TheRageKage12/drunk-lantern-power-battery/docs/review/transcript.md

# Design conversation transcript

The text of the design sessions for this project (2026-10-11 to 2026-10-15; Duncan's sessions of 2026-10-14, PRs #13 and #14, are not in it, only their commits and the CONTEXT.md entries): Kevin's messages and Claude's replies, in order. Tool calls, tool output, screenshots and system messages are left out. Sections headed "Context summary" were written when the conversation was compacted. **Later messages override earlier ones**: the design changed many times (base 180 -> 190 mm, power bank -> 12 V battery pack, DRV5032 -> A3144, 90 -> 135 degree nozzle). For the current decisions read [CONTEXT.md](CONTEXT.md) first and use this file to check why something was decided.

97 messages from Kevin, 325 reply blocks from Claude.

---

### Kevin

I have been working with ChatGPT to design a Green Lanter power battery that can secretly pour a shot. You can review the conversation at this link: https://chatgpt.com/share/6acc0005-f06c-83e8-a1af-509642569773

I want you to read/understand what it has recommended, the plan, the materials, etc. There are CAD files attached that are a basic 3D printable power battery. I'd like you to attempt to update those CAD files to fit/manage the full build with all the hardware included inside.

Output a guide on how to build this. Include materials with links on where to purchase them (or stores local to the Seattle area), step-by-step instructions, diagrams, and any other supplemental material that might help me.

I'm going to send you all my ChatGPT conversation history when it is available. The chat's title is “Design Alcohol Dispensing Prop”.

Does that all make sense?

### Claude

I'll start by looking at what's in the repo and trying to read the shared ChatGPT conversation.

### Claude

The checkout is empty with no remote branches yet. Let me check the remote repo on GitHub, look for any uploaded attachments, and try the ChatGPT share link in parallel.

### Claude

The share page came back nearly empty through the fetcher, since ChatGPT renders it with JavaScript. Let me try pulling the raw HTML, which often embeds the conversation data.

### Claude

The raw page is 2 MB and contains the conversation. Let me extract the message text from the embedded data.

### Claude

The conversation is encoded in React Router's "turbo-stream" format, a flat array of indexed values. I'll write a small decoder to rebuild the message tree.

### Claude

Got the CAD zip, thanks. I'll unpack it alongside finishing the conversation extraction.

### Claude

The full transcript extracted (158 messages). Now I'll read it, read the model's PDF, and install mesh tooling to measure the STLs.

### Claude

Good progress: the model is Hedo3D's "Green Lantern luminous" from Cults3D, and it already has a reed-switch reflector. Let me keep reading the transcript and measure every STL at the same time.

### Claude

Amazon returned pages without titles, which usually means a bot-check page. Let me inspect those, and build a contact sheet of the renders so I can view all parts at once.

### Claude

Noted, you swapped the pump and tubing. Let me identify those two new items plus the remaining specs.

---

### Kevin

ok, now continue in ULTRACODE

### Claude

Understood, switching to ultracode orchestration. First I'll set up the repo skeleton and a project brief for the agents, then run a research-and-critique workflow before the build workflow.

### Claude

arduino-cli installed. Now installing the RP2040 core and the NeoPixel library in the background.

### Claude

Firmware compiles cleanly for the XIAO RP2040. Let me check how far the research workflow has gotten.

### Claude

Status while the background work runs:

- **Research workflow** (7 topics, each fact-checked by a second agent): pump/tubing fit, 12 V power design, bright LED options, sensor wiring, springs and hardware, Seattle-area stores, and an adversarial critique of the whole plan.
- **CAD workflow**: five part modules (base, dishes, sphere, socket, handle) being modeled in parallel against the shared contract, each reviewed, then integrated with fit checks and renders.
- **Diagram agent**: wiring, fluid path, state machine, interaction timeline, socket mechanism.
- **Firmware agent**: host-side simulation of the interlocks plus an adversarial review. The sketch already compiles for the XIAO RP2040.

I'll pick up each result as it lands, reconcile the design parameters, and then write the build guide and push.

### Claude

Checkpoint pushed to `claude/green-lantern-battery-prop-7bn4rp`. The research, CAD, diagram, and firmware-test agents are still running in the background; I'll commit and push again as each one lands.

---

### Kevin

Correction: I have not bought anything for this yet. I just looked it up

### Claude

Good to know, that changes the framing: the parts list is open, so the guide will recommend the best part for each slot and treat your shortlist as candidates, flagging where a different part is clearly better. Let me update the brief the agents are working from and nudge the two running agents.

### Claude

Everything I need next is already in flight: the research workflow, the CAD build workflow, the diagram agent, and the firmware simulation agent. Nothing else can start until those land, so I'll wait for their completion notices and then run the final guide-writing pass with a link-checker and completeness critic.

---

### Kevin

Awesome. Also, when suggesting where to buy things, prefer Amazon links. For small things where there are huge multipacks (e.g. screws), its especially helpful if you can find local stores where I don't need to buy hundreds of them.

### Claude

Got it: Amazon links first for everything, and for bulk-only items like screws, inserts, springs, and resistors, name a local Seattle-area store where you can buy a handful. I'll record that as a rule for the guide writer.

### Claude

Recorded in the brief and pushed. The guide's bill of materials will have two columns for small parts: the Amazon listing and a verified Seattle-area store. I'm now waiting on the four background jobs (research, CAD, diagrams, firmware tests) before the guide can be written.

### Claude

The firmware agent found four real interlock bugs (dead calibration command, cap resettable by a second start, stuck-switch pour, stale Hall read at pump start) and fixed them with a 15-scenario simulation. Let me verify the compile and tests myself, then commit.

### Claude

Firmware verified and pushed (compiles for the XIAO RP2040, 15 of 15 simulated interlock scenarios pass). Let me check how the research and CAD workflows are progressing.

### Claude

While the workflows run, I'll write the top-level README so the repo is navigable regardless of when the rest lands.

### Claude

README pushed. Everything else now depends on results still in flight: the research workflow (4 of 7 topics written, fact-checks pending), the CAD workflow (dishes done, base and sphere modeling, socket and handle queued), and the diagram agent. I'll resume when those complete and then run the guide-writing workflow.

### Claude

Checkpoint pushed. The CAD base module and the other background jobs are still running; I'll commit again as each lands.

### Claude

The five diagrams are in. The wiring one still shows the PD-trigger 12 V option that the power research later rejected in favor of a 5 V to 12 V step-up cable, so it will need one revision pass once the electrical design is final. Let me look at two of them and keep the generator scripts in the repo so they can be regenerated.

### Claude

Diagrams are pushed. The only remaining inputs are the two background workflows (research fact-checks and the CAD build with its reviews, integration, and audits). Once they finish, I'll run the final workflow: build guide written against the verified research and the real CAD, a link checker that fetches every purchase link, a completeness critic against your original questions, and a diagram reconciliation pass.

### Claude

The research workflow finished: all seven topics written and independently fact-checked. Let me read the decision sections of the four I haven't seen, especially the design critique, and commit the files.

### Claude

The timing is decent: the socket modeler is just starting and the sphere modeler is mid-way, so I'll point both at revision 3 directly.

### Claude

Revision 3 is pushed and both running CAD modelers have been told to re-read it. Status:

- **Research**: done and fact-checked (seven notes under `docs/research/`). Key findings that changed the design: the Kamoer KPHM200 is 116 x 64 mm and 300 g; the 133 mm Boston round could never leave the base, so the reservoir is now a squat 8 oz wide-mouth jar refilled in place through the door; the hatch grows to 110 x 105 mm with a bottom-hinged door and a slide-out glass tray; the socket housing shrinks to 76 mm so it passes the dish hole; power is one USB-C PD port at 12 V (INIU B61) with a buck converter for the 5 V side, with the Adafruit 5 V pump as the simpler alternative.
- **In flight**: CAD modeling (base and dishes done, sphere and socket building, handle queued, then reviews, integration, audits), firmware revision 3 (prime button, faster abort, pour-time brightness cap), and the wiring diagram redraw.

One question that affects how parts get split, no rush: which 3D printer do you have access to, or what is its bed size? Everything is designed for a 220 x 220 x 220 mm bed. A Bambu A1 mini (180 mm) would need the big parts split or the whole lantern scaled to 1.6x, and the research found a free KCLS Bellevue Library makerspace with Prusa printers as a fallback.

### Claude

Firmware revision 3 verified (compiles, 16 of 16 simulated scenarios pass including the new prime button) and pushed. Still waiting on the CAD workflow and the wiring diagram redraw before the guide can be written.

### Claude

Diagrams are pushed. The remaining dependency chain is: CAD workflow finishes, then a revision 3 compliance pass over the model, then the guide workflow (writer, link checker, completeness critic). Nothing can start until the CAD workflow reports, so I'm waiting on that notification.

---

### Kevin

do you think $40 are enough credits to finish this?

### Claude

Honest answer: I can't see your billing or how credits map to tokens, so I can't promise a dollar figure. What I can tell you is the usage pattern.

**Spent so far** (subagent tokens, roughly): research 2.4M, firmware 0.4M, diagrams 0.6M, plus the CAD workflow, which is still running and is the biggest consumer. Ultracode mode is deliberately expensive: every piece of work gets an independent reviewer or fact-checker, which roughly doubles the agent count.

**Remaining as planned**: finish the CAD workflow (8 more agent runs: reviews, integration, two audits), a revision 3 compliance pass over the model, then the guide workflow (writer, link checker that fetches every purchase link, completeness critic, fixer). My estimate is 4 to 6M more tokens on the full plan. If $40 is tight, that may not fit.

**Leaner path, which I recommend**: let the CAD workflow finish since the model is the core deliverable and stopping it mid-flight wastes the work already done. Then I write the build guide myself from the fact-checked research and the CAD output, with one single agent pass to verify purchase links and store details, instead of a four-agent workflow. That cuts the remaining spend by well over half and the guide quality stays high because the research underneath it was already verified.

If you want the leanest option, I can also stop the CAD workflow now and finish the model's integration and renders myself, with no further reviewer agents.

Tell me which you prefer. Until you answer I'll keep the CAD workflow running and won't launch anything new.

### Claude

Checkpoint pushed; the CAD workflow has now produced the handle pieces and a first assembly. I'm holding further agent launches until you pick the full or lean path for the remaining work.

---

### Kevin

We need to trim the CAD workflow

### Claude

Agreed. Let me see exactly where the CAD workflow is, then stop it and finish the integration myself without the reviewer and audit agents.

### Claude

Renderer works; the cutaway camera was on the wrong side (looking at the uncut dome instead of the cut face), so I'm flipping it. Still waiting on the sphere and socket modelers.

### Claude

The build guide draft is written and pushed. The only thing still outstanding before I can finish is the sphere and socket modules from the two remaining CAD agents; my watcher will wake me when both have reported, and then I'll stop the workflow, integrate and check the full model, render it, fill in the print table, and reconcile the socket section of the guide with the real part names.

### Claude

The socket modeler died mid-write (it hit the output token ceiling). Let me see what it left on disk and where the sphere modeler stands before deciding whether to finish those two parts myself.

### Claude

Patching the remaining label text (the file uses escaped characters), then re-rendering and checking the diagram.

### Claude

Everything is pushed to `claude/green-lantern-battery-prop-7bn4rp` on TheRageKage12/temprepo. Here is where it landed.

**What you have now**

- `docs/BUILD_GUIDE.md`: the build guide. Shopping list with Amazon links plus a "local" column (Vetco Electronics in Bellevue for electronics singles, Tacoma Screw Ballard for M3 hardware, McLendon and Ace for springs and adhesives, Micro Homebrew Kenmore for tubing, Bargreen Ellingson for shot glasses), print table for all 24 parts, bench electronics, firmware upload, socket assembly and tuning, fluid path, sphere, final assembly, calibration math, test checklist, performance notes, cleaning, troubleshooting, and the answers to the questions you asked ChatGPT (LED brightness and power, power bank requirements, spring size, Seattle stores).
- `cad/output/`: ready-to-slice STLs (and STEP) for every part, all sized for your 230 x 230 x 240 Ender 3. The model is fully parametric (`cad/params.py`), with fit checks that pass at zero problems and a rotor sweep test for the socket mechanism.
- `firmware/green_lantern/`: XIAO RP2040 sketch that compiles, with a host-side simulation of 16 interlock scenarios (all pass). It found and fixed four real bugs in the ChatGPT-era logic.
- `docs/images/`: wiring, fluid path, state machine, interaction timeline and socket mechanism diagrams, plus CAD renders (iso, rear, cutaway, exploded, parts sheet).
- `docs/research/`: seven fact-checked notes behind every number.

**Design changes versus the ChatGPT plan, all driven by verified facts**

- The Kamoer KPHM200 is 116 x 64 mm and 300 g, so the base grew to 115 mm and got a two-level deck.
- A 133 mm bottle can never leave the base, so the reservoir is a squat 8 oz jar refilled in place through the door.
- The hatch is 110 x 96 mm with a hinged door and a slide-out glass tray, instead of reaching into the sphere.
- Power is one USB-C PD port at 12 V (INIU B61) with a buck converter for the 5 V side. The Adafruit 5 V pump is the simpler alternative.
- The socket return spring is a radial plunger on a rotor ramp, because a tangential spring long enough for 45 degrees does not fit in a 76 mm housing.
- Hall sensor: Adafruit DRV5032 primary (3.3 V, no divider), A3144 module as the alternative.

**Honest caveats**

- Nothing has been printed or built. The first things to measure on real parts are the pump outline and mounting, the jar cap diameter, the spring feel, and the Hall sensor response. Each maps to a parameter in `cad/params.py`.
- The sphere halves need interior tree supports around the window and hatch.
- The budget is about $350 to $445 buying everything new; the ChatGPT "$100" only covered the core electronics and pump.
- The CAD workflow's reviewer and audit agents were cut to save credits; I checked the sphere and socket myself, including a mechanism sweep, but a second pair of eyes on those two modules was skipped.

---

### Kevin

how the fuck did you get it to $350??

### Claude

I didn't cut anything to get $350. It's the same parts list as the $445 figure, assuming you buy the bulk-pack items as singles at Vetco and Tacoma Screw. That swap replaces about $120 of kits (connectors, wire, screws, springs, diodes, capacitors, fuses, headers, CA glue) with roughly $25 to $30 of loose parts. It was a rough estimate, not an itemized list, and I should have said so in the guide.

The bigger issue is why the full list is so far above your $100 target. Much of the cost is kits and consumables you'd keep, not parts that end up inside the lantern:

| Biggest line items | Cost |
|---|---|
| PETG, two green spools plus white | $56–65 |
| JST connector kits | $25 |
| CA glue plus activator | $25 |
| Kamoer pump | $28 |
| Power bank, 12 V capable | $21 |
| Pololu 12 V to 5 V converter | $19 |
| M3 screw kit | $18 |
| Adafruit 24-LED ring | $17 |
| Wire kit | $15 |

A cheaper build that keeps the same CAD and firmware comes to about **$155**, assuming you already own PETG and a USB power bank. Add about $40 if you need filament.

- **Use the 5 V Adafruit pump instead of the Kamoer.** That removes the 12 V cable and the converter, and any power bank with a 2.4 A port works. The trade-off is a slower pour: about 18 seconds for 1 oz instead of 9.
- **Buy small parts locally.** That covers resistors, capacitors, a fuse and holder, headers, wire, the level shifter, the spring and a dozen M3 screws. Expect about $20 at Vetco and Tacoma Screw.
- **Skip the extras.** Solder wires directly instead of buying connector kits, use a $5 tube of super glue, and drop the stainless nozzle tip and the pinch clamps.
- **Keep the essentials.** That means the XIAO, the Hall sensor, the microswitch, the MOSFET module, the LED strip and ring, the food-grade tubing, the jar, magnets and heat-set inserts.

The guide still only lists the full version. I can add this cheaper build to the guide as its own parts list if you want it.

---

### Kevin

no like, the old build was like $100. why the fuck is this so much more expensive

### Claude

Mostly because the $100 never covered the whole build. ChatGPT's own breakdown said $75 to $90 assuming you already owned a power bank and workshop supplies, and $95 to $115 buying everything. It left out filament, glue, the glass, and most of the wiring and hardware. Its unit prices were also single-item prices, while Amazon mostly sells these parts in multipacks.

Here's how the gap between the two plans splits up:

| Where the extra money comes from | ChatGPT plan | My list | Difference |
|---|---|---|---|
| Same core parts: pump, XIAO, Hall sensor, switch, MOSFET, LED ring, level shifter, magnets, power bank, tubing, jar | ~$98 | ~$136 | +$38 |
| 12 V support for the stronger pump you picked (PD cable plus converter) | none | $29 | +$29 |
| LED strip for the "obnoxiously bright" sphere | none | $9 | +$9 |
| PETG for a lantern this size | not counted | ~$60 | +$60 |
| Wire, connectors, fuses, diodes, capacitors, switches, perfboard | ~$10–18 | ~$85 | +$70 |
| Screws, heat-set inserts, springs | ~$5–8 | ~$40 | +$33 |
| Glue and epoxy | not counted | ~$34 | +$34 |
| Shot glass, pinch clamp, nozzle tip, funnel | not counted | ~$30 | +$30 |

The core parts cost more mainly because of pack sizes and a bigger ring. The microswitch comes as a 4-pack, the MOSFET module as a 6-pack and the level shifter as a 10-pack, and I picked the 24-LED ring over the 12-LED one.

Some of my list is padding, and that's a fair criticism. I priced the small parts as full kits and added nice-to-haves: connector kits instead of soldering direct, a $25 glue set, the stainless nozzle tip, the PRIME button, and fuses. Those make the build easier but aren't required.

The fair comparison to ChatGPT's $100 is the cheaper build from my last message. It costs about $155 if you already have filament and a power bank, and buys the small parts singly at Vetco. Switching back to the 5 V pump, which drops the PD cable and the converter, brings it close to $130. Most of what's left above $100 is items ChatGPT never priced.

---

### Kevin

what if we just had 2 of the cheaper weaker pumps instead of a big one?

### Claude

Yes, that works, and it's a good trade. Two Adafruit 3910 pumps on 5 V match the Kamoer's speed and remove all the 12 V parts.

| | One Kamoer, 12 V | Two Adafruit 3910, 5 V |
|---|---|---|
| Flow | 200 mL/min rated | 2 × 100 = 200 mL/min rated |
| 1 oz pour | about 9 s | about 9 s |
| Pumps | $28 | $50 |
| 12 V cable and 5 V converter | $29 | none |
| Power bank | must offer 12 V (INIU B61) | any bank with a 2.4 A or 3 A USB port, including one you own |
| Tubing | AUBER 1/8" × 1/4", $14 | JoyTube 1/8" × 3/16", ~$7 |
| Total for this part of the build | ~$92 | ~$57 plus Adafruit shipping |

That saves about $35, and the wiring gets simpler. One USB port feeds everything, so the PD cable, the converter, and one of the two fuses all go away.

How it fits together:

- **Driver and firmware.** Both pumps wire in parallel to the same MOSFET output, so the firmware doesn't change. The two pumps draw about 1 A together, the LEDs are capped near 0.85 A while pouring, and the total stays under 2 A on a 5 V port. The soft start already in the firmware handles the two motors starting at once.
- **Tubing.** The JoyTube tube you originally found is wrong for the Kamoer but close to right for the Adafruit pump. The pump uses 3.5 mm ID × 5 mm OD tube; JoyTube is 3.2 × 4.8 mm and is food grade. Test that it seals in the pump head before trusting it, since that fit is my inference and not confirmed.
- **Plumbing.** Run two separate tubes, each from the jar lid through its own pump to the nozzle. Mount both tube ends side by side in the nozzle clip, both aimed into the glass. That avoids a Y-joint, which is one more place to leak. The jar lid gets two tube holes plus the vent.
- **CAD.** Each pump is 28 mm wide and 67 mm long, much smaller than the Kamoer's 116 × 64 mm. Both fit easily where the Kamoer was. The pump saddles on the base deck need redrawing for two pumps on 50 mm hole spacing. The nozzle clip needs a second tube channel.

Two catches:

- "Up to 100 mL/min" is a best case. With 20 cm of lift up to the nozzle, expect a bit less, so plan on 10 to 12 seconds for 1 oz. That still fits the light show.
- Two pumps means two tubes to load, clean, and dry after each use.

With this swap, the lean build from my earlier message drops to roughly $130, assuming you already have filament and a power bank.

---

### Kevin

what else can we cut/remove to reduce cost?

### Claude

First, a correction: my last message got the math wrong. The ~$155 lean build already used one 5 V Adafruit pump, so adding a second pump raises it to about **$173**, not $130. That figure still assumes you already own filament and a power bank.

Here's what else can go, biggest savings first:

| Cut | Saves | Trade-off |
|---|---|---|
| Use one 5 V pump instead of two | ~$25 | A 1 oz pour takes ~18–20 s instead of ~10 |
| Screw M3s straight into printed holes instead of using heat-set inserts | ~$10 | Holes wear out after many reassemblies. It's a one-line change in `params.py` (pilot hole 4.0 → 2.6 mm) |
| Single logic-level MOSFET from Vetco instead of the 6-pack module | ~$8 | You solder a MOSFET, a resistor and a diode yourself |
| Cheap clone 24-LED ring from Amazon instead of Adafruit's | ~$8 | Clone quality varies, and I haven't checked a specific listing |
| Skip the master switch and the fuse | ~$6 | Unplug the USB cable to turn it off. The power bank's built-in overcurrent protection covers a 5 V system |
| Skip the PRIME button | ~$2 | Prime by doing a couple of pours into a cup. The firmware works unchanged with nothing on that pin |
| Skip the perfboard and headers | ~$5 | Solder wires directly to the XIAO pins. Messier, but it works |
| Reuse a jar you already have | ~$8 | It must be food-safe and fit within 76 mm wide by 76 mm tall |

Things not worth cutting:

- **Level shifter ($3 at Vetco).** LED strips often work on 3.3 V data without it, but that's out of spec and can flicker. It isn't worth gambling on for $3.
- **DRV5032 Hall sensor ($5).** A reed switch costs about $1, but it probably won't trigger reliably through 8 mm of plastic.
- **Food-grade tubing and magnets.** Both are already cheap, and the tubing matters for safety.
- **XIAO.** A cheaper board would mean porting the firmware to save about $4.

Bottom line, assuming you own filament, a power bank and basic glue:

| Version | Approx. cost |
|---|---|
| Two pumps, all cuts above | ~$130 |
| One pump, all cuts above | ~$105 |

The one-pump version is basically the ChatGPT $100 build, just priced honestly. It also has the same slow pour that plan had.

The most extreme option is ChatGPT's no-microcontroller idea: a timer relay module driving the pump, with plain green LEDs. It drops another $20 or so, but you lose the light show and the one-pour-per-insertion lock. I wouldn't do it.

---

### Kevin

i want the pour to be roughly a full shot in about 10-15 seconds

### Claude

A full shot is 44 mL, so 10 to 15 seconds needs about 180 to 260 mL/min. The single Kamoer pump hits that target more reliably than two Adafruit pumps, for about the same money.

Both options are rated around 200 mL/min, which works out to about 13 seconds for a full shot. The difference is how each maker states the rating:

- **Kamoer KPHM200.** Kamoer lists it as "at least 200 mL/min" with a 200 to 300 range. Expect roughly 10 to 13 seconds for a shot.
- **Two Adafruit 3910 pumps.** Adafruit lists "up to 100 mL/min" each. With 20 cm of lift to the nozzle, expect roughly 14 to 18 seconds, which often misses your target.

The Kamoer was only expensive because of how I powered it, and that part can be done cheaper:

| Pump option | Parts | Approx. cost | Full shot |
|---|---|---|---|
| Kamoer, cheaper 12 V setup | pump $28, PD 12 V cable $10, LM2596 buck module ~$8, AUBER tubing $14 | ~$60 | ~10–13 s |
| Two Adafruit pumps | 2 × $25, JoyTube tubing $7 | ~$57 | ~14–18 s |
| Three Adafruit pumps | 3 × $25, tubing $7 | ~$82 | ~9–12 s |

The cheaper Kamoer setup swaps the $19 Pololu converter for a generic LM2596 buck module. Set it to 5.0 V with a multimeter before connecting anything. The LM2596 price is an estimate; I didn't check a specific listing.

Total with all the earlier cuts comes to about **$133** with the Kamoer, if you already own filament and a suitable power bank.

**Check your power bank first.** The 12 V cable only works if the bank offers a 12 V USB-C PD profile. Many 20 W banks do; the Anker 313 does not. Look on the bank or its listing for "12V⎓1.5A" on the USB-C output. If yours doesn't have it, the INIU B61 (~$21) does, which puts the total around $155.

**The glass.** A 1.5 oz shot glass filled with a full 44 mL shot is brim-full and will slosh when you pull it out. A 2 oz glass fixes that, but those are around 75 mm tall versus the 62 mm the glass bay was designed around. It probably fits, because the nozzle comes in from the side, but I'd re-check the CAD after changing the glass height parameter.

**Firmware.** No changes needed. Calibrate the pour time for 44 mL, and the 20-second safety cap covers it.

---

### Kevin

as far as "light show", all i want is it to gradually increase in iintensity

### Claude

That simplifies the lighting a lot. A single brightness ramp doesn't need individually addressable LEDs, so you can swap them for a plain green LED strip dimmed through a MOSFET.

**What changes**

- **LEDs.** Replace the NeoPixel ring and the WS2812B strip with a plain 12 V green LED strip: single colour, not RGB, cuttable every 3 LEDs. A 5 m reel is usually around $10–15 on Amazon, though I haven't checked a specific listing. It runs from the same 12 V supply as the pump, through a second MOSFET, with the XIAO setting brightness by PWM.
- **Parts that drop out:** the 24-LED ring, the addressable strip, both 330 ohm data resistors and the 1000 µF capacitor.
- **Parts that stay:** the level shifter chip, now used as the 5 V gate driver for the two MOSFETs.
- **Converter.** The 12 V to 5 V converter now only powers the XIAO, so any small buck module works.
- **Power.** One metre of green strip draws roughly 0.4–0.6 A at 12 V. Add the pump's 0.7 A and the total is about 1.1–1.3 A, inside a 12 V / 1.5 A USB-C profile.
- **Cost.** Saves about $8 net, bringing the cheap Kamoer build to roughly **$125** if you already own filament and a power bank with a 12 V output.

**The one catch: the socket glow.** Plain strip can't be bent flat into the small ring recess around the socket. Either skip light at the socket and let the sphere carry the whole effect, or wrap a 15 cm piece around the outside of the socket housing under the halo. The wrap needs a small CAD change to the housing.

**How the firmware would behave**

| Moment | Light |
|---|---|
| Idle | Faint steady glow, about 5%, so the power bank doesn't switch itself off |
| Ring inserted | Ramps smoothly from about 5% to about 70% over the oath. It's tuned so the brightening looks steady to the eye, and the ramp time is one setting |
| Twist | Jumps to 100% and holds through the pour |
| Pour done | Holds a moment, then fades over a few seconds |
| Ring removed | Back to the faint idle glow |

The one setting worth getting right is the ramp length, so it peaks as you finish the oath. Tell me roughly how long your recitation takes, or I'll default to about 15 seconds.

None of this is in the repo yet. The guide, the CAD, the wiring diagram and the firmware still describe the addressable-LED build with the 12 V PD cable and Pololu converter. I'm holding off on rewriting them until you've finished making changes, so they only get updated once. Just say when.

---

### Kevin

the shot can be a little less than a full shot

### Claude

That opens up the cheaper option. Two Adafruit 5 V pumps now hit your time window, which means the whole build can stay on 5 V.

Pour times at a smaller shot:

| Pump option | 1 oz (30 mL) | 1.25 oz (37 mL) |
|---|---|---|
| One Kamoer, 12 V (200–260 mL/min) | ~7–9 s | ~9–11 s |
| Two Adafruit, 5 V (realistically ~150–200 mL/min) | ~9–12 s | ~11–15 s |
| One Adafruit, 5 V (~75–100 mL/min) | ~18–24 s | too slow |

A 1 to 1.25 oz pour also fixes the glass problem. A standard 1.5 oz shot glass has room left at the top, so the glass bay stays as designed.

Which pump to pick comes down to your power bank:

- **If your bank has a 12 V USB-C output** (look for "12V⎓1.5A" on the bank or its listing): **use the Kamoer.** One tube to load and clean, and more speed than you need. If it finishes too fast for the light show, the firmware can run it at about 70% speed to stretch the pour to ~12 seconds. About **$125**.
- **If it doesn't: use two Adafruit pumps on 5 V.** That means no 12 V cable, no 12 V-to-5 V converter, and no new power bank, just a 3 A USB port on the bank you have. The LEDs become a 5 V plain green strip instead of 12 V. About **$122**, versus roughly $146 for the Kamoer route plus a new $21 bank.

Two things to know about the two-pump route:

- **Tubing.** It needs two tubes, each running from the jar to its own pump and on to the nozzle clip. I haven't confirmed that the JoyTube 1/8" × 3/16" tubing seals in the Adafruit pump head; test it first.
- **Power.** On a single 5 V port, two pumps (~1 A) plus the LED strip (~1 A at full) plus the XIAO comes to about 2.1 A. That's fine on a 3 A port, but tight on a 2.4 A one. If yours is 2.4 A, the firmware can hold the LEDs a bit lower during the pour.

Both totals assume you already own filament and a power bank.

---

### Kevin

i guess the kamoer is still the way to go here? what does that do to the cost

### Claude

Yes, the Kamoer is the right call. It's faster than you need with only one tube to deal with, and the cheaper 12 V setup brings it to about the same price as two small pumps.

Here's the full list with every decision so far: the Kamoer, the plain green LED strip, and all the earlier cuts.

| Item | Where | Cost |
|---|---|---|
| Kamoer KPHM200 12 V pump | [Amazon B09HGVLHFV](https://www.amazon.com/dp/B09HGVLHFV) | $28 |
| Food-grade tubing, 1/8" × 1/4" platinum silicone | [Amazon B0DKB1NKB4](https://www.amazon.com/dp/B0DKB1NKB4) | $14 |
| Plain 12 V green LED strip | Amazon | ~$12 |
| LM2596 buck module, 12 V to 5 V for the XIAO | Amazon multipack | ~$8 |
| 6 × 2 mm magnets | [Amazon B0CBRVF4PN](https://www.amazon.com/dp/B0CBRVF4PN) | $7 |
| XIAO RP2040 | [Amazon B0DRNTQ338](https://www.amazon.com/dp/B0DRNTQ338) | $10 |
| DRV5032 Hall sensor | [Adafruit 6051](https://www.adafruit.com/product/6051) | $5 |
| USB-C PD 12 V cable | [Adafruit 5450](https://www.adafruit.com/product/5450) | $8 |
| Adafruit shipping | | ~$8 |
| Lever microswitch, level shifter chip, 2 MOSFETs | Vetco, Bellevue | ~$9 |
| Resistors, diodes, capacitor, wire, heat-shrink | Vetco | ~$8 |
| M3 screws (a dozen) and one spring | Tacoma Screw / Vetco | ~$6 |
| Super glue | anywhere | ~$5 |
| **Total** | | **~$128** |

The 12 V cable moved from Amazon to Adafruit's version because you're already ordering the Hall sensor there. That shares one shipping charge and saves a couple of dollars.

That $128 assumes you already have these. Add them if you don't:

- **A power bank with a 12 V USB-C output.** Look for "12V⎓1.5A" on the bank or its listing. If yours doesn't have it, the [INIU B61](https://www.amazon.com/dp/B09176JCKZ) does, for about $21.
- **PETG filament.** The lantern takes about 0.9 kg, so two spools, around $40.
- **A food-safe jar about 76 mm across or smaller** (~$8), and a **shot glass** (~$10).

Prices marked "~" are estimates. Amazon hid some prices from my lookups, and I didn't check specific listings for the LED strip, the buck module, or the Vetco parts. Adafruit shipping is a guess too.

The repo still describes the original ~$445 design: the guide's parts list, the wiring diagram, the firmware's LED code, and the CAD's insert holes and LED parts. Say the word and I'll update all of it to this version in one pass.

---

### Kevin

does adafruit ship quickly?

### Claude

Reasonably fast, but it ships from Brooklyn, so expect about a week to Seattle on the cheap option.

| Step | Time |
|---|---|
| Processing | Usually ships in 1–2 business days. Orders placed before 11am Eastern on weekdays with a UPS express option ship the same day |
| USPS Ground Advantage, under $200 | 2–5 business days in transit, not guaranteed |
| UPS 2nd Day or Next Day Air | Guaranteed, but costs more |

Ordering today on the cheap option, it should arrive by around October 16 to 21. That leaves a week or more before Halloween, but not much slack if a part turns out wrong. Their shipping page doesn't list prices, so the ~$8 in my total is still a guess.

You can skip Adafruit entirely and get everything from Amazon and Vetco:

- **12 V cable.** Use the [wininks USB-C PD 12 V cable (B0FD9P7PV4)](https://www.amazon.com/dp/B0FD9P7PV4) from Amazon instead, about $10.
- **Hall sensor.** Use an A3144 from Vetco, $1.99, available the same day. It needs 5 V and a diode on its output, its sensor leads bent up through the window in the socket's base plate, and two magnets stacked in the ring key instead of one, because it's less sensitive than the DRV5032.

That route comes to about **$121** and arrives at Amazon speed. The trade-off is the A3144, which is fiddlier to get reliable through the plastic than the DRV5032. If you want the easier sensor, order from Adafruit today and build everything else while it ships.

---

### Kevin

can you update everything so that it is the ~$135 version? that should be an acceptable price

### Claude

I'll update the whole repo to the ~$135 build: firmware, CAD, diagrams, and the guide. Starting with the firmware and its test harness.

### Claude

Now rewriting the firmware's lighting for a single dimmable green strip, plus a pump-speed setting.

### Claude

Firmware rewrite compiles for the board; fixing a small issue in the test mock now.

### Claude

All 17 scenarios pass, including the new light-ramp and pump-speed checks. Committing the firmware, then moving to the CAD.

### Claude

Firmware and CAD are done and pushed. Now redrawing the wiring diagram for the simpler circuit.

### Claude

Wiring diagram is clean now. Updating the other four diagrams' LED and pour references next.

### Claude

Removing the LED ring from the socket diagram, then on to the guide rewrite.

### Claude

Diagrams are pushed. Now rewriting the build guide around the ~$135 parts list.

### Claude

The Hall sensor pocket was sized for the old A3144 module and is too narrow for the DRV5032 board. Fixing that and rebuilding.

### Claude

The repo is updated to the budget build and pushed. Itemized, it comes to about **$140**, not $135: I'd underestimated the screws. The lantern needs about 37 M3 screws, not a dozen. That total assumes you already own filament, a jar, a shot glass, and a power bank with a 12 V USB-C output.

**What changed**

- **Firmware.** The addressable-LED code is gone. One green strip now brightens steadily for 15 seconds after the ring goes in, holds, jumps to full on the twist, then fades after the pour. Two new serial settings: `speed` slows the pump to stretch a pour, and `idle` sets the faint glow when idle. It compiles for the XIAO and passes all 17 simulated safety scenarios, including new ones for the light ramp and pump speed.
- **CAD.**
  - Screws now thread straight into printed holes, so no heat-set inserts.
  - The socket has no LED ring, and the base door has no switch hole.
  - The Hall sensor pocket was too narrow for the DRV5032 board; I widened it. Fit checks still pass with zero problems, and the socket sweep test still passes.
- **Wiring diagram.** Redrawn for the new circuit: the 12 V cable feeds the pump and LED strip through two MOSFETs, and a small converter supplies 5 V to the XIAO. The other four diagrams are updated to match.
- **Build guide** (`docs/BUILD_GUIDE.md`), rewritten:
  - The shopping list split into online and pick-up-locally, with exact screw counts.
  - Bench wiring steps, socket assembly, calibration aimed at 1 to 1.25 oz, and a test checklist.
  - A final section on adding back anything that was cut. Each item is either a one-line CAD setting or a cheap part.

**Before you build**

- **Order from Adafruit today.** The Hall sensor and the 12 V cable take about a week to reach Seattle. The guide lists an all-Amazon and Vetco alternative that skips the wait, but its Hall sensor is fussier to set up.
- **Check your power bank** for a "12V⎓1.5A" USB-C output. If it doesn't have one, add about $21 for an INIU B61.
- **Measure the Kamoer pump and your jar** before printing the base, since the pump's exact outline isn't published.
- **Set the light's ramp length.** It defaults to 15 seconds; if your oath runs longer, change `RAMP_MS` in the sketch to match.

---

### Kevin

It looks like the workflow is somewhat incorrect. We want the pour and the lights increasing in intensity to be happening during the oath. That is what distracts people while it pours:

1. Insert ring. Light up to opacity of 10-20%
2. Turn 45 degrees and hold - Hall sensor + turn starts lights increasing in opacity. Pour starts.
3. Pour and light intensifying continues for ~10-12 seconds. Lights end at ~90% opacity
4. Turn ring back to starting position. Lights increase to full intensity and then go off
5. I pull out my hand with the full shot glass

If I unturn my hand before the pour finishes, it stops where it is. The lights would then increase in opacity by like 10% and then go back off

### Claude

That's a real change to how the prop behaves: the pour becomes hold-to-pour, and the light builds during the pour instead of before it. I'll rework the firmware and its tests, then update the diagrams and guide. First, let me read the rest of the test harness.

### Claude

Now rewriting the firmware state machine for hold-to-pour.

### Claude

Firmware compiles. Now updating the simulation scenarios for hold-to-pour, which changes most of them.

### Claude

Before rewriting the tests, I'll raise the PWM resolution to 10-bit so the slow climb from 15% is smooth instead of visibly stepping at the dim end.

### Claude

All 17 hold-to-pour scenarios pass. Committing, then updating the state-machine and timeline diagrams.

### Claude

Firmware and state diagram are done; checking the new timeline render now, then the guide.

### Claude

The firmware now follows your sequence, and the change is pushed. The firmware compiles for the XIAO and passes all 17 simulated scenarios, rewritten for hold-to-pour.

How it behaves now:

1. **Insert the ring.** The light fades up to about 15%.
2. **Twist 45° and hold.** The pump starts and the light begins to climb.
3. **Keep holding.** The pump runs about 11 seconds while the light climbs steadily to 90%. If you're still holding when the pour finishes, the pump stops and the light stays at 90%, so a longer oath is fine.
4. **Let the ring turn back.** The light swells to 100% in under half a second, then fades to dark over about a second.
5. **Let go early instead.** The pump stops within about 40 ms. The light swells about 10% above where it was, then goes dark.

Two things I decided that you may want to change:

- **No resume after letting go early.** The prop locks until the ring is removed. A fresh insertion pours the full amount again, which could overflow a glass that's already partly full.
- **Pour volume is set by pump speed.** Since the pour time is now the length of the show, the volume comes from the speed setting (default 70%). The calibration section explains how to tune it.

The pump only runs while the ring is in and the twist is held, and only once per insertion. Pulling the ring out still stops it within 60 ms. I also switched the light to finer brightness steps (10-bit PWM) so the slow climb from 15% looks smooth instead of stepped.

The state-machine diagram, the timeline, the guide's performance and calibration sections, and the README all reflect the new flow.

**One mismatch with your step 5.** "Pull out my hand with the full shot glass" assumes your ring hand is next to the glass. In the current CAD, the socket is in the top dish and the glass sits behind the rear hatch in the sphere. So step 5 is really two moves: lift your hand out of the top dish, then open the hatch and slide out the tray. If you want the ring hand to come out holding the glass, the socket would need to move inside the sphere, next to the glass, reached through the hatch. That's a significant CAD change, so I haven't made it. Tell me if you want it.

The repo also has a `main` branch that GitHub reports as renamed. All of this work is on `claude/green-lantern-battery-prop-7bn4rp`, and `main` is at an older commit.

### Claude

Noted. Everything so far is on that branch, so [TheRageKage12/temprepo#1](https://github.com/TheRageKage12/temprepo/pull/1) already has the full build: the hold-to-pour firmware and its 17 simulated tests, the CAD, the diagrams and the guide. Any further changes I make will be pushed to the same branch and show up in the PR.

The question from my last message is still open. Should the socket move inside the sphere, next to the glass, so your ring hand comes out holding it? Right now the socket is in the top dish and the glass sits behind the rear hatch.

I can also watch the PR and respond to review comments or failing checks as they come in. Tell me if you want that.

---

### Kevin

My hand should be going in the lantern horizontally, like a punch. That means that the glass should probably be positioned somewhere below or near where my fingers would open so I can grab it

### Claude

Got it: the hand goes in horizontally through the rear opening like a punch, and the glass waits just under where the fingers open. That means a real layout change. The socket moves from the top dish into the sphere, facing your fist, and the glass drops into a well below it. I'll make that change in the CAD now. First I'll check the current sphere and socket placement code.

### Claude

Now the socket module: smaller faceplate, mounting ears and standoffs, and the in-sphere placement.

---

## [Context summary written at a compaction]

This session is being continued from a previous conversation that ran out of context. The summary below covers the earlier portion of the conversation.

Summary:
1. Primary Request and Intent:
   - Original request:
     - Read and understand the user's ChatGPT conversation ("Design Alcohol Dispensing Prop", https://chatgpt.com/share/6acc0005-f06c-83e8-a1af-509642569773) about a Green Lantern power battery prop that secretly pours a shot.
     - Update the uploaded CAD files (Hedo3D "Green Lantern luminous" STLs, CC BY-NC 4.0) to fit all the hardware.
     - Output a build guide with materials, purchase links (Amazon preferred; Seattle-area stores), step-by-step instructions, diagrams and supplemental material.
   - Purchasing preferences:
     - Prefer Amazon links.
     - For small items sold only in huge multipacks (screws etc.), find local Seattle stores that sell small quantities.
   - Nothing has been bought yet. The user's Amazon list is only a shortlist.
   - Printer: heavily modified Ender 3, ~230x230x240 mm.
   - Budget: the user accepted the "~$135 version", which itemized at ~$140. Pump is the Kamoer KPHM200 12 V. Pour is 1-1.25 oz in ~10-12 s.
   - Lighting: just a gradual increase in intensity.
   - Interaction (user's own specification, hold-to-pour):
     1. Insert ring; lights at 10-20%.
     2. Turn 45° and hold; the Hall sensor plus the turn starts the lights increasing and the pour starts.
     3. The pour and the light build continue ~10-12 s; lights end at ~90%.
     4. Turn the ring back; lights go to full, then off.
     5. Pull the hand out with the full shot glass.
     - Un-turning early stops the pour where it is; the lights go up ~10%, then off.
   - Latest request: the hand goes into the lantern horizontally like a punch, so the glass should sit below or near where the fingers open so it can be grabbed.
   - A PR exists: https://github.com/TheRageKage12/temprepo/pull/1. Push to branch `claude/green-lantern-battery-prop-7bn4rp` to update it. Do not create a new PR.

2. Key Technical Concepts:
   - CadQuery 2.8 parametric CAD:
     - params.py holds all dimensions; parts/*.py each expose build() and placements().
     - Placements are (axis, angle, translate) or a list of such steps, applied as rotate-about-origin then translate.
     - checks.py tests envelope clearance and part overlap (>1 cm³ fails; envelope >0.2 cm³ fails).
   - trimesh, manifold3d, shapely, cairosvg; software renderers render_stl.py and render_views.py.
   - Seeed XIAO RP2040 on the earlephilhower Arduino core: arduino-cli FQBN rp2040:rp2040:seeed_xiao_rp2040. The core provides analogWriteRange; the firmware uses 10-bit PWM (PWM_RANGE 1023) and EEPROM emulation.
   - Host-side C++ simulation harness with mocks (Arduino.h, EEPROM.h), run with `make test` in firmware/test.
   - Electronics:
     - USB-C PD 12 V trigger cable (Adafruit 5450) from a 12V-PDO bank (INIU B61).
     - LM2596 buck to 5 V, feeding the XIAO through a 1N5819.
     - 74AHCT125 as gate driver for 2 IRLZ44N low-side MOSFETs (pump on D3, plain 12 V green LED strip on D4), with 10k pulldowns.
     - DRV5032 Hall sensor on D1; D2F-L microswitch on D2; optional PRIME button on D6; 1N5819 flyback across the pump.
   - Hold-to-pour state machine: IDLE, ARMED, POURING, HOLDING, FINALE, LOCKED. Gamma-corrected perceived brightness.
   - Socket mechanism:
     - Flat 36 mm rotor with a stop lug channel (0/45° stops), a cam lifting the D2F-L lever 3 mm, and a ramp plus radial spring plunger (0.5x5x10 spring) for return.
     - Key cap with a 6x2 magnet on the axis.
   - Punch-in layout (rev 6, latest):
     - Socket inside the sphere facing +Y, mounted on the LED carrier's back via ears and standoffs.
     - Glass in a well hanging into the lower dish neck.
     - Nozzle guide with a quarter-bend bore.
     - Open rear hand port; top_cap closes the top dish.

3. Files and Code Sections:
   - /home/user/temprepo/cad/params.py
     - Rev 6 block appended:
       ```
       SOCKET_IN_SPHERE = True
       SOCKET_Z_LOCAL = 11.0        # ring centre height, sphere frame
       SOCKET_STANDOFF = 8.0
       SOCKET_EAR_R = 53.0
       GLASS_TOP_Z_LOCAL = -38.0    # glass rim height
       WELL_ID, WELL_WALL = 54.0, 2.0
       NOZZLE_RISE = 5.5
       NOZZLE_BEND_R = 22.0
       FIST_R, FIST_LEN, FOREARM_R = 32.0, 85.0, 30.0
       ```
     - Earlier settings still in place:
       - M3_INSERT_HOLE = 2.7 (tapped holes).
       - HALL_PCB_W = 17.8.
       - BASE_H 115; HATCH_W/H 110 x 96 (now the hand port); WINDOW 90 x 87.
       - HANDLE_INNER_GAP 6; ROTOR_OD 36; SOCKET_HOUSING_OD 76; CAM_LIFT 3.
       - Spring/plunger parameters; BOTTLE 76 x 76 jar; POWERBANK 150 x 72 x 25.
   - /home/user/temprepo/cad/assembly.py
     - place() now accepts a list of steps:
       ```python
       steps = placement if isinstance(placement, list) else [placement]
       for axis, angle, (dx, dy, dz) in steps: rotate then translate
       ```
   - /home/user/temprepo/cad/render_views.py
     - load_placed() handles step lists.
     - The cutaway colours fist/forearm envelopes tan (230,190,160) and the others orange, and skips switch_envelope.
     - New cutaway title.
     - Outputs docs/images/cad-assembly-iso/front/rear/top, cad-cutaway, cad-exploded and cad-parts-sheet PNGs.
   - /home/user/temprepo/cad/checks.py
     - Envelopes are every name ending in `_envelope` except switch_envelope.
     - fist and forearm envelopes skip parts whose names start with "switch".
     - Envelope tolerance is 200 mm³; overlap tolerance is 1000 mm³.
   - /home/user/temprepo/cad/parts/socket.py
     - `PLATE_D = P.SOCKET_HOUSING_OD if P.SOCKET_IN_SPHERE else P.SOCKET_PLATE_D`; no faceplate bolt holes when in the sphere.
     - LED_RING = False.
     - New constants: EAR_W 10, EAR_ANGLES (0, 180), STANDOFF_OD 7, CARRIER_BACK_Y -35.
     - At the end of the file: `FACE_Y = CARRIER_BACK_Y + P.SOCKET_STANDOFF + MODULE_DEPTH` (= -13.8).
     - base_solid() adds two ears at r = SOCKET_EAR_R with M3 clearance holes.
     - New `_flip_to_bed()`, which records the z-shift in `_SHIFT`.
     - build() returns: socket_housing, rotor, socket_base, switch_envelope, switch_bracket, plunger, key_cap, socket_standoff (print 2), and halo only if LED_RING.
     - `mount_step()` returns `((1,0,0), -90, (0, FACE_Y, P.Z_SPHERE_CENTER + P.SOCKET_Z_LOCAL))`.
     - placements() returns [socket-frame step, mount step] for each part, e.g. `[(X,180,(0,0,_SHIFT[n])), m]`.
     - This fixed the old rotor print-translation bug.
     - tests/test_socket.py still reports "SOCKET MECHANISM OK".
   - /home/user/temprepo/cad/parts/sphere.py
     - Rear half: the hatch door, hinge holes, magnet pockets and nozzle boss were removed. The port is now an open hand port. build_halves returns (front, rear, None, None).
     - New constants:
       - WELL_OD 58.
       - GLASS_BASE_Z = GLASS_TOP_Z_LOCAL - GLASS_H (-100).
       - WELL_FLANGE_OD 68, WELL_FLANGE_T 2.
       - TUBE_R_POS 34.5; GROMMET_XY (-34.5, -4); WIRE_SLOT_XY (34.5, -4); WIRE_HOLE_D 7.
     - bay_floor(): well hole, carrier slots, tube hole, 7 mm cable hole, nozzle-guide screw pilot. Platform, rails and tray were removed.
     - glass_well(): flange cup, depth = (BAY_FLOOR_Z + FLOOR + WELL_FLANGE_T) - GLASS_BASE_Z, with a glass centring ring.
     - nozzle_guide(): rect profile swept along `cq.Workplane('XZ').moveTo(0,0).lineTo(0,h).radiusArc((r,h+r), r)`, minus a bore of TUBE_OD + 0.6, on a foot with an M3 hole.
     - led_carrier(): two M3 holes at (±53, z = SOCKET_Z_LOCAL - (BAY_FLOOR_Z + FLOOR)).
     - build() returns: sphere_front, sphere_rear, diffuser, bay_floor, glass_well, led_carrier, nozzle_guide, glass_envelope, fist_envelope, forearm_envelope.
       - The fist envelope is `cq.Workplane('XZ').circle(P.FIST_R).extrude(-P.FIST_LEN)`.
     - placements():
       - glass_well: `((1,0,0),180,(0,0,Z+BAY_FLOOR_Z+FLOOR+WELL_FLANGE_T))`.
       - nozzle_guide at the grommet exit.
       - fist at (0, face_y = CARRIER_Y + STANDOFF + 13.2, Z + SOCKET_Z_LOCAL + 6).
       - forearm at face_y + FIST_LEN - 10.
     - Removed parts: glass_tray, sphere_hatch, nozzle_clip; their output files were deleted.
   - /home/user/temprepo/cad/parts/dishes.py
     - Added build_top_cap(): a disc of (SOCKET_COUNTERBORE_D - 2*FIT) x 3 with 4 countersunk M3 holes on SOCKET_BOLT_ANGLES.
     - Placed at Z_SOCKET_PLATE_SEAT; included when SOCKET_IN_SPHERE.
   - Latest build: all parts fit the bed; checks report 0 problems. Clearances:
     - Fist z -15..49, y -13.8..71.2.
     - Nozzle guide x -42..-12.5, z -50.5..-17.5.
     - Glass z -100..-38.
     - Glass well z -102..-48.5.
   - /home/user/temprepo/firmware/green_lantern/green_lantern.ino (committed)
     - States: `enum class State : uint8_t { IDLE, ARMED, POURING, HOLDING, FINALE, LOCKED };` declared before the first function, because of the Arduino prototype generator.
     - Light constants: ARMED_LEVEL 0.15, ARMED_FADE_IN_MS 600, POUR_PEAK 0.90, EARLY_BUMP 0.10, FINALE_UP_MS 400, FINALE_HOLD_MS 300, FINALE_FADE_MS 1200, FADE_MS 1000, GAMMA 2.2, PWM_RANGE 1023.
     - Other defaults: DEFAULT_POUR_MS 11000, DEFAULT_PUMP_SPEED 70, DEFAULT_IDLE_DUTY 0, MAX_PUMP_MS 20000, POUR_ABORT_MS 60.
     - Settings struct: magic "GL02", pourMs, maxBright, idleDuty, pumpSpeed; created by defaultSettings().
     - Serial commands: status, cal, pour, speed, leds, idle, save, stop.
     - POURING:
       - Ring loss → pumpStop and LOCKED.
       - !swStable → pumpStop and startFinale(ledShown + EARLY_BUMP).
       - Pour done → HOLDING.
     - HOLDING: release → startFinale(1.0).
     - FINALE: ends in LOCKED.
   - /home/user/temprepo/firmware/test/
     - Arduino.h mock: `sim::pwmRange` plus analogWriteRange/analogWriteFreq; includes math.h.
     - test_green_lantern.cpp: scenarios a-q rewritten for hold-to-pour; 17/17 pass.
     - Adafruit_NeoPixel.h mock removed.
   - Diagrams in docs/images/src/ (gen_*.py + svgkit.py):
     - wiring.svg: rewritten for the budget circuit. Its socket group is still labelled "top dish".
     - state-machine.svg: 6 states.
     - interaction.svg: hold-to-pour timeline.
     - fluid-path.svg: labels updated earlier, but the geometry is the old layout.
     - socket-mechanism.svg: LED ring removed, but it still shows the top-dish mounting.
   - docs/BUILD_GUIDE.md
     - Budget build ~$140 with the full BOM (Amazon, Adafruit, Vetco, Tacoma Screw), Seattle stores table, print table, electronics steps, firmware, socket, fluid, sphere, assembly, calibration by speed, tests, performing (hold-to-pour), cleaning, troubleshooting, and upgrades.
     - Still describes the top-dish socket, tray, hatch door and nozzle_clip.
   - Other files: README.md, cad/README.md, cad/DESIGN_CONTRACT.md (revisions 2-5), docs/research/*.md (seven fact-checked notes plus BRIEF.md).

4. Errors and fixes:
   - The ChatGPT share page was JS-rendered. I decoded the turbo-stream with a custom decoder, fixing recursion and circular-reference problems along the way.
   - arduino-cli install script failed; downloading from downloads.arduino.cc worked.
   - The CAD workflow's sphere and socket agents hit the 64k output-token limit. The user asked to trim the workflow, so I stopped it and wrote sphere.py and socket.py myself.
   - The hold-pour rewrite first anchored on the wrong `switch (state)` (the one in lightTarget). I restored with git checkout and used the anchor `'  switch (state) {\n    case State::IDLE:\n'`.
   - The mock analogWrite clamped values to 255. I added a sim::pwmRange model.
   - The Hall pocket was too narrow for the DRV5032; HALL_PCB_W became 17.8.
   - The nozzle guide intersected the glass. I lowered GLASS_TOP_Z_LOCAL to -38 and added NOZZLE_RISE 5.5 with a 22 mm bend.
   - The glass well depth was off by the flange thickness; fixed.
   - User feedback on cost:
     - "how the fuck did you get it to $350??" and "why ... so much more expensive" than $100. I explained the gap honestly and corrected my own math mistakes ($130 → $173; screw count raised the $135 estimate to ~$140).
     - The user had earlier been angry at ChatGPT for removing Amazon links and writing essays, so keep Amazon links and stay concise.

5. Problem Solving:
   - Solved:
     - Layout for the 12 V pump, jar, power bank and electronics.
     - Socket mechanism verified by the sweep test.
     - Budget redesign.
     - Hold-to-pour firmware, verified by simulation.
     - Punch-in geometry: the socket fits below the upper-dish plug (socket top z = 49 < 49.5); the fist clears the guide by 2.5 mm; the tube tip is horizontal at z ≈ -23, aimed inside a glass rim 15 mm below.
   - Open:
     - The socket twist direction suits a right hand (clockwise as seen from the hand = right-hand supination). The user hasn't said which hand wears the ring.
     - Fist dimensions are estimates; a mock-up print is advised.

6. All user messages:
   - "I have been working with ChatGPT to design a Green Lanter power battery that can secretly pour a shot. You can review the conversation at this link: https://chatgpt.com/share/6acc0005-f06c-83e8-a1af-509642569773 I want you to read/understand what it has recommended, the plan, the materials, etc. There are CAD files attached that are a basic 3D printable power battery. I'd like you to attempt to update those CAD files to fit/manage the full build with all the hardware included inside. Output a guide on how to build this. Include materials with links on where to purchase them (or stores local to the Seattle area), step-by-step instructions, diagrams, and any other supplemental material that might help me. I'm going to send you all my ChatGPT conversation history when it is available. The chat's title is "Design Alcohol Dispensing Prop". Does that all make sense?"
   - "@.../1ce7a4af-green-lantern-luminous-model_files.zip Here are the CAD files as well"
   - "I think I changed the tubing and pump to these so that it has more power: https://www.amazon.com/gp/product/B08RYFGNMK/... https://www.amazon.com/gp/product/B09HGVLHFV/..."
   - "ok, now continue in ULTRACODE"
   - "Correction: I have not bought anything for this yet. I just looked it up"
   - "Awesome. Also, when suggesting where to buy things, prefer Amazon links. For small things where there are huge multipacks (e.g. screws), its especially helpful if you can find local stores where I don't need to buy hundreds of them."
   - "regarding the printer: I have a heavily modified ender 3 that can do 230x230x240ish"
   - "do you think $40 are enough credits to finish this?"
   - "We need to trim the CAD workflow"
   - "how the fuck did you get it to $350??"
   - "no like, the old build was like $100. why the fuck is this so much more expensive"
   - "what if we just had 2 of the cheaper weaker pumps instead of a big one?"
   - "what else can we cut/remove to reduce cost?"
   - "i want the pour to be roughly a full shot in about 10-15 seconds"
   - "as far as "light show", all i want is it to gradually increase in iintensity"
   - "the shot can be a little less than a full shot"
   - "i guess the kamoer is still the way to go here? what does that do to the cost"
   - "does adafruit ship quickly?"
   - "can you update everything so that it is the ~$135 version? that should be an acceptable price"
   - "It looks like the workflow is somewhat incorrect. We want the pour and the lights increasing in intensity to be happening during the oath. That is what distracts people while it pours: 1. Insert ring. Light up to opacity of 10-20% 2. Turn 45 degrees and hold - Hall sensor + turn starts lights increasing in opacity. Pour starts. 3. Pour and light intensifying continues for ~10-12 seconds. Lights end at ~90% opacity 4. Turn ring back to starting position. Lights increase to full intensity and then go off 5. I pull out my hand with the full shot glass. If I unturn my hand before the pour finishes, it stops where it is. The lights would then increase in opacity by like 10% and then go back off"
   - (System/UI) "A pull request was just created for this branch from the Claude Code UI: https://github.com/TheRageKage12/temprepo/pull/1 You don't need to create one. Reference this PR going forward — pushing more commits to this branch will update it."
   - "My hand should be going in the lantern horizontally, like a punch. That means that the glass should probably be positioned somewhere below or near where my fingers would open so I can grab it"
   - Constraints:
     - Do not create PRs unless asked.
     - Commit attribution: "Co-Authored-By: Claude Opus 5.5 <noreply@anthropic.com>" and "Claude-Session: https://claude.ai/code/session_01RA7Cpt4fWuKXDa6DwBe3et".
     - No model identifiers in repo artifacts.

7. Pending Tasks (punch-in layout follow-through):
   - Commit and push the in-progress CAD changes to `claude/green-lantern-battery-prop-7bn4rp` (updates PR #1).
   - Review the cutaway render (scratchpad cut3.png) for the punch-in layout.
   - Regenerate the guide print table: remove glass_tray, sphere_hatch and nozzle_clip; add glass_well, nozzle_guide, socket_standoff (x2) and top_cap.
   - Update BUILD_GUIDE.md:
     - Section 1 "How it works" table: socket inside the sphere, hand port, glass well.
     - Section 6 socket mounting: ears and standoffs onto the carrier back with 2 x M3x20 plus nuts on the LED side outside the channels; no faceplate screws.
     - Sections 7 and 8: fluid path and nozzle guide (tube through the bay floor at r 34.5, quarter bend, tip ~5 mm beyond the guide; glass well; no tray or hatch door).
     - Section 9 assembly (top_cap with 4 screws).
     - Section 12 performing (punch in, open the fingers onto the glass, pull out).
     - The cut-hatch-door note, magnet count (no hatch magnets) and screw counts.
   - Update diagrams:
     - fluid-path.svg: new geometry.
     - socket-mechanism.svg: vertical in-sphere mounting.
     - wiring.svg: socket group label "(inside the sphere)".
   - Update cad/README.md, DESIGN_CONTRACT revision 6 and the README part list.
   - In the reply to the user:
     - Ask which hand wears the ring (the twist direction is designed for right-hand supination; a left hand would need the socket mirrored).
     - Note the fist dimensions are estimates; suggest printing the socket and well first as a mock-up.

8. Current Work:
   Implementing the user's punch-in request: "My hand should be going in the lantern horizontally, like a punch. That means that the glass should probably be positioned somewhere below or near where my fingers would open so I can grab it".
   - CAD changes made (uncommitted): params rev 6 block; socket.py in-sphere mounting; sphere.py with the open hand port, glass_well, nozzle_guide, carrier holes and fist/forearm envelopes; dishes.py top_cap; assembly, checks and render_views updated for step-list placements and generic envelopes.
   - The full `python3 build.py` reports "--- checks done: 0 problem(s) ---".
   - tests/test_socket.py reports "SOCKET MECHANISM OK".
   - The last command updated the render_views.py cutaway colouring (hand in tan) and re-rendered all views ("rendered 24 parts"). It saved a 700 px cutaway preview to /tmp/claude-0/-home-user-temprepo/45c7fed5-b38c-5bcd-8935-8412da500de5/scratchpad/cut3.png, which still needs reviewing.

9. Optional Next Step:
   - Look at the cut3.png cutaway to confirm the punch-in layout reads correctly.
   - Commit and push the CAD changes with the required attribution.
   - Update the build guide sections, print table, fluid-path, socket-mechanism and wiring diagram labels, READMEs and the contract for the punch-in layout, then push to update PR #1.
   - Report to the user, asking which hand wears the ring (twist direction) and noting the estimated fist dimensions.

If you need specific details from before compaction (like exact code snippets, error messages, or content you generated), read the full transcript at: /root/.claude/projects/-home-user-temprepo/45c7fed5-b38c-5bcd-8935-8412da500de5.jsonl
Continue the conversation from where it left off without asking the user any further questions. Resume directly — do not acknowledge the summary, do not recap what was happening, do not preface with "I'll continue" or similar. Pick up the last task as if the break never happened.

### Claude

Next, the guide. I'll find every section that still describes the old layout.

### Claude

The guide also needs new part sizes. I'll pull them from the STLs, and check how the earlier gram estimates were made.

### Claude

The ratio is a steady ~0.76 g/cm³, so I'll use it for the new parts. The total:

### Claude

A fist offset 15 mm sideways (the ring finger isn't centred on the fist) grazes the port edge by 0.3 cm³. I'll widen the hand port from 110 to 120 mm and rebuild.

### Claude

Every fist case clears now. I'll make the realistic 100 x 58 mm elliptical fist the official envelope, so every future build checks it.

### Claude

Checks pass with the bigger fist. Re-rendering the views:

### Claude

The rear view shows the socket face through the open port, as intended. Its caption still says "door + hatch", so I'll fix that and check the other captions.

### Claude

Now the CAD README and the design contract (revision 6):

### Claude

The key-tab orientation and twist direction matter for the guide, so I'll check them against the socket's frame conventions.

### Claude

The lower dish's 80 mm floor hole is the limit, and the cone below it is wider. I'll read the lower dish's floor geometry to see how far the hole can grow.

### Claude

Writing the slide-well change: params first, then `sphere.py` and the lower dish hole.

### Claude

Checks pass. Next I'll confirm the new glass-path check would have caught the original bug: with the slide set to 0 (the old straight-up removal), it should fail.

### Claude

A slot of zero length is degenerate in CadQuery, so I'll use 0.5 mm, which is effectively the old straight lift.

### Claude

Without the slide, the lift path would cut through the nozzle guide and 8.7 cm³ of the socket housing. The new envelope catches that, and the real layout passes. Re-rendering:

### Claude

I'll leave the path envelope out of the cutaway, since it's a check volume, not hardware:

### Claude

The cutaway reads right: the glass is at the front of the slot under the knuckles, and the empty rear of the slot is the pull-back room. I'll run the socket test and commit.

### Claude

I'll push now so the PR has the CAD while I update the guide.

### Claude

Pushed. Now the docs: contract revision 7, then the build guide. First, fresh sizes for the parts that changed:

### Claude

Contract revision 7 is written. I'll edit the build guide section by section, starting with the intro, "How it works" and the shopping list:

### Claude

Now section 3 (print list):

### Claude

The nozzle guide's bend would overhang printed foot-down. On its side the bend lies flat and needs no support, so I'll say that:

### Claude

Checks pass. Now sections 7-9, with hole positions described from where the builder stands (behind the lantern, at the port):

### Claude

The guide text is done. Now the diagrams. The timeline callouts still mention the tray and hatch, so I'll fix those and find the stale labels in the other generators:

### Claude

`gen_fluid.py` needs new geometry, and `gen_socket.py` needs new mounting labels. Reading both:

### Claude

Dumping assembly-frame bounds of the key items, so the labels land on the right things:

### Claude

The sphere front half is back to 117 mm tall. The audit found five more small overlaps the 1 cm³ check hid. Locating each one:

### Claude

Only `sphere.py` has the untracked shift. Base and handle record theirs. Fixing all three issues:

### Claude

Empty hits mean the ray passed cleanly through the hole. To be sure the hole isn't just missing material, I'll compare against a ray offset 3 mm sideways, which should hit solid plate:

### Claude

I'll record these fixes in the contract, re-render, run the tests and commit before the diagrams:

### Claude

The audit is clean, so I'll lower the build check's overlap tolerance from 1 cm³ to 0.1 cm³, which would have caught every bug above. One run tells me whether mating faces stay under it:

### Claude

Updating the README's check description, then writing the CAD-driven fluid-path generator:

### Claude

Most of the diagram reads well, but the sphere shell is missing. Its cut at x = 0 probably doesn't close into polygons, because each half's section ends on the split plane. Checking:

---

### Kevin

I think I want it to look something like this. The shot glass can be inserted toward the bottom of the opening and slid back behind some walling that hides the nozzle and possibly other electronics. LEDs would line the top and both sides around the openings. The liquid would be at the bottom/base, and all the electronics and such can either be tucked between the walls hiding the nozzle or just above the liquid

### Claude

Before switching to your sketch, I'll commit the fixes I'd already finished. Those bugs exist whatever layout we choose.

---

### Kevin

My left hand will have the ring, but the rotation should still operate like a normal key, so I don't think that's a huge issue.

Also, my fist is less than 4" in width and 3 inches in height, so we just need some clearance for that plus the glass for the window.

We probably don't really need to worry too much about how offset my fist is in it, unless you're very worried about it.

### Claude

Rewriting the rev 6/7 parameter blocks as one rev 8 block:

### Claude

Now `socket.py`: face position from params, diagonal ears, and standoffs only when the gap is non-zero.

### Claude

Now the big one: `sphere.py` gets the lock wall in place of the LED carrier. Reading its current constants and the functions I'm changing:

### Claude

All checks pass with the new parts. Next I'll confirm the lock's two ear screws line up with the wall's holes. I'll also run the socket mechanism test, since its ears moved.

### Claude

Status: the rev 8 CAD (lock wall, curtain clamp, frosted top) is built, passes its checks, and is committed. I'm now updating the diagrams, then the build guide.

### Claude

Two fixes for legibility: the curtain is hidden under the hand, so I'll draw it last, and the LED strips need to be drawn thicker to show at this scale.

### Claude

The diagram now shows the lock wall, LED strips, curtain and nozzle correctly. Next the socket-mechanism diagram: it still shows the old square faceplate with dish-floor screws and an M3 stop pin.

### Claude

The face views now show the two ears screwed to the wall. The section still draws the old wide faceplate flanges at the top, so I'll remove them:

### Claude

Diagrams are done. For the curtain in the shopping list I need a buy link, so I'll search for frosted, flexible plastic sheet on Amazon and locally:

### Claude

Gathering sizes and weights for the new and changed parts for the print table:

### Claude

I've redesigned the lantern around your sketch, and the pull request is updated: https://github.com/TheRageKage12/temprepo/pull/1. The model passes all its fit checks and the lock mechanism test, and the build guide and diagrams are updated. Nothing is printed yet; the glass grip and the curtain especially need trying on real parts.

**The new layout:**
- **Lock wall:** a printed plate just inside your opening with the lock screwed to its face. You punch in through the curtain, ring face first.
- **Glass:** you push it in under the lock until it clicks over a small ridge at the stop. The wall then crosses its back third.
- **Nozzle:** sits behind the wall, out of sight, and pours into that back third, about 1.5 cm above the rim.
- **Getting the glass out:** grip the front of it, slide it about 3 cm toward you, lift it about 5 cm and bring it out. Keeping the sphere means the glass sits about 5 cm down in its slot, as in your sketch.
- **Lights:**
  - The back window glows from 4 rows of LED strip on the back of the wall.
  - Your opening glows from a strip either side of the lock, shining through the curtain.
  - The top glows from a ring of strip inside the top dish's hole, under a new frosted disc.
  - That's 75 cm of 8 mm strip in total.
- **Curtain:** frosted polypropylene strips, 13 of them, each 12 x 97 mm and overlapping a little. A curved printed clamp holds them under the top dish, and they hang just inside your opening. One sheet of the [COYOUCO 0.5 mm frosted pack](https://www.amazon.com/dp/B0FM3YRGG4) (~$10) is enough. A frosted plastic report cover or binder divider from an office store works too.
- **Your fist and left hand:** the opening is 120 x 96 mm and clears a 106 x 76 mm fist, so you have room around yours. The twist is still clockwise like a key. The guide says to glue the key cap with your left fist thumb-up, so the twist rolls your thumb toward palm-down.

The parts estimate rises to about $150 because of the curtain sheet.

**Bugs I fixed along the way:**
- In the model, the LED panel was sitting against the front window instead of in its slots, and its spacer posts pointed backwards.
- The rear sphere half was placed 3 mm too far back in the model, so the renders and checks were off by 3 mm.
- Two screw posts on the sphere floated above its top edge, where they would have blocked the top dish.
- The fit check was too lenient to catch any of this. It's tighter now and also checks the glass's route out of the slot.

**Worth knowing:**
- **Hidden nozzle:** I lit the openings from LEDs on the wall rather than strips run around each opening's edge. It's simpler to wire and still lights all three. The nozzle may show faintly as a shadow through the back window.
- **The glass grip:** only about 1.3 cm of glass stands above the slot, so a shot glass with a heavy base helps.
- **The lock face:** it's visible through the curtain. You said that's fine; a frosted cover over it could come later.

Sources:
- [COYOUCO 10 Pack 0.5mm Frosted PP Plastic Sheets](https://www.amazon.com/COYOUCO-0-5mm-Frosted-Plastic-Sheets/dp/B0FM3YRGG4)
- [TAP Plastics Seattle (listing may be out of date)](https://maps.roadtrippers.com/us/seattle-wa/shopping/tap-plastics-seattle)

---

### Kevin

* Your fist and left hand: the opening is 120 x 96 mm and clears a 106 x 76 mm fist, so you have room around yours. The twist is still clockwise like a key. The guide says to glue the key cap with your left fist thumb-up, so the twist rolls your thumb toward palm-down.

Wait, I think I mixed this up. I would want it to twist counterclockwise so that my hand is in a better position to grab the glass

### Claude

You want the lock to turn counterclockwise, as seen from your side. That's a mirror image of the current mechanism: stop channel, cam, spring ramp and switch position all flip side. Rather than redraw each feature, I'll mirror the whole lock left-to-right and keep the tested geometry. The two mounting ears are a mirror pair, so they stay below the lock and the wall's screw holes don't change. Checking how the lock parts and their placements are built:

### Claude

I'll mirror the two face views with an SVG transform and draw their text outside it, so the text doesn't come out backwards. Label leaders get mirrored about each panel's centre.

### Claude

The face views are mirrored: the switch is on the left now and the twist arrow runs counterclockwise. Now the guide text:

### Claude

The lock now twists counterclockwise as you see it, and it's pushed to the pull request (https://github.com/TheRageKage12/temprepo/pull/1).

- **How:** I mirrored the whole lock left to right, so every part flips: the stop channel, cam, spring ramp, switch and bracket. The mechanism itself is unchanged, and the fit checks and the lock's twist test still pass. I also confirmed that every mirrored part landed together in the right place.
- **Nothing else changes:** the two mounting ears are a mirror pair, so the lock wall, its screw holes and the rest of the lantern stay the same. The microswitch just goes in turned over on its bracket.
- **Key cap:** the guide now says to glue it with its tab pointing to your right, with your left fist held the way you start the twist (for example palm down). From palm down, a counterclockwise twist rolls your thumb up.
- **Docs:** the build guide, the lock diagram and the design notes all say counterclockwise now.
- **Switching back:** if you want clockwise again later, set `LOCK_TWIST = 'cw'` in `cad/params.py` and rebuild.

When the rotor test parts are printed, twist the lock by hand and check the direction feels right before you print the big pieces.

---

### Kevin

I want to go through the design step by step so that I fully understand how everything is put together and works. Do you know of any skills that would help drive that conversation? I

### Claude

No skill you already have is built for a guided walkthrough. Your plugin directory has three that fit (on the card above). They're community or partner plugins, not Anthropic's.

- **walkthrough** turns a folder (for example `docs/` or `cad/`) into an interactive HTML page you can click through.
- **scrimba-explain** builds a narrated slideshow with diagrams, which suits how the parts fit together. It publishes to a scrimba.com link, so your design goes to their service.
- **Tutor** teaches one short lesson at a time with check-questions, so you can confirm you've got each piece before moving on.

You don't need any of them, though. I can drive it here in chat, one subsystem per step, showing the matching render or diagram each time. You can ask questions or change things as we go. Bottom to top, roughly the build order:

1. **The show:** what happens from glass in to glass out, and what the firmware does at each moment.
2. **Base:** the jar, the pump, the power bank and why it sits flat, and the service door.
3. **Fluid path:** jar → pump → tube → nozzle, and why no printed part touches the drink.
4. **Electronics:** power from the bank (12 V and 5 V), the two switches for the pump and the lights, and the sensors.
5. **The lock:** how the twist, the hard stops, the spring return, the switch click and the ring sensing work.
6. **The lock wall and the glass:** the slot, the click-in stop, the hidden nozzle, and the slide-and-lift to get the glass out.
7. **Light:** the LED layout, the diffusers, the curtain, and the brightness ramp.
8. **The shell:** dishes, sphere halves, handle, and how it all screws together.
9. **Calibration, testing and cleaning.**

Want to start with step 1, or jump to whichever part you're least sure about?

---

### Kevin

yes, start with step 1, and explain in detail

### Claude

I'll check the firmware so the details below are exact, not from memory:

### Claude

# Step 1: The show, from glass in to glass out

I've sent you two diagrams to look at alongside this: the timeline of one pour, and the firmware's six states.

## The core idea: 2 inputs, 2 outputs

All the "magic" comes down to the controller watching two sensors and driving two outputs.

| | What it is | What it tells the controller |
|---|---|---|
| **Input 1: the ring sensor** | A small magnet glued into a printed cap on your ring, and a magnet sensor (a Hall sensor) behind the lock | "A ring is seated in the lock" |
| **Input 2: the twist switch** | A small lever switch inside the lock, pressed by a bump on the rotor | "The ring is twisted and being held" |
| **Output 1: the pump** | 12 V peristaltic pump | Pours the drink |
| **Output 2: the light** | 12 V green LED strip, dimmed by the controller | The show |

The magnet sits dead centre on the ring's axis. When you twist, it spins in place but stays put, so the ring sensor reads "present" through the whole twist. Only the switch notices the twist. That split is deliberate: the controller can always tell "ring in, not twisted" apart from "ring in and twisted".

## The timeline, moment by moment

### 0. Setup (before anyone's watching)
You reach through the strip curtain and lower the empty glass into the near end of its slot. Then you push it back until it clicks over a 1.5 mm ridge. That click means the glass is at the stop, with its back third behind the lock wall, directly under the hidden nozzle.

The firmware is in **IDLE** and the lantern is dark. At power-up it does three things:
- It turns the pump off before anything else.
- It blinks the lights once so you know it's alive.
- It checks whether the switch is already pressed. A switch that's pressed before any twist means something is stuck, so the controller ignores it until it's been released.

### 1. Punch in → ARMED (faint glow)
Your fist goes through the curtain and the ring seats in the lock's keyed pocket. The key cap's tab fits one way only, so the magnet always lands on the sensor.

- The ring must be seen for **100 ms** before the controller believes it, so a brief brush past the sensor does nothing.
- It moves to **ARMED**, and the light fades from dark to **15 %** over **0.6 s**. That's the "the lantern recognises the ring" moment.
- The pump is still off. A ring alone never pours.

### 2. Twist 45° counterclockwise and hold → POURING
At about 33° of twist, a bump on the rotor's edge starts pushing the switch lever. It clicks at about 40°, a few degrees before the hard stop at 45°. So the switch always clicks before you hit the stop, and the stop takes your force, not the switch.

Before starting the pump, the controller checks three things:
- the switch has been pressed steadily for 40 ms,
- the ring is still present,
- this ring hasn't already poured since it went in.

Then:
- **Pump:** it soft-starts from ~16 % to its set speed (default 70 %) over 0.3 s. The soft start stops the motor's start-up surge from dragging the 12 V supply down and resetting the controller.
- **Light:** it climbs from 15 % to 90 % in a straight line over the pour time (default **11 s**). The pour and the light build finish at the same moment.

A spring is trying to turn the rotor back the whole time, so you have to keep holding the twist. That's the "hold it through the oath" feel.

### 3. The pour completes → HOLDING
After 11 s the pump stops on its own, having delivered about 30-37 mL (1 to 1.25 oz). The light sits at **90 %** for as long as you keep holding. A long oath is fine: nothing happens until you let go.

### 4. Turn back → FINALE → dark
When you let the ring turn back, the switch opens and the finale plays:
1. The light swells to **100 %** over 0.4 s.
2. It holds there for 0.3 s.
3. It fades to dark over 1.2 s.

Then the controller enters **LOCKED**: dark, and it will not pour again, even if you twist again.

### 5. Take the glass
You draw your fist back slightly and open your hand. The front two-thirds of the glass sits just under the lock, with about 1.3 cm of it above the slot to grip. You slide it about 3 cm toward you, lift it about 5 cm out of the slot, and bring it out through the curtain.

The slide comes before the lift for a reason. At the pour position, the lock's lower edge and the nozzle are directly above the glass. After the 3 cm slide, nothing is above it. Step 6 covers this in detail.

### 6. Re-arming
The controller only resets when the ring has been gone for **200 ms**. LOCKED → IDLE happens when your hand comes out, so the next person can do the whole show again.

## What happens when things go "wrong"

| Situation | What happens | Why |
|---|---|---|
| You let go before the 11 s pour is done | Pump stops instantly, the light swells ~10 % above where it was, then fades out | Your request: an early un-twist ends the pour where it is |
| Ring pulled out mid-pour | Pump stops within ~60 ms → LOCKED | Never pour without a ring present |
| Twist again after the show | Nothing | One pour per insertion; only removing the ring re-arms it |
| Switch stuck pressed (jammed cam) | Ignored until released | A stuck switch must not fire a pour |
| Anything keeps the pump running | Hard stop at **20 s**, whatever else happens | A last safety net that ignores everything else in the code |

## Two design decisions worth understanding

**Pour time and pump speed are separate settings.** Pour time is the length of the show (11 s); pump speed sets how much liquid fits into that time. You calibrate by keeping the time you like and adjusting the speed until the glass gets 30-37 mL (section 10 of the guide). If both were tied to volume, a thicker liqueur would change the show's timing.

**"Perceived" brightness.** Your eye doesn't see brightness linearly. Doubling the power to an LED doesn't look twice as bright, and the low end looks much more dramatic than the top. If the controller raised the power in a straight line, the light would seem to jump at the start and then barely change. So it plans the ramp in *perceived* brightness and converts it to power with a curve (power = level^2.2). It also uses 1024 dimming steps instead of the usual 256, so the very dim start doesn't look steppy. The result is a climb that looks even to the eye.

`★ Insight ─────────────────────────────────────`
- **Separate sensors make it safe.** The magnet never moves during a twist and the switch never decides on its own, so neither sensor can trigger a pour alone.
- **"One pour per insertion" is a single flag.** It's set when the pump starts and cleared only when a ring is newly detected. Re-twisting after the show is therefore impossible by design, not by timing luck.
- **Hard limits sit apart from the normal logic.** The 20 s pump cap is checked every cycle in the pump code itself, so a bug in the show logic can't bypass it.

`─────────────────────────────────────────────────`

**Check your understanding:** what does the lantern do if you twist, hold for 5 seconds, let go, then twist again? (Answer: the pump stops at 5 s with about half a pour, the light swells a little and fades, and the second twist does nothing until you pull your hand out and put the ring back in.)

Any questions on this part, or ready for **step 2: the base** (jar, pump, power bank and service door)?

---

### Kevin

ready for step 2

### Claude

I'll read the base code and its notes so the details are exact:

### Claude

That notes file is from an older revision (different bottle, power bank and modules). I'll read the live values from the code instead:

### Claude

# Step 2: The base

I've sent two renders: the base cut open from the door side, and the base from above with the door nearest you. "Left" and "right" below are as you see them standing at the hand opening, which is also the base's door side.

## The shell
The base is a printed drum, 180 mm across and 115 mm tall. It prints floor-down with an open top. The walls are 2.4 mm and the floor 2 mm. Raised bands at the top and bottom copy the original Hedo3D model's look.

Inside, it's built in **three layers**, because of one awkward fact about the power bank.

## Layer 1: the floor, with the power bank
The power bank is 150 x 72 x 25 mm and lies **flat in the middle of the floor**, its ports facing the door.

**Why flat and centred:** the drum's inner radius is 84.6 mm and the bank's corners reach about 83 mm from its centre. So the bank only fits dead centre. On edge, or anywhere off-centre, it hits the wall. It takes up the whole middle of the floor, which is why everything else sits on a second floor above it.

How it's held:
- **Sideways:** by the inner faces of the deck pillars.
- **Lengthwise:** by two small end stops at the door end, with a gap between them for the USB plug.
- **Down:** by a 20 mm hook-and-loop strap through two floor slots.

Notches in the door sill and the door let a charging cable reach the bank with the door shut.

**The crescents beside the bank** are the curved gaps left between the bank's long sides and the round wall:
- **Right crescent:** the LM2596 buck converter, which turns 12 V into 5 V for the controller. You set it once and never touch it again, so it's fine buried under the deck.
- **Left crescent:** a spare pocket left over from an earlier revision.

**Two 8 mm drain holes** in the floor on the display side mean a spill runs out of the lantern instead of pooling around the power bank.

## Layer 2: the deck
The deck is a 168.6 mm printed disc, 3 mm thick, sitting 4 mm above the bank (room for the strap). It stands on six 9 x 9 mm pillars printed into the base floor. Three M3x8 screws go into three of the pillars. The screws form an uneven pattern, so the deck only fits one way round, and the parts on it always line up with the door. Slots in the deck let cables pass down to the bank and the buck converter.

## Layer 3: on the deck
| Item | Where | How it's held |
|---|---|---|
| **Jar** (76 x 76 mm, 8 oz) | Your right, slightly toward the display side | A 10 mm ring plus three 28 mm tall fingers |
| **Kamoer pump** | Your left, lying on its side, motor pointing away from you, **pump head facing the door** | Two U-shaped saddles with strap slots (strap or zip tie) |
| **Electronics board** | A vertical panel near the door, a little right of centre | 4 x M3x6 on a 40 x 30 mm pattern, with the board facing the door so you can reach it |

Zip-tie slots around the inside of the wall keep the cables tidy.

**Why the pump head faces the door:** the pump head clamps the tube under its rollers. You'll open that cap to load the tube, to release it for storage (step 9), and to replace a worn tube. With the head facing the door you can do all of that without taking anything apart.

**Height budget:** above 107 mm, the lower dish's joint ring fills the edge of the base. Inside the ring, the pump top (97 mm) is clear. The jar top (110 mm) pokes up into the hollow of the lower dish, which is fine because the ring's inner edge clears it by about 3 mm.

## The service door
The opening is 110 mm wide and 90 mm tall, on your side. There's no hinge: the door has an outer curved plate that overlaps the wall, and a plug that fills the hole. It's held by **4 magnet pairs**: 4 magnets in the door, 4 in small tabs inside the opening's corners. You pull it off, and it snaps back on.

## How the base joins the rest
The lower dish has a ring (a "spigot") that slides into the top of the base, and 3 radial M3x12 screws go through the top band into it.

## ⚠️ A real problem I found while preparing this
**The jar can't come out through the door, and it's hard to refill in place.**
- The jar stands on the deck at 34 mm and is 76 mm tall, so its top is at 110 mm.
- The door opening only reaches 102 mm, which leaves a 68 mm tall window above the deck. A 76 mm jar can't pass through a 68 mm gap at any angle.
- The lid is 0-8 mm above the door's top edge, about 5 cm in from the door. Refilling in place means reaching up to unscrew it, then pouring in with a bent funnel spout, right next to the electronics.

The guide currently says "refill through the service door", which is wrong as designed. The fixes:

| Option | What changes | Trade-off |
|---|---|---|
| **A. Shorter jar** (my recommendation) | A jar no taller than ~60 mm; the 28 mm fingers become a ~5 mm lip so it slides out | Holds roughly 4-6 oz instead of 8, about 4 shots per fill |
| **B. Keep the 8 oz jar, refill in place** | Nothing in the CAD; refill with a squeeze bottle or a bent-spout funnel | Fiddly, and drips near the electronics board |
| **C. A fill port** | A short fill tube from the jar lid to a capped spout in the door | More parts, another thing to clean |

Making the door taller doesn't work: the top band starts at 103 mm, and the deck can't go lower because the power bank is under it.

`★ Insight ─────────────────────────────────────`
- **One big part decides the layout.** The power bank fits only one way, so it sets the floor plan, and everything else is designed around it. When packing a tight enclosure, place the least flexible part first.
- **An uneven screw pattern prevents mistakes.** Three screws in an uneven pattern make it impossible to put the deck in rotated. That matters because the pump and jar positions must line up with the door.
- **Fit checks aren't access checks.** The automated checks prove nothing overlaps once assembled, but not that a part can be taken *out*. The glass had the same blind spot until I added a glass-removal check. The jar now needs the same check.

`─────────────────────────────────────────────────`

**Two things for you:**
1. For the jar, **A, B or C**? If A, I'll lower the fingers, and add a check that the jar can slide out through the door.
2. I'll also fix the "left/right" wording for the buck converter in the guide.

Any other questions on the base? After that it's **step 3, the fluid path**.

---

### Kevin

If I find a smaller power bank, how would that impact our design?

Is there a cheaper/simpler options than using magnets for the door? What if the base unscrewed or something?

### Claude

Both questions connect to the jar problem from step 2, so I'll answer them together.

## 1. A smaller power bank

**What the bank must do:**
- **Supply 12 V:** the 12 V cable asks the bank for 12 V over USB-C, so the bank has to list a 12 V output, e.g. "12V⎓1.5A". Many small banks only offer 5 V and 9 V, so check this first.
- **Supply ~15 W:** the pump (~0.7 A), the LEDs (~0.35 A) and the electronics add up to about 1.2 A at 12 V.
- **Capacity barely matters:** a pour uses about 15 W for ~13 s, so even a small 5,000 mAh bank covers hundreds of pours. What you do need is a bank that doesn't switch itself off when the lantern sits idle (the `idle` setting helps).

**What it changes in the design depends on its shape:**

| Smaller bank that is... | Effect |
|---|---|
| **Thinner** (e.g. 18 mm instead of 25) | The deck drops by the difference, and so do the jar and pump. On its own that doesn't fix the jar: an 8 oz jar would only slide out through the door if the bank were about 12 mm thick or less. |
| **Shorter and narrower** (small enough to stand on its edge beside the jar or pump) | The big win. The bank leaves the middle of the floor, so **the deck goes away**: jar, pump and bank all sit on the floor. The jar top drops from 110 mm to about 78 mm, well under the door's 102 mm top, so even the 8 oz jar slides out. The pump sits lower too. |

Send me the bank's length x width x thickness and I'll check in the CAD whether the deck can go. I won't guess at sizes.

## 2. Cheaper or simpler than magnets

The magnets don't actually add cost: you need the magnet pack for the ring key anyway, and the door uses 8 from the same pack. The real annoyance is gluing 8 magnets with the right polarity. Simpler options exist, and your "base unscrews" idea is the best one.

| Option | How it works | Pros | Cons |
|---|---|---|---|
| **Hook + one screw** | A lip at the bottom of the door hooks under the sill, and one thumbscrew holds the top | No magnets, very secure | A screw to undo for each refill |
| **Printed snap or turn-button** | A flexible printed tab, or a small printed latch that pivots on a screw | Free, no glue | Snaps can wear or break in PETG |
| **⭐ No door: the base twists off** | The lower dish locks into the base with a **quarter-turn bayonet** (like a camera lens or a blender jar) instead of 3 screws. Hold the handle, turn about 30°, lift the whole upper lantern off and set it beside the base. | Fixes the jar problem (it lifts straight out the top, so the 8 oz jar stays). Opens up everything: pump head, electronics, bank. No door to print, no magnets, cleaner look from your side. | The tube and cables need ~25 cm of slack to lift the top off and set it beside the base. You lift ~0.6 kg of lantern for each refill. |

**Why a bayonet and not a screw thread?** The tube and cables run from the base up into the sphere. A thread needs one or more full turns, which would wind them up. A bayonet needs only about 30°, which the slack easily absorbs. The joint is also easy to print:
- **On the lower dish's ring:** three small lugs.
- **In the top band of the base, which is 5.4 mm thick there:** three L-shaped slots, each with a small bump that clicks the lantern locked.

**One practical detail:** to charge the bank without lifting the top off, keep a small notch at the bottom of the base wall for the charging cable, like the one in the door now.

`★ Insight ─────────────────────────────────────`
- **Removing a part can solve several problems at once.** The jar problem came from the door's height limit. Swapping the door for a twist-off joint changes the access direction from the side to the top, and the limit disappears entirely.
- **Rotating joints need tethers to rotate less than one turn.** Anything tethered across a joint (tube, wires) sets the maximum rotation, which is why lens mounts and blender jars use bayonets rather than threads.

`─────────────────────────────────────────────────`

**What I'd suggest:** the twist-off base, which also settles the jar question (keep the 8 oz jar, no option A/B/C needed). Separately, if you find a smaller bank with 12 V output, send its size and I'll see whether the deck can go too.

Want me to make the twist-off change now, or carry on with **step 3 (the fluid path)** and batch the changes at the end?

---

### Kevin

I don't really mind having to undo a few thumbscrews to open it. That would solve the twist off problem with tubes and wires. We'd want to hide the thumbscrews inside of it though so the exterior looks good

Ideally, the only real in the field refill/installation we'd need to do is:

1. Undo thumbscrews
2. Pop base out, which includes pump, battery, and jar currently.
3. Disconnect power cable and tubing that goes to jar.
4. Fill jar
5. Reconnect power cable and tubing
6. Remount and redo thumbscrewd

Either that, or maybe most of the exterior is just kind of a shell around the unit. In this case, all the electronics and tubing would stay with the base/interior when it gets opened up

### Claude

Both ideas work, and you can combine them in a way that keeps all your steps and gets rid of the door entirely.

## Recommended: a removable base cartridge

Split the base into two pieces:
- **The drum (outer shell):** stays attached to the lantern above it. No door, no holes, just a clean ring all the way round.
- **The cartridge:** a new floor plate carrying the deck, power bank, buck converter, electronics board, jar and pump. It slides up into the drum from below.

**Three thumbscrews in the underside** hold them together, so they're hidden while the lantern stands on the table. The screw heads sit in recesses so it still stands flat.

To open it, undo the screws and lift the lantern by its handle. The cartridge stays on the table with everything exposed from above and all sides.

**Your refill routine with this design:**
1. Tip the lantern slightly and undo the 3 thumbscrews underneath.
2. Lift the lantern off by the handle. The cartridge (pump, battery, jar, electronics) stays on the table.
3. Unplug the power bank, and unscrew the jar lid. The pickup tube goes through the lid, so "disconnecting the tube from the jar" is just opening the lid.
4. Fill the jar.
5. Lid back on, plug the bank back in (or charge it now).
6. Lower the lantern back over the cartridge and do the thumbscrews up.

This also solves the jar problem from step 2, since the jar is reached from above. You can keep the 8 oz jar.

## The one thing that crosses the split

Two things run between the cartridge and the rest of the lantern:
- the **tube** from the pump up to the nozzle,
- one **cable** to the lock and the LEDs (6 wires).

That gives you two ways to handle the lift-off:

| | How | Pros | Cons |
|---|---|---|---|
| **Slack** | ~30 cm of extra tube and cable coiled in the cartridge; you set the lantern down beside it | No extra parts, no new joint in the drink path | The lantern stays tethered to the cartridge |
| **Full separation** | A 6-pin plug on the cable, plus a food-safe quick-disconnect coupling on the tube | The lantern comes completely free | A joint in the drink line that can leak or drip, about $10-15 for the coupling, and one more thing to clean |

I'd use **slack for the tube and a plug on the cable**: the cable plug is cheap and harmless, and the tube stays one continuous piece from jar to nozzle.

## Why not a full outer shell around an inner unit?

It's a nice idea, but it doesn't suit this layout. Everything in the sphere is tied to the shell:
- The lock wall, the glass slot and the bay floor are 120-131 mm wide, but the lower dish's neck is only 104 mm. A one-piece shell couldn't be lifted over them.
- The hand opening, the curtain, the display window and the LEDs all have to line up with openings in the shell.

So the "shell around a unit" idea works well for the base, which is exactly what the cartridge is, but not for the sphere.

**Two details to know:**
- **Thumbscrews:** I'd print knurled knobs that grip an M3 screw head (free), going into nuts trapped in the drum rather than threads cut into plastic. Printed threads wear out when opened often.
- **What changes in the parts:** the door and its 8 magnets go away. The drum gains an inner ledge with 3 trapped nuts. The base floor becomes a separate cartridge plate carrying everything that's on the floor now.

`★ Insight ─────────────────────────────────────`
- **"Service from below, display from above"** is a common trick in speakers and lamps. Hidden screws on the underside keep every visible surface clean, and gravity holds the joint together.
- **Every connection that crosses a split joint is a decision:** slack, connector, or a joint in the line. A joint in the fluid path is the costliest kind, because it's where leaks and cleaning trouble start.

`─────────────────────────────────────────────────`

### Claude

My text cut picked up an earlier occurrence of its end marker and duplicated a large chunk of `base.py`. I'll restore the file from git and redo the edit with exact anchors:

### Claude

The `base.py` edit went through; only the params line didn't match. Checking its exact text:

### Claude

The negative test works: at 180° the sweep hits the jar (1.6 cm³) and the deck's jar ring, both of which fail the check. Fixing my ray-test script, which choked on a miss:

### Claude

No door references remain in the guide. I'll fix the gram total, add access to the cleaning section, then update the diagram labels, the READMEs and the contract:

### Claude

I'll render the cartridge and the lifted-off lantern together, so you can see the split:

### Claude

The base is now a removable cartridge, and it's pushed to the pull request (https://github.com/TheRageKage12/temprepo/pull/1). The fit checks pass, including a new one that proves the lantern can be lowered over the cartridge without hitting anything, and the lock test still passes. I've sent a render of the lantern lifted off the cartridge.

## How it works now
- **Drum:** stays with the lantern, still joined to the lower dish by its 3 screws. It's a plain ring with no door, no visible screws and no magnets, and it's open at the bottom.
- **Cartridge:** a tray carrying the power bank, the buck converter and the deck, with the jar, the pump and the electronics board on the deck. It slides up into the drum from below.
- **Hidden thumbscrews:** three printed 10 mm knobs, each with an M3x12 screw glued in. They sit in finger-sized recesses in the cartridge's underside and screw up into nuts in three blocks inside the bottom of the drum. Standing on the table, you can't see them.
- **Your refill routine:** tip the lantern, undo 3 knobs, lift it off by the handle and set it beside the cartridge. Then unplug the bank, unscrew the jar lid (the tube comes out with it), fill, close, plug back in, and lower the lantern back on.
- **Crossing the split:** the tube gets ~30 cm of slack coiled above the jar, so there's no joint in the drink line. The lock cable and the LED leads get a 4-pin and a 2-pin plug, so you can separate the lantern completely if you want.
- **Jar problem solved:** the jar is reached from above now, so the 8 oz jar stays.

## Two design details worth understanding
- **Why the screws are at 0°, 140° and 225° rather than evenly spaced:** when you lower the lantern on, the three nut blocks slide down past everything on the cartridge. At most angles they'd hit something: the power bank's corners, the deck pillars, the buck converter, or the jar's retaining fingers. These three angles are clear. The new check confirms it, and it fails if I try 180°, where the jar sits.
- **The drum now prints upside down (top band on the bed):** the nut blocks have a 45° sloped top, so printed this way they need no supports.

**What changed in the parts list:**
- **Removed:** the door and its 8 magnets. You still need the magnet pack for the ring key.
- **Added:** the tray, 3 knobs, 3 screws and 3 nuts, and a small set of JST plugs (~$7).
- **Total:** cost is about the same, and the print is ~20 g lighter.

I also fixed the guide wording that put the buck converter on the wrong side; it's on your right.

**Back to the walkthrough:** step 3 is the **fluid path**: jar → pump → tube → nozzle, how a peristaltic pump works, and why nothing printed touches the drink. Ready?

---

### Kevin

This battery looks smaller at 3.62"L x 1.1"W x 2.7"Th ?
https://www.amazon.com/FrostVoyage-Battery-10000mAh-Blanket-Portable/dp/B0FM84S98W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

### Claude

That listing is a heated-blanket battery. Those often have a 12 V barrel-jack output rather than USB-C PD, which would change the wiring, so I'll check its outputs before working out the fit:

### Claude

The title says "7.4V/5V", which would rule it out. I'll read further down the page to confirm the actual outputs:

### Claude

The page is over a million characters of script, so I'll fetch it directly and pull out just the product bullets:

### Claude

Amazon blocked the direct fetch (a 3 KB bot page), so I'll search for the product's published specs instead:

### Claude

That one won't work for this build, and the reason is voltage, not size.

**The problem: it has no 12 V output.** The listing title is "7.4V/5V Battery Pack for Heated Vest". Heated-clothing batteries supply 5 V over USB and 7.4 V on a barrel jack. Our design needs 12 V:
- **The LED strip wouldn't light at all.** A 12 V strip runs 3 green LEDs in series per 5 cm piece, and they need about 9 V before they glow. At 7.4 V they stay dark.
- **The pump would be weak.** The Kamoer is a 12 V pump. At 7.4 V it runs at roughly 60 % of its normal speed at best, which makes the 1 oz in ~11 s pour marginal.
- **The 12 V cable wouldn't work.** It asks the bank for 12 V over USB-C, and this bank doesn't offer it.

Bridging that would need an extra 7.4 → 12 V converter plus a barrel-jack cable: more parts and more heat, to save space we no longer need.

I couldn't open the full listing to check every port: Amazon blocked the fetch and the search didn't find a spec sheet. But the title alone rules it out.

**Its size is a good one** (92 x 69 x 28 mm), but since the cartridge change it matters much less:
- **Refill access** was the reason to want a smaller bank, and the cartridge already solves that.
- **Removing the deck still wouldn't happen with this size.** The jar (83 mm with its ring) and the pump (64 x 118 mm) already fill most of the cartridge floor. There's no 28 mm wide strip along the wall where a 92 mm bank could stand on edge.
- **Lying flat**, it would still go under the deck. It's 3 mm thicker than the current pocket, so the deck would move up 3 mm, which is a one-number change.

**What to look for instead:**
1. **Must have:** a USB-C output that lists **12V**, e.g. "12V⎓1.5A" or "12V/1.67A". Banks advertised as "20W PD" often include it, but check the output line, not just the wattage.
2. **Drops in with no changes:** anything up to 150 x 72 x 25 mm. A smaller one just needs a foam spacer or the strap pulled tighter.
3. **Thicker than 25 mm:** send me the size and I'll raise the deck.
4. **Capacity barely matters:** 5,000 mAh covers hundreds of pours.

The [INIU B61](https://www.amazon.com/dp/B09176JCKZ) from the shopping list has the 12 V output. Measure it, or any bank you're considering, against the 150 x 72 x 25 mm pocket.

Sources:
- [FrostVoyage 10000mAh 7.4V/5V heated vest battery (Amazon listing title)](https://www.amazon.com/dp/B0FM84S98W)
- [Dr. Prepare 10000mAh heated vest charger (Renogy), a typical 5V heated-clothing pack](https://www.renogy.com/products/dr-prepare-portable-charger-10000mah-for-heated-vest-jacket)
- [PYYAN 10000mAh heated clothing power bank (Walmart)](https://www.walmart.com/ip/19611162663)
- [Rrtizan 10000mAh power bank for heated clothing (U-Buy)](https://www.u-buy.co.uk/product/I64MVFP68-rrtizan-10000mah-power-bank-for-heated-gilet-vest-and-jacket-small-compact-usb-c-portable-charger-battery-pack-compatible-w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)

Ready for **step 3, the fluid path**, whenever you are.

---

### Kevin

Can you search Amazon for power banks that fit our criteria and might be smaller than what we have now?

### Claude

I'll search for compact banks that list a 12 V USB-C output:

### Claude

Good news first: **the bank already in the shopping list is smaller than the one the CAD models.** The model's 150 x 72 x 25 mm pocket comes from an earlier revision. The INIU B61 we recommend is only **107 x 66 x 23 mm**, and its USB-C port does 12 V, which the manufacturer's page confirms.

**Banks that meet the requirements** (12 V on USB-C, about 1.5 A or more):

| Bank | Size (mm) | 12 V on USB-C? | Notes |
|---|---|---|---|
| **[INIU B61](https://www.amazon.com/dp/B09176JCKZ)** (already in the shopping list) | 107 x 66 x 23 | ✅ 12V⎓1.5A (20 W max), per [INIU's spec page](https://iniushop.com/es/products/iniu-flash-pd-22-5w-10000mah-portable-charger) | 10,000 mAh. My pick: confirmed 12 V, and it fits the current pocket with room to spare. |
| **[Charmast mini 10000](https://www.amazon.com/Charmast-Smallest-Portable-10400mah-Compatible/dp/B07L931FCY)** | 90.5 x 62 x 22 | ⚠️ Listing shows a 9-12V/1.5A profile with an 18 W USB-C port | Smallest 10,000 mAh option. Before buying, check that the 12 V is on the **USB-C** port, not just the USB-A. |
| **[VEGER 5000mAh 20W](https://www.amazon.com/Portable-Charger-VEGER-5000mAh-Charging/dp/B09NXCLXVD)** | 77 x 35 x 25 | ⚠️ A listing in the results quotes "up to 12V-1.6A", but the search didn't confirm it was this one | Tiny, and 5,000 mAh is still hundreds of pours. Unverified, so check the output line on the listing. |
| **[Sharge Pouch Mini](https://sharge.com/products/pouch-mini-power-bank)** | 96 x 61 x 32 | ✅ 12V 2.5A | Has 12 V, but it's thicker than the pocket, so the deck would rise 7 mm (one number in the CAD). |

**Ruled out:** the Anker Nano 5000 (22.5 W). Its USB-C port only does 5, 9 and 10 V, with [no 12 V](https://anker.com/usb-c-charging-specs).

**One thing to watch with very small banks:** many switch themselves off when the power draw is low, and between shows the lantern draws very little. If yours does that, the `idle` setting keeps the LEDs at a faint glow so the bank stays awake (guide section 5). It's worth testing on the bench before the party.

**What a smaller bank changes in the design:** with the cartridge, the outside of the lantern doesn't change at all. A smaller bank only means more spare room on the cartridge floor for the buck converter and cable slack. It doesn't let the deck go away: the jar and pump still need the deck's full floor area.

**Next step:** once you've picked one, tell me which, or send its measured size. I'll set the pocket to it so it's held snugly instead of sliding around in an oversized one. If you have no preference, I'll set it to the INIU B61 now.

Sources:
- [INIU B61 specifications (INIU store)](https://iniushop.com/es/products/iniu-flash-pd-22-5w-10000mah-portable-charger)
- [Charmast mini 10000mAh (Amazon)](https://www.amazon.com/Charmast-Smallest-Portable-10400mah-Compatible/dp/B07L931FCY)
- [VEGER 5000mAh 20W (Amazon)](https://www.amazon.com/Portable-Charger-VEGER-5000mAh-Charging/dp/B09NXCLXVD)
- [Sharge Pouch Mini](https://sharge.com/products/pouch-mini-power-bank)
- [Anker USB-C charging specs](https://anker.com/usb-c-charging-specs)
- [PiShop.us 10000 mAh USB-C bank](https://www.pishop.us/product/power-bank-10000-mah-usb-c-fast-charge/)
- [SBS 10,000 mAh PD power bank](https://www.sbsmobile.com/en/products/power-bank-10000-mah-high-density-with-pd-usb-c-and-usb-a)

---

### Kevin

The VEGER does `USB C Plug Output ( PD + QC + FCP + PE1.1/2.0 + Samsung AFC + BC 1.2 etc): 5V-3A, 9V-2.2A, 12V-1.6A`

### Claude

Its 12 V output is confirmed: 12 V at 1.6 A is about 19 W, enough for our ~1.2 A peak.

There's one catch in that spec line: "USB C **Plug** Output". The VEGER has a built-in USB-C *plug* that goes straight into a phone, rather than a USB-C *socket*. Our 12 V cable also ends in a plug, and two plugs can't connect. It would need a small adapter board with a USB-C socket that asks for 12 V. I'll check one exists before suggesting it:

### Claude

**Yes, the VEGER works, with one swap.** The spec you found confirms 12 V (12V-1.6A, about 19 W), comfortably above our ~1.2 A peak. The catch is in the wording: "USB C **Plug** Output". The VEGER has a built-in USB-C *plug* (it's designed to plug straight into a phone), and our 12 V cable also ends in a plug. So the cable gets replaced by a small board with a USB-C *socket*:

| | Current plan (INIU B61) | VEGER 5000 |
|---|---|---|
| Bank size | 107 x 66 x 23 mm | **77 x 35 x 25 mm** |
| 12 V part | Adafruit 12 V cable #5450 ($7.95), plugs into the bank's socket | **[Adafruit #5991 USB-C PD board](https://www.adafruit.com/product/5991)** ($9.95): the bank plugs into its socket, and you flip the DIP switch labelled 12V, no soldering |
| Capacity | 10,000 mAh | 5,000 mAh, still hundreds of pours |
| Cost change | baseline | about +$2, and you can drop the bank from the list if you buy the VEGER instead of the INIU |

Two notes on the board:
- **Stock:** #5991 showed as out of stock on one snapshot of its page. The solder-jumper version, [#5807](https://www.adafruit.com/product/5807), works too; you bridge its 12V pad instead of flipping a switch.
- **Fixed 12 V boards** without any switch exist too (for example this [12 V decoy module](https://www.sigmanortec.ro/en/decoy-fixed-trigger-module-pd-qc4-12vdc-usb-type-c)). The Adafruit one is the easiest to buy from the US.

**One real risk with small phone banks: they turn themselves off when the power draw is low.**
- Between shows the lantern draws only ~10-15 mA at 12 V, and many small banks shut off below roughly 50-100 mA.
- If that happens, the lantern goes dead and won't wake when you punch in.
- The fix is the firmware's `idle` glow, which keeps a little current flowing. Bench test before the party: power it up, leave it alone 5 minutes, then punch in. If it went dead, raise `idle` (try 30, then 60) and `save`.

This applies to any bank, but the smallest ones are the most likely to do it.

**Effect on the CAD:**
- **Smaller pocket:** the bank pocket shrinks to about 77 x 35 mm, plus room on its end for the plug and the 25 x 20 mm board. That frees a lot of cartridge floor for the buck converter and the tube slack.
- **No outside change:** the lantern looks the same, and the deck stays: the jar and pump still need its full area.

Which do you want: **VEGER + #5991 board**, or keep the **INIU B61**? I'll update the pocket, the shopping list and the wiring section to match, then we can carry on with step 3.

Sources:
- [Adafruit USB Type C Power Delivery Dummy, switchable (#5991)](https://www.adafruit.com/product/5991)
- [Adafruit USB Type C Power Delivery Dummy Breakout, I2C or fixed (#5807)](https://www.adafruit.com/product/5807)
- [Adafruit learn guide: switchable PD breakout](https://learn.adafruit.com/adafruit-usb-type-c-power-delivery-switchable-breakout)
- [Fixed 12 V PD/QC4 decoy trigger module](https://www.sigmanortec.ro/en/decoy-fixed-trigger-module-pd-qc4-12vdc-usb-type-c)
- [Vetco: USB-C female PD/QC decoy trigger board](https://vetco.net/products/usb-c-female-pd-qc-3-0-decoy-trigger-board-usb-a-female-output-voltage-selector)
- [Zbotic: running 12 V from a USB-C PD charger](https://zbotic.in/usb-power-delivery-trigger-run-12v-from-usb-c-pd-charger/)
- [VEGER 5000mAh (Amazon)](https://www.amazon.com/Portable-Charger-VEGER-5000mAh-Charging/dp/B09NXCLXVD)

---

### Kevin

which is better/easier: the board or a usbc extension cable?

### Claude

**The board is better.** An extension cable on its own doesn't solve it, which is easy to trip over:

- **A USB-C extension cable has a socket on one end and a plug on the other.** The VEGER's plug goes into its socket, but the far end is a plug again, and so is our 12 V cable. Still plug against plug.
- **To keep our 12 V cable, you'd need a socket-to-socket adapter (a "coupler")** between the VEGER's plug and the cable's plug.

Comparing the two ways that actually work:

| | **#5991 PD board** | **Socket-to-socket coupler + existing 12 V cable** |
|---|---|---|
| Parts | 1 (it replaces the cable) | 2 (coupler + cable) |
| Will it get 12 V? | Yes, it's made for exactly this | **Not guaranteed.** The 12 V request travels over one specific wire in the connector (the "CC" line), and cheap couplers don't always pass it through. Some work, some quietly stay at 5 V. |
| Size | Small board on the end of the bank | Longer chain: bank + coupler + plug + cable |
| Connections that can work loose | 1 | 2 |
| Effort | Flip one switch, solder 2 wires (+12 V and ground) to its output pads | No soldering beyond cutting the barrel plug off, as now |
| Cost | $9.95 | ~$5-8 for a coupler, plus the $7.95 cable |

Use the **#5991 board**. If it's out of stock, the coupler is a reasonable plan B: pick one advertised for "PD" or "100W", since those pass the 12 V request through. Either way, check with the meter that you get about 12 V before connecting anything (guide section 4, step 2).

Shall I switch the design to the **VEGER + #5991**? That means a smaller bank pocket, an updated shopping list, and a new wiring step. Then we carry on with step 3.

---

### Kevin

search amazon for a compatible pd board

### Claude

Vetco in Bellevue came up earlier with a USB-C trigger board, so I'll check what they stock:

### Claude

These boards are common on Amazon, and Vetco in Bellevue stocks one.

**Amazon (my pick: a fixed 12 V board, nothing to set):**

| Board | Type | Notes |
|---|---|---|
| **[JacobsParts USB-C PD 12V trigger, 2-pack (B08NFKV2LD)](https://amazon.com/JacobsParts-Voltage-Trigger-Module-Type-C/dp/B08NFKV2LD)** | Fixed 12 V, USB-C socket, 5 A | Smallest pack, so you get one spare. Solder two wires to its output pads. |
| [MELIFE 12V trigger, 6-pack (B0953G14Q2)](https://www.amazon.com/MELIFE-Type-C-Voltage-Trigger-Module/dp/B0953G14Q2) | Fixed 12 V, USB-C socket, 5 A | Same kind of board, bigger pack. |
| [AITRIP PDC004, 5-pack (B09GVQ3FGW)](https://www.amazon.com/AITRIP-PDC004-PD-Voltage-Trigger-Notebook/dp/B09GVQ3FGW) | Fixed 12 V | Its listing is inconsistent (title says 12V, description says 9V). I'd skip it. |
| [Adjustable PD trigger, DIP switch (B0H1BYPQ1T)](https://www.amazon.com/Trigger-Type-C-Module-Adjustable-Voltage/dp/B0H1BYPQ1T) | 5-28 V, set to 12 V with switches | Single unit. Fine if you'd rather set it yourself. |
| [Adjustable with screw terminals, 3-pack (B0GS9BF77Z)](https://www.amazon.com/Adjustable-Voltage-Trigger-Terminal-Projects/dp/B0GS9BF77Z) | 5-20 V via switch, screw terminal output | No soldering on the output: wires clamp in. |

I'd avoid the popular **ZY12PDN** boards. They pick the voltage with a touch button and cycle through modes, which is easy to knock off 12 V.

**Local: [Vetco, Bellevue](https://vetco.net/products/usb-c-female-pd-qc-3-0-decoy-trigger-board-usb-a-female-output-voltage-selector)**
- **VUPN2121** ($12.95): USB-C *socket* in, so the VEGER plugs straight in, and 12 V with switch 2 on.
- **The catch:** its output is a USB-A socket, so you'd need a USB-A plug-to-bare-wires cable, or to solder to the socket's pins.
- **Stock:** the stock line was unclear, so call (425) 641-7275 before driving.
- **Wrong version:** the other model, VUPN2956, has a USB-C *plug* input, so it can't take the VEGER.

**Whichever you buy:**
- **Check the output first.** Measure about 12 V on the output with the meter before connecting anything. Vetco's page warns about this too: these boards bypass USB-C's built-in safety checks.
- **If the bank lacks 12 V,** fixed boards fall back to a lower voltage without warning. The VEGER does offer 12 V, so that won't happen with it, but the meter check catches it if it ever does.

**Shall I switch the design** to the VEGER + fixed 12 V board (JacobsParts) now? That means a smaller bank pocket with room for the board, an updated shopping list (the board instead of the Adafruit cable, the VEGER instead of the INIU), and an updated wiring step. Then we carry on with step 3, the fluid path.

Sources:
- [JacobsParts 12V PD trigger 2-pack (Amazon)](https://amazon.com/JacobsParts-Voltage-Trigger-Module-Type-C/dp/B08NFKV2LD)
- [MELIFE 12V PD trigger 6-pack (Amazon)](https://www.amazon.com/MELIFE-Type-C-Voltage-Trigger-Module/dp/B0953G14Q2)
- [AITRIP PDC004 PD decoy 5-pack (Amazon)](https://www.amazon.com/AITRIP-PDC004-PD-Voltage-Trigger-Notebook/dp/B09GVQ3FGW)
- [Adjustable PD trigger board, DIP switch (Amazon)](https://www.amazon.com/Trigger-Type-C-Module-Adjustable-Voltage/dp/B0H1BYPQ1T)
- [Adjustable PD trigger with wiring terminal, 3-pack (Amazon)](https://www.amazon.com/Adjustable-Voltage-Trigger-Terminal-Projects/dp/B0GS9BF77Z)
- [Type-C PD decoy 10-pack (Amazon)](https://www.amazon.com/Type-C-Module-Voltage-Trigger-Female/dp/B09M3SQSXL)
- [ZY12PDN trigger board (Amazon)](https://www.amazon.com/AITRIP-Charging-Trigger-Detector-Terminal/dp/B098WPSMV9)
- [Vetco VUPN2121 USB-C female PD/QC decoy board](https://vetco.net/products/usb-c-female-pd-qc-3-0-decoy-trigger-board-usb-a-female-output-voltage-selector)
- [Vetco VUPN2956 USB-C male PD/QC decoy board](https://vetco.net/products/vupn2121_usb_type-c_pd_qc_3-0_decoy_trigger_board_-_usb-c_output_voltage_selector)

---

### Kevin

you selected the 9V variation. This one is 28V but has prime delivery, would that work?

https://www.amazon.com/JacobsParts-Voltage-Trigger-Module-Type-C/dp/B0FQQ5C6M2?th=1

### Claude

Before answering I'll check what voltage options that listing offers:

### Claude

**No, don't use the 28 V version.** Sorry my link opened the 9 V option: that listing groups several voltages under one link, and it opened on a different one.

A fixed 28 V board asks the bank for 28 V. What it does when the bank can't supply that depends on the chip on the board:

- **Some boards fall back to the bank's highest lower voltage**, which for the VEGER is 12 V. That would happen to work.
- **Others fall back to 5 V.** Then the pump barely turns and the LEDs stay dark.
- **The real danger comes later:** if you ever swap in a bank that offers 15 V or 20 V, a 28 V board grabs the highest it can get and sends it into a 12 V pump and LED strip. That would likely burn them out.

A fixed 12 V board can never send more than 12 V, which is why it's the safe choice.

**What to get instead:**
1. **On that same listing, pick the 12V option** in the voltage selector. The title should then read "...USB Type C PD **12V** DC Fixed Voltage...". If it shows Prime, that's the one.
2. **If the 12V option has no Prime:** the [MELIFE 12V 6-pack](https://www.amazon.com/MELIFE-Type-C-Voltage-Trigger-Module/dp/B0953G14Q2) is the same kind of board.
3. **Or an adjustable board** with switches or screw terminals, set to 12V ([this one with screw terminals](https://www.amazon.com/Adjustable-Voltage-Trigger-Terminal-Projects/dp/B0GS9BF77Z)). The risk with this kind is a switch getting bumped, so tape over it once set.

Whichever you get, check about 12 V on the meter before connecting anything.

Shall I go ahead and switch the design to the VEGER + 12 V board, then continue with step 3?

---

### Kevin

search vetco's website for a 1 pack

### Claude

Vetco has only one suitable single board, with a USB-A output. Vetco also lists a USB-A-to-screw-terminal adapter, which would solve that. I'll check its price and rating:

### Claude

Vetco has **one** single board that fits: **VUPN2121** ($12.95). It's the "4 Switch, Female to Female" version on [this page](https://vetco.net/products/vupn2121_usb_type-c_pd_qc_3-0_decoy_trigger_board_-_usb-c_output_voltage_selector):

| | VUPN2121 |
|---|---|
| Input | USB-C **socket**, so the VEGER plugs straight in ✅ |
| 12 V setting | DIP switch 2 ON, all others OFF |
| Current | 5 A max, plenty for our ~1.2 A |
| Output | a USB-A socket (that's the catch, see below) |

**When you call** (425) 641-7275, ask for **VUPN2121, the female-to-female, 4-switch version**. Their page mixes it up with **VUPN2956**, the 3-switch version with a USB-C *plug* input, which won't take the VEGER. The page also didn't say whether it's in stock.

**Getting the 12 V out of its USB-A socket:**
- **Best:** solder two wires straight to the socket's outer pins on the underside of the board. Pin 1 is **+12 V**, pin 4 is **ground**. Check which is which with the meter.
- **Also works:** plug in an old USB-A cable with the far end cut off and use its red (+) and black (−) wires. Some cheap cables have very thin power wires, so keep it short.
- **Don't use** Vetco's [USB-A screw-terminal adapter (CV051)](https://vetco.net/products/cv051_usb_a_male_to_screw_terminal_breakout). It looks ideal, but it's only rated for 5 V and 0.5 A.

**After setting switch 2, put a piece of tape over the switches** so they can't get bumped to 20 V. Then check the output on the meter before connecting anything.

**Compared with the Amazon fixed 12 V board:** the fixed one has no switches to bump and gives you a spare. Vetco's gets you one today. Both work; it's your call.

Shall I update the design for the VEGER + 12 V board now (smaller bank pocket with room for the board, shopping list, wiring step), then continue with step 3?

---

### Kevin

seems like the amazon 5 pack is cheaper anyway, so i guess we can go with https://www.amazon.com/AITRIP-PDC004-PD-Voltage-Trigger-Notebook/dp/B09GVQ3FGW?th=1

It supports 12v at up to 5a

### Claude

Good choice. Earlier I flagged that this listing's description also mentions 9 V. The `th=1` in your link means a specific option is selected, so double-check it reads **12V** before ordering. As always, check the output with the meter first.

Now I'll switch the design to the **VEGER + AITRIP 12 V board**. First, where the old bank and cable appear:

### Claude

The guide and wiring diagram are updated. Now the CAD README and the contract, then re-render, commit and push:

### Claude

The design now uses the VEGER bank with the AITRIP 12 V board, and it's pushed to the pull request (https://github.com/TheRageKage12/temprepo/pull/1). The fit checks and the lock test pass.

**What changed:**
- **Bank pocket:** resized to the VEGER (77 x 35 x 25 mm). The bank is now much narrower than the deck pillars, so two low side rails keep it from sliding, and one strap goes across the middle.
- **Room for the plug and board:** the trigger board sits on the bank's plug end, in the gap between the two end stops. A new check makes sure nothing on the cartridge crowds it.
- **Deck:** 0.3 mm lower, since the bank is slightly thinner.
- **Shopping list:** the Adafruit 12 V cable is gone. The VEGER and the AITRIP 5-pack are added (pick the **12V** version). The Adafruit order is now only the Hall sensor, and the guide notes you can skip Adafruit entirely with the A3144 sensor from Vetco.
- **Wiring step:** solder a red and a black wire to the board's output pads, plug the bank in, and check the meter shows about **12 V** before connecting anything. If it shows 5 or 9 V, stop: wrong board version.
- **Refill routine:** unplug the bank from the trigger board to turn the lantern off or to charge it.

**One thing to test on the bench:** small phone banks like the VEGER may switch off when the lantern is idle. Power it up and leave it 5 minutes. If it's gone dead, raise `idle` to 30, then `save`. It's on the "test before the party" checklist.

I couldn't confirm prices for the bank or the boards, so the shopping list says "check listing" for both. The total reads "about $150 plus those two".

Ready for **step 3, the fluid path**?

---

### Kevin

My friend suggested this, so lets consider it: `That seems like a bunch of extra work. Couldn't you just get a battery pack with exposed leads and solder them onto a USB-C connector?`

### Claude

Your friend has a good point, with one correction. I'll check what 12 V packs are available so I can compare concretely:

### Claude

Your friend is half right. The idea underneath is good; the "USB-C connector" part isn't.

**The part that doesn't apply:** our circuit has no USB in it at all. It only needs **12 V on two wires**. The trigger board's only job is to talk a USB power bank into giving 12 V. With a battery pack that already outputs 12 V, there's nothing to solder onto a USB-C connector: its two leads, or its barrel plug with the plug cut off, go straight onto the 12 V rail.

**Don't solder a USB-C port onto a battery to charge it.** Lithium cells need a proper charger with protection circuitry. The packs below come with their own 12.6 V wall charger for that reason.

**So the real choice is a USB power bank + trigger board vs. a plain 12 V lithium pack:**

| | VEGER + 12 V trigger board (current design) | 12 V lithium pack (e.g. 3S 18650 with built-in protection) |
|---|---|---|
| Wiring | Plug the bank into the board, solder 2 wires | Solder 2 wires (or cut off the barrel plug). Slightly simpler. |
| **Switching itself off when idle** | ⚠️ Possible: phone banks often turn off at low current | ✅ Never: a plain pack has no "smart" shutoff |
| **Voltage** | ✅ Steady 12 V until empty | ⚠️ Drifts from **12.6 V full to ~9 V empty**. The pump slows (smaller pours) and the LEDs dim a lot near empty, because the green LEDs need ~9 V to light at all. |
| Charging | Any USB-C charger | The pack's own barrel-jack charger. None I found charge over USB-C. |
| Size | 77 x 35 x 25 mm | 3-cell packs are about 65 x 55 x 20 mm; 6-cell packs about 70 x 55 x 38 mm, which would raise the deck ~13 mm |
| Local option | – | Vetco stocks a 12,000 mAh pack with a 12 V output ([VUPN1334](https://vetco.net/products/vupn1334_usb_portable_charger_12000mah__12v_output)) |

**The voltage drift is fixable in firmware, and it's a small change:**
- Two resistors let the controller read the battery voltage on its spare pin (D0).
- It then turns the pump up as the battery drains, so every pour stays the same size. That works down to about 9.5 V, because the pump normally runs at 70 % and has headroom.
- It could also flash a "low battery" warning when you punch in, so you recharge before the lights get dim.

**My take:** the 12 V pack is **slightly more robust**. It removes the trigger board and the idle-shutoff risk, which is the most likely way the lantern goes dead at a party. The cost is a separate charger plus the firmware change. The VEGER route is already built and fine, as long as it passes the 5-minute idle test.

Examples, if you go that way (sellers' dimensions, unverified, so measure before I size the pocket):
- [TalentCell 12V 3000mAh](https://www.amazon.com/TalentCell-Rechargeable-Amplifier-Multi-led-Indicator/dp/B00MHNQIR2): sold for LED strips; its listing says the output runs from 12.6 V down to 9 V.
- [SSCYHT 3S2P 12V 5000mAh](https://www.amazon.com/SSCYHT-Protection-Replacement-Rechargeable-Batteries/dp/B0CK7VB23Y): 68 x 55 x 38 mm, built-in protection, charger included.

**Which way do you want?**
1. **Keep the VEGER + trigger board** (already done), and rely on the idle test.
2. **Switch to a 12 V pack:** I'd add the battery-voltage reading, pump compensation and low-battery warning to the firmware and its simulated tests, and resize the pocket once you've picked a pack.

Sources:
- [TalentCell 12V 3000mAh (Amazon)](https://www.amazon.com/TalentCell-Rechargeable-Amplifier-Multi-led-Indicator/dp/B00MHNQIR2)
- [SSCYHT 3S2P 12V 5000mAh (Amazon)](https://www.amazon.com/SSCYHT-Protection-Replacement-Rechargeable-Batteries/dp/B0CK7VB23Y)
- [SDHJ 12V 6000mAh 6-cell pack (Amazon)](https://www.amazon.com/Lithium-Battery-Rechargeable-18650-6000Mah/dp/B08ZSV43KG)
- [ABENIC 12V 4000mAh (Amazon)](https://www.amazon.com/clp/B08MQGYKPN)
- [Vetco VUPN1334 12000mAh with 12V output](https://vetco.net/products/vupn1334_usb_portable_charger_12000mah__12v_output)
- [Walmart 12V 2800mAh pack](https://www.walmart.com/ip/16994965800)
- [VXB 12V 5200mAh pack](https://vxb.com/products/go-to-12v-5200mah-rechargeable-lithium-battery-pac)

---

### Kevin

Are there options that help us reduce the battery pack size as well as simplify our design? also, is this cheaper or more expensive than battery pack

### Claude

I'll check current prices before comparing:

### Claude

**Short answer: what we have now, the VEGER + 12 V board, is already about the smallest and cheapest practical option.** Going smaller saves little, and the obvious ways to simplify further hit real limits.

**How much battery the lantern actually needs:** about **2-3 Wh for a whole party**. A pour uses ~15 W for ~13 s, which is tiny, and the electronics idling for 4 hours use ~1-2 Wh. Every option below is several times bigger than needed, so what limits the size is which products are safe and available, not capacity. And since the cartridge change, the battery isn't what sets the lantern's size anyway: the jar, pump and deck do.

| Option | Size | Simpler? | Approx. cost | Verdict |
|---|---|---|---|---|
| **VEGER + 12 V trigger board** (current) | 77 x 35 x 25 mm | Plug in, 2 solder joints | VEGER: I found no current US price; European deals ran about $11-19 (£11.89 to €16.99). Board: one of a 5-pack (price on the listing). Likely **~$20-25 total**. | ✅ Smallest and cheapest. One risk: it may switch off when idle. |
| **12 V lithium pack** (your friend's idea) | Similar or bigger (6-cell packs are 70 x 55 x 38 mm) | No trigger board, but needs its own charger and a firmware change for the voltage drift | ~$30-35 (TalentCell 3000 mAh, about $30 on eBay) | More robust (never switches itself off), but **costs more and isn't smaller** |
| **Run everything at 5 V** (any USB bank, no trigger board, no buck converter) | Any small bank | Much simpler electronics | Cheaper | ❌ **Blocked by the pump.** I found no food-safe 5 V peristaltic pump fast enough. The 5 V ones manage ~45 mL/min, and we need ~180 mL/min to pour 1 oz in 11 s. |
| **Tiny RC-style LiPo** (11.1 V, ~55 x 30 x 20 mm) | Smallest | No | ~$15 + a special charger | ❌ No built-in protection and a fire risk. Not for a drink prop at a party. |

**My recommendation:** stay with the VEGER + board. It's the cheapest and smallest, and it's already in the design. Its one weak spot, switching off when idle, has a firmware fix (the `idle` glow) and a 5-minute bench test.

If the VEGER fails that test even with `idle` raised, your friend's 12 V pack is the fallback. I'd then add the battery-voltage reading to the firmware so pours stay the same size as it drains.

Sources:
- [TalentCell YB1203000 12V 3Ah, eBay ($30.69)](https://www.ebay.com/p/2103873578)
- [Dexter Industries 12V 3000mAh pack ($34.99)](https://www.dexterindustries.com/?p=152846)
- [VEGER 5000mAh 20W deal, UK (£11.89)](https://latestdeals.co.uk/deals/5000mah-20w-fast-charging-portable-usb-c-power-bank-black--amazon)
- [VEGER 5000mAh deal, Italy (€9.99-16.99)](https://www.tuttotech.net/news/2025/06/18/veger-power-bank-5000mah-offerta-amazon.html/amp)
- [VEGER PlugON-C 5000mAh, MediaMarkt NL (€31.90)](https://www.mediamarkt.nl/en/product/_veger-plugon-c-power-bank-black-5000-mah-105305392.html)
- [DFRobot Gravity peristaltic pump, 5-6 V, ≥45 mL/min](https://core-electronics.com.au/gravity-digital-peristaltic-pump.html.md)
- [Atlas Scientific EZO-PMP, up to 105 mL/min](https://www.robotshop.com/products/atlas-scientific-ezo-pmp-basic-kit-white)
- [Little Bird 5-6 V peristaltic pump (tubing not food-safe)](https://littlebirdelectronics.com.au/products/peristaltic-liquid-pump-with-silicone-tubing-5v-to-6v-dc-power)

Shall we carry on with **step 3, the fluid path**?

---

### Kevin

What about this:  https://www.amazon.com/KBT-1200mAh-Rechargeable-Replacement-Compatible/dp/B0C241NS29?th=1

Its dimensions are 70 x 55 x 20 mm (Length × Width × Height)

### Claude

I'll look up what that pack is before judging it:

### Claude

That's a good fit. Here's what I could confirm, and what's left to check on the listing.

**What it is:** a KBT **12 V lithium-ion pack with bare wire leads**, sold with a charger. The page title I could read shows a **2400 mAh** variant, and KBT also lists a 1200 mAh one (model KBT12-12A-01, with charger and connector cable). At **70 x 55 x 20 mm**, that's almost certainly three 18650 cells side by side.

**How it compares with the current VEGER + board:**

| | VEGER + 12 V board | **KBT 12 V pack** |
|---|---|---|
| Size | 77 x 35 x 25 mm, plus the board on its end | 70 x 55 x 20 mm, nothing extra. About the same volume, and **5 mm thinner**, so the deck drops 5 mm. |
| Wiring | Plug into the board, 2 solder joints | **2 bare leads straight to the 12 V rail.** No USB at all. |
| Switches off when idle | ⚠️ Possible | ✅ Never |
| Voltage | Steady 12 V | Drifts 12.6 → ~9.5 V as it drains, so it needs the firmware compensation |
| Charging | Any USB-C charger | Its own included charger |
| Capacity | 18.5 Wh | 1200 mAh ≈ 13 Wh (2400 mAh ≈ 27 Wh). **Both are 4-9x what a party needs.** |

**Before ordering, check on the listing:**
1. **"Protection board" or "BMS".** This is the circuit that cuts the pack off if it's over-charged, over-drained or shorted. Don't buy a bare-lead lithium pack without it. I couldn't see that part of the page.
2. **How the charger connects.** It probably comes with a barrel-plug cable that joins the bare leads. Either way, I'd put a small 2-pin plug between the pack and the lantern: unplug from the lantern, plug into the charger.
3. **The price,** which I couldn't see either.

1200 mAh is plenty. 2400 mAh gives more margin, and since the voltage then drops more slowly, the lights stay bright longer.

**If you choose it, I'll update:**
- **Bank pocket:** sized to 70 x 55 x 20 mm. The trigger board comes out.
- **Firmware:**
  - Read the battery voltage through two resistors on the spare pin D0.
  - Turn the pump up as the voltage drops, so pours stay the same size.
  - Show a **low-battery warning** when you punch in below ~10.5 V: a double blink before the glow.
  - Add simulated tests for all of this.
- **Shopping list and wiring:**
  - Replace the VEGER and the trigger boards with the KBT pack, a 2-pin plug, and two resistors (cents, from Vetco).
  - Add the wiring and charging steps to the guide.

This makes the lantern simpler and removes the idle-shutoff risk, so I'd recommend it if the listing confirms the protection board. Want me to make the switch?

Sources:
- [KBT 12V Li-ion pack (Amazon, B0C241NS29)](https://www.amazon.com/KBT-1200mAh-Rechargeable-Replacement-Compatible/dp/B0C241NS29)
- [KBT 12V 1.2Ah pack, model KBT12-12A-01 (desertcart listing)](https://www.desertcart.co.za/products/537481198-12v-1-2ah-dc5521-connector)
- [KBT 12V 5.2Ah pack, model KBT12-52A-02 (desertcart listing)](https://www.desertcart.sg/products/538356120-12v-5-2ah-dc5521-connector)

---

### Kevin

It has overcharge protection.
It has the barrel-plug DC5521 9V female connector built into it. We could potentially have it more secured in the lantern and have that plug exposed somewhere to charge directly without needing to remove it
Price is $22

### Claude

That works well: overcharge protection, a $22 price, and a built-in DC5521 socket, which means **it can charge without opening the lantern**.

One addition first. With the pack wired straight in, there's no longer a "plug" to pull, so the lantern would slowly drain the battery while stored, at ~15 mA, about 3 days for 1200 mAh. So I'll add a small **power switch** next to the charge socket. Here's the plan:

**CAD:**
- **Pocket:** sized to 70 x 55 x 20 mm. The deck drops ~5 mm.
- **Port panel:** a small panel on the tray, on your side at the bottom, holding the charge socket and a mini toggle switch.
- **Drum:** a matching notch, open at the bottom edge, so the drum still lifts off over the panel.

**Firmware:**
- Battery-voltage reading on the spare pin.
- Pump (and LED) compensation as the voltage drops.
- A low-battery double-blink when you punch in.
- A command to calibrate the reading against your meter.
- Simulated tests for all of it.

**Docs:** shopping list, wiring and charging steps.

Starting with the firmware. I'll read the parts I'm extending:

### Claude

Now the tests: reset the battery state on simulated reboot, then add three scenarios. They cover compensation at several voltages, the low-battery blink, and `vcal` calibration with persistence.

### Claude

The Serial mock lacks Arduino's `print(float, digits)` form, so I'll add it, then the reboot reset and the three scenarios:

### Claude

All 20 scenarios pass, the original 17 plus the 3 new ones. Next, compiling for the real board to make sure the RP2040 core accepts it:

### Claude

The checks pass: the panel sits in the notch without touching the drum. I'll render the base from your side to see how the port panel looks:

### Claude

I'll read the rest of the wiring generator before placing the new battery-sense parts, so they don't overlap anything:

---

## [Context summary written at a compaction]

This session is being continued from a previous conversation that ran out of context. The summary below covers the earlier portion of the conversation.

Summary:
1. Primary Request and Intent:

   **Overall project**
   - A Green Lantern power battery prop that secretly pours a shot.
   - Repo: TheRageKage12/temprepo, branch `claude/green-lantern-battery-prop-7bn4rp`, PR https://github.com/TheRageKage12/temprepo/pull/1.
   - Push commits to update the PR; do not create a new PR.
   - Contents: parametric CadQuery CAD, XIAO RP2040 firmware, build guide with Amazon-preferred links and Seattle stores, diagrams.

   **User preferences and constraints**
   - Concise answers; Amazon links preferred.
   - Local stores (Vetco, Tacoma Screw) for small quantities.
   - Ender 3 printer, 230x230x240 mm.
   - Budget build.
   - Hold-to-pour interaction.
   - Commit attribution lines:
     - "Co-Authored-By: Claude Opus 5.5 <noreply@anthropic.com>"
     - "Claude-Session: https://claude.ai/code/session_01RA7Cpt4fWuKXDa6DwBe3et"
   - No model IDs in repo artifacts.
   - Explanatory output style: include `★ Insight` blocks.

   **Design decisions made this session**
   - Rev 8, lock wall layout:
     - Two sphere openings: the hand opening on the user's side (+Y) and the display window (-Y).
     - The lock sits on a wall just inside the hand opening; you punch in.
     - The glass is pushed in under the lock to a stop, with the wall crossing its back third.
     - The nozzle is hidden behind the wall.
     - LEDs light the hand opening, the display window and the top.
     - A frosted polypropylene strip curtain covers the hand opening.
     - Keep the sphere.
     - Fist is under 4"x3"; offset is not a worry.
   - The ring is on the **left hand**; the twist is **counterclockwise** (user: "better position to grab the glass").
   - The user wants to understand the design step by step. The walkthrough is in progress:
     - Steps 1 (show) and 2 (base) are done.
     - Step 3 (fluid path) is next, after the current change.
   - Rev 9, base cartridge:
     - Hidden thumbscrews underneath; lift the lantern off the cartridge.
     - Slack tube plus cable plugs.
     - User chose "Change it now".
   - Power:
     - The VEGER + AITRIP 12 V trigger board was implemented and pushed.
     - The user then chose the **KBT 12 V Li-ion pack**:
       - https://www.amazon.com/KBT-1200mAh-Rechargeable-Replacement-Compatible/dp/B0C241NS29
       - 70x55x20 mm, overcharge protection, DC5521 female connector built in, $22.
       - Secured in the lantern, with the charge plug exposed to charge without removing it.

2. Key Technical Concepts:

   **CAD framework**
   - CadQuery CAD: params.py; parts/*.py, each with build()/placements().
   - Placements are lists of (axis, angle, translate) steps.
   - checks.py:
     - Envelope tolerance 200 mm³.
     - Part-overlap tolerance 100 mm³ (tightened from 1000).
     - `*_sweep_envelope` is checked against the hardware envelopes; shell parts are excluded.
   - Print-bed shift undone in placements via `_SHIFT` (`unflat()` in sphere.py).

   **Mechanisms and checks**
   - Mirror conjugation for the CCW lock: step (a, θ, t) → (Ma, -θ, Mt) with M = x → -x.
   - Glass path envelope: slide toward the user, then lift.
   - Drum boss sweep envelope.

   **Firmware**
   - Hold-to-pour state machine: IDLE, ARMED, POURING, HOLDING, FINALE, LOCKED.
   - 10-bit PWM, gamma 2.2.
   - Battery sense on A0/D0 through a 100k/22k divider.
   - Compensation k = 12/Vbat, clamped 0.8..1.4.
   - Low-battery double-blink below 10.5 V.
   - `vcal` calibration.
   - Settings magic GL03.
   - Host-side simulation harness (mocks); arduino-cli fqbn rp2040:rp2040:seeed_xiao_rp2040.

   **Power options compared**
   - USB-C PD trigger boards (fixed 12 V vs adjustable; fallback behaviour).
   - 3S lithium packs: 12.6 V full to ~9 V empty.

3. Files and Code Sections:

   - **cad/params.py**
     - Rev 8 block with these values:

       | Parameter | Value |
       |---|---|
       | SOCKET_IN_SPHERE | True |
       | LOCK_TWIST | 'ccw' |
       | SOCKET_Z_LOCAL | 4.0 |
       | SOCKET_MODULE_DEPTH | 13.2 |
       | LOCK_FACE_Y | -12.0 |
       | LOCK_WALL_T | 2.4 |
       | SOCKET_STANDOFF | 0 |
       | SOCKET_EAR_R | 53 |
       | SOCKET_EAR_ANGLES | (40.0, 140.0) |
       | GLASS_TOP_Z_LOCAL | -37 |
       | WELL_ID, WELL_WALL | 54, 2 |
       | GLASS_POUR_Y | -12 |
       | GLASS_SLIDE | 29 |
       | WELL_RIDGE_H | 1.5 |
       | NOZZLE_TIP_XY | (-6, -31.1) |
       | NOZZLE_TIP_OUT | 5 |
       | NOZZLE_RISE | 3 |
       | NOZZLE_BEND_R | 26 |
       | DISH_LOWER_HOLE_D | 104 |
       | FIST_W, FIST_H, FIST_LEN, FOREARM_R | 106, 76, 85, 30 |
       | FIST_Z_OFFSET | 3 |
       | CURTAIN_R | 62 |
       | CURTAIN_HALF_ANGLE | 62 |
       | CURTAIN_SCREW_ANGLES | (40, 70, 110, 140) |
       | HATCH_W, HATCH_H | 120, 96 (hand port) |
       | SERVICE_SCREW_ANGLES | (0.0, 140.0, 225.0) (replaced BASE_DOOR_W/H) |

     - Latest (uncommitted):
       ```
       POWERBANK_L, POWERBANK_W, POWERBANK_T = 70.0, 55.0, 20.0   # KBT 12 V Li-ion pack ...
       PORT_ANGLE = 90.0
       PORT_W, PORT_H = 42.0, 12.0
       PORT_JACK_D, PORT_SWITCH_D = 8.0, 6.2
       ```
     - TRIGGER_ALLOW_L removed.

   - **cad/parts/sphere.py**
     - Rev 8:
       - `lock_wall()` replaces led_carrier:
         - 120x99 plate; front face y = -25.2, back face -27.6, wall-local z0 = -50.5.
         - Notch over the glass: NOTCH_HW 33, NOTCH_TOP 16.5.
         - Tabs at x 42..50; corner notches.
         - BACK_ROWS (35, 65.5, 76.5, 87.5), 100 long.
         - Front columns at x ±54, z 29.5..79.5, with wire holes.
         - Ear holes; Hall window 34x18.
         - WALL_POSTS ((-40,55),(40,55),(-47,25),(47,25)) to the diffuser.
       - `curtain_clamp()`: arc r 58..65, 3 mm, screws at P.CURTAIN_SCREW_ANGLES; UPPER_PLUG_H.
       - `nozzle_guide`: C-channel open toward the wall; GROMMET_XY = (-37, -31.1); GUIDE_SCREW; WIRE_SLOT_XY (35, -32).
       - `glass_well`: slot with WELL_SKIRT and a ridge; bay_floor slot with chamfer.
       - `glass_path()` envelope.
       - FLANGE_SCREW_ANGLES (30, 150, 210, 330).
       - Diffuser and ledge clipped to |z| < 49.
       - `_SHIFT` / `unflat()` placements.

   - **cad/parts/socket.py**
     - FACE_Y = P.LOCK_FACE_Y; EAR_ANGLES from params; standoffs only if > 0.
     - MIRROR = P.LOCK_TWIST == 'ccw': build() mirrors all outputs with `.mirror('YZ')`; placements conjugate the steps via `_mirror_step`, leaving the mount step unchanged.
     - Assert MODULE_DEPTH == P.SOCKET_MODULE_DEPTH.

   - **cad/parts/dishes.py**
     - `build_top_diffuser()` replaces top_cap: 3 mm disc, thin centre 1.2 mm, countersinks on the bed face; placement flipped 180° about X.
     - Curtain clamp pilots in the plug underside.
     - Lower hole uses P.DISH_LOWER_HOLE_D.

   - **cad/parts/base.py** (rev 9 cartridge; KBT changes uncommitted)
     - Door code removed.
     - New constants:
       ```
       SERVICE_ANGLES = P.SERVICE_SCREW_ANGLES; SERVICE_R = 79.0; BOSS_R0 = 75.5
       BOSS_Z0, BOSS_Z1 = 8.0, 18.0; BOSS_W = 10.0; NUT_Z0, NUT_T, NUT_AF = 11.0, 2.8, 5.8
       PAD_R0 = 70.0; PAD_W = 22.0; WELL_D, WELL_DEPTH = 20.0, 6.0; KNOB_D, KNOB_H = 10.0, 5.5
       TRAY_R = R_IN - P.FIT; SERVICE_SWEEP_Z1 = SPIGOT_ZONE_Z0 - 1.0
       ```
     - Functions:
       - `_sector_box`, `_service_xy`.
       - `_drum_bosses` (45° roof; drum printed top band down: build rotates 180 about X; placement `((1,0,0),180,(0,0,P.BASE_H))`).
       - `build_base` cuts `_drum_port_notch()`.
       - `_tray_pads`.
       - `build_tray` with `_bank_pocket`, `_pillars`, `_floor_electronics`, `_tray_pads`, `_port_panel()`.
       - `build_knob`; `_service_sweep`.
       - Deck notches at the service angles.
     - `_bank_pocket`: end stops (BANK_END_STOP_X = (7.0, P.POWERBANK_W/2)), side rails, one central strap slot pair.
     - `_port_panel()`:
       - Curved 3 mm skin at r R_MAX-FIT, height PORT_H-FIT, plus floor tab and ribs.
       - Jack hole at x = -half/2 and switch hole at +half/2, z ≈ 6.85, rotated to PORT_ANGLE.
     - `_drum_port_notch()`: box PORT_W x 30 x (PORT_H+1) at R_MAX-6, z from -1.
     - Envelopes: bottle, pump, powerbank; trigger_envelope removed.
     - Parts: base, base_tray, base_deck, thumb_knob, service_sweep_envelope plus envelopes.

   - **cad/checks.py**
     - Overlap tolerance `v > 100.0`.
     - The sweep envelope is checked vs ('bottle_envelope', 'pump_envelope', 'powerbank_envelope').
     - SHELL = ('base', 'dish_lower') excluded from the sweep check.

   - **cad/render_views.py**
     - COLORS includes top_diffuser WHITE, base_tray DARK.
     - Rear title "assembly, your side: hand opening with the lock inside (strip curtain not shown)".
     - Cutaway excludes switch and glass_path envelopes.

   - **firmware/green_lantern/green_lantern.ino** (uncommitted)
     - Added:
       ```
       constexpr uint8_t BATT_PIN = A0;  // = D0
       constexpr float BATT_DIVIDER=(100+22)/22, ADC_VREF=3.3, ADC_MAX=4095, BATT_NOMINAL_V=12, BATT_PRESENT_V=6,
         BATT_LOW_V=10.5, BATT_K_MIN=0.8, BATT_K_MAX=1.4, BATT_EMA=0.05; LOWBATT_BLINK_MS=150; LOWBATT_LEVEL=0.6
       struct Settings {...; float battScale;}; SETTINGS_MAGIC 0x474C3033 "GL03"
       float battV; bool lowBattWarn;
       battRead(), battService() (EMA; <6 V -> 0), battSensed(), battK()
       ```
     - pumpService: `full = PWM*speed/100*battK()` (exact when k == 1), capped.
     - ARMED light: two 150 ms blinks at 0.6 if lowBattWarn, then the normal fade.
     - lightService skips the fade limiter while blinking.
     - LED duty multiplied by battK().
     - loadSettings validates battScale 0.5..2.
     - Status prints "battery=X.XXV" / "LOW - recharge" / "not sensed".
     - `vcal <volts>` command.
     - `analogReadResolution(12)` in setup; `battService()` in loop.
     - IDLE→ARMED sets `lowBattWarn = battSensed() && battV < BATT_LOW_V`.
     - Header documents D0 wiring and the vcal command.
     - **Compiles: 63136 bytes.**

   - **firmware/test/Arduino.h**
     - Added A0..A3.
     - `sim::analogIn[]`, `analogRead`, `analogReadResolution`.
     - `SerialStub::print(double v, int digits)`.

   - **firmware/test/test_green_lantern.cpp**
     - reboot resets battV, lowBattWarn and analogIn.
     - `setBattery(volts)` helper.
     - New scenarios: r (compensation), s (low-battery blink), t (vcal persistence).
     - **20/20 PASS.**

   - **docs/images/src/gen_fluid.py**
     - True CAD section at x = 0 with LEDs, curtain, tube, cable and labels.
     - Labels: "base cartridge: 3 thumbscrews…", "Kamoer KPHM200 pump (behind the section), head toward your side".

   - **docs/images/src/gen_socket.py**
     - MIRROR = True; face views mirrored with an SVG transform.
     - Labels: counterclockwise, ears onto the lock wall, the lock wall in the section.

   - **docs/images/src/gen_interaction.py**
     - Callouts: pushed back under the lock; grip, slide toward you, lift; through the curtain.

   - **docs/images/src/gen_wiring.py**
     - Currently shows the VEGER and the AITRIP trigger board. **Needs updating to KBT + switch + charge jack + divider.**
     - Layout notes:
       - Battery box `box(24, 84, 170, 90, ...)`.
       - Trigger box at (220, 96, 150, 60).
       - + wire `(370,112)->(400,112)->(400,RAIL12)`.
       - − wire to gnd at (386,176).
       - C2 at cx = 450, label at (cx+16, 156).
       - Buck IN+ wire at y 196 from x 80 to 415.
       - +5 V branch at y 210 from x 310 to 700.
       - XIAO box at (330, 230, 170, 270).
       - Stage boxes at y 250, x 830-1140.
       - Notes line: "No master switch or fuse in this build: unplug the bank from the trigger board…".

   - **docs/BUILD_GUIDE.md** (last committed state: VEGER + AITRIP)
     - Contains items 8 (VEGER) and 8a (AITRIP), with "Skip the Adafruit order" (A3144).
     - Total line: "about $150 plus the power bank and the trigger boards".
     - Wiring step 2 is about the trigger board.
     - Cartridge assembly steps and refill routine ("Unplug the power bank from the trigger board").
     - Troubleshooting row "Check the trigger board gives 12 V".
     - Test "power bank stays on after 20 minutes idle".
     - Upgrade row "Master power switch and fuses… inline rocker".
     - Part list includes base (top band down, 146 g), base_tray, base_deck, thumb_knob ×3, lock_wall, curtain_clamp, top_diffuser; total ~815 g.

   - **cad/README.md, cad/DESIGN_CONTRACT.md**
     - Revisions 6, 7, 8 and 9 recorded, plus the power note (VEGER, rev 9a).
     - cad/README.md power bank line mentions the VEGER.
     - NOTES-base.md is marked superseded.

4. Errors and fixes:
   - **Glass-removal flaw** (round well; lift blocked by the nozzle and socket):
     - Fixed with the slot plus slide.
     - The slope idea was wrong (needs ~15-20°), so it became a 1.5 mm ridge.
   - **Pre-existing bugs found by a 0.05 cm³ audit**:
     - LED carrier posts reversed plus the print-bed shift.
     - sphere_rear shifted 3 mm.
     - Flange bosses at 60/120° floating.
     - Diffuser/ledge into the dish plugs.
     - Well skirt in the bay floor.
     - Fix for all of these: `_SHIFT` unflat, angle changes, clips, and a chamfer.
   - **base.py text-cut duplication**: an end marker matched an earlier occurrence; fixed by `git checkout` and redoing with exact anchors.
   - **Knob overlapping the drum band**: SERVICE_R 81.8 → 79, BOSS_R0 → 75.5, knob 10 mm.
   - **Third screw angle** 220° → 225° to clear the jar finger.
   - **Sweep envelope flagged its own drum bosses**: excluded the SHELL parts.
   - **Socket ear at 225° hit a back LED row**: ears moved to (40, 140) and front columns to x 54.
   - **Ray-test script IndexError on empty hits**: handled.
   - **User correction on the JacobsParts link**: my link opened the 9 V variant. The user then proposed the 28 V variant; I said no (unsafe) and to pick 12 V. The user chose the AITRIP 12 V 5-pack.
   - **"Palm turns toward the glass" wording** was unsupported; replaced with neutral text.
   - **Amazon direct fetch blocked by captcha**: used WebSearch/WebFetch instead.

5. Problem Solving:
   - **Solved**:
     - Punch-in/lock-wall geometry with checks.
     - CCW mirrored lock.
     - Base cartridge with verified sweep (negative test at 180° fails as expected).
     - Bank-size research.
     - KBT firmware compensation (tests pass, compiles).
     - KBT CAD pocket and port panel (checks 0 problems; render shows a small panel with jack and switch holes in the bottom band on the user's side).
   - **Open notes**:
     - The VEGER/AITRIP choice has been superseded by the KBT.
     - The guide's idle-shutoff test is no longer relevant.

6. All user messages:
   - (Sketch image) "I think I want it to look something like this. The shot glass can be inserted toward the bottom of the opening and slid back behind some walling that hides the nozzle and possibly other electronics. LEDs would line the top and both sides around the openings. The liquid would be at the bottom/base, and all the electronics and such can either be tucked between the walls hiding the nozzle or just above the liquid"
   - AskUserQuestion answers:
     - "There are only 2 openings on the sides of the lantern. The back portion (as I have it now) doesn't have any utilitarian purpose. It is mostly there for display and piping out LED light. I face the front opening and push my fist in, like a punch. The lock is directly inside there. The glass should be able to be inserted from the same direction, and be relatively simple to push all the way back to the correct position. The glass would be bisected by the wall with the lock on it so that the nozzle can pour liquid and i can get a grip and take it out. LEDs would line the front, back, and top openings. We might need something to kind of "block" vision into the interior of the lantern. For the most part this design has all the electronics and such hidden; the only real challenge would be obscuring the key hole if we really want to do that. I don't think its a huge deal though."
     - Keep the sphere.
     - "Light should come out the top and 2 openings. It doesn't seem like it would be much more complex to have the strips on the 2 sides, or to use some sort of translucent material that lets the light through but kind of obscures what is inside. Then my hand just needs to be able to cleanly move in and out with the glass."
     - Right hand.
   - "My left hand will have the ring, but the rotation should still operate like a normal key, so I don't think that's a huge issue. Also, my fist is less than 4" in width and 3 inches in height, so we just need some clearance for that plus the glass for the window. We probably don't really need to worry too much about how offset my fist is in it, unless you're very worried about it."
   - "For the strips maybe we can find a material that has a little stretch/give such that i can just move my hand between the strips"
   - "Wait, I think I mixed this up. I would want it to twist counterclockwise so that my hand is in a better position to grab the glass"
   - "I want to go through the design step by step so that I fully understand how everything is put together and works. Do you know of any skills that would help drive that conversation? I"
   - "yes, start with step 1, and explain in detail"
   - "ready for step 2"
   - "If I find a smaller power bank, how would that impact our design? Is there a cheaper/simpler options than using magnets for the door? What if the base unscrewed or something?"
   - "I don't really mind having to undo a few thumbscrews to open it. That would solve the twist off problem with tubes and wires. We'd want to hide the thumbscrews inside of it though so the exterior looks good. Ideally, the only real in the field refill/installation we'd need to do is: 1. Undo thumbscrews 2. Pop base out, which includes pump, battery, and jar currently. 3. Disconnect power cable and tubing that goes to jar. 4. Fill jar 5. Reconnect power cable and tubing 6. Remount and redo thumbscrewd. Either that, or maybe most of the exterior is just kind of a shell around the unit. In this case, all the electronics and tubing would stay with the base/interior when it gets opened up"
   - AskUserQuestion answers: "Slack tube + cable plug (Recommended)"; "Change it now".
   - "This battery looks smaller at 3.62"L x 1.1"W x 2.7"Th ? https://www.amazon.com/FrostVoyage-Battery-10000mAh-Blanket-Portable/dp/B0FM84S98W/..."
   - "Can you search Amazon for power banks that fit our criteria and might be smaller than what we have now?"
   - "The VEGER does `USB C Plug Output ( PD + QC + FCP + PE1.1/2.0 + Samsung AFC + BC 1.2 etc): 5V-3A, 9V-2.2A, 12V-1.6A`"
   - "which is better/easier: the board or a usbc extension cable?"
   - "search amazon for a compatible pd board" / "or local retailers"
   - "you selected the 9V variation. This one is 28V but has prime delivery, would that work? https://www.amazon.com/JacobsParts-Voltage-Trigger-Module-Type-C/dp/B0FQQ5C6M2?th=1"
   - "search vetco's website for a 1 pack"
   - "seems like the amazon 5 pack is cheaper anyway, so i guess we can go with https://www.amazon.com/AITRIP-PDC004-PD-Voltage-Trigger-Notebook/dp/B09GVQ3FGW?th=1 It supports 12v at up to 5a"
   - "My friend suggested this, so lets consider it: `That seems like a bunch of extra work. Couldn't you just get a battery pack with exposed leads and solder them onto a USB-C connector?`"
   - "Are there options that help us reduce the battery pack size as well as simplify our design? also, is this cheaper or more expensive than battery pack"
   - "What about this: https://www.amazon.com/KBT-1200mAh-Rechargeable-Replacement-Compatible/dp/B0C241NS29?th=1 Its dimensions are 70 x 55 x 20 mm (Length × Width × Height)"
   - "It has overcharge protection. It has the barrel-plug DC5521 9V female connector built into it. We could potentially have it more secured in the lantern and have that plug exposed somewhere to charge directly without needing to remove it. Price is $22"

7. Pending Tasks:
   - Finish the KBT switch:
     - Update gen_wiring.py: battery box (KBT 12 V Li-ion, 3 cells, overcharge protected), power switch symbol, charge jack note, battery-sense divider box to D0, notes line about the master switch.
     - Update BUILD_GUIDE.md:
       - BOM: replace VEGER/AITRIP with the KBT ($22); mini toggle switch (1/4" / 6.2 mm, ≥3 A, Vetco); panel-mount DC5521 jack (8 mm/M8) plus a short DC5521 male lead to the pack's socket; 100k, 22k, 0.1 µF.
       - Total about $170-175 including the battery.
       - Wiring step 2: pack + → switch → rail, − → GND, charge jack → pack socket bypassing the switch, divider on D0.
       - Pin table: D0.
       - Serial table: vcal, battery status.
       - Calibration: vcal step.
       - Tests: replace the bank idle test with a battery reading test and low-battery blink.
       - Refill/charging: plug the charger into the jack on your side, power switch.
       - Troubleshooting: double blink means low battery; remove the trigger rows.
       - Upgrades: remove the master-switch row.
       - Print table: base_tray green, 169 x 174 x 26.
     - Update cad/README.md (power bank line) and DESIGN_CONTRACT (rev 9b note).
     - Re-render, regenerate the diagrams, run tests, commit and push.
   - Then continue the walkthrough with **step 3: the fluid path**.

8. Current Work:
   - Implementing the KBT 12 V pack change:
     - **Firmware:** done and tested (20/20 PASS, compiles).
     - **CAD:** done (KBT pocket, `_port_panel()` on the tray, `_drum_port_notch()` in the drum; build checks 0 problems; port render looks right).
   - Immediately before the summary, I had read docs/images/src/gen_wiring.py in full to edit its power section.
   - Plan for gen_wiring.py:
     - Replace the "Power bank"/"12 V trigger board" boxes with a battery box plus a toggle switch symbol between the pack's + lead and the +12 V rail (switch around x 260-300, y 112).
     - Move the − lead's ground to x 210.
     - Move the C2 label to the left of C2.
     - Add a "battery sense" divider box (about (560,136,160,52)) tapped from the rail, with a wire to a D0 pin on the XIAO top edge (about x 480).
     - Update the notes line.
   - None of the KBT changes are committed yet. Last pushed commit: 26b3096 (VEGER + AITRIP).

9. Optional Next Step:
   - Update gen_wiring.py, BUILD_GUIDE.md, cad/README.md and DESIGN_CONTRACT.md for the KBT pack, power switch, charge jack and battery sense.
   - Regenerate the diagrams and renders, run `make test` and `build.py`, then commit and push.
   - Then report to the user and offer step 3 (fluid path).
   - This follows my stated plan to the user's message "It has overcharge protection. It has the barrel-plug DC5521 9V female connector built into it. We could potentially have it more secured in the lantern and have that plug exposed somewhere to charge directly without needing to remove it. Price is $22". My plan was: "Pocket sized to 70 x 55 x 20 mm … a small port panel … holding the charge socket and a mini toggle switch … Firmware: battery-voltage reading … Docs: shopping list, wiring and charging steps."

If you need specific details from before compaction (like exact code snippets, error messages, or content you generated), read the full transcript at: /root/.claude/projects/-home-user-temprepo/45c7fed5-b38c-5bcd-8935-8412da500de5.jsonl
Continue the conversation from where it left off without asking the user any further questions. Resume directly — do not acknowledge the summary, do not recap what was happening, do not preface with "I'll continue" or similar. Pick up the last task as if the break never happened.

### Claude

Updating the wiring diagram for the KBT pack, power switch and battery sense; rendering it to check the layout.

### Claude

Diagram reads cleanly. Now the build guide.

### Claude

Editing the build guide now (shopping list, wiring, charging, tests), then the CAD notes.

### Claude

Small comment fixes in base.py and the render title, then rebuild and test.

### Claude

Everything builds (0 check problems, 20/20 firmware tests). Quick visual check of the renders before committing.

### Claude

The port panel sits flush in the bottom band on your side. Committing and pushing.

### Claude

The KBT pack change is finished and pushed to [PR #1](https://github.com/TheRageKage12/temprepo/pull/1). The CAD checks show 0 problems, the lock-mechanism test passes, the 20 simulated firmware tests pass, and the firmware compiled before I made a final comment-only edit to it.

**What changed**
- **Base:** the pack lies flat in a 70 x 55 x 20 mm pocket on the cartridge floor, and the deck above it sits 4.7 mm lower than before. The trigger board is gone.
- **Charging and on/off:** a small panel at the bottom edge of the base, on your side, holds the charge jack and a mini on/off switch (S1). The drum has a matching notch, open at the bottom, so it still lifts off over the panel. To charge, switch off and plug the KBT charger into the jack; you don't need to open anything.
- **Firmware:**
  - It reads the battery voltage on pin D0 through two resistors.
  - It turns the pump and the LEDs up as the pack drains, so pours stay the same size.
  - When you punch in with the battery below 10.5 V, the light double-blinks before the glow.
  - `vcal 12.31` calibrates the reading against your meter.
- **Wiring diagram and build guide:** updated for the new parts, wiring, charging steps, tests and troubleshooting. The total is now about **$175 including the battery**.

**New parts to buy:**
- The KBT pack ($22, Amazon).
- From Vetco:
  - A mini toggle switch: 1/4" hole, on-off, rated 3 A or more.
  - A panel-mount DC5521 jack with an M8 nut.
  - A 100k and a 22k resistor and one more 0.1 µF capacitor.
- Only if the pack didn't come with one: a DC5521 male plug with bare leads.

`★ Insight ─────────────────────────────────────`
- **The charge jack is wired before the switch.** The charger feeds the pack directly. With S1 off, nothing else draws current, so the charger reads the pack's state correctly and switches off when it's full.
- **The voltage reading is taken after the switch.** With S1 off, the two resistors draw nothing, so they can't slowly drain the pack in storage. The firmware treats a reading under 6 V as "nothing connected" and turns compensation off, so the board also runs without those resistors fitted.
`─────────────────────────────────────────────────`

**One thing to check before printing:** measure your jack and switch. The panel holes are 8 mm and 6.2 mm (`PORT_JACK_D` and `PORT_SWITCH_D` in `cad/params.py`).

Ready for **step 3 of the walkthrough: the fluid path**, from the jar through the pump and tube up to the nozzle over the glass?

---

### Kevin

Sure, let's continue the walkthrough

### Claude

Pulling up the fluid-path diagram to walk through it.

### Claude

## Switch on with the charger connected

Nothing gets damaged, and the lantern works normally while it charges. The charge jack is wired straight across the pack, so the charger, the pack and (with S1 on) the lantern are all on the same two wires:

- **Voltage:** a Li-ion charger for a 3-cell pack holds about 12.6 V. That's the same as a full pack, so every 12 V part is fine. The firmware reads 12.6 V and slows the pump about 5 %, so pours stay the same size. You won't get a low-battery blink.
- **Current:** the charger supplies the lantern first, and the rest charges the pack:
  - Idle, the lantern takes about 15 mA, so charging is barely slower.
  - During a pour it takes about 1.2 A, likely more than a small charger gives. The charger then runs at its limit and the pack makes up the rest for those 11 s.
- **Knowing it's full:** a charger decides the pack is full when its current drops very low, typically around a tenth of its rating. 15 mA idle is far below that, so the charger's light should still turn green. A charger that's very strict about its cut-off might take longer.
- **The one real downside:** don't leave it switched on and plugged in for days as a permanent power supply. A Li-ion pack held at full charge wears out faster. It isn't a safety problem, because the protection board still blocks overcharging. Running it plugged in for an evening is fine.

So my advice to charge with the switch off is a best practice, not a rule. It charges a little faster that way and the charger's "full" light is reliable.

---

# Step 3: The fluid path

I've sent the section diagram: a true slice through the CAD, seen from the side. The display window is on the left, your side is on the right, and the blue line is the drink.

## The route, in 5 parts

**1. The jar** (in the base, on the deck)
- 8 oz, with two holes drilled in the lid:
  - **6 mm for the tube.** Silicone tube is 6.4 mm, so it seals itself in the hole and nothing else is needed. The tube reaches to **5 mm above the bottom**, so the last of the drink still gets picked up.
  - **2.5 mm vent.** Without it, every millilitre pumped out leaves a slight vacuum in the jar. After a few pours the vacuum fights the pump and the pours shrink.

**2. The pump** (Kamoer KPHM200, beside the jar, head toward your side)
- It's a **peristaltic** pump. The tube is laid in a curved track, and rollers on a rotating arm squeeze it flat as they go round. Each roller pushes a pocket of liquid ahead of it, like squeezing toothpaste along a tube. Three useful results:
  - **Nothing touches the drink except the tube.** No valves, impeller or seals are wetted, so nothing in the pump needs cleaning except the tube itself.
  - **It's a valve when stopped.** A roller always pinches the tube shut. When the pump stops, the flow stops dead: no siphoning and no slow drip.
  - **It self-primes:** it sucks liquid up from the jar on its own.
- The head faces your side so you can open its cap to load the tube, or release it for storage.

**3. The service loop** (above the jar and pump)
- About **30 cm of spare tube**, loosely coiled in a circle no smaller than 5 cm, or it kinks. This is what lets you lift the lantern off the cartridge for refills without disconnecting anything.
- The tube is **one continuous piece from the jar to the nozzle**. There are no joints, so nothing can leak.

**4. Up through the lantern**
- The tube rises through the hollow neck of the lower dish and comes up through a 7 mm hole in the bay floor. That hole is behind the lock wall, on your right as you look in.
- The cables take a separate 7 mm hole on the left, so the drink line and the wiring never share a hole.

**5. The nozzle** (hidden behind the lock wall)
- The tube runs into `nozzle_guide`, a small printed channel. The channel bends the tube through a smooth 90° curve, from straight up to horizontal, with a 26 mm radius so it can't kink.
- **The channel is open on one side, and the lock wall's back closes it.** That's how the tube sits only 3.5 mm behind the wall, tucked out of sight.
- 5 mm of tube sticks out past the channel, cut square. A square cut breaks the last drop off cleanly; a slanted cut lets it creep back along the tube.
- The tip sits **15 mm above the glass rim, 20 mm from the glass's centre**. That's over the back third of the glass, the part hidden behind the wall.

**After the first prime, the tube stays full** between pours, because the pump's rollers seal the line. So the drink reaches the glass as soon as the pump starts, and the pour time matches the light build-up closely.

**Food safety:** the drink touches only the jar, the platinum-cured silicone tube (food-grade, FDA and NSF rated) and the glass. **No printed part is in the drink path.** PETG layer lines would trap sugar and grow mould.

## ⚠️ A problem I found while checking this step

Walking through the nozzle geometry, I calculated where the stream lands. The tube ends pointing **sideways**, so the drink leaves it moving sideways and travels a little before it falls to the rim:

| Pump speed | Exit speed | Sideways travel before the rim | Lands this far from the glass centre |
|---|---|---|---|
| Soft start (16 %) | 0.08 m/s | 4 mm | 19 mm ✅ |
| **Default 70 %** | 0.34 m/s | 19 mm | **23 mm, right at the rim** ⚠️ |
| 100 % (if you speed it up for liqueur) | 0.48 m/s | 27 mm | 29 mm, **outside the glass** ❌ |

The inside of a Libbey glass's rim is only about 23.5-24.5 mm from its centre. At the default speed the stream's edge already clips the rim, and a peristaltic pump pulses, so the peaks throw further still. The CAD checks can't catch this, because they check parts colliding, not where liquid lands. The water test in the guide would show it, but only after printing.

**The fix:** bend the tube further, about 135° instead of 90°, so the tip points **downward at 45°**. The stream then dives into the glass instead of flying across it:
- About 10 mm of sideways travel at 70 % and about 11 mm at 100 %.
- It lands near the glass centre at any speed you'd use.
- The last drop falls 21 mm from the centre, well inside.
- Only `nozzle_guide` changes; the tube hole stays where it is. The bend is a little tighter (about 15 mm radius, still fine for this tube) and stands about 5 mm taller behind the wall. I'd need to confirm in the CAD that it clears the LED rows on the back of the wall.

Want me to make that change now, before step 4 (the lock)?

I also corrected two stale labels on the diagram (the old power bank) and the out-of-order steps in guide section 7, and pushed those.

---

### Kevin

| 2.5 mm vent. Without it, every millilitre pumped out leaves a slight vacuum in the jar. After a few pours the vacuum fights the pump and the pours shrink.
Isn't this a leakage risk?

Yes, lets make that change for the pour

### Claude

Now the edits: params, the guide geometry, and the fluid diagram's tip position.

### Claude

Guide clears everything: 6.9 mm above the glass, 4.4 mm from the glass's slide-out path, 1.3 mm under the lowest LED row. Updating the docs and diagram.

### Claude

The new nozzle passes every fit check. Now updating the guide: the nozzle text, plus a one-way vent valve for the jar, which answers your leak question.

### Claude

The render shows the hook clearing the wall and the stream dropping into the glass. Re-rendering the repo images and pushing.

### Claude

## The vent: yes, an open hole could leak

You're right. An open hole only leaks when the jar tips: while it stands upright in its ring the hole is above the drink. But tipping is realistic (carrying the lantern at an angle, or knocking it over), and the battery and electronics are right under the jar.

I've replaced the open hole with a **one-way check valve**, the kind used on aquarium air lines, about $6 for 10 on Amazon or at any pet store:
- **Air can get in**, which is all the jar needs as the pump draws the drink out.
- **Nothing can get out**, so a tipped jar stays sealed. The pickup tube can't leak either, because the pump's rollers pinch it shut whenever the pump is stopped.
- **Fitting it:** drill a second 6 mm hole in the lid, push a 2 cm piece of the drink tube through it (it seals itself, like the pickup tube), and push the valve onto the top of that stub. The arrow points **into** the jar.
- **Checking it:** blow through it. Air should go in but not come back out.
- **Room:** there's about 44 mm of space above the lid, under the glass slot, so the valve fits.

The valve takes a tiny suction to open, which the pump overcomes easily, so pours don't change.

`★ Insight ─────────────────────────────────────`
- **The vent's job:** whatever volume of drink leaves the jar, the same volume of air has to come in.
- **Why it matters:** if no air gets in, after a few 30 mL pours the air left in the jar would be at roughly three-quarters of normal pressure. The tube's inside would then be under suction, so the soft silicone would flatten a little under the rollers. Each roller stroke would move less drink, so each pour gets smaller.
- **Why a check valve fixes it:** air only ever needs to flow in, so a one-way valve gives the jar its air while blocking the only direction a leak could take.
`─────────────────────────────────────────────────`

## The pour fix is done

I've sent a render of it. The nozzle guide now bends the tube **135°** instead of 90°: up from the floor, over, and **45° down**.

| | Before (tip level) | Now (tip 45° down) |
|---|---|---|
| Tip height above the rim | 15 mm | 7 mm |
| Where the stream lands at 70 % speed | 23 mm from centre, **on the rim** | 19 mm from centre |
| At 100 % speed, or a pump pulse | **outside the glass** | 19 mm, inside |
| Last drop | 20 mm, inside | 19 mm, inside |

The inside of the rim is about 23.5 mm from the glass's centre, so there's now about 4 mm of margin at any speed. The landing distances are my calculation, so the 20-pour water test in the guide is still the real proof.

**What stays the same:**
- The tube still comes up through the same hole in the bay floor, so nothing else moved.
- The tube end still sits behind the wall, out of sight.
- The fit checks show 0 problems:
  - 1.3 mm of clearance under the lowest LED strip on the back of the wall.
  - 6.9 mm above the glass.
  - 4.4 mm from the glass's slide-out path.

**One trade-off:** the bend is tighter, 18 mm radius instead of 26. That's about 3 times the tube's 6.4 mm width, and the channel supports the tube along the whole curve, so it shouldn't pinch. If the flow ever seems restricted, open up `NOZZLE_BEND_R` in `cad/params.py`.

The guide is updated: shopping list (now about $180), lid and nozzle steps, the part table, and a troubleshooting row for a valve fitted backwards. Everything is pushed to [PR #1](https://github.com/TheRageKage12/temprepo/pull/1).

**Next is step 4: the lock.** It covers how the rotor, stops, cam, spring plunger, switch and Hall sensor fit together and why each one is shaped the way it is. Ready?

Sources:
- [Aquaneat aquarium check valve 10-pack (Walmart listing)](https://www.walmart.com/ip/16600910249)
- [Aquaneat check valve, fits 3/16" airline (U-Buy listing)](https://www.u-buy.co.uk/product/IXTW5I6PU-aquaneat-aquarium-check-valve-one-way-non-return-valve-for-aquarium-air-pump-check-valve-for-316-inch-airline-tubing-fish-t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)
- [Generic aquarium check valve 10-pack, 4 mm ports (ManoMano)](https://www.manomano.co.uk/p/pack-of-10-check-valves-for-aquarium-air-pumps-one-way-check-valve-for-aquarium-air-pumps-accessories-for-19-cm-aircraft-tubing-22137433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)

---

### Kevin

yes

### Claude

# Step 4: The lock

I've sent the lock diagram. The top shows the lock as you see it through the hand opening: at rest on the left, fully twisted to 45° on the right. The bottom is a slice through its middle with the ring seated.

## What it has to do
1. Accept the ring **one way only**, so the magnet always lands in the same place.
2. Let you twist **exactly 45° counterclockwise**, with solid stops at both ends.
3. **Click a switch** near the end of the twist, without the switch ever being what stops your hand.
4. **Spring back** to rest when you let go.
5. Know whether a ring is in, through the whole twist.
6. Fit in a module only **13.2 mm deep**, because your fist is in front of it and the glass is under it.

## The six printed parts

| Part | What it is | Its job |
|---|---|---|
| `socket_housing` | A 76 mm puck, 6.7 mm deep, with every cavity in it | Holds everything. Its front face is flush with the ring pocket. |
| `rotor` | A flat 36 mm disc, 8 mm thick | The part that turns. The keyed pocket is on its face; three features stick out of its edge. |
| `socket_base` | A 3.5 mm plate that closes the housing from behind | Carries the Hall sensor board and the switch bracket. Its two "ears" screw the lock to the wall. |
| `switch_bracket` | A small sliding plate with two pegs | Holds the microswitch. Its slot lets you fine-tune where the switch clicks. |
| `plunger` | A 4.5 mm pin with a rounded nose | Rides on the rotor's edge and pushes the rotor back to rest. |
| `key_cap` | A 24 mm disc with a tab, glued to your ring | Carries the magnet and makes the ring fit one way only. |

## How each job is done

**1. One way in: the keyed pocket**
- The rotor's face has a 24 mm round pocket, 3.5 mm deep, with a notch for the key cap's 6 x 4 mm tab.
- The magnet is glued in the **centre** of the key cap, on the rotation axis. So when you twist, the magnet spins in place but **never moves**. That's why the ring sensor reads "present" through the whole twist.
- Nothing grips the ring. When you pull your fist out, the key cap just lifts out of the pocket. That's deliberate: pulling the ring out mid-pour is a safety stop. The sensor sees the magnet leave and the pump stops within about 60 ms.

**2. The 45° hard stops: the stop lug**
- A 4 mm lug on the rotor's edge sits in a curved channel in the housing. The channel's two end walls *are* the stops, at 0° and 45°.
- The rotor goes in **from behind**, and its edge features sit under a lip on the housing's front. So the rotor can't be pulled out toward you. The lip retains it, and you can't pull the lock apart through the hand opening.
- The CAD test confirms the stops: past 45.8° or before -0.8°, the lug runs into the housing.

**3. The click: cam and microswitch**
- A bump (the "cam") on the rotor's edge reaches the switch's lever at about **30-33°** of twist and presses it 3 mm. The switch **clicks at about 40°**.
- **Why click before the stop:** if the switch clicked exactly at 45°, some twists would hit the stop without clicking, depending on tolerances. Clicking 5° early is reliable.
- **Why the stop takes your force:** the cam's raised part continues past 45°, so at the stop the lever is held down but never crushed. The lug against the channel wall takes your twist, not the switch.
- **Tuning:** the switch's bracket slides ±2 mm in its slot. Slide it toward the rotor and it clicks earlier; away, and it clicks later. Each switch's click point varies a little, so this is set by hand during assembly (guide section 6, step 6).

**4. Spring return: the plunger and ramp**
- A small compression spring (0.5 mm wire, 5 x 10 mm) pushes the plunger against the rotor's edge, in a pocket pointing out from the centre.
- Under the plunger, the rotor's edge has a **ramp** that gets 4 mm higher over the 45° of twist. Twisting pushes the plunger outward and squeezes the spring. Let go and the spring pushes back down the slope, which turns the rotor back to 0°.
- At rest the spring is still squeezed 1.2 mm, so the rotor stays firmly against the 0° stop.
- **Why not a coil spring around the axis?** That's the usual design, but it needs a spring of a specific size wound in a specific direction. A small straight spring from Vetco's spring drawer and a printed ramp do the same job.
- That steady push back is what makes the "hold it through the oath" feel. It's also a **dead-man control**: let go and the pump stops.

**5. Ring detection: the Hall sensor**
- The DRV5032 board sits in a pocket in the base plate, chip facing the rotor, centred under an 8 mm window on the axis. The magnet is about **8 mm** away, through the rotor's floor.
- Either magnet pole works with this sensor, so you can't glue the magnet in upside down.
- Its cable goes through a window in the lock wall and down behind it to the base.

**6. Fitting in 13.2 mm**
- The rotor is a **flat disc**, not a deep cylinder, so the Hall board can sit right behind it. That keeps the magnet close to the sensor and the whole module thin.
- The lock's front face sits 12 mm in front of the sphere's centre. That leaves room for your fist in front and puts the glass rim 3 mm under the lock.

## Counterclockwise from a clockwise design
The lock was designed for a clockwise twist, and you chose counterclockwise.
- Rather than redesign it, the code **mirrors every lock part left-to-right** when it writes the print files.
- The geometry and the mechanism test still work in the original clockwise version, and the mirroring happens only at output. So the test still proves the real parts work.
- The two mounting ears are a mirror pair, so the lock wall didn't need to change.
- `LOCK_TWIST = 'cw'` in `cad/params.py` gives the clockwise version back.

`★ Insight ─────────────────────────────────────`
- **Each job gets its own feature.** The stop takes force, the cam signals, the ramp returns and the sensor detects. Combining two of them would make a weak spot. For example, a switch that doubles as the end stop would wear out quickly and click unreliably.
- **Mirroring the output keeps the test valid.** Rewriting the design for counterclockwise would have meant re-verifying it from scratch. Mirroring only the final parts means the one design and its test cover both directions.
`─────────────────────────────────────────────────`

**Two things only the real parts can confirm:**
- **Spring stiffness.** If the twist is too stiff for a finger, the guide says to swap to a 0.4 mm wire spring.
- **Switch click point.** Different D2F-L clones click at slightly different lever positions, which is what the sliding bracket is for.

That's why the guide says to print the lock first, before any big part.

**Next is step 5: the lock wall, the light and the curtain.** It covers how the wall holds the lock and hides the nozzle, where the LED strips run, and how the curtain hangs. Ready?

---

### Kevin

Is this locking mechanism as simple as it can be, or are there other available parts that might make this easier to build?

### Claude

Short answer: **for what this lock has to do, it's close to as simple as it gets.** I looked at the off-the-shelf parts that could replace it. Each one either doesn't fit the 13 mm of depth the lock has, or swaps simple mechanics for harder electronics.

## What you build today
Six small printed parts and three bought ones: the microswitch, the spring and the Hall sensor board. Together they do four jobs: hard stops, spring return, a twist signal and ring detection. The fiddly steps are:
- dropping the spring and plunger in while you lower the rotor;
- tuning where the switch clicks;
- gluing in four nuts.

## The alternatives I considered

| Option | What it replaces | Why it doesn't win here |
|---|---|---|
| **Spring-return selector switch** (the twist knobs on machine control panels: IDEC, Eaton M22) | Almost all of it: bearing, stops, spring return and the switch contact, in one sealed part | **Too deep:** about 35 mm behind the panel, against our 13.2 mm. It would push through the lock wall into the LED rows and show through the display window. **Wrong angle:** most two-position spring-return models turn 90°; Eaton has a 40° one. **No spot for the Hall sensor:** the switch body sits right where the sensor goes, behind the ring's magnet on the axis, so ring detection would need a new design. |
| **AS5600 magnetic angle sensor** (~$5 board) | The microswitch, the cam, the bracket and the tuning. It reads the exact twist angle *and* whether the magnet is there, so one sensor replaces two. | **The magnet must be within about 0.5-3 mm of the chip;** ours is about 8 mm away. Closing that gap means redesigning the rotor around a fixed post. It also needs a different kind of magnet and a firmware rewrite. |
| **One analog Hall sensor** (e.g. SS49E, ~$1), with the magnet slightly off-centre | The microswitch, the cam and the bracket | **You lose the click you can feel**, which is a nice cue to start the oath. The trigger point would rely on calibrating magnetic field strength, which drifts with the magnet and the gap. A switch either clicks or it doesn't. |
| **Bought spring plunger** (a threaded ball plunger) | The loose spring and the printed plunger, and you could adjust the force by screwing it in or out | **They only travel about 1-1.5 mm;** the ramp needs 4 mm. A shallower ramp would give much less return force. |
| **Printed flexure spring** instead of the steel one | The spring purchase | **PETG slowly sags under a constant load,** so the return would weaken over months. |

`★ Insight ─────────────────────────────────────`
- **Each part pays for itself.** "Simplest" isn't the fewest parts; it's the fewest parts that each do one job reliably. Here every bought part costs a dollar or two, and each printed feature replaces something you'd otherwise have to buy and fit.
- **Depth decided most of this.** The lock has 13.2 mm because your fist goes in front and the glass goes under. Most off-the-shelf rotary parts are designed for a panel with plenty of room behind it, which is why so few of them fit.
- **The switch adds a cue you can feel.** A sensor-only design would be cleaner electrically, but you'd lose the click that tells you mid-performance that the pour has started.
`─────────────────────────────────────────────────`

## What would actually make it easier
The design is fine. The best help is in how you build it, and the guide already does most of this:
- **Print and test the lock first** (guide section 3). Its parts are small and quick, so problems show up before the big prints.
- **The switch bracket slides on purpose:** tuning is two minutes with the lock in your hand.
- **If the spring is too stiff or too soft,** swap it from Vetco's spring drawer; nothing needs reprinting.

If you'd still like to try one of these, the **analog Hall sensor** is the most realistic: same wiring, cheap parts, and a smaller lock. The cost is the click you feel and some calibration. My recommendation is to keep the current design.

Want to go on to **step 5: the lock wall, the light and the curtain**?

Sources:
- [IDEC spring-return selector switch, 2 positions (RS)](https://my.rs-online.com/web/p/selector-switches/1682721)
- [IDEC spring-return selector switch, 3 positions, 45° throw (RS)](https://ph.rs-online.com/web/p/selector-switches/1682725)
- [Eaton M22 2-position selector head (RS)](https://nl.rs-online.com/web/p/selector-switch-heads/0250829)
- [IDEC YW1S-21 momentary selector head (Maplin)](https://pro.maplin.co.uk/products/yw1s-21-22mm-2-position-momentary-selector-switch-head-idec)
- [AS5600 datasheet: 0.5-3 mm typical air gap (alldatasheet mirror)](https://www.alldatasheet.net/html-pdf/1452014/OSRAM/AS5600/6113/34/AS5600.html)
- [SimpleFOC forum on AS5600 magnet distance](https://community.simplefoc.com/t/assalamualaikum-im-using-as5600-magnetic-encoder-sensor-for-one-of-my-project-when-i-setup-magnet-distance-1-mm-in-between-magnet-a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)

---

### Kevin

sure

### Claude

Rendering views of the lock wall and LED layout for step 5.

### Claude

# Step 5: The lock wall, the light and the curtain

I've sent three views (bright green is LED strip):
- the wall from your side;
- the wall from the display side;
- the top dish from below, showing the LED ring.

## The lock wall: one part with three jobs
`lock_wall` is a flat printed plate, **120 x 99 mm and 2.4 mm thick**, standing across the inside of the sphere. Its face toward you is 25 mm past the sphere's centre, on the display-window side. It does three things at once:

**1. It holds the lock.**
- The lock's two ears screw through the wall (2 x M3x10 and nuts), so the lock's face sits 12 mm past the centre. That's where your punch ends.
- Behind the lock, a **34 x 18 mm window** in the wall lets the Hall sensor's cable and the switch wires pass to the hidden side.

**2. It hides the machinery.**
- The nozzle guide stands behind it, and so does the cable run down to the base.
- At the bottom, a **66 mm notch** stops 3 mm above the glass rim. The glass slides under the wall, and the wall crosses its back third, which is exactly where the nozzle pours.

**3. It carries all the wall LEDs:**
- **Your side:** a 5 cm LED column either side of the lock, in shallow channels. Their wires pass through small holes to the back.
- **Display side:** 4 rows, each two 5 cm pieces end to end, facing the display window.

**How it's held:**
- Two tabs at the bottom drop into slots in the bay floor.
- Its top edge stops 1 mm under the upper dish, so once the top is on, the wall can't lift out.
- Four 6 mm posts on its back reach to the display diffuser and keep the wall square, so it can't lean back.

## The light: 15 pieces, 3 zones, 1 switch

| Zone | Pieces | Where | What you see |
|---|---|---|---|
| **Display window** | 8 (4 rows x 2) | Back of the wall | The white window glows evenly |
| **Hand opening** | 2 | Your face of the wall, beside the lock | The curtain glows from behind, and the lock is lit as you punch in |
| **Top** | 5 | Around the inside of the 80 mm hole in the upper dish's floor | The frosted disc on top glows |

- All 15 pieces are **wired in parallel** onto one pair of wires and one MOSFET. So the whole lantern brightens and dims together, which is all the show needs. Together they draw about 0.35 A.
- **Why the top ring fits so neatly:** 5 pieces x 5 cm = 25 cm, the same as the hole's 25.1 cm circumference. The hole wall is 8 mm tall, the same as the strip's width. The leads hang down on the display side of the hole, so they fall behind the lock wall.

**How the diffusers work:**
- **Display window:** a 1 mm white PETG sheet (printed at 100 % infill), about **3 cm in front of the LED rows**. That distance matters. LEDs right behind a diffuser show as a row of bright dots; at 3 cm their light overlaps and the window glows evenly.
- **Top:** a 3 mm white disc, thinned to 1.2 mm over the hole, screwed into the recess where the lock sat in an earlier design. Its countersunk screws sit flush on top.

## The curtain
- **13 strips** of 0.5 mm frosted polypropylene, each 12 mm wide and 97 mm long, overlapping 2 mm. That gives one 132 mm curved curtain.
- A curved printed clamp (`curtain_clamp`) screws them to the underside of the upper dish, about **2.5 cm inside the hand opening**, curving with the sphere.
- Your fist and the glass push the strips aside, and they fall back into place. The light from the two LED columns behind them makes the whole opening glow. That glow also hides the inside: a lit, frosted surface in front of a darker space is hard to see through.

`★ Insight ─────────────────────────────────────`
- **Why polypropylene and not PETG or acrylic:** PP can bend thousands of times without cracking. It's the plastic used for the "living hinges" on flip-top bottle caps. Each strip flexes on every punch, so a stiffer plastic would crack or stay bent.
- **Why put all the LEDs on the wall:** it's one flat part you wire on the bench before it goes in. The alternative was strips glued around the inside of each opening, which would mean wiring inside a closed sphere.
- **Why the curtain hangs inside the opening and not at it:** the opening's rim stays a clean edge, and the strips get room to swing without catching on it.
`─────────────────────────────────────────────────`

**What to check when you build it:**
- **Strip thickness:** strips thicker than 0.5 mm feel stiff to punch through. The troubleshooting table suggests a 0.3 mm report cover.
- **Light balance:** the display window has 8 pieces and your side has 2, so the audience side is the brightest. If you want the hand opening brighter, a 3rd piece fits along the wall's front edge, but that needs a new channel in the CAD.

Next is **step 6: the electronics**: the board, what each part does, why the MOSFETs need the 74AHCT125 between them and the controller, and the battery compensation. Ready?

---

### Kevin

I'd like the lights to be roughly even on both sides

### Claude

Doable. First I'll check how much room the wall face has and how the firmware drives the light.

### Claude

Keeping the lighting as it is; I hadn't changed anything yet.

If the display side looks noticeably brighter once it's built, the separate dimmable channel can still be added later. It only needs one more MOSFET and a firmware setting, so nothing gets reprinted. The extra columns on your side would mean reprinting the lock wall.

Ready for **step 6: the electronics**? It covers the board, what each part does, why the MOSFETs need the 74AHCT125 between them and the controller, and how the battery compensation works.

---

### Kevin

yeah

### Claude

# Step 6: The electronics

I've sent the wiring diagram. Follow it left to right: power comes in at the top left, the controller sits in the middle, and the two loads are on the right.

## The big picture: three voltages
| Voltage | Colour | Comes from | Feeds |
|---|---|---|---|
| **12 V** | orange | The battery, through the power switch | The pump and the LED strip, the power-hungry parts |
| **5 V** | red | A buck converter that steps 12 V down | The controller board and the gate driver chip |
| **3.3 V** | purple | A regulator on the controller board | The controller's own logic and the Hall sensor |

Every part shares one ground, and all the ground symbols are the same wire.

## 1. Power in (top left)
- **Battery pack:** 12.6 V full, about 9.5 V flat. Its protection board cuts it off on a short, an overcharge or a deep discharge.
- **Charge jack:** wired straight across the pack, before the switch, so it charges with the lantern switched off.
- **S1, the power switch:** the only on/off. Off means zero drain in storage.
- **C2, a 2200 µF capacitor across the 12 V line:** a small reservoir. When the pump motor starts it briefly draws a surge, and C2 supplies it so the voltage doesn't dip and reset the controller. The firmware's soft start helps with the same problem.

## 2. Making 5 V: the LM2596 buck converter
- It turns 12 V into 5 V efficiently by switching on and off rapidly, rather than burning the extra voltage off as heat.
- **You set its output once with its little screw, measured with a meter, before anything is connected.** Out of the box it can put out up to the full 12 V, which would destroy the controller.
- **The 1N5819 diode between it and the controller:** current can only flow toward the controller. When you plug the controller into a laptop to program it, the laptop's USB can't feed back into the buck converter and the rest of the lantern.

## 3. The brain: the XIAO RP2040
A thumb-sized controller board. Its pins:

| Pin | Connected to | Direction |
|---|---|---|
| **D0** | Battery sense | Reads the battery voltage |
| **D1** | Hall sensor | "Ring present" |
| **D2** | Microswitch | "Twisted and held" |
| **D3** | Pump, via the gate driver | Output |
| **D4** | LED strip, via the gate driver | Output |
| D6 | Optional prime button | Input |

- **D1 and D2 use the controller's internal pull-up resistors.** Each input rests HIGH (3.3 V), and the sensor or switch pulls it to ground when active. So no extra resistors are needed, and a broken wire reads "inactive", which is the safe direction.

## 4. The muscles: two MOSFETs
The controller's pins can supply only a few milliamps at 3.3 V. The pump needs 0.7 A at 12 V. A **MOSFET** is an electronic switch: a small voltage on its **gate** lets a large current flow from its **drain** to its **source**.

- **Low-side switching:** the pump's and strip's + wires go straight to 12 V, and their − wires go to a MOSFET, which connects them to ground. Switching on the ground side is the simplest arrangement, because the gate only needs a voltage relative to ground.
- **PWM dimming:** the controller switches the MOSFETs on and off about 1,000 times a second. On 30 % of the time gives about 30 % brightness, or 30 % pump speed. The light uses 1,024 levels, so slow fades look smooth.
- **The IRLZ44N** is a "logic-level" MOSFET: it's designed to switch fully on with only 5 V on its gate. Regular MOSFETs need about 10 V.

## 5. Why the 74AHCT125 sits in between
This is the least obvious part. The controller's outputs are **3.3 V**, and even a logic-level MOSFET only partly switches on at 3.3 V. Partly on, it acts like a resistor: it heats up and the pump runs weak.

The **74AHCT125** is a cheap chip with four "buffers". Each one copies its input to its output, but **the output swings to its own 5 V supply**. So 3.3 V in becomes 5 V out, and the MOSFET switches hard on.

`★ Insight ─────────────────────────────────────`
- **The "T" in AHCT is what makes this work.** A 74**HC**125 on 5 V needs at least 3.5 V to see HIGH, which is just out of reach of 3.3 V logic. The 74**AHCT**125 uses older TTL thresholds that count anything above 2.0 V as HIGH. Same pinout, one letter different, and only one of them works here.
- **A buffer also defines what happens at power-up.** While the controller boots, its pins briefly float, so they're neither HIGH nor LOW. The two 10 k resistors pull the buffer inputs LOW, so the pump can't twitch on at power-up, before the firmware has even started.
- **The MOSFET switches the pump's ground, not its 12 V.** Switching the + side would need a gate voltage *above* 12 V, which means extra parts.
`─────────────────────────────────────────────────`

**Wiring details on U1:** the four "enable" pins (1, 4, 10, 13) are tied to ground, which keeps the outputs always on. The two unused inputs are tied to ground too, because floating inputs on this kind of chip can oscillate and waste power. The 0.1 µF capacitor beside it smooths its supply.

## 6. Protection parts
- **Flyback diode across the pump (1N5819):** a motor's coils store energy. When the MOSFET cuts the current off, that energy produces a voltage spike that could destroy the MOSFET. The diode gives it a harmless path back around the motor. The LED strip has no coils, so it doesn't need one.
- **10 k pull-downs:** covered above.

## 7. The sensors (inside the lock)
- **DRV5032 Hall sensor:**
  - Powered from 3.3 V. Its output is "open drain": it can only pull the line to ground, never drive it high.
  - So the controller's pull-up supplies the HIGH, and the sensor pulls LOW when the magnet is near.
  - It works with either magnet pole.
- **D2F-L microswitch:** a plain contact. Pressed, it connects D2 to ground.
- Both share one **4-wire cable** (3.3 V, Hall, switch, ground) running down behind the wall, with a plug so the lantern can separate from the base.

## 8. Battery sense
- Two resistors (100 k and 22 k) form a **voltage divider**. It scales 12.6 V down to 2.27 V, safely under the controller's 3.3 V input limit.
- The 0.1 µF capacitor smooths out noise from the PWM switching, and the firmware averages the readings as well.
- **What the firmware does with the reading:**
  - At lower battery voltage it raises the pump's PWM to compensate. At 10 V that's 1.2x, so pours stay the same size.
  - It scales the LEDs the same way, so the brightness stays steady.
  - Below 10.5 V you get the double blink when you punch in.
- Large resistor values mean the divider itself draws only about 0.1 mA, and only with the switch on.

## Power budget
| | Current at 12 V |
|---|---|
| Idle (controller, buck converter, dark LEDs) | ~15 mA |
| LEDs at full | ~0.35 A |
| Pump | ~0.7 A |
| **Peak, pouring with lights up** | **~1.1-1.2 A** |

That's why a 1200 mAh pack covers 100+ pours. A pour lasts about 13 s, so most of the drain is the idle current, and that only matters while the switch is on.

**Build tip (guide section 4):** assemble everything on the 5 x 7 cm perfboard on the bench. Test it with the serial `status` command and a magnet before anything goes into the lantern. Then the only connections inside the lantern are the two plugs, the pump, and the power leads.

Next is **step 7: the firmware**, the code behind the show, the safety interlocks, and the simulated tests that check them. Ready?

---

### Kevin

convert the wiring diagram to something displayable in the browser. SVG isnt

### Claude

I've sent the wiring diagram as a PNG image (2580 x 1760, so you can zoom in on the pin labels). It's also committed and pushed as `docs/images/wiring.png`.

The fluid path, lock mechanism and state machine diagrams are SVGs too. Do you want those as PNGs as well, or shall we go on to step 7, the firmware?

---

### Kevin

Go ahead and convert them to PNGs as well, but we don't need to look at them right now. If you need the original SVGs make sure to keep those.

If the voltage drops due to low power, what happens to the entire system? Lets say its at 10v instead of the full 12?

### Claude

All five diagrams now have PNG copies in `docs/images/`, pushed to the PR. I kept the SVGs, since the scripts that draw the diagrams write SVG.

## What happens at 10 V instead of 12

At 10 V a 3-cell pack is nearly empty, roughly 10-20 % charge left. The low-battery double blink starts at 10.5 V, so you'd already be seeing it. Part by part:

| Part | At 10 V | Why |
|---|---|---|
| Controller, sensors, lock | ✅ Unaffected | The buck converter still makes a steady 5 V. It needs only ~2 V of headroom, so it keeps going down to about 7 V. |
| Gate driver and MOSFETs | ✅ Unaffected | Their 5 V comes from the buck converter, so they still switch fully on. |
| Battery reading | ✅ Works | 10 V reads as 1.8 V on D0, well within range. |
| **Pump** | ✅ **Compensated, same pour size** | A DC motor's speed follows the average voltage. The firmware raises the PWM from 70 % to 84 %, and 10 V x 84 % = 12 V x 70 %. It can keep doing that down to about 8.5 V. |
| **LED strip** | ⚠️ **Noticeably dimmer** | See below |
| Below ~8 V | ⛔ Everything switches off | The pack's protection board cuts the power. Nothing is harmed, and your settings stay saved. |

## The LED strip problem: a flaw I found answering this

Each 5 cm piece of a 12 V strip is **3 LEDs plus a resistor in series**. The 3 LEDs need a fixed ~9 V before any current flows; only the voltage left over the resistor sets the current:
- **At 12 V:** about 2.7 V is left over → full current.
- **At 10 V:** only about 0.7-1 V is left over → **roughly 25-45 % of the current**.

So at 10 V, three-quarters of the voltage loss lands on the LED current, which is why a modest voltage drop dims them a lot.

The firmware's compensation assumed brightness falls in proportion to the voltage. It raises the LED PWM 1.2x, but that's far too little. And at the 90 % peak of the light build, the PWM hits its 100 % ceiling anyway. **Result: at 10 V the light peaks at roughly a third to half of its normal brightness.** You'd see the lantern visibly dimmer through the second half of the battery.

`★ Insight ─────────────────────────────────────`
- **Why the pump compensates and the LEDs don't:** a motor's speed scales smoothly with average voltage, so a PWM correction works. An LED barely conducts until its threshold voltage is reached, then current rises steeply. A fixed-resistor strip sits just above that threshold, so a small supply drop is a big current drop.
- **The fix is to regulate the LED supply, not to correct it in software.** PWM can only remove light, never add it, so once the duty cycle is at 100 % there's nothing left to give.
`─────────────────────────────────────────────────`

## Options
1. **⭐ A small buck-boost converter for the LED strip only** (~$5-8). It holds a steady 12 V from any battery voltage between 9.5 and 12.6 V. It sits between the 12 V line and the strip's +, and you set it with a meter, like the LM2596.
   - **Brightness:** the light stays the same from full to empty.
   - **Pump:** keeps the firmware compensation, which already works.
   - **Firmware:** I'd remove the LED part of the compensation.
2. **Regulate everything to 12 V, pump included.** That needs a bigger module: ~1.6 A from a nearly flat pack, so more heat and cost. The pump compensation already handles the pump, so this mostly adds cost.
3. **No new hardware: raise the low-battery warning to ~11 V.** You'd see the dimming coming and charge sooner. At 11 V the LEDs run at ~60-70 % of their current, so still noticeable. You'd use only about half the pack between charges, roughly 50+ pours, which is still plenty for a party.

I'd go with **option 1**: one small module and the light stays constant all night. Want me to add it to the parts list, the wiring diagram and the firmware?

---

### Kevin

I think we're ok for now. We shouldn't ever go below 50% battery anyway. We can add those later if needed

### Claude

OK, no change to the design. Charging at 50 % is a good habit for this pack:
- **Voltage at half charge:** about 11.2 V. The pump's compensation covers that range fully.
- **LEDs:** at 11.2 V the strip still gets about 70 % of its full-charge current. Your eye notices that much less than the number suggests, so the drop from a fresh charge should be mild.
- **Pours:** half the 1200 mAh pack still covers more than 50 pours.
- **Battery life:** Li-ion packs last longer when they aren't run down deep.

So you don't lose track of it, I've added a row for the buck-boost converter to the guide's upgrades table (section 15). It says how to add it, and what dimming to expect without it. That's pushed.

Ready for **step 7: the firmware**? It covers the code behind the show, the safety interlocks, and the simulated tests that check them.

---

### Kevin

yes

### Claude

# Step 7: The firmware

Step 1 covered *what* the show does. This step is about *how the code does it*. It's one file, `firmware/green_lantern/green_lantern.ino`, about 500 lines, and needs no extra libraries. (The state diagram from step 1 is `docs/images/state-machine.png`.)

## The shape of the program: one loop, 100 times a second
Everything runs from a single loop that repeats every ~10 ms. Each pass does the same steps in the same order:

```
loop():
  1. readInputs()     read the sensors, debounce them
  2. battService()    read and smooth the battery voltage
  3. serviceSerial()  handle any typed command
  4. pumpService()    soft start, duration timer, hard cap
  5. interlocks       no ring -> pump off (whatever the state)
  6. state machine    decide what happens next
  7. lightService()   draw the light for this moment
```

**Nothing ever waits.** There's no "turn the pump on, wait 11 s, turn it off". Instead every timer is a timestamp plus a check: "has 11 s passed since the pump started?" The loop is never stuck, so the ring sensor is re-checked every 10 ms even mid-pour. That's what makes "pull the ring and the pump stops within ~60 ms" possible.

## 1. Inputs and debouncing
Real switches and sensors flicker for a few milliseconds when they change. Each input stores its **raw** reading and when that last changed. It only counts as changed once the new value has held steady:

| Input | Must be steady for | Why |
|---|---|---|
| Ring arriving | 100 ms | A magnet brushed past the lock doesn't arm it |
| Ring leaving | 200 ms | Before resetting to IDLE |
| Ring leaving **during a pour** | **60 ms** | A faster path that stops the pump. Safety beats debouncing here. |
| Switch | 40 ms | Contact bounce |

## 2. The state machine
The six states (IDLE, ARMED, POURING, HOLDING, FINALE, LOCKED) are a `switch` statement. Each state checks only the few events that matter to it. The design choices that matter:
- **"One pour per insertion" is a single flag:** `pouredThisInsertion`. It's set when the pump starts and cleared only when a ring arrives in IDLE. A second twist with the ring still in finds the flag set and does nothing.
- **LOCKED exits only one way: the ring is removed.** That's how the prop resets between performances.
- **The jammed-switch rule:** if the switch is already pressed when the ring goes in (or at power-up), it's flagged and ignored until it's released. A stuck cam can't start a pour by itself.

## 3. The pump: safety doesn't depend on the state machine
`pumpService()` runs every pass and **enforces limits on its own**, whatever state the program thinks it's in:
- **Requested duration:** stops after the pour time.
- **Hard cap:** 20 s of *continuous* running, ever. Even a bench `cal` run straight after a pour can't add up past it.
- **Soft start:** ramps from ~16 % to full over 0.3 s, so the motor's start-up surge doesn't drag the supply down.
- **Battery compensation:** multiplies the duty by 12 V ÷ battery voltage (covered in step 6).

And step 5 of every loop is a **global interlock:** *ring absent and pump on → pump off*, whatever the state. The only exceptions are the two deliberate ring-free modes: the bench `cal` command and the PRIME button. Each carries a flag saying so.

`★ Insight ─────────────────────────────────────`
- **Defence in depth:** the state machine *should* never run the pump without a ring, but the pump logic doesn't rely on that. The interlock and the hard cap are separate and simpler pieces of code. A bug in the more complex state logic still can't make the pump run on.
- **`since(t) = millis() - t` is wrap-safe.** `millis()` counts milliseconds in a 32-bit number, which rolls over to 0 after 49.7 days. Subtracting timestamps in unsigned 32-bit maths still gives the right elapsed time across the rollover; comparing `millis() > deadline` would not. One of the tests starts the clock just before the rollover to prove it.
- **The pump pin is the very first line of `setup()`.** Before the serial port, the settings or anything else, the pump output is driven LOW. Together with the 10 k pull-downs from step 6, the pump is held off from power-up onward.
`─────────────────────────────────────────────────`

## 4. The light: what you see vs. what's sent to the LEDs
- **Each state describes the light as a function of time**, as *perceived* brightness from 0 to 1. ARMED fades up to 0.15 over 0.6 s. POURING climbs in a straight line to 0.9 over the pour time. FINALE swells, holds, then fades.
- **`lightService()` turns that into PWM** in three steps:
  1. **Gamma 2.2:** raises the brightness to the power 2.2. The eye is far more sensitive at the dim end, so a straight-line PWM ramp would look like it jumps up early, then barely changes. Gamma correction makes the climb *look* steady.
  2. **A fall limiter:** brightness can drop by at most the full range per second. Pulling the ring out mid-show fades out quickly but smoothly rather than snapping off.
  3. **10-bit PWM (1,024 levels),** so the dimmest steps of a fade don't flicker visibly.

## 5. Settings that survive power-off
- Pour time, pump speed, brightness, idle glow and the battery calibration live in a small struct in flash memory. The RP2040 has no real EEPROM, so the core imitates one in a corner of flash.
- At boot the code checks a **magic number ("GL03")** and that every value is in range. If anything's wrong it falls back to the defaults. A corrupted or old-format save can't produce, say, a 0 ms pour or a 500 % pump speed.
- The magic number changes whenever the struct's layout changes. The battery calibration bumped it from GL02 to GL03, so old saves are ignored instead of being read wrongly.

## 6. The serial console
At 115,200 baud: `status`, `cal`, `pour`, `speed`, `leds`, `idle`, `vcal`, `save`, `stop`.
- Each command validates its range before changing anything.
- Changes take effect immediately but are kept only after `save`. You can experiment freely, and a power cycle undoes it.

## 7. The tests: running the firmware without the board
`firmware/test/` runs the **real `.ino` file on your computer**:
- **How it works:**
  - A fake `Arduino.h` replaces the hardware functions.
  - `millis()` reads a simulated clock that the test advances.
  - `digitalRead` returns whatever the test sets for the pins.
  - Every pump and LED write is recorded with a timestamp.
- **What it checks:** 20 scenarios replay events (insert ring, twist, glitch the sensor for 30 ms, pull the ring mid-pour…) and check *exactly* what the pins did. For example, "the pump pin was on for 11,000 ms ±10 ms" or "pump off within one loop of the 60 ms abort".
- **Coverage:** every safety interlock listed at the top of the file has at least one scenario, plus clock rollover, debouncing, settings persistence, the PRIME button and the battery logic.
- **Running it:** `cd firmware/test && make test`. It takes a few seconds; all 20 pass now.

**Why bother:** the dangerous failures here are timing problems: a pump that doesn't stop, or a second pour. They're hard to reproduce by hand with a real magnet, but trivial to replay exactly in simulation. And you can test the firmware before any part is printed.

I also fixed one stale code comment I found while reviewing (it still mentioned the old power bank) and pushed that.

Next is **step 8: printing and assembly order**: which parts to print first, the critical fits to check, and the order things go together so nothing gets trapped. Ready?

---

### Kevin

yup

### Claude

Checking the assembly order for traps, I found two problems in the guide's wording, both fixable without CAD changes. Fixing them now.

### Claude

# Step 8: Printing and assembly order

## Printing

**The basics:**
- **26 printed parts, about 820 g of PETG.** Almost all green, plus two white diffusers (and a white lock wall if you like).
- **Everything fits your Ender 3.** The widest part is the display-side… correction, the *your-side* sphere half at 221 mm (the handle bosses stick out). The tallest is the base drum at 115 mm.
- **Supports only inside the two sphere halves,** around the window and the hand opening, where the dome curves over more than 45°. Use tree supports on the inside only. Every other part was shaped to print without them; for example, the drum prints upside down so its nut blocks have a 45° roof.
- **Screws go straight into the plastic.** Each screw hole is a 2.7 mm pilot, and the M3 screw cuts its own thread the first time. Go slowly and don't over-tighten.
- **Time:** at typical Ender 3 PETG speeds, roughly **70-90 hours** in total. That's my estimate, not a slicer figure. The big parts (drum, two dishes, two sphere halves) take most of it, at roughly 8-15 h each.

**Print in this order, because the small test parts decide whether the big ones are worth printing:**

| Order | Parts | What it proves | If it fails |
|---|---|---|---|
| **1** | The lock: `socket_housing`, `rotor`, `socket_base`, `plunger`, `switch_bracket`, `key_cap` | The rotor turns 45° with light drag and snaps back. The key cap fits one way. | Raise `FIT` in `cad/params.py` by 0.05 and reprint the rotor. This tunes all the clearances for *your* printer. |
| **2** | `glass_well` | **Your actual shot glass** slides the slot, clicks over the ridge, and comes back out | Pick a glass at most 52 mm across the top |
| 3 | Optional: cardboard hand check | Your fist plus the glass pass a 120 x 96 mm hole | No reprint needed: you learn it before printing |
| 4 | `base_tray` | Your charge jack and switch fit their 8 mm and 6.2 mm holes | Adjust `PORT_JACK_D` / `PORT_SWITCH_D` |
| 5 | Everything else, big parts last | | |

I added row 2 to the guide just now. The glass is the one part you buy that the design can't adjust to, so it's worth checking before 80 hours of printing.

`★ Insight ─────────────────────────────────────`
- **`FIT` is a single knob for the whole design.** Every sliding or rotating fit adds it as clearance. Printers vary by ±0.1 mm, so tuning `FIT` on the lock (the tightest fit) fixes the other fits too.
- **Test the cheap, risky parts first.** The lock is 45 g and a few hours; the sphere halves are a day each. A problem found on the lock costs an evening; the same problem found after the sphere costs a weekend.
`─────────────────────────────────────────────────`

## Assembly: sub-assemblies first, then stack bottom to top

Each sub-assembly gets built and tested on the bench, where everything is easy to reach. Then the lantern stacks up in one pass.

**On the bench:**
1. **The lock** (guide section 6): build it, tune the switch bracket, cycle it 50 times.
2. **The electronics board** (section 4): set the buck converter to 5 V *before* connecting anything. Flash the firmware, then test with `status` and a magnet.
3. **The lock wall** (section 8): LED strips into their channels, wired in parallel. Then the lock screwed on.
4. **The top dish** (section 8): LED ring in the hole, top diffuser screwed on, curtain clamped under it.
5. **The cartridge** (section 9, step 1): battery, buck converter, jack and switch in the panel, deck, jar, pump, board.

**Then stack** (section 9): drum + lower dish → bay floor + glass slot + tube → nozzle guide → lock wall → the two sphere halves → top dish → handle → lower it onto the cartridge and do up the thumbscrews.

## The order rules: steps that can't be done later

| Rule | Why |
|---|---|
| **Nozzle guide before the lock wall** | The guide's channel is open on one side and the wall closes it. Once the wall is in, you can't reach the tube. |
| **LED strips wired before the wall goes in** | Inside the sphere you can't reach to solder |
| **Curtain on the top dish before the dish goes on** | The clamp screws into the dish's underside, which then faces into the sphere |
| **Jack and switch into the tray panel before the deck** | The deck covers their nuts |
| **⚠️ Cables through the bay floor before the plugs** | **This one was missing from the guide; fixed now.** The plug housings are 13 mm wide and the cable hole is 7 mm. Fit the plugs first and they'd never go through. So: thread the lock cable and LED leads down through the bay floor *before* fitting the lantern-side plug halves. The bay floor then rides on the cables until final assembly. |
| **Firmware tested before final assembly** | Debugging a closed lantern means taking it apart |

**One more guide fix:** the nozzle step still said to "thread" the tube through the guide. With the new 135° bend, you push it through the foot's hole, then **press it into the open channel** along the curve, so 5 mm sticks out pointing down. I've updated that step too.

I chose the instruction fix for the cables over redesigning the hole. A slot big enough for the plugs doesn't fit there: further out it would be blocked by the lower dish's ring. The only cost is that if you ever replace the lock, you'd have to re-solder one plug.

All three guide changes are pushed.

**Next is step 9, the last one: using it**: calibration, the performance routine, refilling, cleaning and storage. Ready?

---

### Kevin

yes

### Claude

Checking the cleaning step against the new nozzle, I found that `cal 20000` would pour about 55 mL, which overflows the 1.5 oz glass (only that glass fits under the nozzle). Fixing the guide.

### Claude

# Step 9: Using it

Checking these routines against the current design turned up one more problem, now fixed in the guide. The cleaning step said to run the pump for 20 s, which pours about 55 mL. Only the 1.5 oz glass (~44 mL) fits under the nozzle, so it would overflow into the glass slot. Cleaning now uses short 8 s runs, emptying the glass between them. I also added a battery check to the before-the-party list.

## 1. First-time setup (once, after assembly)
1. **Battery calibration:**
   - Switch on and measure across the pack with your meter.
   - Type `vcal` and the reading, e.g. `vcal 12.31`.
   - `status` should now agree with the meter. This calibration saves itself.
2. **Prime the tube:**
   - Put water in the jar and the glass in its slot.
   - Run `cal 6000` until water reaches the nozzle. The tube holds only about 6 mL.
   - From then on the tube stays full, because the pump's rollers seal it whenever the pump is stopped.

## 2. Calibration: time first, then volume
The pour time and the pour volume are **separate settings**:
- `pour` sets how long the pump runs, which is also how long the light builds.
- `speed` sets how fast the pump runs during that time, so it decides how much it pours.

```
pour 11000     match the build-up to your oath (time how long you take to say it)
cal 11000      pour for that long at the current speed; measure the volume
speed 60       too much? lower it (too little? raise it), cal 11000 again
save           once it pours 30-37 mL (1 to 1.25 oz)
```

- **Why split them:** the show's timing should match your oath. If one setting controlled both, getting the volume right would change the timing.
- **Then repeat with the real drink.** Liqueur is thicker than water, so it pours a little less at the same speed.
- **Keep the speed at 80 % or lower.** That leaves the firmware room to boost the pump as the battery drains.

## 3. Before a party
- **Battery:** `status` should read about **11.5 V or more** (roughly half charge). Below that, charge first: switch off and plug the charger into the jack. The double blink at 10.5 V is a late warning, not a reminder to charge.
- **Fill:**
  1. Undo the 3 thumbscrews and lift the lantern off.
  2. Unscrew the lid and fill the jar.
  3. Put the lid back on and the lantern back on.
- **Test:** one or two pours into the glass. That primes the line with the real drink and confirms everything works.
- **Set up:**
  1. Push the empty glass back under the lock until it clicks.
  2. Switch on. You'll see one blink, then darkness: it's ready.

## 4. The performance
1. **Punch in.** The ring seats and the **lantern glows faintly**. That's your cue that it's armed.
   - No glow? The ring isn't seated. Pull back and punch again.
   - **A double blink first means low battery.** The pour still works, but charge afterwards.
2. **Twist counterclockwise and hold** as you start the oath. You'll feel the switch click just before the stop. The pump starts and the light climbs.
3. **Keep holding through the oath.** After ~11 s the pour is done and the light holds at 90 %, so a longer oath is fine.
4. **On the last word, let the ring turn back.** The light swells to full and goes dark.
5. **Take the glass:** draw your fist back and open your hand.
   1. Grip the front of the glass.
   2. **Slide it ~3 cm toward you** before lifting. Lifting early hits the lock.
   3. Lift it out through the curtain.

**For the next pour:** the lantern stays locked until the ring comes out. Pull your fist out, put an empty glass back, and punch in again. Each ring insertion gives exactly one pour.

**If you let go early,** the pump stops at once, the light swells a little and goes dark. It won't resume; re-insert the ring for a fresh pour.

## 5. After the party
- **Clean the same night:**
  1. Warm water in the jar.
  2. `cal 8000` four or five times, emptying the glass each time.
  3. Twice more with the pickup tube lifted out of the water, to push the line empty.
  4. Rinse the jar, the lid and the vent valve.
- **Never leave liqueur in the tube overnight.** Sugar dries in the bore and on the rollers.
- **Storage:**
  - Open the pump head so the tube isn't squeezed flat for months.
  - Switch off.
  - Charge it to about half if it'll sit for a long time. Li-ion packs age least when stored half charged.
- **Replace the pump tube** when it looks cloudy or flattened. It's the part that wears.

## Quick troubleshooting
| You see | Do |
|---|---|
| Nothing when you punch in | Is the power switch on? Is the ring seated? `status`: `ring=present`? |
| Glow, but no pour on the twist | The switch must click before the stop: slide the switch bracket toward the cam |
| Double blink | Battery under 10.5 V: charge |
| Pour misses the glass | The glass isn't pushed all the way back (it must click) |
| Pours shrinking over a few in a row | The vent valve is in backwards or blocked |
| Drips after the pour | Re-cut the tube end square; 5 mm should stick out |

`★ Insight ─────────────────────────────────────`
- **Most of the reliability comes from the routine, not the parts:** charge to half or more, prime with a test pour, glass clicked in, clean the same night. The design makes each step quick, which is why the lantern lifts off and the battery charges through an outside jack.
- **The failure you'd most likely see on the night is the glass not clicked in.** That's why the ridge click exists: it's a check you can feel.
`─────────────────────────────────────────────────`

---

## That completes the walkthrough

Things to confirm with the real parts, in the order you'll meet them:
1. **Your shot glass** in the printed `glass_well`.
2. **The lock:** `FIT`, spring stiffness and the switch click point.
3. **Your jack and switch** in the tray's panel holes.
4. **The pump's real size** against its estimated space (the Kamoer publishes no drawing).
5. **Light balance** between the two sides. The dimmable display-side channel can be added later without reprinting.
6. **The 20-pour water test** before the first party.

Everything from today is pushed to [PR #1](https://github.com/TheRageKage12/temprepo/pull/1). That includes the nozzle redesign, the vent valve, and the guide fixes found during the walkthrough: the cable threading order, the nozzle step, the step order in section 7, the cleaning runs, and the battery check.

I can also put together a consolidated shopping list split by store (Amazon, Vetco, Tacoma Screw, a pet store), so it's ready to order.

---

### Kevin

yes, make the shopping list by store

### Claude

Here's the shopping list grouped by store, about $180 in total. I've sent the file, which has tick boxes and links. It's also saved as `docs/SHOPPING_LIST.md`, linked from the build guide, and pushed to the PR.

**Amazon, one order (~$124)**
- Kamoer KPHM200 pump, $28
- AUBER 1/8" x 1/4" silicone tube, $14. It must be exactly this size; thinner tube won't pump.
- KBT 12 V battery pack, $22
- XIAO RP2040, ~$10
- 12 V green LED strip, ~$12
- LM2596 buck converter, ~$8
- 6 x 2 mm magnets, ~$7
- JST-SM plug kit, ~$7
- Aquaneat check valves, ~$6
- Frosted PP sheets, ~$10

**Adafruit (optional, ~$13 with shipping)**
- DRV5032 Hall sensor. Or skip this order and get an A3144 at Vetco.

**Vetco, Bellevue (~$30). Bring calipers.**
- D2F-L-size lever microswitch
- 74AHCT125. It must be **AHCT**, not HC.
- 2 x IRLZ44N MOSFETs
- Mini toggle switch
- DC5521 panel-mount jack. Also a male DC5521 lead if the battery didn't come with one.
- 0.5 x 5 x 10 mm spring
- Small parts:
  - 2 x 1N5819 diodes
  - resistors: 2 x 10 k, 100 k, 22 k
  - 2 x 0.1 µF and 1 x 2200 µF capacitors
  - perfboard, a 14-pin DIP socket, wire, heat-shrink

**Tacoma Screw, Ballard (~$12)**
- 5 x M3x6, 11 x M3x8, 4 x M3x8 countersunk, 6 x M3x10, 20 x M3x12, 15 nuts

**Anywhere:** super glue.

**Only if you don't already have them:** PETG, the jar (max 76 x 76 mm), the 1.5 oz shot glass (max 52 mm across the top), and the tools.

I can also turn the list into a web page with tick boxes that stay ticked, so you can use it on your phone in the store.

---

### Kevin

Could you add links to all of these items as well?

### Claude

The Vetco store has a searchable product feed, so I'll pull real product links for each local item.

### Claude

Vetco and Tacoma Screw links found. Vetco's toggle switch needs a 1/4" (6.35 mm) hole, but the CAD panel hole is 6.2 mm, so I'm widening it to 6.5 mm and rebuilding.

### Claude

Every item on the shopping list now has a link, and the updated file is pushed and sent. The new total is **about $200**, up from the earlier $180 estimate.

**Where the links point**
- **Vetco:** a direct product page for each part. I took them from Vetco's own website, with current prices, and all were in stock.
- **Tacoma Screw:** the exact M3 screw and nut items on their website, so you can show them at the counter. The website sells boxes of 100; the Ballard store sells by the piece.
- **Amazon:** a product page where we picked a specific listing. The rest (LED strip, buck converter, glue, filament, jar, shot glass, tools) are searches marked *search*, with the spec to look for next to each.

**What changed along the way**
- **Power switch hole is now 6.5 mm.** Vetco's mini toggle switch needs a 1/4" (6.35 mm) hole, and the switch hole in the base was 6.2 mm, too small. The new 6.5 mm hole fits both 1/4" and 6 mm switches. The CAD is rebuilt and its checks pass.
- **Charge jack:** Vetco's 2.1 mm panel jack needs an 8 mm hole, which matches the design as it is.
- **Microswitch moved to Amazon** (the 4-pack). Vetco's lever switches don't list their sizes, and the lock needs the D2F-L size.
- **MOSFET page mismatch:** Vetco's page title says IRLZ44N but its web address says IRLB8721. Either one works here, and they have the same pin order.
- **No soldering for the battery lead:** if the battery doesn't come with a bare-wire lead, Vetco has a 2.1 mm plug with screw terminals for $2.85.
- **Why the total went up:**
  - Vetco's real prices, especially wire, came in a little higher than my estimates.
  - The microswitch is now an ~$8 4-pack instead of a ~$3 single.
  - The toggle switch with leads is $4.95.

---

### Kevin

now post it here in a table

### Claude

## Amazon (~$132)

| Qty | Item | Link | Price |
|---|---|---|---|
| 1 | Pump, Kamoer KPHM200 12 V | [B09HGVLHFV](https://www.amazon.com/dp/B09HGVLHFV) | $28 |
| 1 | Silicone tube, 1/8" ID x 1/4" OD, 10 ft (exactly this size) | [B0DKB1NKB4](https://www.amazon.com/dp/B0DKB1NKB4) | $14 |
| 1 | KBT 12 V 1200 mAh battery with charger | [B0C241NS29](https://www.amazon.com/dp/B0C241NS29) | $22 |
| 1 | Seeed XIAO RP2040, pre-soldered | [B0DRNTQ338](https://www.amazon.com/dp/B0DRNTQ338) | ~$10 |
| 1 | Lever microswitch, D2F-L size, 4-pack | [B0DBV8XGG4](https://www.amazon.com/dp/B0DBV8XGG4) | ~$8 |
| 1 | 12 V green LED strip (2835, 60/m, 8 mm, single colour) | [search](https://www.amazon.com/s?k=12V+green+LED+strip+single+color+2835+60+LED) | ~$12 |
| 1 | LM2596 buck converter, multipack | [search](https://www.amazon.com/s?k=LM2596+buck+converter+module) | ~$8 |
| 1 | 6 x 2 mm magnets, 45-pack | [B0CBRVF4PN](https://www.amazon.com/dp/B0CBRVF4PN) | ~$7 |
| 1 | JST-SM 2-pin + 4-pin plug kit | [search](https://www.amazon.com/s?k=JST+SM+2+pin+4+pin+connector+kit) | ~$7 |
| 1 | Aquaneat check valves, 10-pack | [search](https://www.amazon.com/s?k=Aquaneat+aquarium+check+valve+one+way) | ~$6 |
| 1 | Frosted PP sheets, 0.5 mm | [B0FM3YRGG4](https://www.amazon.com/dp/B0FM3YRGG4) | ~$10 |

## Adafruit (optional, ~$13 with shipping)

| Qty | Item | Link | Price |
|---|---|---|---|
| 1 | DRV5032 Hall sensor (or the A3144 from Vetco, below) | [#6051](https://www.adafruit.com/product/6051) | $4.95 + ~$8 shipping |

## Vetco, Bellevue (~$37)

| Qty | Item | Link | Price |
|---|---|---|---|
| 1 | 74AHCT125 (must be **AHCT**) | [VUPN524](https://vetco.net/products/vupn524_quad_level-shifter_-_74ahct125_-_3v_to_5v_d96) | $2.95 |
| 2 | IRLZ44N MOSFET | [VUPN1682](https://vetco.net/products/vupn1682_mosfet_mosft_for_micro_controllers_-_30v_-_60a_-_irlb8721pbf_d151) | $2.67 each |
| 1 | SPST mini toggle switch with leads | [30-10005](https://vetco.net/products/30-10005_spst_miniature_toggle_switch_w-wire_leads_on-off_6a) | $4.95 |
| 1 | 2.1 mm DC panel jack (8 mm hole) | [2112](https://vetco.net/products/2112_2-1mm_dc_power_panel_mount_jack) | $2.88 |
| 0-1 | 2.1 mm plug, screw terminals (only if the battery has no bare-wire lead) | [CD022](https://vetco.net/products/cd022_2-1mm_dc_power_inline_plug_-_solderless_w-screw_terminals) | $2.85 |
| 1 | Hillman spring, about 0.5 mm wire x 5 mm OD x 10 mm long (bring calipers) | [search](https://vetco.net/search?q=hillman+compression+spring) | ~$1.29 |
| 2 | 1N5819-type Schottky diode (NTE585) | [NTE585](https://vetco.net/products/nte585_40_volt_1a_schottky_rectifier_do41_-_nte585) | $0.94 each |
| 2 | 10 k resistor | [link](https://vetco.net/products/nte-qw310_10k_ohm_1-4_watt_resistor) | $0.29 each |
| 1 | 100 k resistor | [link](https://vetco.net/products/nte-qw410_100k_ohm_1-4_watt_resistor) | $0.29 |
| 1 | 22 k resistor | [link](https://vetco.net/products/nte-qw322_22k_ohm_1-4_watt_resistor) | $0.29 |
| 2 | 0.1 µF ceramic capacitor | [link](https://vetco.net/products/vupn6606_ceramic_capacitor_0-1_uf_-2080_50_volts_z5u) | $0.25 each |
| 1 | 2200 µF 16 V capacitor | [link](https://vetco.net/products/2200uf16vdc_2200uf_16_volt_electrolytic_capacitor) | $2.80 |
| 1 | 5 x 7 cm protoboard | [link](https://vetco.net/products/phenolic-protoboard-1-97-x-2-76-inch) | $3.49 |
| 1 | 14-pin IC socket | [link](https://vetco.net/products/14-pin-ic-socket-2-54mm-spacing-0-1) | $1.95 |
| 1 | 22 AWG stranded wire | [link](https://vetco.net/products/hookup_wire_stranded_22_ga) | $5.37 |
| 1 | 1/8" heat-shrink, 4 ft | [link](https://vetco.net/products/1-8_heat_shrink_tubing_4_long) | $1.69 |
| 0-1 | A3144 Hall sensor (only if skipping Adafruit) | [VUPN6596](https://vetco.net/products/vupn6596_hall-effect_sensor_-_allegro_a3144eua_d63) | $1.99 |

## Tacoma Screw, Ballard (~$12, by the piece)

| Qty | Item | Link |
|---|---|---|
| 5 | M3 x 6 socket head | [223-306-3](https://www.tacomascrew.com/Product/223-306-3) |
| 11 | M3 x 8 socket head | [223-308-3](https://www.tacomascrew.com/Product/223-308-3) |
| 4 | M3 x 8 flat head (countersunk) | [224-308-4](https://www.tacomascrew.com/Product/224-308-4) |
| 6 | M3 x 10 socket head | [223-310-3](https://www.tacomascrew.com/Product/223-310-3) |
| 20 | M3 x 12 socket head | [223-312-3](https://www.tacomascrew.com/Product/223-312-3) |
| 15 | M3 hex nut | [231-003-1](https://www.tacomascrew.com/Product/231-003-1) |

You can also get all of these in one [Amazon M3 kit (B0HKFCTLK8)](https://www.amazon.com/dp/B0HKFCTLK8) for ~$18.

## Anywhere

| Qty | Item | Link | Price |
|---|---|---|---|
| 1 | Super glue, gel | [search](https://www.amazon.com/s?k=super+glue+gel+control) | ~$5 |

## Only if you don't have them

| Item | Spec | Link |
|---|---|---|
| Green PETG | ~0.85 kg | [search](https://www.amazon.com/s?k=PETG+filament+1.75mm+green+1kg) |
| White PETG | A little, for the diffusers | [search](https://www.amazon.com/s?k=PETG+filament+1.75mm+white+1kg) |
| Jar | At most 76 x 76 mm, 70-400 cap | [search](https://www.amazon.com/s?k=8+oz+straight+sided+PET+jar+70-400) or [Micro Homebrew](https://www.microhomebrew.com/) |
| Shot glass | 1.5 oz, at most 52 mm across the top | [search](https://www.amazon.com/s?k=Libbey+1.5+oz+shot+glass) or [Bargreen](https://www.bargreen.com/locations/seattle) |
| Soldering iron | | [search](https://www.amazon.com/s?k=soldering+iron+kit+temperature+control) |
| Multimeter | | [search](https://www.amazon.com/s?k=digital+multimeter) |
| Calipers | | [search](https://www.amazon.com/s?k=digital+calipers+150mm) |
| Drill bits | 2.5 mm and 6 mm | [search](https://www.amazon.com/s?k=metric+drill+bit+set+1-10mm) |
| Flush cutters | | [search](https://www.amazon.com/s?k=flush+cutters) |

**Total: about $200** (Amazon ~$132, Adafruit ~$13, Vetco ~$37, Tacoma Screw ~$12, glue ~$5).

---

### Kevin

dont include adrafruit here

### Claude

Removing Adafruit means the Hall sensor has to be the A3144 from Vetco. Checking that swap, I found the guide's A3144 note was wrong in two places, so I'm fixing that too.

### Claude

Here's the list without Adafruit. The ring sensor is now the **A3144 from Vetco**. I've updated the shopping list file and the guide to match, and pushed both.

## Amazon (~$132)

| Qty | Item | Link | Price |
|---|---|---|---|
| 1 | Pump, Kamoer KPHM200 12 V | [B09HGVLHFV](https://www.amazon.com/dp/B09HGVLHFV) | $28 |
| 1 | Silicone tube, 1/8" ID x 1/4" OD, 10 ft (exactly this size) | [B0DKB1NKB4](https://www.amazon.com/dp/B0DKB1NKB4) | $14 |
| 1 | KBT 12 V 1200 mAh battery with charger | [B0C241NS29](https://www.amazon.com/dp/B0C241NS29) | $22 |
| 1 | Seeed XIAO RP2040, pre-soldered | [B0DRNTQ338](https://www.amazon.com/dp/B0DRNTQ338) | ~$10 |
| 1 | Lever microswitch, D2F-L size, 4-pack | [B0DBV8XGG4](https://www.amazon.com/dp/B0DBV8XGG4) | ~$8 |
| 1 | 12 V green LED strip (2835, 60/m, 8 mm, single colour) | [search](https://www.amazon.com/s?k=12V+green+LED+strip+single+color+2835+60+LED) | ~$12 |
| 1 | LM2596 buck converter, multipack | [search](https://www.amazon.com/s?k=LM2596+buck+converter+module) | ~$8 |
| 1 | 6 x 2 mm magnets, 45-pack | [B0CBRVF4PN](https://www.amazon.com/dp/B0CBRVF4PN) | ~$7 |
| 1 | JST-SM 2-pin + 4-pin plug kit | [search](https://www.amazon.com/s?k=JST+SM+2+pin+4+pin+connector+kit) | ~$7 |
| 1 | Aquaneat check valves, 10-pack | [search](https://www.amazon.com/s?k=Aquaneat+aquarium+check+valve+one+way) | ~$6 |
| 1 | Frosted PP sheets, 0.5 mm | [B0FM3YRGG4](https://www.amazon.com/dp/B0FM3YRGG4) | ~$10 |

## Vetco, Bellevue (~$40)

| Qty | Item | Link | Price |
|---|---|---|---|
| 1 | A3144 Hall sensor | [VUPN6596](https://vetco.net/products/vupn6596_hall-effect_sensor_-_allegro_a3144eua_d63) | $1.99 |
| 1 | 74AHCT125 (must be **AHCT**) | [VUPN524](https://vetco.net/products/vupn524_quad_level-shifter_-_74ahct125_-_3v_to_5v_d96) | $2.95 |
| 2 | IRLZ44N MOSFET | [VUPN1682](https://vetco.net/products/vupn1682_mosfet_mosft_for_micro_controllers_-_30v_-_60a_-_irlb8721pbf_d151) | $2.67 each |
| 1 | SPST mini toggle switch with leads | [30-10005](https://vetco.net/products/30-10005_spst_miniature_toggle_switch_w-wire_leads_on-off_6a) | $4.95 |
| 1 | 2.1 mm DC panel jack (8 mm hole) | [2112](https://vetco.net/products/2112_2-1mm_dc_power_panel_mount_jack) | $2.88 |
| 0-1 | 2.1 mm plug, screw terminals (only if the battery has no bare-wire lead) | [CD022](https://vetco.net/products/cd022_2-1mm_dc_power_inline_plug_-_solderless_w-screw_terminals) | $2.85 |
| 1 | Hillman spring, about 0.5 mm wire x 5 mm OD x 10 mm long (bring calipers) | [search](https://vetco.net/search?q=hillman+compression+spring) | ~$1.29 |
| **3** | 1N5819-type Schottky diode (NTE585) | [NTE585](https://vetco.net/products/nte585_40_volt_1a_schottky_rectifier_do41_-_nte585) | $0.94 each |
| 2 | 10 k resistor | [link](https://vetco.net/products/nte-qw310_10k_ohm_1-4_watt_resistor) | $0.29 each |
| 1 | 100 k resistor | [link](https://vetco.net/products/nte-qw410_100k_ohm_1-4_watt_resistor) | $0.29 |
| 1 | 22 k resistor | [link](https://vetco.net/products/nte-qw322_22k_ohm_1-4_watt_resistor) | $0.29 |
| 2 | 0.1 µF ceramic capacitor | [link](https://vetco.net/products/vupn6606_ceramic_capacitor_0-1_uf_-2080_50_volts_z5u) | $0.25 each |
| 1 | 2200 µF 16 V capacitor | [link](https://vetco.net/products/2200uf16vdc_2200uf_16_volt_electrolytic_capacitor) | $2.80 |
| 1 | 5 x 7 cm protoboard | [link](https://vetco.net/products/phenolic-protoboard-1-97-x-2-76-inch) | $3.49 |
| 1 | 14-pin IC socket | [link](https://vetco.net/products/14-pin-ic-socket-2-54mm-spacing-0-1) | $1.95 |
| 1 | 22 AWG stranded wire | [link](https://vetco.net/products/hookup_wire_stranded_22_ga) | $5.37 |
| 1 | 1/8" heat-shrink, 4 ft | [link](https://vetco.net/products/1-8_heat_shrink_tubing_4_long) | $1.69 |

## Tacoma Screw, Ballard (~$12, by the piece)

| Qty | Item | Link |
|---|---|---|
| 5 | M3 x 6 socket head | [223-306-3](https://www.tacomascrew.com/Product/223-306-3) |
| 11 | M3 x 8 socket head | [223-308-3](https://www.tacomascrew.com/Product/223-308-3) |
| 4 | M3 x 8 flat head (countersunk) | [224-308-4](https://www.tacomascrew.com/Product/224-308-4) |
| 6 | M3 x 10 socket head | [223-310-3](https://www.tacomascrew.com/Product/223-310-3) |
| 20 | M3 x 12 socket head | [223-312-3](https://www.tacomascrew.com/Product/223-312-3) |
| 15 | M3 hex nut | [231-003-1](https://www.tacomascrew.com/Product/231-003-1) |

You can also get all of these in one [Amazon M3 kit (B0HKFCTLK8)](https://www.amazon.com/dp/B0HKFCTLK8) for ~$18.

## Anywhere

| Qty | Item | Link | Price |
|---|---|---|---|
| 1 | Super glue, gel | [search](https://www.amazon.com/s?k=super+glue+gel+control) | ~$5 |

## Only if you don't have them

| Item | Spec | Link |
|---|---|---|
| Green PETG | ~0.85 kg | [search](https://www.amazon.com/s?k=PETG+filament+1.75mm+green+1kg) |
| White PETG | A little, for the diffusers | [search](https://www.amazon.com/s?k=PETG+filament+1.75mm+white+1kg) |
| Jar | At most 76 x 76 mm, 70-400 cap | [search](https://www.amazon.com/s?k=8+oz+straight+sided+PET+jar+70-400) or [Micro Homebrew](https://www.microhomebrew.com/) |
| Shot glass | 1.5 oz, at most 52 mm across the top | [search](https://www.amazon.com/s?k=Libbey+1.5+oz+shot+glass) or [Bargreen](https://www.bargreen.com/locations/seattle) |
| Soldering iron | | [search](https://www.amazon.com/s?k=soldering+iron+kit+temperature+control) |
| Multimeter | | [search](https://www.amazon.com/s?k=digital+multimeter) |
| Calipers | | [search](https://www.amazon.com/s?k=digital+calipers+150mm) |
| Drill bits | 2.5 mm and 6 mm | [search](https://www.amazon.com/s?k=metric+drill+bit+set+1-10mm) |
| Flush cutters | | [search](https://www.amazon.com/s?k=flush+cutters) |

**Total: about $190** (Amazon ~$132, Vetco ~$40, Tacoma Screw ~$12, glue ~$5).

## What the A3144 swap changes
The DRV5032 doesn't seem to be sold on Amazon, so the Vetco A3144 is the sensor now. It costs less, but it's a weaker fit:
- **It needs a third 1N5819** (added above), because it runs on 5 V. The diode lets the sensor signal the controller without putting 5 V on its 3.3 V pin.
- **It reacts to only one pole of the magnet.** Before gluing the magnet into the key cap, check which face switches the sensor on.
- **It's less sensitive, and the margin is thin.**
  - **The fix in the guide didn't fit.** The guide said to stack two magnets, but the key cap's pocket only holds one. The guide now says to mount the sensor right under the rotor instead.
  - **Expected field:** my estimate is about 30 mT at the sensor with one magnet. Most A3144s switch well below that, but the datasheet allows up to 35 mT.
  - **What to do:** test it when you build the lock first. That's an evening of work, before any big print.
  - **If it doesn't trigger,** Jameco also sells the DRV5032 (not Adafruit), linked in the guide.

The wiring diagram still shows the DRV5032. The guide now has the A3144 wiring as text: 5 V, ground, and the output through the diode to D1.

Sources:
- [Jameco: DRV5032 breakout #6051](https://www.jameco.com/z/6051-Adafruit-Industries-ScoutMakes-DRV5032-Digital-Magnetic-Hall-Effect-Sensor_2883071.html)
- [Adafruit learning guide for the DRV5032 breakout](https://learn.adafruit.com/scoutmakes-drv5032-hall-sensor/overview)

---

### Kevin

How can we get the hall sensor to be more reliable? The Jameco link isn't viable because it ships too late

### Claude

The best fix is to **move the sensor much closer to the magnet**. It only needs printed-part changes and still uses the $2 Vetco A3144.

## Why the A3144 is marginal now
A magnet's field drops off very steeply with distance. In the current design the sensor sits about 5.5 mm from the magnet, through the rotor's 4.5 mm solid floor. That gives roughly 30 mT, by my estimate, and the A3144's datasheet allows a switch-on point of up to 35 mT. So some A3144s would trigger and some wouldn't.

## The fix: a sensor post
- **Rotor:** a 7 mm hole drilled up into the underside of the rotor's centre, stopping 1 mm below the magnet. The pocket your ring sits in stays closed on top.
- **Base plate:** a small round **post** rises from the base plate into that hole, with the A3144 lying face-up in a pocket on its tip. The leads run down through the post.
- **The rotor turns around the post.** Both are centred on the rotation axis, so nothing rubs. The magnet is also on the axis, so it spins in place right above the sensor.

| | Now | With the post |
|---|---|---|
| Magnet to sensor | ~5.5 mm | **~3 mm worst case** (less when your punch pushes the rotor back) |
| Field at the sensor | ~30 mT | **~90 mT** |
| vs. the A3144's worst-case switch point (35 mT) | Below it: may not trigger | **About 2.5x above it: every A3144 triggers** |

I left a 1.5 mm gap between the sensor and the rotor's floor. The rotor has about 1.2 mm of play toward the wall, so a hard punch can't crush the sensor.

`★ Insight ─────────────────────────────────────`
- **Close the distance before buying a better part.** Close to a small magnet, the field rises roughly with the cube of how near you get. Going from 5.5 mm to 3 mm triples the field, which is more than a more sensitive sensor would gain.
- **A blind hole keeps the ring pocket sealed.** Drilling from below, rather than through, means crumbs and liquid can't fall onto the sensor. It also prints cleanly: the rotor prints top face down, so the hole opens upward on the printer bed and needs no supports.
`─────────────────────────────────────────────────`

**What else changes:**
- Two lock parts get reprinted: `rotor` and `socket_base`.
- I'd make the sensor choice a setting in the CAD (`HALL_SENSOR = 'A3144'`), so the DRV5032 board version still works if you ever get one.
- I'd update the lock test and re-run all the fit checks.
- In the guide: how the sensor sits on the post, how to check which magnet face triggers it before gluing, and the A3144's 5 V wiring through the diode.
- The A3144 runs on 5 V, so the lock cable's power wire carries 5 V instead of 3.3 V.

**One other step that helps reliability:** the A3144 only reacts to one magnet pole, so the guide's "test which face triggers it before gluing" step matters. With the extra field, the right pole will trigger every time, and the wrong pole won't trigger at all, so it's easy to tell.

Want me to make the change?

---

### Kevin

yes

### Claude

Now the CAD change: a parameter for the sensor type, the blind hole in the rotor, and the post on the base plate.

### Claude

Updating the lock section diagram to show the sensor on its post.

### Claude

Docs updated for the A3144 post. Now the firmware comment and shopping-list note, then rebuild and test everything.

### Claude

Finishing the sensor change first. One thing to fix there: `socket_base` now has a post on its top face, so it has to print bottom-side down. After that I'll redo the links as you asked.

### Claude

The sensor change is pushed. Now the product links. First, checking whether I can read Amazon listings directly (delivery dates and Prime).

### Claude

Progress: the battery listing has several variants, and the 1200 mAh-with-plug one doesn't arrive until November. Checking the other variants' sizes and delivery dates.

### Claude

Got it, I'll use your link (B0C241NS29, the 2400 mAh version). Checking its size and delivery now.

### Claude

Amazon's search pages are now blocking the scripted browser (product pages still load), so I'll find candidate listings with web search and then check each listing directly.

### Claude

Typing into Amazon's search box works (it shows San Francisco delivery dates, which should be close to Seattle's). Running all the searches that way.

### Claude

Good results: almost everything ships from Amazon with Prime delivery by Oct 14-15. Now checking specs for the candidates, plus the items we'd already chosen.

---

### Kevin

That command has been running for a while. Use the results you have already and cancel it

### Claude

Stopped. Here's what the finished checks found, and two choices I need from you before finishing the list.

**Confirmed: specific listing, ships from Amazon (Prime), arrives Oct 14-15:**

| Item | Listing | Price |
|---|---|---|
| Pump | [Kamoer KPHM200 (B09HGVLHFV)](https://www.amazon.com/dp/B09HGVLHFV) | $28.00 |
| Tubing (only 4 left) | [Auber 1/8" x 1/4" platinum silicone (B0DKB1NKB4)](https://www.amazon.com/dp/B0DKB1NKB4) | $13.99 |
| XIAO RP2040 | [Seeed, pre-soldered (B0DRNTQ338)](https://www.amazon.com/dp/B0DRNTQ338) | $10.99 |
| Microswitch, 4-pack | [D2F-L hinge lever (B0DBV8XGG4)](https://www.amazon.com/dp/B0DBV8XGG4) | $8.99 |
| Magnets | [SMARTAKE 6 x 2 mm, 45 pcs (B0CBRVF4PN)](https://www.amazon.com/dp/B0CBRVF4PN) | $6.29 |
| Buck converter, 5-pack | [LM2596 (B0DBVYP91F)](https://www.amazon.com/dp/B0DBVYP91F) | $7.99 |
| Plugs | [JST-SM 4-pin, 20 pairs (B083GR7FQF)](https://www.amazon.com/dp/B083GR7FQF) | $9.99 |
| Super glue | [Loctite Gel Control (B0006HUJCQ)](https://www.amazon.com/dp/B0006HUJCQ), sold by Amazon | $3.82 |
| Spring | [Dianrui kit, 23 sizes (B0BVTDP29W)](https://www.amazon.com/dp/B0BVTDP29W) | $6.99 |

Two changes in that table:
- **Plugs:** I couldn't find a 2-pin pack worth buying, so I'd use two 4-pin plugs (the LED leads simply use two of the four pins). One pack covers both.
- **Spring:** Vetco's Hillman spring size couldn't be confirmed online, so I switched to this kit. It includes a 0.4 x 5 x 10 mm spring, which is the softer fallback size the guide already allows, and likely a 0.5 mm one too.

**Not yet checked** (search results show Prime, Oct 14; I still need to confirm sizes):
- the check valve (AQUANEAT B086JRH4WS)
- the filaments
- the frosted sheets and the M3 kit
- the jar
- the shot glass, which must be no more than 52 mm across the top

Delivery dates are for Amazon's default San Francisco address, so Seattle should be about the same.

**Two problems need your choice:**
1. **Your 2400 mAh pack is 70 x 55 x 40 mm**, twice as thick as the 1200 mAh one. I tested it in the CAD: the deck rises 20 mm, and the fit checks pass, but the jar ends up **0.5 mm** from the lower dish and the pump **1 mm** from it. The pump's size is an estimate (Kamoer publishes no drawing), so that's a real risk.
2. **No green 2835 strip is sold on Amazon.** Both alternatives also draw more current than we planned for:
   - **COB strip** ([HAMRVL, B0CKYFLZFQ](https://www.amazon.com/dp/B0CKYFLZFQ), $14.99, Oct 14): 8 mm wide, so it fits the existing channels. It glows evenly with no visible dots, and cuts every 25 mm. Its current isn't listed; COB strips like this usually draw about 0.6 A for our 75 cm.
   - **5050 strip** ([B09T6Z2ZS1](https://www.amazon.com/dp/B09T6Z2ZS1), $9.99, Oct 15): 10 mm wide, so the LED channels would need widening. Probably about 0.9 A.

   Either one pushes the peak draw to roughly 1.3-1.6 A. That's more than the 1200 mAh pack's 1.2 A rating, which supports your choice of the bigger pack.

### Claude

Going with the 2400 mAh pack (deck raised) and the 8 mm green COB strip. First, quick checks on the remaining listings, kept short this time.

### Claude

Meanwhile, the CAD change for the 40 mm pack.

### Claude

Checking the last 8 listings in parallel (about 2 minutes). Meanwhile, updating the guide for the COB strip and the bigger battery.

### Claude

Amazon has started throttling my checks, so I'll stop scraping and work with what's verified. Committing the battery and LED changes first.

### Claude

The shopping list now links every item to a specific listing, and the design is updated for the battery and LED strip you chose. Both are pushed to [PR #1](https://github.com/TheRageKage12/temprepo/pull/1).

**Amazon, one order (~$149).** The delivery dates are what Amazon showed for its default San Francisco address on Oct 13; Seattle should be about the same.

| Item | Listing | Price | Delivery |
|---|---|---|---|
| Pump | [Kamoer KPHM200 (B09HGVLHFV)](https://www.amazon.com/dp/B09HGVLHFV) | $28.00 | Prime, Oct 15 |
| Tubing (only 4 left) | [Auber 1/8" x 1/4" (B0DKB1NKB4)](https://www.amazon.com/dp/B0DKB1NKB4) | $13.99 | Prime, Oct 14 |
| Battery, 2400 mAh | [KBT (B0C241NS29)](https://www.amazon.com/dp/B0C241NS29) | $21.99 | Prime, Oct 14 |
| XIAO RP2040 | [Seeed (B0DRNTQ338)](https://www.amazon.com/dp/B0DRNTQ338) | $10.99 | Prime, Oct 14 |
| Microswitch, 4-pack | [D2F-L (B0DBV8XGG4)](https://www.amazon.com/dp/B0DBV8XGG4) | $8.99 | Prime, Oct 14 |
| Green COB LED strip, 8 mm | [HAMRVL (B0CKYFLZFQ)](https://www.amazon.com/dp/B0CKYFLZFQ) | $14.99 | Prime, Oct 14 |
| LM2596 buck converter, 5-pack | [Seloky (B0DBVYP91F)](https://www.amazon.com/dp/B0DBVYP91F) | $7.99 | Prime, Oct 14 |
| Magnets | [SMARTAKE 6 x 2 mm (B0CBRVF4PN)](https://www.amazon.com/dp/B0CBRVF4PN) | $6.29 | Prime, Oct 14 |
| JST-SM 4-pin plugs, 20 pairs | [mxuteuk (B083GR7FQF)](https://www.amazon.com/dp/B083GR7FQF) | $9.99 | Prime, Oct 14 |
| Check valves | [AQUANEAT (B086JRH4WS)](https://www.amazon.com/dp/B086JRH4WS) | $4.79 | Prime, Oct 14 |
| Spring assortment | [Dianrui (B0BVTDP29W)](https://www.amazon.com/dp/B0BVTDP29W) | $6.99 | Prime, Oct 14 |
| Super glue gel | [Loctite (B0006HUJCQ)](https://www.amazon.com/dp/B0006HUJCQ) | $3.82 | Sold by Amazon |
| Frosted PP sheets | [COYOUCO (B0FM3YRGG4)](https://www.amazon.com/dp/B0FM3YRGG4) | ~$10 | Not re-checked |

The Vetco and Tacoma Screw lists haven't changed, except that the spring moved to Amazon. The optional filament and tools also have specific listings now; they're in the file.

**Design changes for your two choices:**
- **Battery:** the 2400 mAh pack is 40 mm thick, so the deck now sits 18 mm higher. The fit checks pass, but the room left over is thin:
  - **Pump:** its top corner is about **1 mm** from the lower dish. That's measured from my *estimate* of the pump's size, because Kamoer doesn't publish one. When the pump arrives (Oct 15), measure its head before printing `base` and `dish_lower`. If it's bigger than 64 x 63 mm, tell me and I'll adjust.
  - **Jar:** about 2 mm of room, as long as the jar is at most **73 mm across, lid included**. I've tightened the guide's jar size limit to match.
- **COB strip:**
  - **Cutting:** it cuts every 25 mm, so the plan is now 7 pieces (four of 10 cm, two of 5 cm, one 25 cm piece for the top ring). That's fewer solder joints than before.
  - **Current:** about 0.6 A by my estimate; the listing doesn't say.
- **Plugs:** two 4-pin plugs replace the 2-pin and 4-pin pair.

**Amazon stopped my checks partway through,** so two items still need your choice:

### Claude

Noted: you'll buy the jar at Micro Homebrew and the shot glass at Bargreen, measuring both in the store. On widening the lantern, I'm checking how the base and dish sizes are set in the CAD.

### Claude

The pump now has **6 mm** and the jar **5.4 mm** of room, up from 1 and 0.5. One thing to check: the handle now touches the wider upper dish, so I'm comparing that with the original size.

### Claude

Splitting the dish cone so the lower dish widens and the upper one stays at 180 mm.

### Claude

Yes, widening fixed it. I widened the **base and lower dish by 10 mm (180 → 190 mm)** and left the upper dish at 180 mm. The fit checks pass with no problems, and it's pushed to [PR #1](https://github.com/TheRageKage12/temprepo/pull/1).

| Gap to the lower dish | Before | Now |
|---|---|---|
| Pump | 1.0 mm | **6.0 mm** |
| Jar | 0.5 mm | **5.4 mm** |

**Why the upper dish stays at 180 mm:**
- The handle legs run right past the upper dish's rim. Widening it made them touch.
- Moving the handle out to make room would push `sphere_rear` to about 231 mm wide, which is too big for your Ender 3.

So the bottom half is now about 5 mm wider on each side than the top. You can see it in the render I sent; the original Hedo3D model also flares out toward the base. If you'd rather they match exactly, the other choice is a slimmer handle, which needs some redesign.

The 6 mm gap means a pump somewhat bigger than my size estimate will still fit. It's still worth checking the pump when it arrives on Oct 15, before printing the base.

**Other updates:**
- **Part list:** about 850 g of PETG now, so the shopping list says **2 spools of green** (Creality, $13.99 each).
- **Jar and shot glass:** listed under "Buy locally" with their size limits:
  - jar: at most 73 mm across with the lid and 76 mm tall (Micro Homebrew)
  - shot glass: at most 52 mm across the top and 62 mm tall (Bargreen)
- **No Amazon search links remain** anywhere in the guide or shopping list. The power switch and charge jack rows now link straight to their Vetco pages.

The shopping list file (`docs/SHOPPING_LIST.md`) has all the links and delivery dates.

---

### Kevin

cool, now show me the full list, costs, and estimated total

### Claude

Here's the full list with prices. Amazon prices and delivery dates are as listed on Oct 13, Vetco's are from its website, and the rest are estimates. Sales tax isn't included.

## Amazon: one order, $148.82 (free shipping, Prime delivery Oct 14-15)

| Item | Listing | Price |
|---|---|---|
| Pump, Kamoer KPHM200 12 V | [B09HGVLHFV](https://www.amazon.com/dp/B09HGVLHFV) | $28.00 |
| Battery, KBT 12 V 2400 mAh with charger | [B0C241NS29](https://www.amazon.com/dp/B0C241NS29) | $21.99 |
| Green COB LED strip, 12 V, 8 mm, 5 m | [B0CKYFLZFQ](https://www.amazon.com/dp/B0CKYFLZFQ) | $14.99 |
| Silicone tube, 1/8" x 1/4", 10 ft (only 4 left) | [B0DKB1NKB4](https://www.amazon.com/dp/B0DKB1NKB4) | $13.99 |
| Seeed XIAO RP2040, pre-soldered | [B0DRNTQ338](https://www.amazon.com/dp/B0DRNTQ338) | $10.99 |
| Frosted PP sheets, 0.5 mm (curtain) | [B0FM3YRGG4](https://www.amazon.com/dp/B0FM3YRGG4) | ~$10.00 |
| JST-SM 4-pin plug pairs, 20 pairs | [B083GR7FQF](https://www.amazon.com/dp/B083GR7FQF) | $9.99 |
| D2F-L lever microswitch, 4-pack | [B0DBV8XGG4](https://www.amazon.com/dp/B0DBV8XGG4) | $8.99 |
| LM2596 buck converter, 5-pack | [B0DBVYP91F](https://www.amazon.com/dp/B0DBVYP91F) | $7.99 |
| Spring assortment | [B0BVTDP29W](https://www.amazon.com/dp/B0BVTDP29W) | $6.99 |
| 6 x 2 mm magnets, 45 pcs | [B0CBRVF4PN](https://www.amazon.com/dp/B0CBRVF4PN) | $6.29 |
| Aquarium check valves, 10 pcs | [B086JRH4WS](https://www.amazon.com/dp/B086JRH4WS) | $4.79 |
| Loctite super glue gel | [B0006HUJCQ](https://www.amazon.com/dp/B0006HUJCQ) | $3.82 |

## Vetco, Bellevue: $37.89

| Qty | Item | Link | Cost |
|---|---|---|---|
| 1 | A3144 Hall sensor | [VUPN6596](https://vetco.net/products/vupn6596_hall-effect_sensor_-_allegro_a3144eua_d63) | $1.99 |
| 1 | 74AHCT125 (must be **AHCT**) | [VUPN524](https://vetco.net/products/vupn524_quad_level-shifter_-_74ahct125_-_3v_to_5v_d96) | $2.95 |
| 2 | IRLZ44N MOSFET | [VUPN1682](https://vetco.net/products/vupn1682_mosfet_mosft_for_micro_controllers_-_30v_-_60a_-_irlb8721pbf_d151) | $5.34 |
| 1 | Mini toggle switch with leads | [30-10005](https://vetco.net/products/30-10005_spst_miniature_toggle_switch_w-wire_leads_on-off_6a) | $4.95 |
| 1 | 2.1 mm DC panel jack | [2112](https://vetco.net/products/2112_2-1mm_dc_power_panel_mount_jack) | $2.88 |
| 3 | 1N5819-type diode | [NTE585](https://vetco.net/products/nte585_40_volt_1a_schottky_rectifier_do41_-_nte585) | $2.82 |
| 4 | Resistors: 2 x 10 k, 100 k, 22 k | [10k](https://vetco.net/products/nte-qw310_10k_ohm_1-4_watt_resistor), [100k](https://vetco.net/products/nte-qw410_100k_ohm_1-4_watt_resistor), [22k](https://vetco.net/products/nte-qw322_22k_ohm_1-4_watt_resistor) | $1.16 |
| 2 | 0.1 µF capacitor | [link](https://vetco.net/products/vupn6606_ceramic_capacitor_0-1_uf_-2080_50_volts_z5u) | $0.50 |
| 1 | 2200 µF 16 V capacitor | [link](https://vetco.net/products/2200uf16vdc_2200uf_16_volt_electrolytic_capacitor) | $2.80 |
| 1 | 5 x 7 cm protoboard | [link](https://vetco.net/products/phenolic-protoboard-1-97-x-2-76-inch) | $3.49 |
| 1 | 14-pin IC socket | [link](https://vetco.net/products/14-pin-ic-socket-2-54mm-spacing-0-1) | $1.95 |
| 1 | 22 AWG stranded wire | [link](https://vetco.net/products/hookup_wire_stranded_22_ga) | $5.37 |
| 1 | 1/8" heat-shrink, 4 ft | [link](https://vetco.net/products/1-8_heat_shrink_tubing_4_long) | $1.69 |

## Tacoma Screw, Ballard: ~$12 (by the piece, estimate)

| Qty | Item | Link |
|---|---|---|
| 5 | M3 x 6 socket head | [223-306-3](https://www.tacomascrew.com/Product/223-306-3) |
| 11 | M3 x 8 socket head | [223-308-3](https://www.tacomascrew.com/Product/223-308-3) |
| 4 | M3 x 8 flat head (countersunk) | [224-308-4](https://www.tacomascrew.com/Product/224-308-4) |
| 6 | M3 x 10 socket head | [223-310-3](https://www.tacomascrew.com/Product/223-310-3) |
| 20 | M3 x 12 socket head | [223-312-3](https://www.tacomascrew.com/Product/223-312-3) |
| 15 | M3 hex nut | [231-003-1](https://www.tacomascrew.com/Product/231-003-1) |

## Local, measure in the store: ~$10 (estimate)

| Item | Size limit | Where |
|---|---|---|
| Food-safe jar with a drillable lid | At most 73 mm across with the lid, 76 mm tall | [Micro Homebrew](https://www.microhomebrew.com/), Kenmore |
| 1.5 oz shot glass | At most 52 mm across the top, 62 mm tall | [Bargreen Ellingson](https://www.bargreen.com/locations/seattle), SoDo |

## Only if you don't have them (Amazon, Prime)

| Item | Listing | Price |
|---|---|---|
| Green PETG, 1 kg (buy 2) | [B0D4MBDL8B](https://www.amazon.com/dp/B0D4MBDL8B) | $27.98 |
| White PETG, 1 kg | [B07PDV9RC8](https://www.amazon.com/dp/B07PDV9RC8) | $14.99 |
| Soldering iron kit | [B08R3515SF](https://www.amazon.com/dp/B08R3515SF) | $9.96 |
| Multimeter | [B01ISAMUA6](https://www.amazon.com/dp/B01ISAMUA6) | $14.39 |
| Digital calipers | [B07DFFYCXS](https://www.amazon.com/dp/B07DFFYCXS) | $8.99 |
| Metric drill bits, 1.5-10 mm | [B07B7L6WVY](https://www.amazon.com/dp/B07B7L6WVY) | $22.99 |
| Flush cutters | [B07VGK8GBL](https://www.amazon.com/dp/B07VGK8GBL) | $5.39 |

## Estimated total

| | Cost |
|---|---|
| Amazon | $148.82 |
| Vetco | $37.89 |
| Tacoma Screw (est.) | ~$12 |
| Jar and shot glass (est.) | ~$10 |
| **Parts total** | **~$209** |
| Plus filament (2 green + 1 white) | ~$252 |
| Plus all the tools | ~$313 |

**Not verified:**
- **Frosted sheets:** I couldn't re-check their price or delivery date.
- **Tacoma Screw:** the per-piece prices are my estimate.
- **Jar and shot glass:** the prices are my estimate.
- **Delivery dates:** they're for Amazon's default San Francisco address, so Seattle could differ by a day.

Everything on Amazon arrives well before Halloween. Order the tubing soon, since only 4 were left.

---

### Kevin

Do we need 10 ft of tube, or will 3 ft do?

### Claude

3 ft would be cutting it too close. My estimate is that one run of tube from the jar to the nozzle is **about 90 cm (~3 ft)**. That's an estimate from the CAD layout, not a measured length.

| Section | Approx. |
|---|---|
| Pickup inside the jar, plus a little above the lid | 11 cm |
| Lid to the pump inlet | 10 cm |
| Around the pump head's rollers | 10 cm |
| Pump outlet up through the lower dish to the bay floor | 20 cm |
| Spare loop, so the lantern lifts off for refills | 30 cm |
| Through the floor, the nozzle guide, and 5 mm sticking out | 8 cm |
| Vent stub in the jar lid | 2 cm |
| **Total** | **~90 cm** |

So a 3 ft (91 cm) piece leaves essentially nothing to spare:
- **No margin for mistakes:** one slanted cut at the nozzle or one bad routing and you're short.
- **The tube is a wear part.** The rollers slowly flatten it, and the guide says to replace it when it looks cloudy or flattened. Because it's one continuous piece with no joints, replacing it means a whole new run.
- **10 ft covers the first run plus about two replacements,** for only a few dollars more than a short piece would cost.

I'd keep the 10 ft. If you want to save a little, 5-6 ft is a sensible minimum (one run plus one spare). I can check whether Auber sells that length, but Amazon was blocking my checks earlier, so it may take a couple of tries.

---

### Kevin

Is the Locite superglue gel needed? I have a lot of Gorilla Glue superglue already

### Claude

No, you don't need it. Gorilla Glue super glue is the same type of glue (cyanoacrylate), and it does everything the build needs:
- the magnet in the key cap
- the key cap onto the ring
- the nuts in their pockets
- the Hall sensor on its post
- a few dots holding the diffuser

The Loctite gel was only suggested because a gel doesn't run on vertical surfaces. Two tips for using your glue instead:
- **Ring and magnets:** scuff the ring's face and the key cap first, then use a small drop, not a puddle.
- **Diffuser:** use tiny dots near its edge. This kind of glue can leave a white haze on nearby plastic, and you don't want that on the part the light shines through.

I've taken the Loctite off the list and noted "use the glue you have" in the guide and shopping list. The Amazon order drops to **$145.00**, and the parts total to **about $205** (about $195 before the jar and shot glass). Pushed to the PR.

---

### Kevin

https://www.amazon.com/dp/B0FM41G21X?th=1  These arrive after Halloween. Is there a local and/or cheap equivalent? Didn't you say binder separators would work here?

### Claude

Yes, a binder divider is the right substitute, and it's what the guide already offered as the local option. The curtain only needs one small piece of flexible, see-through-but-cloudy plastic, and any office store sells that.

**What to buy:** one **clear-frosted polypropylene binder divider** or **report cover**, letter size, about $3-5 a pack at Staples, Office Depot or Target. One sheet makes the whole curtain: 13 strips, each 12 x 97 mm.

**What to check in the store:**
- **The label must say "poly" or "polypropylene", not PVC or vinyl.** Polypropylene can flex thousands of times without cracking; PVC eventually splits at the bends.
- **Bend a corner hard.** Polypropylene turns white at the crease but stays in one piece. If it cracks, it's the wrong plastic.
- **Thickness about 0.3-0.5 mm.** Dividers are usually about 0.4 mm and report covers thinner. Thinner strips part more easily around your fist.
- **Colour:** clear-frosted is best, since the green comes from the LEDs. A translucent green divider also works and tints the opening greener. Avoid anything opaque.

I haven't checked any specific store's stock.

I've moved the curtain to the "buy locally" list in both the shopping list and the guide. The Amazon order is now **$135.00**, and the parts total is **about $200** with the local items. Pushed to the PR.

---

### Kevin

Check local stores, including home depot for something equivalent

### Claude

Search results don't show in-store stock, so I'll try Target's and Home Depot's sites directly in a browser (time-boxed).

### Claude

I couldn't check live store stock. Target's site blocked my request with a bot check, and Home Depot and Office Depot use the same kind of protection. Your store's app (Target, Fred Meyer or Office Depot) will show "in stock at [your store]" in a few seconds. Here's where to look and what to pick:

**Best bets, in the school or office aisle:**

| Store | Look for | ~Price |
|---|---|---|
| Target, Fred Meyer | A **translucent plastic 2-pocket folder** (Five Star, or the store brand), clear or green | $1-3 |
| Target, Office Depot/OfficeMax | **Plastic binder dividers** with clear-frosted pages (e.g. Avery) | $3-5 |
| Office Depot/OfficeMax, Staples | **Clear frosted poly report covers** (C-Line, Fellowes, GBC) | $3-8 |

A pocket folder is probably the cheapest. It's usually polypropylene about 0.4-0.5 mm thick, and the flat back panel alone is big enough for all 13 strips.

**Home Depot: no good match.**
- **Thin plastic:** their thin stuff is polyethylene drop cloth, too floppy to fall back into place.
- **Plastic sheets:** acrylic or polycarbonate, which are too stiff.
- **Coroplast:** the only polypropylene they carry is corrugated board about 4 mm thick.

**Backup:** Blick Art Materials (Capitol Hill) sells **Grafix Dura-Lar matte film**, about 0.13 mm. It's polyester rather than polypropylene, so it may keep a slight bend over time, but it won't crack.

**In-store test:** the label should say "polypropylene" or "poly", not PVC or vinyl. Bend a corner hard: polypropylene goes white at the crease but doesn't crack.

I've added this to the shopping list and pushed it.

Sources:
- [Home Depot glass & plastic sheets](https://www.homedepot.com/b/Building-Materials-Glass-Plastic-Sheets/N-5yc1vZbrdgZ12l7)
- [Home Depot Coroplast](https://www.homedepot.com/b/Building-Materials-Glass-Plastic-Sheets/Coroplast/SHAPE-PRODUCTS/N-5yc1vZbrdgZdw1Zu3x)
- [Staples: GBC Slide 'n Bind frosted report cover](https://www.staples.com/gbc-slide-n-bind-report-cover-letter-size-clear-10-bx/product_GBC67504)
- [Staples Advantage: C-Line polypropylene report covers](https://www.staplesadvantage.com/c-line-174-clear-poly-report-covers-for-use-with-slide-n-grip-binding-bars/product_CLI31347)
- [Walmart: Avery Clear Easy View plastic dividers](https://www.walmart.com/ip/50666227)

---

### Kevin

How many of these do I actually need, and do you think I can find them locally for cheaper/lower quantity:
https://www.amazon.com/dp/B083GR7FQF?th=1
https://www.amazon.com/dp/B086JRH4WS?th=1
https://www.amazon.com/dp/B0BVTDP29W?th=1

For the springs specifically, can I just harvest them from pens or something?

### Claude

You only need **one or two of each**, and all three can be bought locally in small quantities.

| Amazon pack | You need | Local option |
|---|---|---|
| JST-SM 4-pin plugs, 20 pairs ($9.99) | **2 pairs** (lock cable, LED leads) | **Vetco, $3.99 for both:** [JST PH 4-pin pair, pre-wired](https://vetco.net/products/jst-ph-2-0-4-pin-connector-male-female-pair-pre-wired) ($2.24) and [JST SM 2-pin locking pair](https://vetco.net/products/vupn1054_jst_sm_2_pin_m-f_pair_locking_connector) ($1.75). Both listed as in stock on Vetco's website. |
| Check valves, 10 pack ($4.79) | **1** | The aquarium aisle at Petco, PetSmart or any fish store. They're usually a few dollars for 1-3. I couldn't check stock; Vetco doesn't carry them. |
| Spring kit, 23 sizes ($6.99) | **1** | A pen spring first (below). If that's too weak, the Hillman spring drawer at Ace or McLendon (~$1-2, bring calipers). |

**Pen springs: yes, worth trying first.** A retractable ballpoint's spring is usually about 0.3-0.4 mm wire and 4-4.5 mm across, so it fits the lock's 5.6 mm spring pocket. Cut it to about 10 mm with flush cutters.

The catch: thinner wire is much softer. My rough estimate is about **a third of the force** of the 0.5 mm spring the lock was designed around. Two things depend on that force:
- the rotor snapping back to rest when you let go
- holding the rotor firmly at rest

With a weak spring, the twist feels light and the return can be sluggish, especially while your fist is still pressing on the ring. You'll find out in the first evening: the guide has you print and test the lock first (section 6, step 4). If it doesn't snap back crisply every time, swap in a stiffer spring from the hardware store's drawer.

`★ Insight ─────────────────────────────────────`
Spring stiffness rises with the **fourth power** of wire thickness. Going from 0.5 mm to 0.35 mm wire looks small, but it cuts the stiffness to about a quarter, offset slightly by a pen spring's smaller coils. That's why "just a little thinner" feels much softer.
`─────────────────────────────────────────────────`

**Updated** in the shopping list and guide, and pushed:
- **Plugs:** now from Vetco; the guide is back to a 2-pin plug for the LED leads.
- **Check valve and spring:** marked "1 used, try local first".
- **Totals:**
  - Amazon is **~$125** if you still order the check valves and spring kit, or **~$113** without them.
  - Vetco is **~$42**.
  - The overall estimate stays at **about $190**.

---

### Kevin

Let's mark the pen spring as coming from Ace hardware

### Claude

The spring now comes from Ace Hardware, and the Amazon spring kit is off the list. Pushed to the PR.

- **New "Ace Hardware" section:**
  - **Where:** one compression spring from the Hillman spring drawer, about $1-2. Seattle stores: Magnolia, Maple Leaf, West Seattle Junction.
  - **Size:** about 0.4-0.5 mm wire, 5 mm across (it has to fit a 5.6 mm pocket), roughly 10 mm long. A longer one is fine; cut it to 10 mm with flush cutters. Bring calipers.
- **Pen spring:** now listed as the fallback if Ace doesn't have a good size. It still fits, but it's softer, so check how it snaps back when you test the lock.
- **Guide:** the spring row now says Ace Hardware as well.
- **Totals:** Amazon order **~$118**, all parts **about $185**, plus the jar, shot glass and curtain sheet you'll pick up locally.

I've read "pen spring from Ace" as a small spring from Ace's Hillman drawer, since Ace doesn't sell pen springs. If you meant buying actual pens there to take the springs out, tell me and I'll change that line.

---

### Kevin

show me the full updated list and total as a PDF

### Claude

I've sent the PDF: 2 pages, letter size, with a tick box next to every item and clickable links. It's also saved to the repo as `docs/SHOPPING_LIST.pdf` and pushed to the PR.

**Totals (before sales tax):**

| | Cost |
|---|---|
| Amazon (9 items, free shipping, Prime by Oct 14-15) | $118.02 |
| Vetco (17 lines) | $41.88 |
| Tacoma Screw, M3 screws and nuts | ~$12 (estimate) |
| Local: Ace spring, jar, curtain sheet, shot glass | ~$14 (estimate) |
| **Parts total** | **~$186** |
| + filament (2 green, 1 white) | ~$229 |
| + filament and all the tools | ~$291 |

The Tacoma Screw and local prices are my estimates; everything else is from the stores' listings.

---

### Kevin

do you need to commit the pull request still?

### Claude

No, there's nothing left to commit. Every change is committed and pushed: your local copy and [PR #1](https://github.com/TheRageKage12/temprepo/pull/1) on GitHub both point to the same latest commit, and there are no unsaved edits. The PR picked up each push automatically.

The one step left is yours: **merging** the PR into your main branch on GitHub when you're happy with it. I haven't merged it, since that's your call.

If you'd like, I can update the PR description first. It was written early on and doesn't mention the later changes (KBT battery, wider base, A3144 sensor post, COB strip, the new nozzle, the shopping list), so it's out of date.

---

### Kevin

you mean this?  https://github.com/TheRageKage12/temprepo/pull/2

### Claude

Yes, that's the one, and I owe you a correction. **PR #1 was merged on Oct 12**, so all the work since then went onto the same branch and wasn't in any open PR. I kept linking #1 without noticing it was already merged. Your new **[PR #2](https://github.com/TheRageKage12/temprepo/pull/2)** now holds those changes.

I checked it:
- It contains all **26 commits** since PR #1 was merged, up to the latest one (the PDF shopping list). Nothing is missing.
- GitHub shows it as **mergeable with no conflicts**.
- The repo has no automated checks set up, so there's nothing to wait for.

So nothing more needs committing; it's ready for you to merge.

Its title is just the branch name, though, and it has no description. Want me to give it a proper title and a summary of what changed since #1? That would cover:
- the 2400 mAh battery and the base widened to 190 mm
- the A3144 sensor on a post
- the downward-pointing nozzle and the jar's one-way vent valve
- the COB LED strip
- the walkthrough fixes to the guide
- the linked shopping list and PDF

---

### Kevin

it looks like that back panel from a previous design is here: https://github.com/TheRageKage12/temprepo/blob/main/docs/images/cad-assembly-rear.png . Should that be updated? Are teh CAD files correct?

### Claude

The CAD files are correct, and that image wasn't an old design either; it was a misleading render.

**The CAD files:**
- PR #2 is merged, so `main` has the latest design.
- I rebuilt every part from the current source. The STL files come out identical to the ones on `main`, and the fit checks pass with no problems.
- Only the STEP files differed, and that's just the timestamp written inside them.
- Everything else is current: the 190 mm base, the A3144 sensor post and the downward nozzle.

**Why it looked like a back panel:** that render *is* the current design, seen from your side. My renderer drew the lock wall in the same green as the outer shell, so the hand opening, with the wall sitting just behind it, looked like a solid panel. The lock on it barely showed.

**Fixed:**
- The lock wall now renders **white** and the lock **grey**, so the view clearly shows an opening with the lock inside.
- I also fixed a drawing-order glitch that smeared green across the edge of the opening.
- The other renders were regenerated with the same colours.

That's 2 new commits on the branch, which I restarted from `main` because PR #2 is merged. Since PR #2 is closed, they aren't in an open PR yet. Want me to open a new PR so you can merge the corrected images?

---

### Kevin

yes, open a new PR

### Claude

I opened [PR #3](https://github.com/TheRageKage12/temprepo/pull/3). It holds the 2 render commits:

- **Recoloured images:** the regenerated views, with the lock wall in white and the lock in grey, so the hand opening no longer looks like a closed panel.
- **Fixed drawing glitch:** the renderer no longer smears green across the edge of the opening.

It only changes the images and the script that draws them. The CAD parts are unchanged: rebuilding them gives the same files as `main`, and the fit and lock checks still pass. It's ready for you to merge.

If you'd like, I can watch the PR and answer any review comments.

---

### Kevin

Can you double check the build guide is up to date

### Claude

The guide has a handful of out-of-date spots. Before fixing them, I'm confirming the lantern's overall size and the part sizes against the current CAD.

### Claude

Part sizes match the CAD, and the height is right (47 cm). Applying the fixes.

### Claude

Guide updated. Now checking the other docs (README files, design notes, firmware header) for the same stale details.

### Claude

The build guide had fallen behind in several places. I've corrected them and pushed the fixes to [PR #3](https://github.com/TheRageKage12/temprepo/pull/3), whose title and description now cover them too.

**Out of date, now fixed:**
- **Status line:** said the firmware passes 17 test scenarios; it's 20.
- **Size:** said 18 cm across; the base is now 19 cm.
- **Prices:**
  - The intro said Amazon and Vetco prices were unchecked; they're now read from the listings.
  - Several were estimates and are now the listing prices: magnets $6.29, XIAO $10.99, the two MOSFETs $5.34 (with the Vetco link), small parts ~$20.
  - The total was ~$200; it's ~$190.
- **Shopping tables:**
  - The microswitch was under "pick up locally" but comes from Amazon.
  - The plugs and curtain sheet were under "order online" but come from Vetco and office stores.
  - The Amazon screw kit was listed as an alternative, but it has no countersunk screws, which the top diffuser needs. That's now noted.
- **Seattle stores:** added Ace (spring), Target, Fred Meyer and Office Depot (curtain sheet), and pet stores (check valve).
- **Plug width:** said "13 mm", which was the old Amazon plugs; now it just says the plugs won't pass through the hole.
- **Calibration:** said a measuring cup could go under the nozzle. Only the shot glass fits, so you pour from it into a measuring cup.
- **Charging:** said to charge when you get the low-battery double blink. It now says charge at about half, since that blink at 10.5 V is a late warning.
- **Diagrams:** now link to the PNG versions, which display everywhere.
- **Wording:**
  - The lock wall's position is now described unambiguously.
  - "Hall board" is now "sensor".
  - The rationale section now describes the COB LED strip.

**Checked and already correct:** every part size in the print table (each one compared against a fresh CAD build), the 47 cm height, the wiring and firmware steps, the lock, the fluid path, assembly order, the tests and troubleshooting.

**Other files:** the main `README.md` had the old size and price (180 mm, $150) and now links to the shopping list and PDF. `cad/README.md` now lists revisions up to 9.

PR #3 is ready to merge.

---

### Kevin

That PR is already merged? You've made this mistake twice now.

### Claude

You're right. [PR #3](https://github.com/TheRageKage12/temprepo/pull/3) was merged at 09:00, 22 seconds after I opened it. The build-guide commit came after that, so it never reached `main`. I told you "PR #3 is ready to merge" without checking its state, which is the same mistake I made with PR #1. From now on I'll check the PR's state on GitHub before pushing or telling you where a change lives.

What I've done:
- **Restored PR #3's description.** I had rewritten it to describe the guide changes, which it doesn't contain. It's back to describing the 2 render commits it actually merged.
- **Rebased the guide commit onto the current `main`.** The branch is now exactly one commit ahead of `main`: "Build guide and READMEs: bring up to date". That commit isn't in any PR yet.

Want me to open PR #4 for it?

---

### Kevin

yes

### Claude

I opened [PR #4](https://github.com/TheRageKage12/temprepo/pull/4). Checked on GitHub just now:
- **State:** open, not merged.
- **Contents:** 1 commit, the build-guide and README updates, changing 3 files.
- **Base:** the current `main`, which already includes PR #3.
- **Mergeable:** yes, no conflicts.

Before I push anything else to this branch, I'll check whether PR #4 is still open first.

---

## [Context summary written at a compaction]

This session is being continued from a previous conversation that ran out of context. The summary below covers the earlier portion of the conversation.

Summary:
1. Primary Request and Intent:

**Overall project**
- A Green Lantern power battery prop that secretly pours a shot.
- Repo TheRageKage12/temprepo, branch `claude/green-lantern-battery-prop-7bn4rp`.
- Contents: CadQuery CAD, XIAO RP2040 firmware, build guide, diagrams, shopping list.

**User constraints and preferences**
- Concise answers; explanatory style with `★ Insight` blocks.
- Amazon links preferred, but **no Amazon search-page links**: "We should have the exact/specific things we need linked."
- Shipping must arrive **before Halloween, preferring Prime**.
- "If you can't find a good match for something or a material, think about alternatives and ask me about them."
- Local stores for small quantities.
- Ender 3 printer, 230x230x240 mm.
- Commit attribution lines:
  - "Co-Authored-By: Claude Opus 5.5 <noreply@anthropic.com>"
  - "Claude-Session: https://claude.ai/code/session_01RA7Cpt4fWuKXDa6DwBe3et"
- No model IDs in repo artifacts.
- PR bodies end with "🤖 Generated with [Claude Code](https://claude.com/claude-code)" plus the session URL.

**Recent intents, in order**
- Design walkthrough steps 3-9.
- Fix the nozzle.
- Vent leak question → valve.
- Keep the lock as is; keep the lights as is.
- Convert diagrams to PNG.
- What happens at 10 V (don't add the buck-boost now).
- Shopping list by store with links; no Adafruit.
- Make the Hall sensor reliable (post design).
- Specific links with Prime delivery before Halloween.
- 2400 mAh battery (user's pick, B0C241NS29).
- COB strip; widen the base to fix the fit.
- Jar and shot glass bought locally.
- Tube length question.
- Glue: use the user's own Gorilla Glue.
- Curtain sheet locally.
- Quantities for plugs, valves and springs; the spring from Ace Hardware.
- Shopping list as a PDF.
- PR questions; fix the rear render; check the build guide is up to date.
- Open a new PR (PR #4).

2. Key Technical Concepts:

**CAD framework**
- CadQuery parametric CAD (params.py, parts/*.py with build()/placements()).
- checks.py: overlap and envelope checks.
- render_views.py: painter's-algorithm renderer; large faces are now subdivided.

**Lock and Hall sensor**
- A3144 Hall sensor (5 V, open collector, one pole) on a post up inside a blind hole in the rotor.
- Magnet-to-element distance about 3.0 mm, giving ~88 mT (N35) against a 35 mT worst-case operate point.
- Post top is set by the rotor's 1.2 mm axial play.
- Lock mirrored for counterclockwise twist.

**Nozzle**
- 135° bend; tip points 45° down and sits 6.7 mm above the rim.
- Projectile stream calculation: lands ~19 mm from the glass centre at any speed.

**Base**
- Cartridge base; KBT 2400 mAh 3S2P pack, 70x55x40 mm.
- Base and lower dish 190 mm (D_MAX); upper dish 180 mm (UPPER_DISH_MOUTH_D) with its own cone slope.

**LEDs and power**
- LED strip resistor/Vf nonlinearity: dims at low voltage. Buck-boost listed as an upgrade only.
- COB green strip, cut every 25 mm, 7 pieces, ~0.6 A estimated.
- Check-valve jar vent.

**Sourcing tools**
- Amazon scraping via Playwright: product pages via /dp; search via the home page search box. Amazon throttles parallel runs.
- Vetco Shopify `search/suggest.json` and `products/<handle>.json`.
- Tacoma Screw product pages via a Playwright-rendered search.

**Git/PR workflow**
- After a PR merges, restart or rebase the branch on origin/main.
- ALWAYS check PR state before pushing or reporting.

3. Files and Code Sections:

- **cad/params.py**
  ```
  D_MAX = 190.0   # base bands and lower dish mouth (rev 9f)
  BASE_BODY_D = D_MAX - 6.0
  DISH_MOUTH_D = D_MAX
  UPPER_DISH_MOUTH_D = 180.0
  POWERBANK_L, POWERBANK_W, POWERBANK_T = 70.0, 55.0, 40.0
  PORT_JACK_D, PORT_SWITCH_D = 8.0, 6.5
  NOZZLE_TIP_XY = (-2.7, -31.1); NOZZLE_TIP_OUT = 5.0; NOZZLE_RISE = 11.0; NOZZLE_BEND_R = 18.0; NOZZLE_BEND_DEG = 135.0
  HALL_SENSOR = 'A3144'; A3144_L, A3144_W, A3144_T = 4.06, 3.05, 1.57; A3144_ELEMENT_DEPTH = 0.5
  HANDLE_TOP_CLEAR = 80.0   # reverted from a test value of 88
  ```

- **cad/parts/base.py**
  - `DECK_GAP = 2.0` (deck holds the pack down).
  - Comments updated: deck underside (44), DECK_TOP (47), BANK_HALF_W 27.5, PILLAR_X 33.
  - Docstrings say battery pack instead of power bank.

- **cad/parts/sphere.py**
  - Nozzle geometry:
    ```
    _BEND = math.radians(P.NOZZLE_BEND_DEG)
    NOZZLE_DIR = (sin, cos)
    ARC_END = ...
    NOZZLE_TIP_DXZ = ...
    GROMMET_XY = (TIP_X - NOZZLE_TIP_DXZ[0], TIP_Y)
    NOZZLE_TIP_Z = WALL_Z0 + NOZZLE_TIP_DXZ[1]
    ```
  - `nozzle_guide` path uses `threePointArc(mid, ARC_END)`.

- **cad/parts/socket.py**
  - A3144 constants:
    ```
    A3144 = P.HALL_SENSOR == 'A3144'
    ROTOR_SKIN = 1.0
    ROTOR_HOLE_TOP = POCKET_FLOOR - ROTOR_SKIN
    AXIAL_PLAY_DOWN = ROTOR_BOT - HOUSING_BOT
    POST_R = 3.6
    ROTOR_HOLE_R = POST_R + 0.5
    POST_TOP = ROTOR_HOLE_TOP - AXIAL_PLAY_DOWN - 0.3
    SENSOR_POCKET = ...
    LEAD_SLOT_W = 1.2
    MAGNET_TO_SENSOR = ...
    ```
  - Rotor: blind hole cut from below.
  - Base: post union, sensor pocket and lead slot. The DRV5032 pocket and window are used only when not A3144.
  - Print orientation: socket_base prints bottom-down when A3144 (`_SHIFT['socket_base'] = None`); its placement is `[((0,0,1),0,(0,0,BASE_BOT)), m]`.

- **cad/parts/dishes.py**
  - Upper dish uses its own cone:
    ```
    U_CONE_K = (P.UPPER_DISH_MOUTH_D - P.DISH_NECK_D)/2.0/CONE_H
    U_CONE_WALL_RADIAL = P.WALL/math.cos(math.atan(U_CONE_K))
    ```
  - `_upper_profile` uses these and `r_mouth = P.UPPER_DISH_MOUTH_D/2`.

- **cad/tests/test_socket.py**
  - Prints the sensor type.
  - A3144 check: rotor pushed `AXIAL_PLAY_DOWN - 0.05` toward the base must not overlap the post (0.00 mm³).

- **cad/render_views.py**
  - COLORS adds:
    - lock_wall WHITE
    - socket parts GREY
    - glass_well, bay_floor and nozzle_guide DARK
  - In render():
    ```
    if m.extents.max() > 60 and len(m.faces) < 200000:
        v, f = trimesh.remesh.subdivide_to_size(m.vertices, m.faces, max_edge=12.0)
        m = trimesh.Trimesh(v, f, process=False)
    ```

- **docs/images/src/gen_wiring.py**
  - KBT box: "KBT 2400 mAh, 6 cells, protection board inside, bare leads". S1 switch, charge jack, battery-sense divider to D0.
  - A3144 box with VCC on 5 V (red wire at x 285) and a 1N5819 in OUT ("stripe to the sensor"). The 3V3 pin was removed.
  - Strip box: "green COB, 75 cm in 7 pieces, all in parallel, ~0.6 A".

- **docs/images/src/gen_socket.py**: section shows the A3144 on a post in the rotor's blind hole, with its label.

- **docs/images/src/gen_fluid.py**:
  - Tip uses `SP.NOZZLE_TIP_Z`.
  - Labels updated: battery pack, one-way vent.

- **docs/images/*.png**: PNG copies of all SVGs (wiring, fluid-path, interaction, socket-mechanism, state-machine), made with Playwright at 2x.

- **firmware/green_lantern/green_lantern.ino**: comment-only changes.
  - Idle glow "pilot glow".
  - D1 wiring comment: A3144 through a diode is the default, DRV5032 the alternative.
  - Compiles at 63136 bytes; 20/20 simulated tests pass.

- **docs/BUILD_GUIDE.md**: heavily updated. Latest commit 02bf991 (PR #4):
  - 20 scenarios, 19 cm base, PNG image links, the lock wall "2.5 cm past the centre".
  - Prices from listings.
  - 2.1 Amazon rows: 1, 2, 3, 4, 5, 5c, 6, 8, 9.
  - 2.2 local rows: 7, 5b, 5a, 10, 11, 12, 12a, 12b, 13, 14, 15.
  - Stores table adds Ace, Target/Fred Meyer/Office Depot, and pet stores.
  - ~$190 total; calibration with the shot glass only; charge at ~half.
  - Earlier edits:
    - nozzle section; jar lid vent valve; cleaning with `cal 8000` runs; the battery day-check
    - cable threading through bay_floor before fitting the plugs
    - A3144 wiring and pole check; sensor post steps
    - COB cutting into 7 pieces; part table (base 190, base_tray 179x184x44, deck 178x177x47, dish_lower 190, socket_base 95x79x7 bottom-down, nozzle_guide 47x18x34, total ~850 g)
    - upgrades row for the buck-boost and fuse

- **docs/SHOPPING_LIST.md**: by-store tables.
  - Amazon $118.02:
    - pump B09HGVLHFV $28
    - tube B0DKB1NKB4 $13.99
    - battery B0C241NS29 $21.99
    - XIAO B0DRNTQ338 $10.99
    - microswitch B0DBV8XGG4 $8.99
    - COB strip B0CKYFLZFQ $14.99
    - LM2596 B0DBVYP91F $7.99
    - magnets B0CBRVF4PN $6.29
    - check valves B086JRH4WS $4.79
  - Vetco $41.88: A3144, 74AHCT125, 2x IRLZ44N, toggle 30-10005, jack 2112, 3x NTE585, resistors, capacitors, protoboard, socket, wire, heat-shrink, JST PH 4-pin $2.24, JST SM 2-pin $1.75.
  - Tacoma Screw: M3 by the piece.
  - Ace: spring.
  - Already have: glue.
  - Buy locally: jar (Micro Homebrew, ≤73 mm with lid, ≤76 tall), curtain sheet (office stores, polypropylene), shot glass (Bargreen, ≤52 mm top, ≤62 tall).
  - Optional: filament (Creality green B0D4MBDL8B x2, Overture white B07PDV9RC8) and tools.
  - Total ~$186.

- **docs/SHOPPING_LIST.pdf**: 2-page PDF, generated from HTML with Playwright `page.pdf`. The generator script is in the scratchpad.

- **README.md**: 190 mm base, ~$190, links to the shopping list and PDF.
- **cad/README.md**: revisions 2-9 note; battery and clearance notes.
- **cad/DESIGN_CONTRACT.md**: rev 9b-9f notes (battery, nozzle 9c, Hall 9d, 2400 mAh 9e, 190 mm base 9f, COB strip).

4. Errors and fixes:

- **Nozzle threw the stream onto the rim**: redesigned to a 135° bend.
- **Old guidance said "stack two magnets" for the A3144, which doesn't fit**: built the sensor post instead.
- **socket_base printed upside down on its post**: now prints bottom-down.
- **Switch hole 6.2 mm too small for a 1/4" bushing**: changed to 6.5 mm.
- **Tight clearances with the 40 mm battery** (jar 0.5 mm, pump 1 mm, radial to the dish): widened to 190 mm.
  - At 190 mm the handle arcs touched the upper dish. Raising the handle didn't help (the contact is at the side), so the upper dish was kept at 180.
- **Cleaning step `cal 20000` would overflow the glass**: changed to 8 s runs.
- **Cable plug housings wouldn't pass the 7 mm hole**: the guide now says to thread the cables before fitting the plugs.
- **Amazon scraping**: captcha with curl; "Continue shopping" interstitial; search URLs blocked (search-box typing works); parallel runs hung. The user said: "That command has been running for a while. Use the results you have already and cancel it."
- **Target and Home Depot sites blocked by PerimeterX**: couldn't check stock; gave guidance instead.
- **PR state mistakes**:
  - Kept citing PR #1 after it was merged; the user pointed to PR #2.
  - Then pushed docs after PR #3 was merged and said it was "ready to merge". The user said: "That PR is already merged? You've made this mistake twice now."
  - Fix: restored PR #3's body and rebased the docs commit onto origin/main (02bf991, force-with-lease).
  - Rule going forward: check PR state before pushing or reporting.
- **I misread the user's "1.5A" battery comment**: the user corrected me to their link B0C241NS29, the 2400 mAh pack.

5. Problem Solving:

**Solved**
- Battery choice and fit.
- Hall sensor reliability.
- Nozzle stream.
- Jar vent.
- Shopping list with specific links and before-Halloween delivery.
- Render "back panel" confusion: the CAD was correct; the render colours were fixed.
- Guide audit.

**Accepted risks**
- Pump envelope is still an estimate (now 6 mm clearance; measure on arrival).
- COB current estimated at ~0.6 A.
- LED dimming at low battery (charge at ~half).

6. All user messages (since continuation):
- "Sure, let's continue the walkthrough"
- "| 2.5 mm vent. Without it, ... Isn't this a leakage risk? / Yes, lets make that change for the pour"
- "yes" (step 4)
- "Is this locking mechanism as simple as it can be, or are there other available parts that might make this easier to build?"
- "sure" (step 5)
- "I'd like the lights to be roughly even on both sides" → then (dismissed question) "Lets keep as is then"
- "yeah" (step 6)
- "convert the wiring diagram to something displayable in the browser. SVG isnt"
- "Go ahead and convert them to PNGs as well, but we don't need to look at them right now. If you need the original SVGs make sure to keep those. If the voltage drops due to low power, what happens to the entire system? Lets say its at 10v instead of the full 12?"
- "I think we're ok for now. We shouldn't ever go below 50% battery anyway. We can add those later if needed"
- "yes" (step 7); "yup" (step 8); "yes" (step 9)
- "yes, make the shopping list by store"
- "Could you add links to all of these items as well?"
- "now post it here in a table"
- "dont include adrafruit here"
- "How can we get the hall sensor to be more reliable? The Jameco link isn't viable because it ships too late"
- "yes" (make the Hall post change)
- "I need you to not link to Amazon search pages. We should have the exact/specific things we need linked. Additionally, if you can, make sure the shipping time for these products are before Halloween, preferring Prime delivery. If you can't find a good match for something or a material, think about alternatives and ask me about them."
- "Pretty sure the battery you just looked at only provides 1.2A, not 1.5A. I linked directly to the correct version for what we need: https://www.amazon.com/dp/B0C241NS29?plpRedirect=mhFallback&ref=clp_hp_h_pc&th=1"
- "what if we just used 8 AA batteries connected together or something?"
- "That command has been running for a while. Use the results you have already and cancel it"
- AskUserQuestion answers: "2400 mAh, raise deck (Recommended)"; "COB green 8 mm (Recommended)"; jar "Buy locally and measure"; shot glass "Buy locally and measure"
- "Can we just expand the size of the lantern by 5-10mm to fix the fit issue?"
- "cool, now show me the full list, costs, and estimated total"
- "Do we need 10 ft of tube, or will 3 ft do?"
- "Is the Locite superglue gel needed? I have a lot of Gorilla Glue superglue already"
- "https://www.amazon.com/dp/B0FM41G21X?th=1  These arrive after Halloween. Is there a local and/or cheap equivalent? Didn't you say binder separators would work here?"
- "Check local stores, including home depot for something equivalent"
- "How many of these do I actually need, and do you think I can find them locally for cheaper/lower quantity: [B083GR7FQF, B086JRH4WS, B0BVTDP29W links] For the springs specifically, can I just harvest them from pens or something?"
- "Let's mark the pen spring as coming from Ace hardware"
- "show me the full updated list and total as a PDF"
- "do you need to commit the pull request still?"
- "you mean this?  https://github.com/TheRageKage12/temprepo/pull/2"
- "it looks like that back panel from a previous design is here: https://github.com/TheRageKage12/temprepo/blob/main/docs/images/cad-assembly-rear.png . Should that be updated? Are teh CAD files correct?"
- "yes, open a new PR"
- "Can you double check the build guide is up to date"
- "That PR is already merged? You've made this mistake twice now."
- "yes" (open PR #4)

7. Pending Tasks:
- Report that PR #4 is open.
- Before any future push or report, check whether the target PR is still open.

8. Current Work:
- The user said "yes" to opening PR #4 for the rebased docs commit 02bf991 ("Build guide and READMEs: bring up to date").
- Before creating it I verified:
  - origin/main..branch = only 02bf991
  - no open PRs
- Created [PR #4](https://github.com/TheRageKage12/temprepo/pull/4), titled "Build guide and READMEs: bring up to date".
- Re-read its state: open, not merged, mergeable_state "clean", 1 commit, 3 files (+45/−41), base main at 9f9d56c, head 02bf991.
- The PR #3 body was restored to its accurate render-only description.

9. Optional Next Step:
- Tell the user that [PR #4](https://github.com/TheRageKage12/temprepo/pull/4) is open with the single docs commit (BUILD_GUIDE.md, README.md, cad/README.md), mergeable with no conflicts.
- Confirm I'll check PR state before any future pushes.
- No further changes unless the user asks.

If you need specific details from before compaction (like exact code snippets, error messages, or content you generated), read the full transcript at: /root/.claude/projects/-home-user-temprepo/45c7fed5-b38c-5bcd-8935-8412da500de5.jsonl
Continue the conversation from where it left off without asking the user any further questions. Resume directly — do not acknowledge the summary, do not recap what was happening, do not preface with "I'll continue" or similar. Pick up the last task as if the break never happened.

The messages after this summary are the most recent messages from before compaction, kept verbatim. The summary was written without seeing them, so something it says has not happened yet may already have happened in them.

---

### Kevin

I want to spend my next session having Fable go over all of this stuff and checking/fixing inconsistencies, adding detail where needed, revalidating, looking for ways to simplify or reduce cost, etc. It should read/parse this entire conversation and our progress for context and decisions that have been made.

What would be the best way to accomplish this? We're looking for a way to utilize basically all of my plan usage limit in the next session on this Fable prompt without going over the limit or carrying on into the next session. We also don't have to be super dynamic or worry about under-utilization; estimates based on time, token-usage, or other  metrics that give rough estimates are ok as well

### Claude

The best way is to write the context down in the repo, then give Fable a prompt that works through the review in priority order and commits after each phase. If the usage limit stops it partway, you lose at most the phase it was on.

**1. Distill this session into the repo before it ends.** The full log only exists inside this temporary cloud container, so the next session can't see it unless it's committed. It's also 40 MB of raw log, mostly tool output and screenshots. The actual conversation text is about 360K characters (about 90K tokens, 103 of your messages). I'd commit two files:
- **`docs/review/CONTEXT.md`** (~5–10K tokens): every decision with its reason, the options you turned down (8 AA batteries, Jameco, the Loctite gel, the buck-boost), your preferences (exact links, Prime before Halloween, local stores), the risks we accepted, and the lessons learned (e.g. check whether a PR is still open before pushing).
- **`docs/review/transcript.md`**: the conversation text only, no tool output, so Fable can check anything the summary leaves out. If the repo is public, this makes the full conversation public too, so you may want to skip it.

**2. Budget control.** You can't set a token budget for a subscription session, so set it up so that stopping at any point is safe:
- **Turn off auto-continue.** With the `autoContinueAtUsageLimit` setting on, Claude Code waits for the limit to reset and keeps going, which is exactly the "carrying on into the next session" you want to avoid. I'm not sure whether it's on by default, so check `/config`.
- **Turn off extra usage, or set its monthly spend limit to $0,** at claude.ai/settings/usage. Then reaching the limit stops the session instead of charging you.
- **Measure, then extrapolate.** Run `/usage` at the start and after phase 1, then scale from there. Fable can't see your usage itself, so you say "wrap up" when you're near ~90%.
- **Expect the session to run out before the work does.** Phases are ordered so the most valuable work happens first, and everything up to the last finished phase is already pushed.

**3. The prompt**, roughly:

> Read `docs/review/CONTEXT.md` first; it records the decisions already made. Don't reopen a decision without a concrete defect, and if you would, list it under "Questions for Kevin" instead of changing it. Work in phases. After each phase: run `cad/checks.py`, the CAD tests and the firmware compile/sim tests; commit; push; then append what you did and found to `docs/review/PROGRESS.md`. Check whether the PR is still open before every push.
> 1. **Correctness, consistency:** do the numbers match across params.py, the CAD parts, the build guide, the shopping list, the diagrams and the firmware? (Look at dimensions, part counts, pins, voltages, quantities.)
> 2. **Revalidate the risky calculations:** Hall sensor field strength and the 1.2 mm axial play, the nozzle stream, current draw, LED dimming, the battery fit at 190 mm.
> 3. **Buildability:** print orientations and supports, build-guide step order, missing steps or tools.
> 4. **Simplification and cost:** fewer parts, fewer stores, cheaper equivalents that still arrive before Halloween with Prime.
> 5. **Polish:** more detail where the guide is thin; regenerate the PNGs and PDF.
>
> Use subagents in parallel for independent areas (CAD, firmware, electronics, docs). Verify every finding before fixing it.

`★ Insight ─────────────────────────────────────`
- Each phase ends with a commit plus a progress file. That makes the session restartable: if it stops partway, the next session (or you) picks up from `PROGRESS.md` without redoing anything.
- The CONTEXT file is what stops a fresh model from undoing what you settled. Without it, an expert reviewer will reasonably suggest things you already turned down, like a buck-boost, 8 AA batteries or a smaller base.
`─────────────────────────────────────────────────`

Want me to write `CONTEXT.md`, `transcript.md` (if you want it) and the prompt file now and push them?

---

### Kevin

yes, write all three and push

### Claude

PR #4 is already merged, so I'll restart the branch from the latest `main` before adding anything.

### Claude

Writing the handoff files now on the new branch `claude/fable-review-handoff`. First I'm checking the setup steps the next session will need.

### Claude

I'll add one loose end I just spotted: a stale comment in the firmware.

### Claude

Two of the three files are written and pushed. The transcript wasn't, because the auto-mode permission check blocked it. They're in a new PR, [TheRageKage12/temprepo#5](https://github.com/TheRageKage12/temprepo/pull/5), on its own branch `claude/fable-review-handoff`. PR #4 had already merged, which is why this got a fresh branch, and that's how I'll do it from now on.

**What's in the PR:**
- **`docs/review/CONTEXT.md`** (~6K tokens): built from all 76 of your messages and the three earlier session summaries, with each fact I relied on checked against the repo. It covers:
  - your preferences;
  - the show sequence you specified;
  - every current decision with its reason and the alternatives you rejected (for power, it lists every option you went through, so the latest one is clearly the current one);
  - the risks we accepted;
  - setup steps for a fresh container;
  - the loose ends I know about, including a stale firmware comment that still mentions an "A3144 divider" when it's now a diode.
- **`docs/review/REVIEW_PROMPT.md`**: the setup steps you do first, then a prompt to paste with five phases, each with a rough share of the budget (consistency 20%, revalidation 20%, buildability 25%, cost 20%, polish whatever's left). Fable must log any decision it would reverse under "Questions for Kevin" instead of changing it. It works on a new branch, opens one PR and never merges.

**The transcript:** the check refused to copy the session log (it lives in Claude's own data folder) into a file in the repo. I didn't try to get around that. CONTEXT.md covers the decisions without it. If you want the full transcript too:
- tell me to retry and approve the action when it asks, or
- add a Bash permission rule for it.

It has to happen in this session, because the log disappears when this container is reclaimed. Remember it would then be in the repo for anyone who can see it.

`★ Insight ─────────────────────────────────────`
- The power section lists the battery options in order, with the 2400 mAh pack last as the current choice. Your choice changed four times, and without the order a reviewer could read the 1200 mAh listing in the transcript and "fix" it back.
- The loose-ends list points Fable at the parts most likely to be wrong: the early research notes and totals repeated across files.
`─────────────────────────────────────────────────`

Merge PR #5 before you start the Fable session, so the files are on `main` when it starts.

---

### Kevin

retry the transcript, I'll approve it

### Claude

PR #5 is still open, so I'll add the transcript to it.

### Claude

I'm scanning it for anything sensitive before committing.

### Claude

Nothing sensitive: the only matches are the word "secretly". There are no keys, no email address and no model IDs. Committing.

### Claude

The transcript is now pushed to [TheRageKage12/temprepo#5](https://github.com/TheRageKage12/temprepo/pull/5), so all three handoff files are on that PR. I checked first that the PR was still open, and its description now lists the transcript.

- **`docs/review/transcript.md`**: 315 KB, about 80K tokens. It has your 76 messages, 243 of my replies and the 4 summaries written when the conversation was compacted. Tool output and system messages are left out.
- **Checked before committing:** I searched it for keys, tokens, passwords, your email address and model IDs. The only hits were the word "secretly". It does include the link to your ChatGPT share, as your first message did.
- **How Fable uses it:** the prompt tells Fable to look things up in the transcript rather than read all of it. Reading it in full would use roughly a phase's worth of budget. CONTEXT.md stays the record of current decisions, and the transcript's header notes that later messages override earlier ones.

`★ Insight ─────────────────────────────────────`
- The 40 MB raw log came down to 315 KB of conversation, under 1%. Almost all of the log was tool output: CAD runs, renders and web scrapes.
- Keeping the compaction summaries helps Fable. Each is a dense snapshot of the design at that point, which makes it easy to see how the design changed between revisions.
`─────────────────────────────────────────────────`

Next steps:
1. Merge PR #5.
2. Do the setup at the top of `REVIEW_PROMPT.md`: turn off auto-continue and extra usage, then check `/usage`.
3. Start the Fable session and paste the prompt.

---

### Kevin

You're doing a full review of this repo: a 3D-printed Green Lantern prop that secretly pours a shot. Kevin builds it for Halloween 2026. Parts arrive from Oct 14 to Oct 18, so there's time to fix the design, but not to redesign it.
Read first, in this order:

1. `docs/review/CONTEXT.md`. It holds every decision made so far, the reason for it, and what was rejected.
2. `docs/review/transcript.md`, if it exists. It's the full design conversation. Use it to check why something was decided; don't reread all of it.
3. `docs/BUILD_GUIDE.md`, `docs/SHOPPING_LIST.md`, `cad/params.py`, `cad/DESIGN_CONTRACT.md`, `firmware/green_lantern/green_lantern.ino`, and `docs/images/src/gen_wiring.py`.

Rules

* Decided means decided. Don't reverse a decision in CONTEXT.md without a concrete defect: a number that's wrong, a part that doesn't fit, something unsafe, or something that won't arrive in time. If you think a decision should change, add it to "Questions for Kevin" in `docs/review/PROGRESS.md` with the reason and the cost. Don't change it.
* Cost. Never raise it without asking Kevin. Savings are welcome if they don't hurt reliability or the delivery dates.
* Links. Exact product pages only (Amazon `/dp/<ASIN>`), never search pages. Check the listing's delivery date (before Oct 31, ideally Prime). No Adafruit or Jameco.
* Prove findings. Back each one with a computation, a CAD check or a test before you fix it. A rendering artefact is not a CAD defect.
* Git.
   * Work on a new branch, `claude/full-review`, from `main`.
   * After phase 1, open one PR for the whole review and add each later phase as commits on it.
   * Check the PR is still open before every push.
   * Never merge; Kevin does that.
* After every phase:
   * run the checks below and fix anything they catch
   * commit and push
   * add a short entry to `docs/review/PROGRESS.md`: what changed, what you verified, open questions
   * Finished phases must stay valid if the session stops at any point.
* Subagents. Use them for independent areas (CAD / firmware+electronics / docs+shopping) when it saves time. Run at most 3-4 at once, and give each one the CONTEXT.md rules.

Checks (set up the tools first; see CONTEXT.md section 7)

```
cd cad && python3 build.py && python3 tests/test_socket.py      # 0 problems, SOCKET MECHANISM OK
cd firmware/test && make test                                   # 20/20 PASS
arduino-cli compile --fqbn rp2040:rp2040:seeed_xiao_rp2040 firmware/green_lantern

```

Regenerate any image, render or PDF whose source changed.
Phase 1: consistency (highest priority, ~20 % of the budget)
Check that every number agrees everywhere it appears:

* dimensions, part counts and print orientations: `params.py` vs the parts, the guide's part table and `cad/README.md`
* pins, voltages, part numbers and quantities: firmware vs wiring diagram vs guide section 4 vs shopping list
* prices and totals: README vs guide section 2 vs shopping list vs PDF
* diagram labels vs the current design
* build-guide steps vs the CAD (holes, screws and their counts, sizes)

Also count screws by size from the CAD and compare with the Tacoma Screw list. Fix every mismatch. Start from the "Known loose ends" in CONTEXT.md section 6.
Phase 2: revalidate the risky numbers (~20 %)
Recompute these independently, with your working in `PROGRESS.md`:

* Hall sensor: field at the A3144 vs its worst-case operate point, across the full 1.2 mm axial play.
* Nozzle: the stream trajectory at both the lowest and highest pump speeds.
* Pour: volume vs time at speed 70 %, including the battery compensation.
* Power: current budget, wire gauges, MOSFET heat, buck converter input range, what the protection board does, and the idle drain while switched off.
* Clearances: every fit at 190 mm, and the glass slide-out path.
* Gate drive: the 74AHCT125 driving the IRLZ44N gates.

Report the margins. Fix only the real problems.
Phase 3: buildability (~25 %)

* Walk the build guide as a first-time builder with only the shopping list in hand:
   * missing steps, tools or parts
   * steps in the wrong order, or parts trapped by an earlier step
   * unclear wording
* Printing on a 230 x 230 x 240 mm Ender 3: print orientations, supports, tolerances, and which parts to print first to test fit (the lock).
* Failure modes at the party: spills, the ring not detected, the glass stuck, a low battery. Check the troubleshooting table covers each one.

Phase 4: simplify and cut cost (~20 %)

* Fewer parts, screws or stores, or cheaper equivalents that still arrive before Halloween.
* Write each idea up as a proposal in `PROGRESS.md` (saving, risk, what changes). Don't apply design changes.
* Apply only pure wins that don't change the design, such as a cheaper listing of the identical part, with a verified link and delivery date.

Phase 5: polish (whatever is left)

* Add detail where the guide is thin.
* Clarify the diagrams.
* Regenerate renders, PNGs and the shopping PDF.
* Mark `docs/research/` as historical, where it's out of date.

At the end, or when Kevin says "wrap up"

* Finish or revert the change in progress, so the branch passes all checks.
* Push, and update the PR description: a summary per phase and the list of questions for Kevin.
* Stop.

### Claude

I'll start by setting up the branch and verifying the tool chain, then run phase 1.

### Claude

PR #5 is merged, and the tools are already installed in this container. Creating the review branch and running the baseline checks.

### Claude

While the three audits run, I'll read the rest of the guide and the design contract so I can apply their findings and start phase 2's calculations.

### Claude

Agents are still running. Meanwhile, the geometry inputs are enough to do the phase 2 field and trajectory arithmetic now.

### Claude

Clearance table matches the contract (jar 5.4 mm and pump 6.0 mm to the lower dish, fist 3 mm to the sphere, glass path 0.5 mm under the lock). The remaining phase 2 items (power, gate drive, wire gauge) are pure reasoning that I'll write up when phase 1 is committed. The three audits are still running; I'll apply their findings as soon as they report.

### Claude

The electronics audit is in. I'll verify its claims against the sources before editing, starting with the firmware lines it cites and the lock test's actual cam angles.

### Claude

Phase 1 waits only on the CAD audit now. One wording slip of my own to fix (the fallback-kit note put the proud screw heads in the wrong place), then I'll regenerate the two diagrams I changed.

### Claude

The environment note says to use `executablePath: '/opt/pw-browsers/chromium'` rather than download a browser. I'll point the launch there.

### Claude

The wiring render is clean and carries the new plug note and the relabelled diode. The CAD audit is the last piece of phase 1; I'll draft the progress entry while it finishes.

### Claude

Phase 1 is applied and documented except for the CAD audit, which is still running. I'll fold its findings in, run the full checks, commit, push and open the PR as soon as it reports.

### Claude

The CAD audit found real build-stoppers, not just wording: the sphere halves have no screw holes for the dish joints (the cutters miss the shell), and three screw lengths can't seat as drawn. I'll verify each in the geometry before changing anything, starting with the sphere cutters, the handle leg, the lock plate and the switch nut pocket.

### Claude

Finishing phase 1: checking the two regenerated images, then updating the progress log, committing, pushing and opening the PR.

### Claude

Both images are right (the bracket label fits; the parts sheet shows the new 21 mm bracket and the slotted plate). Committing phase 1 and opening the PR.

### Claude

Phase 3 is under way: two reviewers are walking the build guide and checking every STL's printability, and I've added the party-day failure modes to the troubleshooting table. Nothing else is independent of their reports, so I'll apply their findings as soon as they land.

### Claude

Committed and pushed (the PR was confirmed open two minutes ago). Phase 3's remaining items wait on the two reviewers' reports; I'll apply them when they arrive.

### Claude

The session is now subscribed to PR #6's activity. I'll check its CI and review state once, then keep going with phase 3.

### Claude

The PR has no CI checks configured and no review threads, so nothing is owed there. Phase 3's two reviewers are still running; the next step depends on their reports.

### Claude

The printability audit found another structural defect: the rear sphere half is three loose bodies — its joining flange ring (r 87.3) never touches the shell's bore (r 87.6), so the exported part stands on two floating arcs with the whole shell 3 mm in the air. The rest are print-orientation and overhang issues with clear fixes. Let me read the flange and band code before changing them.

### Claude

Still phase 3: the walk-through's CAD citations check out (40 x 30 pad grid, 22 x 3 strap slots, 4.5 x 2 zip-tie slots), so I'm applying all its guide fixes in one patch now.

### Claude

The renders are done. Let me glance at the exploded view (it shows the flange, the drum band and the lock plate) before committing phase 3.

### Claude

The exploded view renders cleanly with the new geometry. Committing phase 3 after a PR-state check.

### Claude

Final checks are all green. Wrapping up phase 5: writing its log entry, committing, pushing, and updating the PR description.

### Claude

The review is complete and pushed. All five phases are on [TheRageKage12/temprepo#6](https://github.com/TheRageKage12/temprepo/pull/6) (one commit each), with the full working in `docs/review/PROGRESS.md`. Nothing is merged; that's yours.

**What it found that would have stopped the build** (all fixed in the CAD and verified with probe cylinders in the assembly):
- The sphere halves had **no screw holes** for the dish joints: the hole cutters started outside the sphere's radius and never reached the collar wall.
- The rear sphere half exported as **three loose bodies**: its joining flange floated 0.3 mm inside the shell, so the part stood on two arcs with the shell in mid-air.
- Four screws could not seat as drawn (M3x12s with nothing to thread into, a handle screw whose head was sealed inside the boss), the lock plate's screw heads held it 1 mm off the wall, and the switch bracket's nut didn't fit its floor.
- The switch wires left the lock onto solid wall; a window was added where they land.
- Printability: a square ledge 103 mm up on the drum, a bridged key pocket in the rotor, a nozzle channel whose "open side" was a 1.7 mm slit.

**Guide:** a first-time-builder walk turned up steps that would have stalled (sensor soldered before it could pass its slot, no protoboard holes, serial commands with the XIAO buried under the lantern), all reworded. Totals now agree everywhere ($186); filament is ~1.2 kg, not 0.85.

**Numbers revalidated:** Hall margin 2.1x in the worst position, stream inside the rim at every speed, pours constant over the battery's range, electronics margins fine. One new finding: the lock's return ramp is self-locking against dry PETG friction, so the guide now says to grease it.

**Cost:** no pure wins found; nine proposals are logged, none applied.

**Two questions for you** (top of PROGRESS.md): keep the DRV5032 fallback text or cut it; and accept the marginal lock self-return (greased, hand-returned on the last word) or reprint for a steeper ramp.

Check-ins on the PR are not armed: it only waits on you, and I'll be woken by GitHub if anything changes on it.

---

### Kevin

Can you go over the 2 questions you have in detail

### Claude

Here are the two, with the reasoning behind each and what I'd pick.

## 1. The DRV5032 fallback text

**What's there.** Three places still describe the Adafruit DRV5032 board as an alternative to the A3144: the guide (section 2.1, "Hall sensor alternative": set `HALL_SENSOR = 'DRV5032'` in `cad/params.py` and reprint `rotor` and `socket_base`), the firmware header (the "alternative" wiring line), and `cad/README.md`. The CAD option is real: the socket module keeps the board pocket and window code behind that flag, and `build.py` switches cleanly.

**Why it's a question.** CONTEXT says "no Adafruit" (it ships too slowly). The text costs nothing and never tells you to buy from Adafruit; it only says "if you ever have one". But it is also the only remaining place the design mentions a part you've ruled out, and it adds one more code path to keep alive.

**The trade.**
- *Keep:* if the A3144 ever fails (one pole, 5 V), the fallback is documented and printable without redesign. Cost: a paragraph, one param, and ~40 lines of CAD that must keep working when other things change (it does today).
- *Cut:* three short edits and deleting the DRV5032 branch from `socket.py`. Simpler repo, one fewer thing a future reader can set by mistake. The magnet-to-sensor gap on the DRV5032 path is 7.7 mm vs 3.0 mm for the post, so it's the weaker option anyway.

**My recommendation: keep it, with "(not recommended: Adafruit ships slowly)"**. It costs nothing, and you already own the A3144 decision; a documented escape hatch is worth a paragraph. If you'd rather have the smaller codebase, I'll cut it.

## 2. The lock's self-return

**What it is.** When you let go at 45°, a spring-loaded plunger pressing on a ramp on the rotor's rim is supposed to push the rotor back to 0°. Phase 2 recomputed it and the margin isn't there.

**The numbers.**
- Ramp: 4 mm rise over the 45° arc at r 22 mm, which is 15.7 mm of arc, so the slope is 4 / 15.7 = **0.26** (about 14°).
- A ramp drives a load back only if its slope exceeds the friction coefficient: the return force is N·(sin α − µ·cos α), which goes to zero when tan α = µ.
- Dry PETG on PETG: µ ≈ **0.3–0.4**. That's above 0.26, so the rotor is self-locking when dry. Let go at 45° and it stays there.
- Greased (silicone grease or petroleum jelly, µ ≈ 0.1–0.15): the ramp produces about 0.6 N of tangential force at full twist (spring ~4.4 N there), ~13 mN·m of return torque. Against it, the same spring force pushes the rotor sideways into its bore, costing ~10 mN·m of friction. Net ~3 mN·m: it returns, but slowly, and any burr or string in the bore eats it.
- The spring's stiffness cancels out of this ratio. A stiffer spring doesn't help (it raises both the drive and the friction), and the pen-spring fallback doesn't hurt the return either; it only changes the feel and how firmly the rotor sits at rest.

**What I did.** Guide section 6 step 4 now says to grease the ramp, the plunger nose and the bore before assembly, and explains why; a troubleshooting row covers "rotor doesn't return". No CAD change.

**Why it may not matter.** Your own spec has you turn the ring back on the last word, and the firmware only watches the microswitch: a rotor that stays at 45° until your hand returns it behaves identically for the show. The spring's other jobs still work: it holds the rotor at 0° so the key cap lines up, and it gives the click. The only thing you'd lose is the "let go and it snaps back" feel in the guide's bench test.

**The fix if you want a guaranteed snap-back.** The ramp needs about a 6 mm rise (slope 0.38, comfortably above greased friction and about equal to dry). The spring then compresses 1.2 + 6 = 7.2 mm, which bottoms out a 10 mm spring (its solid height is ~3 mm, so only ~6.5 mm of travel is usable). So the change is: 6 mm rise, a 12–14 mm spring, a deeper plunger pocket, and a reprint of `socket_housing` and `plunger` (together ~35 g, an evening's print). The spring is still an Ace Hardware item; nothing else moves.

**My recommendation: accept, grease it, and test on the bench first** (the lock is the first thing you print anyway). If it creeps back or sticks even greased, tell me and I'll make the steeper-ramp change; it's a one-constant edit plus a spring length, and the fit checks cover it.

If you want either change made now, say which and I'll do it on the same PR.

---

### Kevin

Lets take your recommendations for both

### Claude

Both are decided then: keep the DRV5032 fallback with a "not recommended" note, and accept the lock as greased. Applying the note and recording the decisions.

### Claude

Done and pushed to [TheRageKage12/temprepo#6](https://github.com/TheRageKage12/temprepo/pull/6):

- **DRV5032 fallback:** kept. The guide's paragraph now opens with "not recommended: Adafruit ships slowly, and the board sits 7.7 mm from the magnet instead of 3". The CAD option and the firmware's alternative wiring line stay as they were.
- **Lock return:** accepted as is. The guide already says to grease the ramp, plunger and bore and to test it on the bench first (the lock is the first thing you print). The steeper-ramp change (6 mm rise, 12–14 mm spring, housing and plunger reprint) is written up in `PROGRESS.md` in case the bench test says otherwise.

Both decisions are recorded in `CONTEXT.md` and `PROGRESS.md` with today's date, so a future session won't reopen them. The PR description now says nothing is open and it's ready to merge; that's your call.

### Claude

PR #6 has been merged into `main`, and this session was automatically unsubscribed from it. The review is complete; nothing is pending on my side.

If you start another session on this repo, remember the branch rule from CONTEXT.md: start a fresh branch from `main` for the next piece of work rather than reusing `claude/full-review`.

---

### Kevin

The shopping list PDF isn't editable for me without extra 3rd party tools that require purchase. Can you change it into an Excel sheet or something I can import into Google Sheets and manage there?

### Claude

Totals match the list ($118.02 Amazon, $41.88 Vetco, ~$185 required). Linking it from the list and opening a PR.

### Claude

I've made the shopping list into a spreadsheet, `SHOPPING_LIST.xlsx`, attached above. To bring it into Google Sheets, go to **File → Import → Upload**, or just open it in Excel.

- **Main tab:** one row per item (44 in all), with the store, whether it's required or optional, quantity, a clickable link, unit price, line total and notes.
  - **Bought? column:** a Yes/No dropdown. Set it to Yes and the row greys out.
  - **What you can edit:** quantity and unit price (in blue). The line totals and the totals below the list update when you change them.
- **Totals:**
  - by store: Amazon $118.02, Vetco $41.88, Tacoma Screw ~$12, Ace and local items ~$13.50
  - required total: about $185
  - optional filament and tools
  - still to buy and spent so far, both driven by the Bought? column
- **Estimated prices:** Tacoma Screw (I assumed $0.20 a piece) and the local items are marked "Price is estimate: Yes", so you can fill in what you actually pay.
- **Second tab:** store addresses, phone numbers and hours, plus the list of things you already have.

I opened it in LibreOffice (as a stand-in for Excel) and every formula calculated with no errors; the totals match the markdown list. I haven't opened it in Google Sheets itself.

It's in [TheRageKage12/temprepo#7](https://github.com/TheRageKage12/temprepo/pull/7), on a new branch from `main`. The PR also has the script that generates it and links from the shopping list and README. One thing to know: once you're tracking purchases in Google Sheets, your sheet won't stay in sync with the copy in the repo. If you change the list later, tell me and I'll update both.

### Claude

This session is now watching [TheRageKage12/temprepo#7](https://github.com/TheRageKage12/temprepo/pull/7) for activity. The repo runs no CI checks and the PR has no review comments, so there's nothing for me to fix; it's ready for you to merge whenever you like.

### Claude

[TheRageKage12/temprepo#7](https://github.com/TheRageKage12/temprepo/pull/7) is merged, so the spreadsheet is now on `main` and this session has stopped watching that PR. If you change the list later, I'll do it on a new branch.

---

### Kevin

Here's the sheet, can you see/access/edit it: https://docs.google.com/spreadsheets/d/17pCjma48U2CBcsrsc3ZVFVb3nuV0KqnQlag0SO8B_yU/edit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

### Claude

No, not at the moment. This session does have a Google Sheets connector, but when I tried to open your sheet, Google returned "Permission denied". The Google account the connector is signed in as doesn't have access to that file.

To fix it, either of these works:

- **Share the sheet with the account the connector uses.** In the sheet, click **Share** and add that account as an **Editor**. If the connector is signed in with your own account, check that this sheet belongs to that account and not a different Google login.
- **Reconnect the connector with the account that owns the sheet.** This is under claude.ai Settings → Connectors → Google Sheets.

Once it has access, send me a message and I'll read the sheet back to confirm. With Editor access I can also update it directly: mark items bought, fix prices, add rows. Read-only access would let me check it but not change it.

---

### Kevin

ok try now

### Claude

Yes, I can read your sheet now: "Drunk Lantern Power Battery - Shopping List". Both tabs came through ("Shopping list" and "Stores").

- **All 44 items are there**, with nothing marked as bought yet.
- **The formulas survived the import:**
  - line totals work, for example 2 × $2.67 = $5.34 for the MOSFETs
  - the store totals match the repo: Amazon $118.02, Vetco $41.88
  - total required is $185.40, still to buy $185.40, spent so far $0.00
- **The links import fine:** they show as "open listing".

So far I've only read the sheet. I haven't changed anything to test whether I can write to it; I'll know once you ask for the first edit, and if you only gave read-only access, Google will refuse it.

From here you can ask me to mark items bought, enter the prices you actually paid (Tacoma Screw and the local items are estimates), or add and remove rows. Once you've edited the sheet yourself, it and the repo copy will start to differ. Tell me if you want the repo kept in step with your changes.

---

### Kevin

There are a few things/updates I'd like here:

1. We can probably delete the Excel and other stuff used to create this that are in the repo, so they don't fall out of sync with the sheet, since we'll be editing this there directly.
2. I have 2 collaborators:  Sky and Duncan. A column stating who has the supplies that are listed will help in organizing things
3. For things with quantities more than 1, we probably want to be able to record if we have less than that and need to buy the remainder
4. I think "bought" should be changed to something more general given the above

### Claude

I'll update the sheet first, then clean up the repo. Structural changes in one batch: insert the new columns, replace the Yes/No rule and the old highlight.

### Claude

Now the totals block: replacing the two "Bought?" rows and adding a per-person count.

### Claude

The sheet is done and reads back correctly. Now the repo cleanup on a new branch.

### Claude

I've made all four changes. Your [shopping sheet](https://docs.google.com/spreadsheets/d/17pCjma48U2CBcsrsc3ZVFVb3nuV0KqnQlag0SO8B_yU/edit) was edited in place, so the link is the same; I read it back after the edits and every row and total came through correctly.

**1. Repo cleanup**, in [TheRageKage12/temprepo#8](https://github.com/TheRageKage12/temprepo/pull/8) (a new branch from `main`, waiting for you to merge):
- **Removed:** `SHOPPING_LIST.md`, the PDF and the `.xlsx`, plus the two scripts that generated them.
- **Repointed:** the README, the build guide and the review notes now link to the sheet.
- **Kept:** the guide's section 2 parts tables, which explain what each part is for. They now say to use the sheet for current prices, quantities and status. Those tables still contain prices, so they can drift from the sheet over time. If you'd rather drop the prices from the guide entirely, I can.

**2. Who has it.** A new column with a dropdown of Kevin, Sky and Duncan. You can also type "Sky, Duncan" if an item is split between people; the sheet will flag that it isn't one of the dropdown options but still accept it. The totals section now counts how many items each person holds.

**3. Partial quantities.** Two new columns:
- **Have:** how many you already have. This is the one you edit.
- **Still to get:** Qty minus Have, calculated for you.

A **Cost of what's left** column prices only the missing ones, so "Still to buy" counts just what you still need. For example, if Qty is 17 and Have is 10, it shows 7 to get and costs those 7.

**4. "Bought?" is now "Status".** It fills itself in from Have: **Need**, **Partial** (row turns yellow) or **Have all** (row greys out). You never set it by hand, so it can't disagree with the quantities.

One cost question: the totals still count required items only. The filament and tools are under "Optional filament and tools" and aren't added to the required total.

### Claude

[TheRageKage12/temprepo#8](https://github.com/TheRageKage12/temprepo/pull/8) is now being watched. The repo has no CI, and since I opened it a few minutes ago there have been no review comments, so it's waiting only on your merge.

### Claude

[TheRageKage12/temprepo#8](https://github.com/TheRageKage12/temprepo/pull/8) is merged. The shopping list now exists only in the Google Sheet, and the repo links to it.

---

### Kevin

I don't think we need the "Needed" column in there. Let's categorize things in some logical way and also add the tools and anything else the project requires, so we have a full inventory. For stuff not already on the shopping list, don't worry about finding links or local stores for them

### Claude

No collaborator has entered data yet (every Have is 0, every Who is blank), so I can restructure safely. I'll add the new rows, set categories, sort, then rebuild the formulas and totals.

### Claude

Rows sorted correctly. Rewriting the totals block for the new layout (by store, by category, overall).

### Claude

I've made the changes in your [shopping sheet](https://docs.google.com/spreadsheets/d/17pCjma48U2CBcsrsc3ZVFVb3nuV0KqnQlag0SO8B_yU/edit); the link is the same. I read every row and total back afterwards, and nothing was lost in the sort: each item still has its own link, price and notes.

**Needed column → Category.** It's a dropdown, and rows are sorted by category, then store:
- **Electronics:** the controller, chips, resistors, capacitors, protoboard, wire and plugs
- **Fasteners:** screws and nuts
- **Fluid path:** pump, tubing, check valve, jar, shot glass
- **Lighting:** the LED strip
- **Lock:** microswitch, magnets, Hall sensor, spring
- **Power:** battery, buck converter, power switch, charge jack
- **Shell:** filament and the curtain sheet
- **Supplies:** glue, grease, straps and other consumables
- **Tools**

**18 new items**, with no store, link or price, as you asked:
- **Supplies:** super glue, silicone grease, solder, double-sided tape, sandpaper
- **Tools:** 3D printer, cordless drill, 2 mm and 2.5 mm hex keys, small flat screwdriver, hobby knife, ruler, wire strippers, pliers or small wrench, heat gun or lighter, USB-C data cable, laptop with Arduino IDE, kitchen scale

I marked the Gorilla Glue and the Ender 3 as **Have all**, held by Kevin, because you said you have them. Everything else starts at Have 0.

**Totals rebuilt.** With the Needed column gone, the old "required vs optional" split went too. The Have column now decides what still needs buying, so a tool you already own simply gets Have = 1. The totals show:
- **Still to buy, by store:** Amazon $222.71, Vetco $41.88, Tacoma Screw $12.00, Ace $1.50, local $12.00, hardware store $5.00. That's $295.09 in all, the old ~$185 required list plus filament and tools.
- **Full list cost** and **already covered**
- **Items still needed but with no price yet:** 16
- **Items still needed, by category**, and **items held by each person**

The $295 will come down as you three fill in Have. For example, if someone already owns a soldering iron, multimeter, calipers and drill bits, that's about $56 off. The new items have no price, so if you do end up buying one, add its price and it will count in the totals.

---

### Kevin

renamed the repo, can you still see it

### Claude

Yes, I have it again. After the rename to `TheRageKage12/drunk-lantern-power-battery`, git kept working through GitHub's redirect, but GitHub access in this session was still tied to the old name `temprepo` and was refused. I've added the new name to this session with push access.

- **Fresh copy:** cloned to `/home/user/drunk-lantern-power-battery`, on `main` at the merge of PR #8.
- **Old working copy:** `/home/user/temprepo` now points at the new name too, so either folder works.

From here, new branches, pushes and PRs go to `drunk-lantern-power-battery`. Nothing is in progress right now; let me know what you'd like to do next.

---

### Kevin

Can you run the tmp/render for the stls in the readme?

### Claude

105 images (35 STLs, 3 views each). That's too many to send one by one, so I'll put the printed parts' iso views on one contact sheet and zip all of them.

### Claude

I ran the README's preview command (`python3 render_stl.py output …`) on the current STLs in `drunk-lantern-power-battery`. It rendered all 35 STL files from three angles each (front, iso, top), 105 images in all.

I've sent you two files:
- **`stl-renders-iso.png`**: one sheet with the iso view of each of the 25 parts you actually print, labelled by name.
- **`stl-renders.zip`**: all 105 images. Besides the printed parts, it includes the full assembly and the clearance volumes the build checks (the jar, pump, battery, fist and glass shapes). Those volumes aren't parts to print.

The renders show the fixes from the review: the joining ring sits inside `sphere_rear`, the rotor now exports bottom down, `switch_bracket` is the new longer bracket with a single screw hole, and the drum has its lower angled step.

The renders went to a temporary folder, not the repo, so nothing in the repo changed.

---

### Kevin

update the README renders with these

also, looks like we have 3 spools of PETG. Would it be cheaper/easy to just paint that green once printed?

### Claude

Now the READMEs: embed the sheet and point the command at the committed folder.

### Claude

Before I commit, a quick look at the colour column so the paint answer has real numbers.

### Claude

I've added the renders to the README in [TheRageKage12/drunk-lantern-power-battery#9](https://github.com/TheRageKage12/drunk-lantern-power-battery/pull/9), on a new branch:
- **README:** now shows the contact sheet of all 25 printed parts.
- **`docs/images/stl/`:** front, top and iso renders of each part, 1.8 MB in total.
- **`render_stl.py`:** now skips the assembly and the clearance-check shapes by default (`--all` puts them back) and builds the contact sheet itself. Both READMEs point its command at that folder instead of `/tmp`.

I haven't changed any CAD.

**Painting instead of buying green: no cheaper, and more work.**

The three spools are about how much plastic you need, not the colour. The parts weigh about 1.2 kg whatever colour you print them in, and green PETG costs the same as any other PETG (about $14 per kg). Painting only swaps green filament for another colour, then adds:
- **Paint:** PETG holds paint poorly. You'd scuff-sand everything, use a plastic primer or a plastic-bonding spray (Krylon Fusion or Rust-Oleum 2X), and likely need 2–3 cans for a 47 cm lantern. That's roughly $20–30, which is about what the two green spools cost.
- **Masking:** every mating surface has to stay unpainted. The parts slide together with 0.3 mm of clearance, and a coat of paint fills that. This covers the dish spigots, the locating rings, the cartridge edge, and the lock's rotor and bore.
- **Time:** a day or more of sanding, painting and curing, close to Halloween.
- **Wear:** chips at the handle and thumbscrews would show the other colour underneath.

Painting is only worth it if you want a glossy or metallic finish for looks, or if one of you already has about 1 kg of another PETG colour sitting around.

**Savings that do work** (from the part table's colour column):
- **"Any colour" parts:** about 190 g of hidden parts can come from leftover filament anyone has: the deck, bay floor, glass slot, nozzle guide, lock base plate and small bits. The lock wall (23 g) can be any colour too.
- **White spool ($15):** the only white parts are the two diffusers, about 32 g. If anyone has a little white or natural (translucent) PETG, skip that spool. Printing the diffusers in green also works, just a bit dimmer.
- **Green spools:** keep both. The visible green parts alone come to about 990 g, so one spool is too tight once you add the sphere's supports and any failed print.

If you want any of this in the shopping sheet (for example, the white spool marked as optional), tell me.

### Claude

Fixing a local tracking setting so the hook sees the branch as pushed (the push itself already landed).

### Claude

The renders commit was already on GitHub, and [PR #9](https://github.com/TheRageKage12/drunk-lantern-power-battery/pull/9) was opened from it. The warning came from my local copy of the repo: it was set up to follow only `main`, so it couldn't see the branch I'd pushed. I changed that setting, and the branch now shows as pushed with nothing outstanding. Nothing else needed doing.

### Claude

This session is now watching [TheRageKage12/drunk-lantern-power-battery#9](https://github.com/TheRageKage12/drunk-lantern-power-battery/pull/9). It can merge cleanly, the repo has no CI checks configured, and there are no review comments yet. It's waiting only on your merge.

### Claude

[TheRageKage12/drunk-lantern-power-battery#9](https://github.com/TheRageKage12/drunk-lantern-power-battery/pull/9) is merged, so the README on `main` now shows the parts sheet. I've stopped watching that PR.

---

### Kevin

whats the best way to share this conversation with others? read only or with prompt access

### Claude

For Sky and Duncan, the most useful thing to share is the repo plus the Google Sheet, not this conversation. Sharing the session gives a read-only snapshot at best.

**What sharing a session actually does.** In the session, change its visibility and send the link. On Pro or Max the choices are Private or Public; Team and Enterprise get Private or Team ([docs](https://code.claude.com/docs/en/claude-code-on-the-web.md), "Share sessions"). Three things to know:
- Recipients see the session as it was when they open the link. It doesn't update live.
- Whether they can send prompts into it isn't documented, so plan on them only reading.
- On Pro or Max, "Public" means anyone signed in to claude.ai who has the link. The docs warn that a session can contain code and credentials. This one has links to your Google Sheet and your ChatGPT share, among other things.

**What I'd do instead:**
1. **Read access:** add them as collaborators on the GitHub repo. It already holds the build guide and `docs/review/CONTEXT.md`, which records every decision and the reason for it. It also has `docs/review/transcript.md`, the conversation up to the review, which is more readable than the raw session.
2. **"Prompt access":** each of them opens their own Claude Code session on `drunk-lantern-power-battery` and starts by reading `docs/review/CONTEXT.md`. That's the handoff we built for the review session, and it worked. Their changes come back to you as PRs to merge.
3. **The sheet:** they already have it, or you add them as editors. It's where the "who has what" tracking happens.

If you still want to share this session, set it to Public only for the minutes it takes them to open it, then switch it back to Private.

One gap: `transcript.md` stops at the review handoff. It doesn't cover the review, the sheet changes or the repo rename. I can add a short "since then" section to `CONTEXT.md` so their sessions start fully up to date. Want me to?

---

### Kevin

I guess, whenever we do a push to the repo, we update the transcript, context, and any other things in there that would let them load everything into their own session is the best way to go?

### Claude

Mostly yes, with one change: `CONTEXT.md` gets updated in every PR that makes a decision, but the transcript doesn't need to be refreshed on every push.

- **CONTEXT.md is what their sessions actually work from.** It's short, it holds each decision and the reason for it, and it's cheap to keep current.
- **The transcript is backup, and costly to refresh.** It can only be exported from the session that had the conversation, so a session started by Sky or Duncan can't update yours. It's also large. Refreshing it at the end of a working session is enough.
- **A `CLAUDE.md` at the repo root is what makes this automatic.** Claude Code loads it at the start of every session on the repo, so their sessions get the rules without anyone pasting a prompt. It can also tell those sessions to update CONTEXT.md as part of their own PRs.

I'll set all three up now.

### Claude

Now refreshing the transcript from this session's log.

### Claude

The scan only matched my own sentence about the earlier scan. No keys, email addresses or model IDs. Committing.

### Claude

The handoff is set up in [TheRageKage12/drunk-lantern-power-battery#10](https://github.com/TheRageKage12/drunk-lantern-power-battery/pull/10), on a new branch. Once you merge it, any Claude Code session Sky or Duncan opens on the repo starts with the full context, and they don't need to paste a prompt.

- **`CLAUDE.md` (new, at the repo root):** Claude Code loads this file in every session on the repo, so this is the piece that makes the handoff automatic. It tells the session to:
  - read `docs/review/CONTEXT.md` first, and treat its decisions as settled unless there's a real defect (ask before changing one);
  - work on one branch and one PR per change, and check whether the PR is still open before pushing;
  - update CONTEXT.md in any PR that changes a decision;
  - treat the Google Sheet as the shopping list;
  - run the CAD and firmware checks before pushing.
- **`CONTEXT.md`:** now names the three of you and the new repo name, and ends with a dated change log. The log covers the review, your two answers, the move to the Google Sheet, the part renders and the paint decision.
- **`transcript.md`:** now runs up to this conversation. I checked it for keys, passwords and your email address and found none. It covers my sessions only.

Two things to keep in mind:
1. **Refresh the transcript at the end of a working session, not on every push.** It can only be exported from the session where the conversation happened. When you finish a session with me, say "refresh the handoff" and I'll update both files. Sky's and Duncan's sessions will update CONTEXT.md themselves because `CLAUDE.md` tells them to.
2. **Give Sky and Duncan access to the repo.** Add them as collaborators on GitHub, and each of them connects their own GitHub account to Claude.

### Claude

This session is now watching [TheRageKage12/drunk-lantern-power-battery#10](https://github.com/TheRageKage12/drunk-lantern-power-battery/pull/10). It merges cleanly into `main`, the repo has no CI checks, and there are no review comments yet, so it's only waiting for you to merge it.

---

### Kevin

| “Any colour” parts: about 190 g of hidden parts can come from leftover filament anyone has: the deck, bay floor, glass slot, nozzle guide, lock base plate and small bits. The lock wall (23 g) can be any colour too.

If we do this, wouldn't it reduce the amount of green we need, and then maybe we can get away with just a single green spool?

### Claude

No. Those "any colour" parts aren't counted in the green figure. The ~990 g of green is already only the visible parts; the ~215 g of "any colour" parts came on top of that and made up the rest of the 1.2 kg. So printing them from leftovers doesn't reduce the green needed.

**Why 990 g doesn't fit one 1 kg spool:**
- Green parts: ~990 g
- Tree supports inside the two sphere halves: ~20–40 g
- Supports under the two dish rims, plus skirt and brim: ~10–15 g
- Total: about 1,020–1,045 g, before any failed print

**What would make one spool work:** print `base_tray` (89 g) in another colour too. It's the cartridge floor, hidden inside the drum. Only its small port panel (42 × 12 mm, holding the charge jack and switch) shows at the bottom edge on your side. Green then drops to ~900 g, or about 940 g with supports. That fits a 1 kg spool, but with almost nothing to spare:
- The weights are estimates at about ±10–15%, because they depend on your slicer's infill and walls.
- One failed print of a big part (the drum is 229 g, the upper dish 220 g) uses up the spare.

**If you want to try it**, one green spool plus a reorder plan saves about $14:
1. Order one green spool now.
2. Slice everything first and add up the slicer's filament estimates. That number is much more accurate than mine.
3. Print the biggest green parts first, and weigh the spool as you go. An empty spool weighs about 200–250 g on its own, so subtract that.
4. If what's left looks short, order the second spool then. Prime currently delivers in a day or two, so there's time before Halloween.

My take: with time getting short before Halloween, the second spool is cheap insurance against a stalled print. But one spool plus the reorder plan above is a reasonable bet if you'd rather save the $14.

Want me to update the sheet (green spool quantity 2 → 1, with the reorder note) and change `base_tray` to "any colour" in the guide's part table?

---

### Kevin

is the charging port on the bottom of the lantern (hence not visible from any angle) or on the side?

### Claude

It's on the side, at the very bottom of the base, on your side of the lantern rather than underneath.

- **Where it is:** a small curved panel, 42 mm wide and 12 mm tall, set into the bottom band of the base drum, directly below the hand opening (`PORT_ANGLE = 90` in `cad/params.py`).
- **What's in it:** the charge jack and the power switch, both pointing straight out sideways.
- **Why there:** the drum has a notch that's open at its bottom edge so you can lift the lantern off the cartridge. The panel fills that notch.

So it's only visible from your side, low down. The display side, where the audience stands, can't see it at all. From your side it's a 4 cm strip at table height, so most people would never notice it.

For the filament question, that panel is the only part of `base_tray` anyone can see. Your options if you print the tray in another colour:
- **Leave it:** most likely nobody notices, since it's on your side and at table level.
- **Paint just the panel:** a green paint pen or a bit of model paint on that 42 × 12 mm strip.
- **Print it in black:** an off-colour strip in the green base is less noticeable when it's black, and it reads as a deliberate "port panel".

### Claude

[TheRageKage12/drunk-lantern-power-battery#10](https://github.com/TheRageKage12/drunk-lantern-power-battery/pull/10) is merged. `CLAUDE.md`, the context change log and the updated transcript are now on `main`, so any new session Sky or Duncan opens on the repo starts with them.

The one-spool question is still open. Should I update the sheet (green spool 2 → 1, with the plan to reorder if it runs short) and change `base_tray` to "any colour" in the guide?

---

### Kevin

Lets keep 2 spools for now, the cost difference isn't significant.

I'd like that port to not be visible from any angle. What if we had it sticking up from the base plate inside the lantern, or fully underneath it?

### Claude

Let me check how the cartridge sits in the drum before answering. Whether the lantern stands on the tray decides how "underneath" would work.

### Claude

Both can be done, and nothing has been printed yet, so it only costs a CAD change: the drum loses its notch and the tray gets a new spot for the jack and switch. Parts and cost stay the same.

The catch with putting both underneath: the tray's floor is the bottom of the lantern and sits flat on the table. A jack underneath would be blocked whenever the lantern is standing, and also when you lift the lantern off and the cartridge is standing on its own. So the two parts end up in different places:

**Option A (my pick): switch underneath, jack inside.**
- **Switch:** recessed into a pocket in the floor so it doesn't touch the table. You tip the lantern slightly to flip it, the same move as reaching the thumbscrews.
- **Jack:** mounted on the tray inside, pointing up, next to the battery. You reach it whenever the lantern is lifted off. After every party you lift it off to clean the line anyway, so you plug in the charger then and let it charge while it sits beside the cartridge.
- **Result:** no opening in the shell at all, from any angle. The drum's bottom band becomes a solid ring, which is also stronger.
- **Trade-off:** you can't top up the charge without lifting the lantern off (undo 3 thumbscrews).

**Option B: both underneath, with a cable groove.**
- Both sit in a recessed pocket under the floor. A groove runs from the pocket to the edge so you can charge while it stands.
- **Trade-off:** the groove leaves a small slot, about 8 × 6 mm, at the very bottom edge on your side. It's visible only from table height, but it's not "from any angle".

**Why not the jack inside, sticking up, with the switch inside too:** you'd have to undo the 3 thumbscrews every time you turn it on or off.

One thing doesn't change with either option: the switch should still be off whenever the lantern is stored. Otherwise the electronics slowly drain the pack (~15 mA, so about a week to flat).

Which do you want? I'll make the CAD change on a new branch, check it with the fit checks, and update the guide, wiring notes and renders.

---

### Kevin

Let's do option A

### Claude

Starting on option A. First the geometry I need from `base.py`: where the tray's pillars, wells and slots sit, so the switch pocket and the jack mount land in free space.

### Claude

Renders are done. Now the docs, diagram and context in one patch.

### Claude

The previews predate the final rebuild (rendered 03:00, STL written 03:09), so I'll re-render in the foreground this time, and fix the PROGRESS note (the last command ran from the wrong folder).

### Claude

The tray preview now shows the pocket (the raised block with the switch hole near the rim) and no panel, with extents 178.6 × 178.6. Everything is regenerated; committing and opening the PR.

### Claude

The hidden port is done in [TheRageKage12/drunk-lantern-power-battery#11](https://github.com/TheRageKage12/drunk-lantern-power-battery/pull/11), on a new branch, with every render and part preview regenerated from the final STLs.

**What changed in the CAD** (`DESIGN_CONTRACT.md` rev 9h):
- The drum's notch and the tray's port panel are gone, so the bottom band is a solid ring and nothing shows on the shell from any angle.
- **Switch:** a 26 × 23 × 20 mm pocket on the tray floor, on your side, open at the bottom. The switch mounts in its ceiling with the lever pointing down; you tip the lantern to flip it. I made the pocket 20 mm deep rather than the 15 I first planned, because a miniature toggle's bushing plus lever is closer to 17 mm; the lever tip sits near the opening, where a finger reaches it.
- **Jack:** an 8 mm hole through the deck at the edge on your side, socket pointing up. The jack hangs under the deck, clear of the battery and the pocket.
- The deck's wire slot on that side is now an open notch beside the jack, so the pack and switch leads can go up after they're soldered.

**Verified** with `build.py` (0 problems), the lock test, and probe solids in the assembly: the pocket is open and its hole goes through, the switch body and jack body touch nothing, there's room for the charger plug above the deck, the thumbscrew bosses still clear the pocket, and the band is solid where the notch was.

**Two trade-offs**, both now in the guide:
- Charging means undoing the 3 thumbscrews and lifting the lantern off.
- Whenever the lantern stands beside the cartridge (charging, cleaning, calibration), it goes on two blocks so the tube and cables pass under the rim. The old notch used to serve that purpose.

**Images:** the earlier background render had failed silently on a wrong working directory, so I re-ran it in the foreground and checked the tray preview shows the pocket. `docs/images/stl/` (including the README's contact sheet), the seven CAD views, the wiring diagram and the fluid-path diagram are all current.

Nothing else is pending: the PR waits for you to merge.

### Claude

This session is now watching [TheRageKage12/drunk-lantern-power-battery#11](https://github.com/TheRageKage12/drunk-lantern-power-battery/pull/11). It merges cleanly, the repo runs no CI, and there are no review comments, so it only waits on your merge.

---

### Kevin

> Whenever the lantern stands beside the cartridge (charging, cleaning, calibration), it goes on two blocks so the tube and cables pass under the rim. The old notch used to serve that purpose.

Can you elaborate on this?

### Claude

It comes from how the two halves connect when they're apart.

**What stays connected when you lift the lantern off.** The cartridge (tray, battery, pump, jar, board) stays on the table. The lantern (drum, dishes, sphere, nozzle) lifts off it. Three things run between them and stay attached:
- the drink tube, in one continuous piece from the jar, through the pump, up to the nozzle (no joint anywhere, so it can't be unplugged);
- the lock cable and the LED lead, which do have plugs, but you'd normally leave them connected.

All three come out of the bottom of the lantern, through the open bottom of the drum, and then have to travel sideways to the cartridge sitting next to it. There's about 30 cm of slack in the tube (the service loop) for exactly this.

**The problem.** The drum's bottom edge is a flat ring that sits on the table. If you set the lantern down on a table with those three lines still attached, the ring comes down on top of them:
- The silicone tube gets pinched flat, so the pump can't push through it. Pinched for a while under a 1.3 kg lantern, it can also take a set.
- The cables are 22 AWG, which won't break under that weight, but they're what the ring is resting on, so the lantern rocks.

**What the notch did.** The old notch in the drum's bottom band was 42 mm wide and 12 mm tall, and open at the bottom edge. With the lantern turned so the notch faced the cartridge, the tube and cables ran out through the gap and the ring sat flat on the table. The notch did that job as a side effect; it was there for the port panel.

**Now.** The ring is solid all the way round, so the lantern needs something to lift its rim off the table whenever it stands beside the cartridge with the lines attached: two blocks of wood, a couple of books, anything 2–3 cm thick. That's the cost of hiding the port completely. It comes up at:
- calibration (laptop on the XIAO while the lantern is lifted off);
- cleaning (the `cal` runs with water);
- charging (the jack is on the deck);
- the "on the day" prime before the first pour.

**If you'd rather not deal with blocks**, there are two alternatives, each with its own catch:
1. **Three printed feet** on the drum's bottom edge, say 15 mm tall, which would give a permanent gap all round. The lantern would stand 15 mm taller and the gap would be visible. The thumbscrews are reached through that gap anyway, so it isn't a new kind of opening.
2. **Unplug and lay the lantern on its side.** The cables unplug, but the tube doesn't, so that only works for charging and not for the pump runs.

Blocks are the cheapest option, and you'd need them maybe five times before Halloween. If you'd like the feet instead, it's a small CAD change and I'll do it on a new branch.

### Claude

[TheRageKage12/drunk-lantern-power-battery#11](https://github.com/TheRageKage12/drunk-lantern-power-battery/pull/11) is merged, so the hidden switch and jack are on `main`, and I've stopped watching that PR.

The question about the blocks is still open: keep the two-blocks approach, or add the three printed feet to the drum? Either is fine; tell me which and I'll do the rest.

---

### Kevin

leave as is

### Claude

Noted. The blocks approach stays, and the guide already says so wherever the lantern is set beside the cartridge. Nothing to change in the repo.

---

### Kevin

refresh the handoff

### Claude

The scan only matched my own sentences about earlier scans. Committing and opening the PR.

### Claude

I've refreshed the handoff in [TheRageKage12/drunk-lantern-power-battery#12](https://github.com/TheRageKage12/drunk-lantern-power-battery/pull/12), on a new branch.

- **`CONTEXT.md`:** I added the two decisions made since the last refresh to its change log. You're keeping two green spools, and the lantern stands on blocks rather than printed feet. The hidden power port was already recorded in PR #11.
- **`transcript.md`:** it now covers this conversation up to the hidden power port, the filament question and the blocks question. I checked it for keys, passwords and your email address; the only matches were my own earlier notes about running that same check.

Once you merge it, a new session Sky or Duncan starts on the repo will have everything up to now.

### Claude

I'm now watching [TheRageKage12/drunk-lantern-power-battery#12](https://github.com/TheRageKage12/drunk-lantern-power-battery/pull/12). It can be merged with no conflicts, the repo has no automated checks to wait on, and there are no review comments, so all it needs is for you to merge it.

### Claude

[TheRageKage12/drunk-lantern-power-battery#12](https://github.com/TheRageKage12/drunk-lantern-power-battery/pull/12) is merged, so the handoff on `main` now includes everything decided so far. A session Sky or Duncan starts on the repo will pick all of it up. I've stopped watching the PR.

---

## [Context summary written at a compaction]

This session is being continued from a previous conversation that ran out of context. The summary below covers the earlier portion of the conversation.

Summary:
1. **Primary Request and Intent:**

   **Project and repo**
   - A Green Lantern power battery prop that secretly pours a shot, built for Halloween 2026 by Kevin (owner), Sky and Duncan.
   - Repo: `TheRageKage12/drunk-lantern-power-battery`, renamed from `temprepo` on 2026-10-14. Local clone: `/home/user/drunk-lantern-power-battery`. The old `/home/user/temprepo` remote was repointed to the new name.

   **User working rules**
   - A new branch per feature, then a PR. Check PR state before pushing or reporting.
   - Concise answers. Amazon `/dp` links only, never search pages, with delivery before Halloween.
   - Keep the handoff current. "refresh the handoff" means update CONTEXT.md and transcript.md.
   - The shopping list lives only in the Google Sheet: `https://docs.google.com/spreadsheets/d/17pCjma48U2CBcsrsc3ZVFVb3nuV0KqnQlag0SO8B_yU/edit`
     - Tabs: "Shopping list", sheetId 1159079043; "Stores", sheetId 1950167428.

   **Decisions made this stretch**
   - Keep the DRV5032 fallback, marked "not recommended".
   - Accept the lock return (grease it).
   - Keep 2 green spools.
   - No painting.
   - Option A hidden port: switch in a pocket under the tray floor, jack on the deck pointing up.
   - Blocks rather than printed feet ("leave as is").

2. **Key Technical Concepts:**
   - **CAD:** CadQuery parametric CAD (`cad/params.py`, `cad/parts/*.py`).
     - `build.py` runs `checks.py`: overlap, envelopes, plus the new one-solid-per-printed-part check.
     - `tests/test_socket.py`.
     - Probe-solid verification of clearances in the assembly, with negative controls.
   - **Renders:**
     - `render_views.py` → `docs/images/cad-*.png`.
     - `render_stl.py output ../docs/images/stl` → per-part front/iso/top views plus `parts-iso.png`; `--all` includes envelopes and assembly.
     - SVG→PNG conversion via a Playwright script using `executable_path='/opt/pw-browsers/chromium'` (scratchpad `svg2png.py`).
   - **Firmware:** XIAO RP2040; sim tests `make test` (20/20); compile with `arduino-cli compile --fqbn rp2040:rp2040:seeed_xiao_rp2040`.
   - **Google Sheets connector:** get_values, update_formulas, update_spreadsheet with copyPaste/sortRange/conditional formats/data validation.
   - **GitHub:** GitHub MCP for PRs; add_repo / register_repo_root for the renamed repo.
   - **Handoff:** `CLAUDE.md` is auto-loaded per session; `docs/review/CONTEXT.md` (with Change log, section 8); `docs/review/transcript.md`.
   - **Transcript export:** script at `/tmp/claude-0/-home-user-temprepo/45c7fed5-b38c-5bcd-8935-8412da500de5/scratchpad/export_transcript.py`.
     - Two session logs are merged by uuid/timestamp: `/root/.claude/projects/-home-user-temprepo/<id>.jsonl` plus `/root/.claude/projects/-home-user/<id>.jsonl` → scratchpad `merged.jsonl`.
     - Then a sed tweak to the header line, then a secrets scan.

3. **Files and Code Sections:**

   **CAD**
   - `cad/params.py` (rev 9h): the PORT_ANGLE/PORT_W/PORT_H block was replaced with:
     ```
     SWITCH_POCKET_XY = (15.0, 71.5)
     SWITCH_POCKET_W, SWITCH_POCKET_L = 26.0, 23.0
     SWITCH_POCKET_DEPTH = 20.0
     JACK_XY = (-8.0, 80.0)
     PORT_JACK_D, PORT_SWITCH_D = 8.0, 6.5
     ```
     - Also kept: `JOINT_SCREW_ABOVE_FLAT = 3.0`, `WALL` comment, and the unused rev-6 params marked.
   - `cad/parts/base.py`:
     - Removed `_port_panel` and `_drum_port_notch`.
     - Added `_switch_pocket()`: outer box, open cavity, 6.5 mm hole.
     - `build_tray` uses it.
     - `DECK_LEAD_NOTCH = (14, 12)` at x −25 replaces `DECK_PORT_NOTCH`.
     - `DECK_WIRE_SLOTS_XY` now only has the pump slot.
     - Deck has the jack hole at `JACK_XY`.
     - Drum: lower 45° cone `step_b`.
     - `WELL_D` 19.
   - Other CAD from the review:
     - `cad/parts/sphere.py`: radial_screw_cutters from the shell surface; flange fused inside the rear half; boss access hole; switch-wire window; nozzle slit; BACK_ROWS.
     - `cad/parts/socket.py`: countersinks; bracket screw slot and pilot; rotor exported bottom-down; POST_R 4.0.
     - `cad/parts/handle.py`: counterbore 6.
     - `cad/parts/dishes.py`: screw Z.
     - `cad/checks.py`: one-body check excluding envelopes.
   - `cad/render_stl.py`: `contact_sheet()` added; skips envelopes and assembly unless `--all`; `os.makedirs`.

   **Docs and handoff**
   - `docs/BUILD_GUIDE.md`, `docs/images/src/gen_wiring.py` (S1 and jack labels), `cad/README.md`, `cad/DESIGN_CONTRACT.md` (rev 9g, 9h): all updated for the hidden port and the review.
   - `README.md`: embeds `docs/images/stl/parts-iso.png`; Google Sheet link; render command.
   - `CLAUDE.md` (new at repo root): read CONTEXT first; one branch/PR; keep CONTEXT current plus its change log; Sheet is the shopping list; checks before CAD/firmware pushes; exact links; no model IDs.
   - `docs/review/CONTEXT.md`: team, repo name, power section updated for 9h. Change log entries: review, answers, Sheet move, renders, paint no, hidden port, handoff, two spools, blocks-not-feet.
   - `docs/review/transcript.md`: refreshed (96 user messages, 318 reply blocks).
   - `docs/review/PROGRESS.md`: review log; USB proposal marked moot.
   - **Deleted:** `docs/SHOPPING_LIST.md`, `.pdf`, `.xlsx`, `make_shopping_pdf.py`, `make_shopping_xlsx.py`.

   **Google Sheet "Shopping list"**
   - Columns: A Status (formula: Need/Partial/Have all), B Store, C Category (dropdown), D Qty, E Have, F Still to get `=MAX(0,D-E)`, G Who has it (Kevin/Sky/Duncan dropdown, not strict), H Item, I Link, J Unit price, K Line total `=D*J`, L Cost of what's left `=F*J`, M Price is estimate, N Notes.
   - Rows 2–63, sorted by Category then Store.
   - Totals start at H65: still-to-buy by store, total $295.09, full list, covered, items without price, counts by category, items held per person, how-to text.

4. **Errors and fixes:**
   - **Transcript copy blocked** by the auto-mode classifier. Retried after the user said "retry the transcript, I'll approve it".
   - **Playwright browser missing** → used `executable_path='/opt/pw-browsers/chromium'`.
   - **Render/background command ran in the wrong cwd**, so previews were stale. Re-ran in the foreground and verified timestamps and the image.
   - **Stop hook "no remote branch"** (single-branch clone). Fixed with `git config --add remote.origin.fetch '+refs/heads/claude/*:refs/remotes/origin/claude/*'` then fetch.
   - **GitHub MCP denied the renamed repo** → add_repo with push access.
   - **Google Sheet permission denied** until the user changed sharing.
   - **Earlier mistakes:** citing merged PRs. Rule: always check PR state first.

5. **Problem Solving:**
   - **Review findings fixed:** missing sphere joint holes, unseatable screws, sphere_rear as 3 bodies, switch wires pinched, printability issues, guide stall points.
   - **Hidden port:** probes show the cavity, hole, switch body, jack body, plug room and boss sweep all clear; the band is solid.
   - Lantern stands on blocks when beside the cartridge.

6. **All user messages:**
   - "I want to spend my next session having Fable go over all of this stuff and checking/fixing inconsistencies, adding detail where needed, revalidating, looking for ways to simplify or reduce cost, etc. It should read/parse this entire conversation and our progress for context and decisions that have been made. What would be the best way to accomplish this? ..."
   - "yes, write all three and push"
   - (mid-turn) "In the future, why don't you just use new branches for new features and then create the pull request to merge?"
   - "retry the transcript, I'll approve it"
   - (Fable review prompt pasted: full review rules and phases 1–5)
   - "Can you go over the 2 questions you have in detail"
   - "Lets take your recommendations for both"
   - "The shopping list PDF isn't editable for me without extra 3rd party tools that require purchase. Can you change it into an Excel sheet or something I can import into Google Sheets and manage there?"
   - "Here's the sheet, can you see/access/edit it: https://docs.google.com/spreadsheets/d/17pCjma48U2CBcsrsc3ZVFVb3nuV0KqnQlag0SO8B_yU/edit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"
   - "ok try now"
   - "There are a few things/updates I'd like here: 1. We can probably delete the Excel and other stuff used to create this that are in the repo, so they don't fall out of sync with the sheet, since we'll be editing this there directly. 2. I have 2 collaborators: Sky and Duncan. A column stating who has the supplies that are listed will help in organizing things 3. For things with quantities more than 1, we probably want to be able to record if we have less than that and need to buy the remainder 4. I think "bought" should be changed to something more general given the above"
   - "I don't think we need the "Needed" column in there. Let's categorize things in some logical way and also add the tools and anything else the project requires, so we have a full inventory. For stuff not already on the shopping list, don't worry about finding links or local stores for them"
   - "renamed the repo, can you still see it"
   - "Can you run the tmp/render for the stls in the readme?"
   - "update the README renders with these / also, looks like we have 3 spools of PETG. Would it be cheaper/easy to just paint that green once printed?"
   - "whats the best way to share this conversation with others? read only or with prompt access"
   - "I guess, whenever we do a push to the repo, we update the transcript, context, and any other things in there that would let them load everything into their own session is the best way to go?"
   - (quoting my answer) "“Any colour” parts: ... If we do this, wouldn't it reduce the amount of green we need, and then maybe we can get away with just a single green spool?"
   - "is the charging port on the bottom of the lantern (hence not visible from any angle) or on the side?"
   - "Lets keep 2 spools for now, the cost difference isn't significant. I'd like that port to not be visible from any angle. What if we had it sticking up from the base plate inside the lantern, or fully underneath it?"
   - "Let's do option A"
   - (mid-turn) "Make sure you also rerender/update any of the stl images and have those updated in the repo and/or readme"
   - (quoting) "> Whenever the lantern stands beside the cartridge ... Can you elaborate on this?"
   - "leave as is"
   - "refresh the handoff"

7. **Pending Tasks:**
   - None. PR #12 (handoff refresh) is merged, and all PRs #1–#12 are merged.

8. **Current Work:**
   - The last task was "refresh the handoff".
     - CONTEXT.md change log: added "two green spools stay" and "blocks, not feet".
     - Regenerated transcript.md from the merged session logs and scanned it.
     - Committed on branch `claude/handoff-refresh-2` and opened PR #12.
   - The user merged it, and the session was auto-unsubscribed from PR #12.

9. **Optional Next Step:**
   - None required. The last request ("refresh the handoff") is complete and merged. Wait for the user's next instruction.
   - When asked again to "refresh the handoff", repeat the same procedure on a new branch from main:
     - add CONTEXT change-log entries;
     - merge the two jsonl logs and run the export script;
     - fix the header with sed;
     - scan for secrets;
     - open a PR.

If you need specific details from before compaction (like exact code snippets, error messages, or content you generated), read the full transcript at: /root/.claude/projects/-home-user/45c7fed5-b38c-5bcd-8935-8412da500de5.jsonl
Continue the conversation from where it left off without asking the user any further questions. Resume directly — do not acknowledge the summary, do not recap what was happening, do not preface with "I'll continue" or similar. Pick up the last task as if the break never happened.

The messages after this summary are the most recent messages from before compaction, kept verbatim. The summary was written without seeing them, so something it says has not happened yet may already have happened in them.

---

### Kevin

Duncan has gone through the full design and made some tweaks/updates. We need to rerun our full review and validate everything looks good and/or highlight any other issues.

We also want to make sure our build guide (and new build video), CADs, etc are fully accurate and up to date.

### Claude

I'll start by fetching the latest `main` and seeing what Duncan changed since the last handoff.

### Claude

Two PRs merged since the handoff: #13 (circuit review) and #14 (CAD circuit fit). Let me check out main and see the full scope of the change.

### Claude

The build finished with exit code 0. Now let me look at the build log, the Omron datasheet text, the TalentCell manual pages as images, and the video contact sheets.
