TheRageKage12/drunk-lantern-power-battery/docs/review/REVIEW_PROMPT.md

# Full-project review: session prompt

## Before you start (Kevin)

- **Auto-continue off.** Make sure `autoContinueAtUsageLimit` is off (in `/config`, or in your settings.json).
  It makes Claude Code wait for the usage limit to reset and then continue. With it off, the session stops at the limit
  instead of running on into the next window.
- **Extra usage off.** At claude.ai/settings/usage, turn off extra usage, or set its monthly spend limit to $0.
  Then hitting the limit stops the session instead of billing you.
- **Check usage.** Run `/usage` and note the percentage, then start the session with the prompt below.
- **After phase 1**, run `/usage` again and scale up:
  - If phase 1 used about 15 %, the plan below fits.
  - If it used much more, tell the session to skip phase 5.
- **Near ~90 %**, type "wrap up". Everything up to the last finished phase is already pushed.

The phases run in priority order, so if the limit cuts the session short, only the least important work is lost.

---
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
