TheRageKage12/drunk-lantern-power-battery/docs/review/protoboard/WIRE_SCHEDULE.md

# Board solder schedule

Generated from `design.json`. Hole names are assigned from the component side. The rear view is mirrored.

| Wire | Solder points in order | Colour | Starting cut |
|---|---|---|---|
| W01 | P17 → Q15 → T16 → S18 | white | 45 mm |
| W04 | A08 → B10 → A15 → A13 | black | 74 mm |
| W07 | I13 → G13 → G08 → F10 | black | 74 mm |
| W15 | P07 → P09 → S03 → R03 | green | 78 mm |
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
