TheRageKage12/drunk-lantern-power-battery/docs/images/battery-seat.png

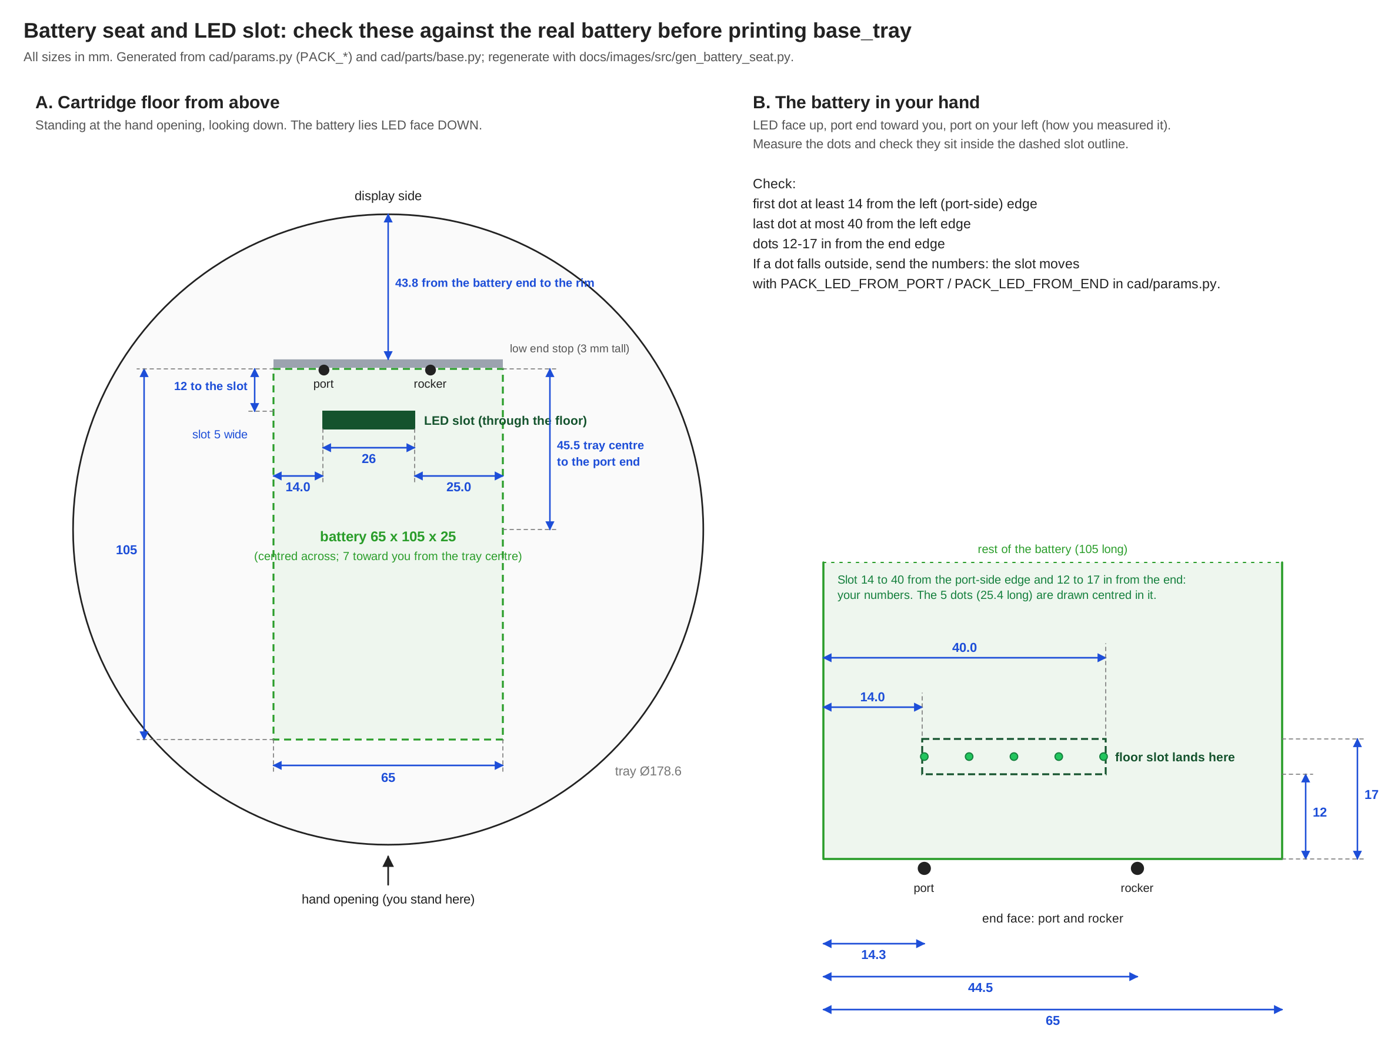
docs/images/battery-seat.png
