TheRageKage12/drunk-lantern-power-battery/docs/images/stl/bag_cover_front.png

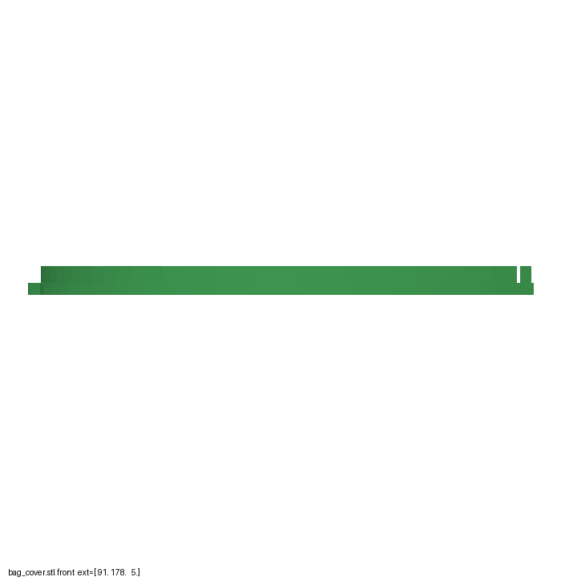
docs/images/stl/bag_cover_front.png
