TheRageKage12/drunk-lantern-power-battery/docs/images/stl/base_tray_front.png

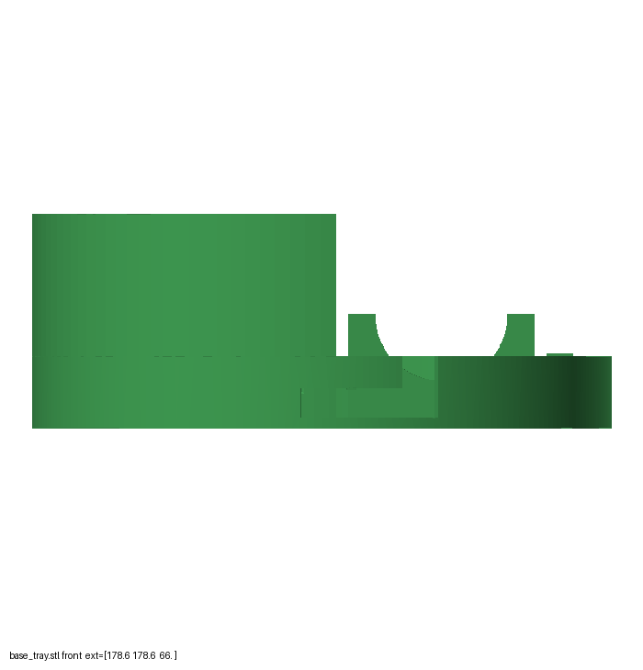
docs/images/stl/base_tray_front.png
