TheRageKage12/drunk-lantern-power-battery/docs/images/stl/base_tray_iso.png

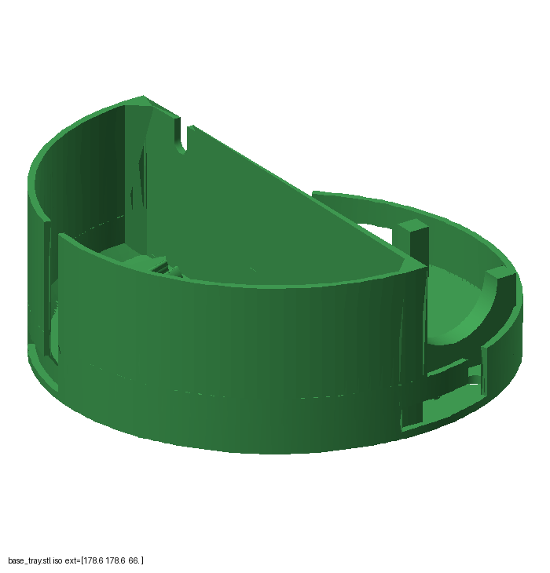
docs/images/stl/base_tray_iso.png
