TheRageKage12/drunk-lantern-power-battery/docs/images/stl/bay_floor_top.png

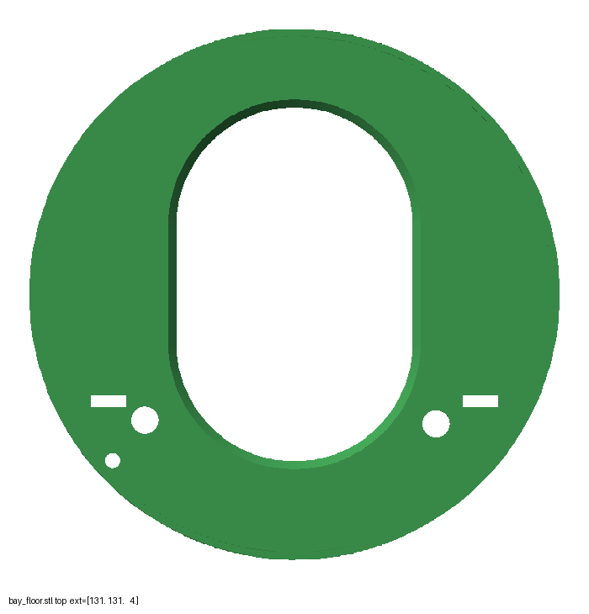
docs/images/stl/bay_floor_top.png
