TheRageKage12/drunk-lantern-power-battery/docs/images/stl/bell_front_iso.png

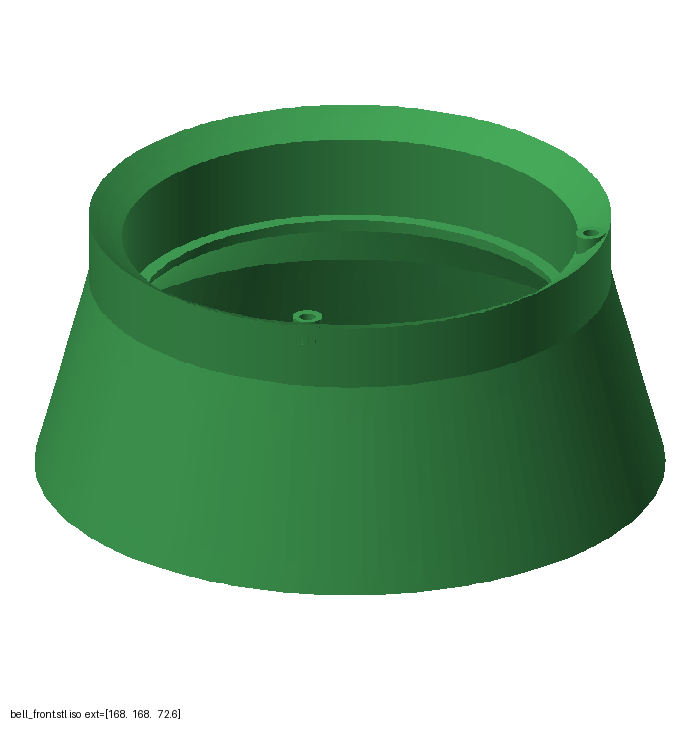
docs/images/stl/bell_front_iso.png
