TheRageKage12/drunk-lantern-power-battery/docs/images/stl/bell_front_top.png

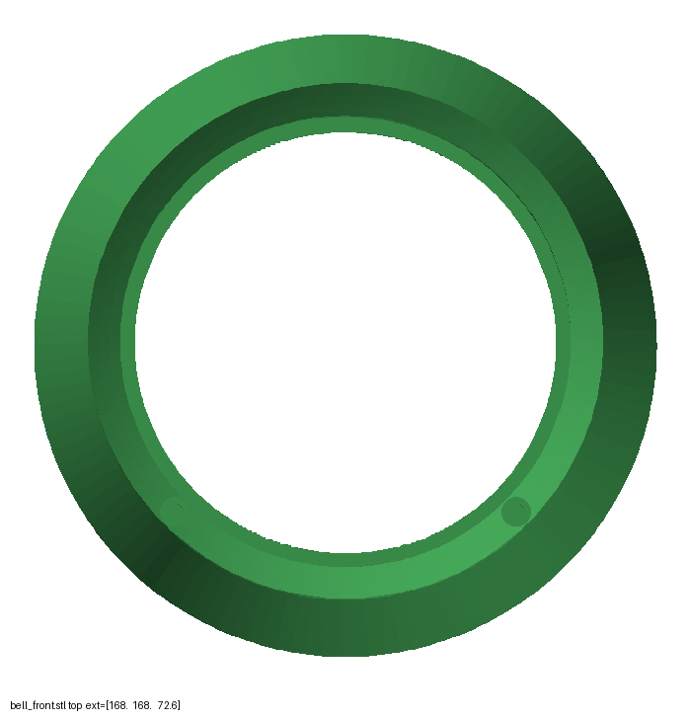
docs/images/stl/bell_front_top.png
