TheRageKage12/drunk-lantern-power-battery/docs/images/stl/bell_rear_top.png

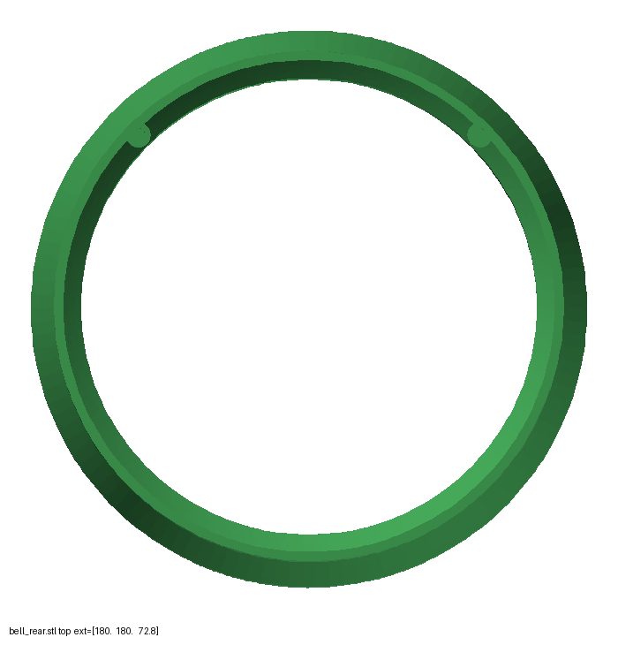
docs/images/stl/bell_rear_top.png
