TheRageKage12/drunk-lantern-power-battery/docs/images/stl/cap_floor_front.png

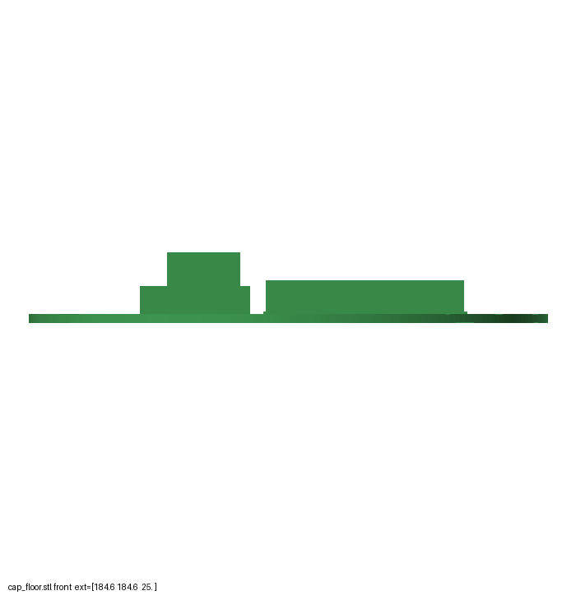
docs/images/stl/cap_floor_front.png
