TheRageKage12/drunk-lantern-power-battery/docs/images/stl/cap_floor_iso.png

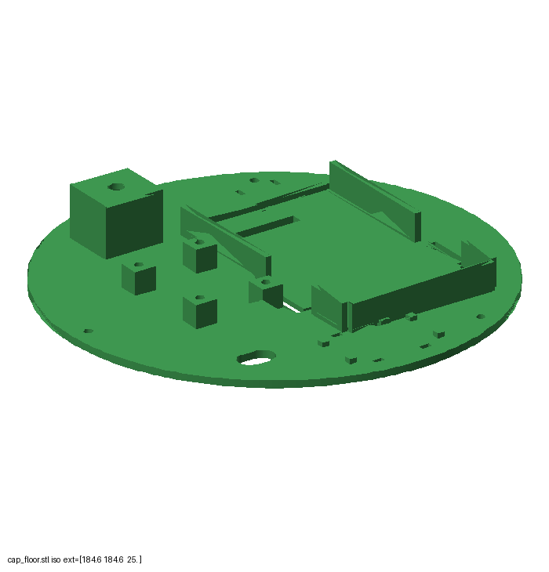
docs/images/stl/cap_floor_iso.png
