TheRageKage12/drunk-lantern-power-battery/docs/images/stl/cap_floor_top.png

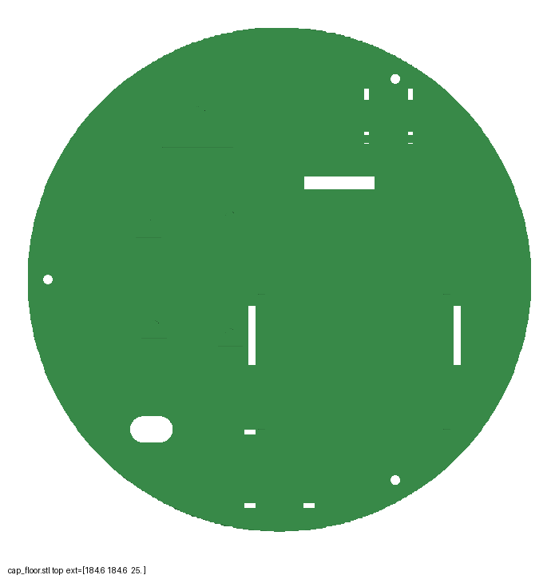
docs/images/stl/cap_floor_top.png
