TheRageKage12/drunk-lantern-power-battery/docs/images/stl/curtain_clamp_iso.png

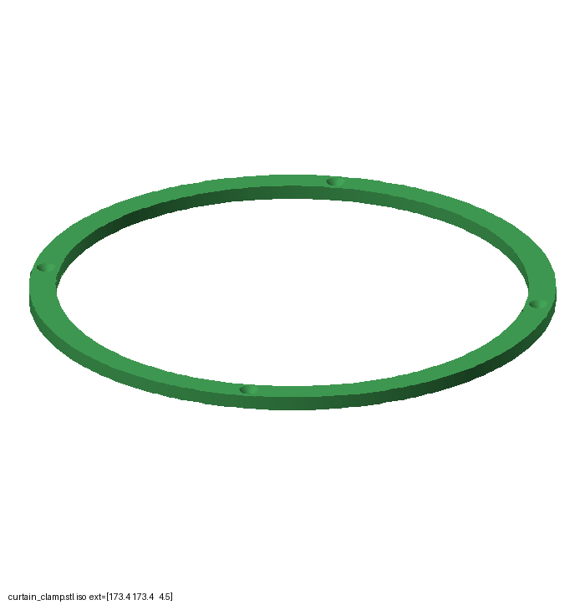
docs/images/stl/curtain_clamp_iso.png
