TheRageKage12/drunk-lantern-power-battery/docs/images/stl/curtain_clamp_top.png

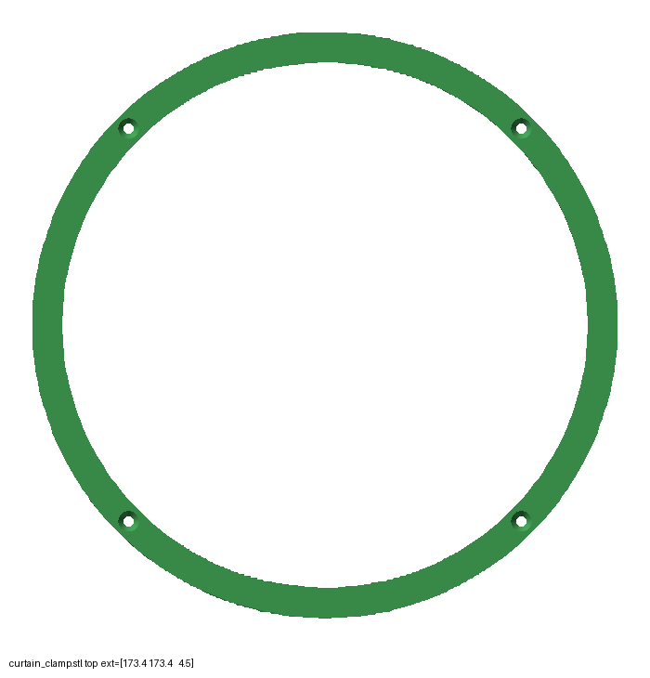
docs/images/stl/curtain_clamp_top.png
