TheRageKage12/drunk-lantern-power-battery/docs/images/stl/curtain_stencil_front.png

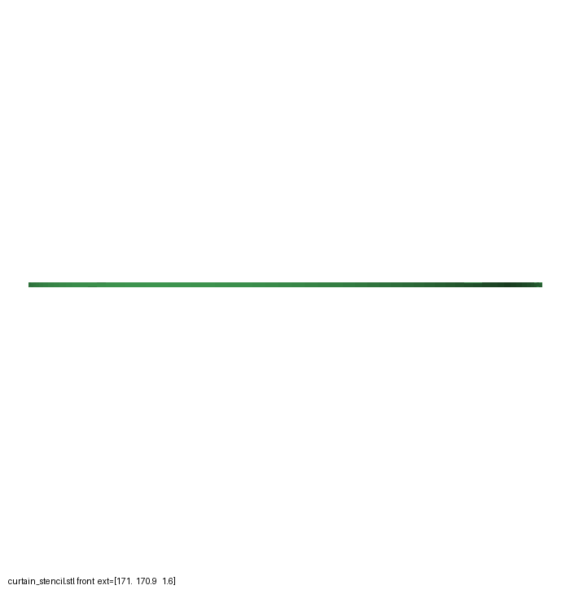
docs/images/stl/curtain_stencil_front.png
