TheRageKage12/drunk-lantern-power-battery/docs/images/stl/curtain_stencil_iso.png

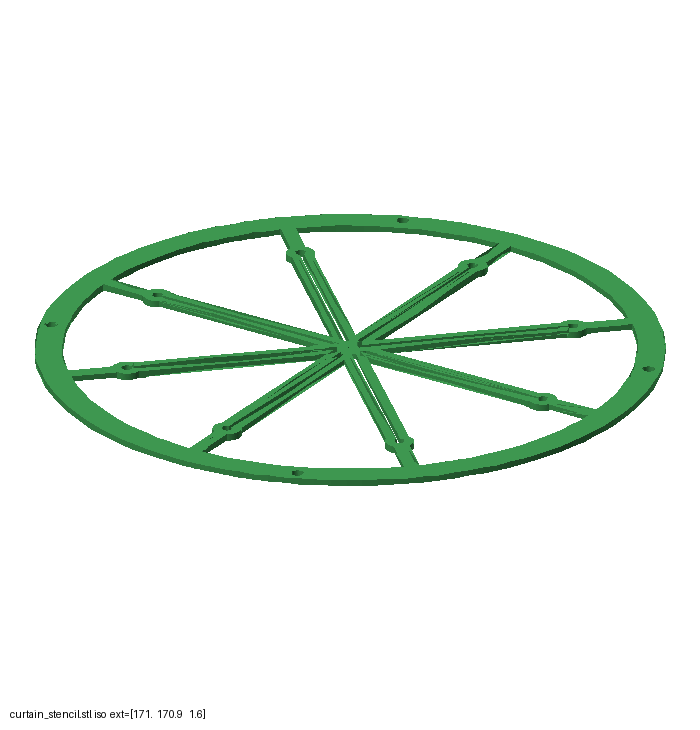
docs/images/stl/curtain_stencil_iso.png
