TheRageKage12/drunk-lantern-power-battery/docs/images/stl/diffuser_iso.png

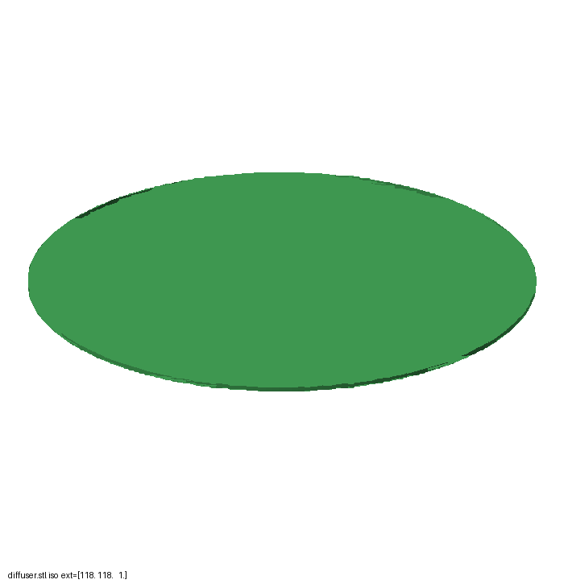
docs/images/stl/diffuser_iso.png
