TheRageKage12/drunk-lantern-power-battery/docs/images/stl/diffuser_top.png

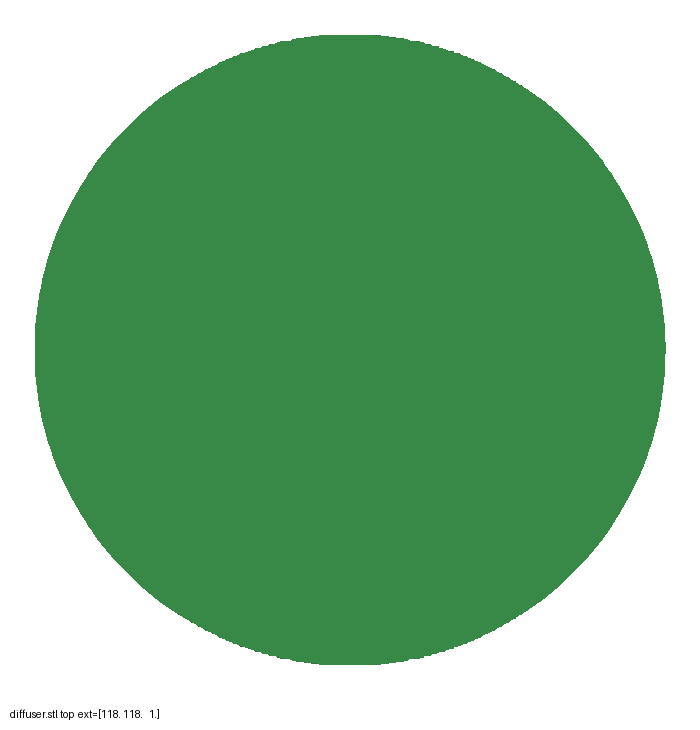
docs/images/stl/diffuser_top.png
