TheRageKage12/drunk-lantern-power-battery/docs/images/stl/emblem_centre_iso.png

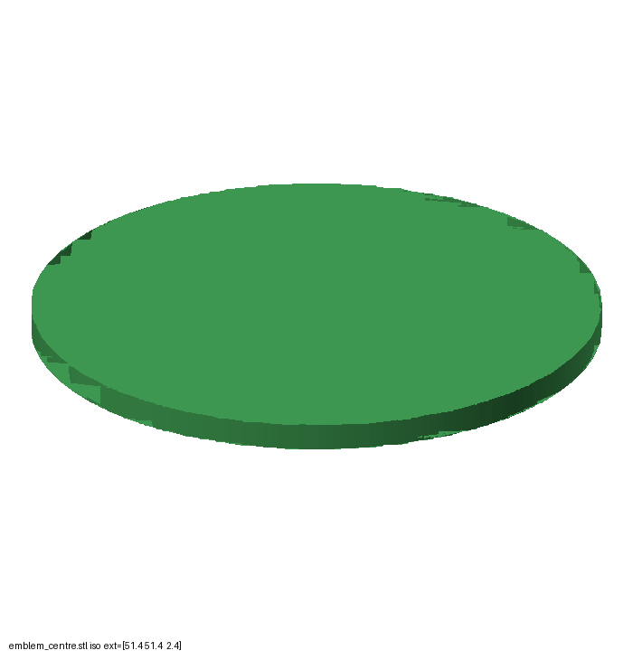
docs/images/stl/emblem_centre_iso.png
