TheRageKage12/drunk-lantern-power-battery/docs/images/stl/emblem_jig_iso.png

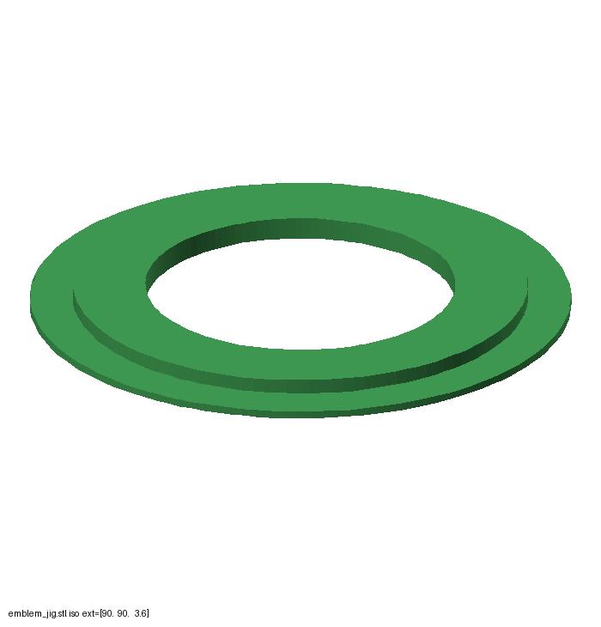
docs/images/stl/emblem_jig_iso.png
