TheRageKage12/drunk-lantern-power-battery/docs/images/stl/emblem_lid_top.png

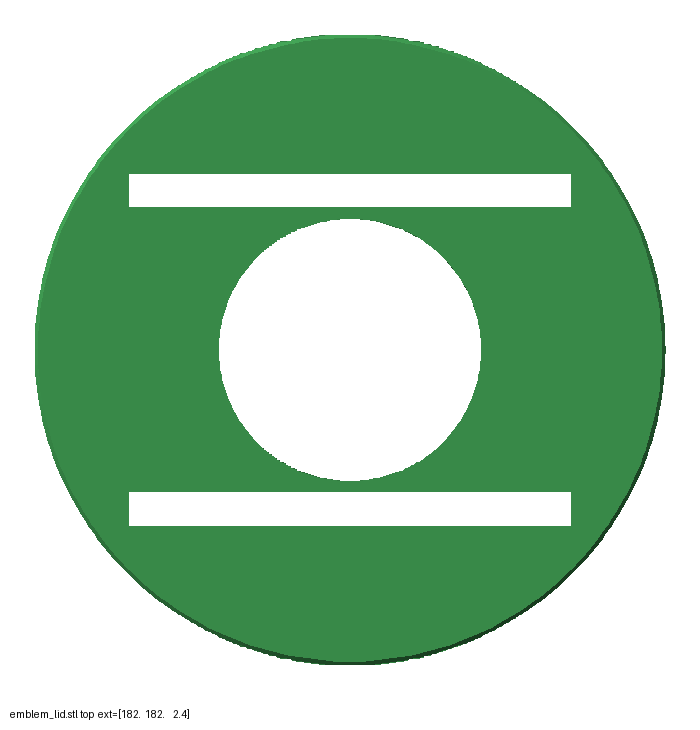
docs/images/stl/emblem_lid_top.png
