TheRageKage12/drunk-lantern-power-battery/docs/images/stl/foot_front.png

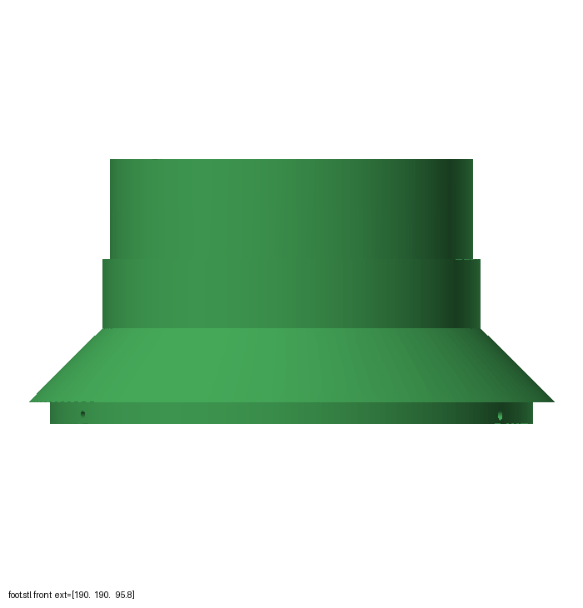
docs/images/stl/foot_front.png
