TheRageKage12/drunk-lantern-power-battery/docs/images/stl/foot_iso.png

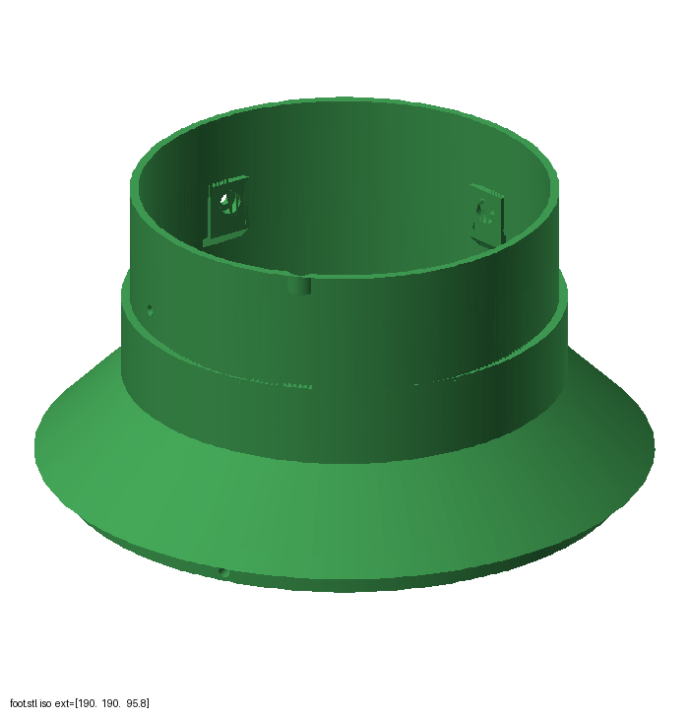
docs/images/stl/foot_iso.png
