TheRageKage12/drunk-lantern-power-battery/docs/images/stl/glass_well_front.png

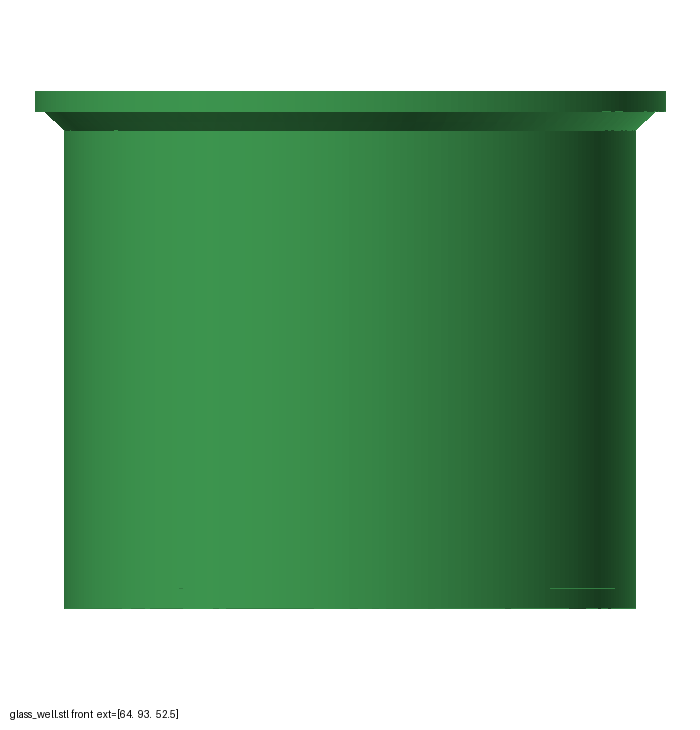
docs/images/stl/glass_well_front.png
