TheRageKage12/drunk-lantern-power-battery/docs/images/stl/glass_well_iso.png

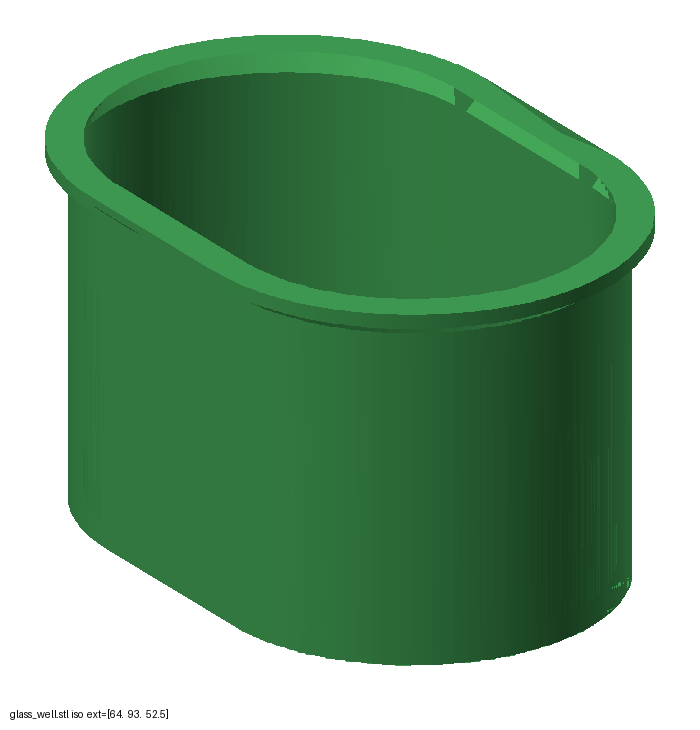
docs/images/stl/glass_well_iso.png
