TheRageKage12/drunk-lantern-power-battery/docs/images/stl/glass_well_top.png

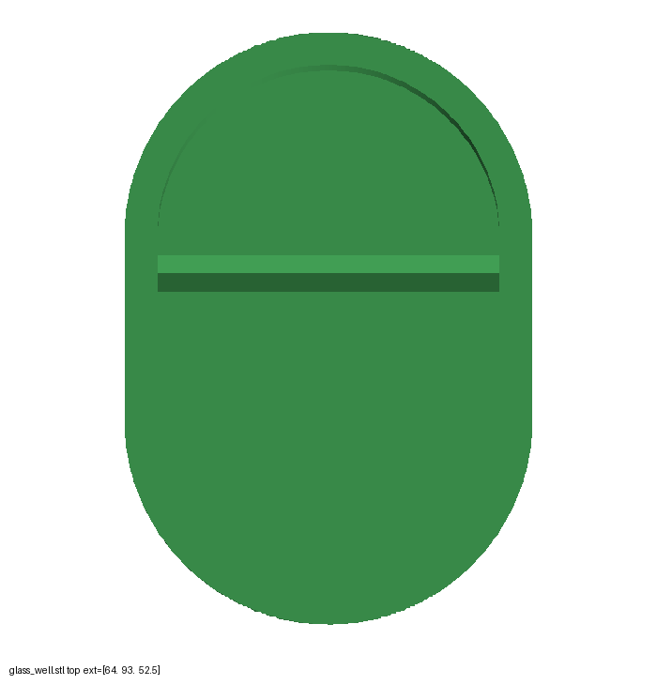
docs/images/stl/glass_well_top.png
