TheRageKage12/drunk-lantern-power-battery/docs/images/stl/handle_arc_1_iso.png

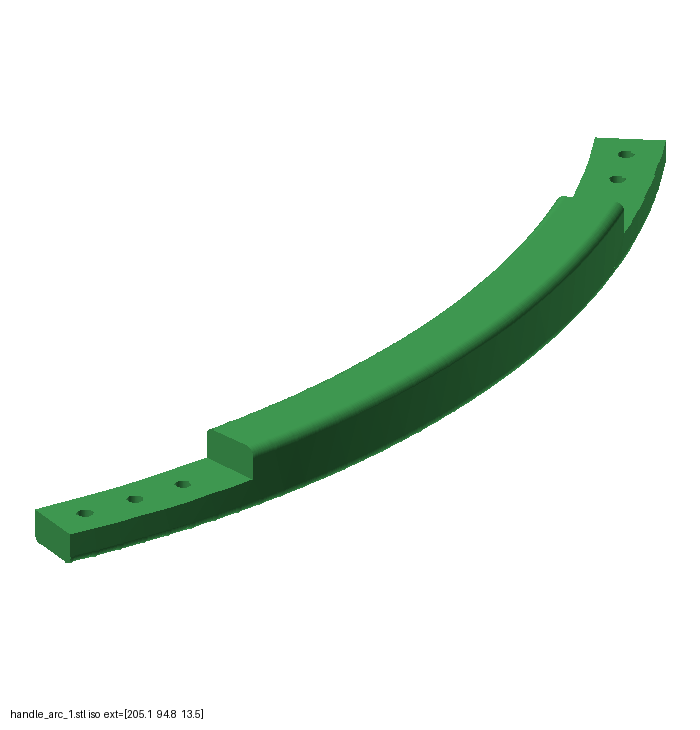
docs/images/stl/handle_arc_1_iso.png
