TheRageKage12/drunk-lantern-power-battery/docs/images/stl/handle_arc_1_top.png

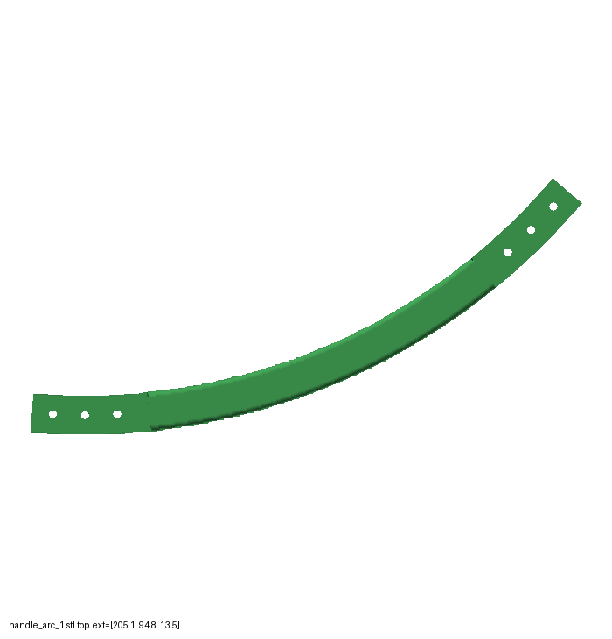
docs/images/stl/handle_arc_1_top.png
