TheRageKage12/drunk-lantern-power-battery/docs/images/stl/handle_arc_2_front.png

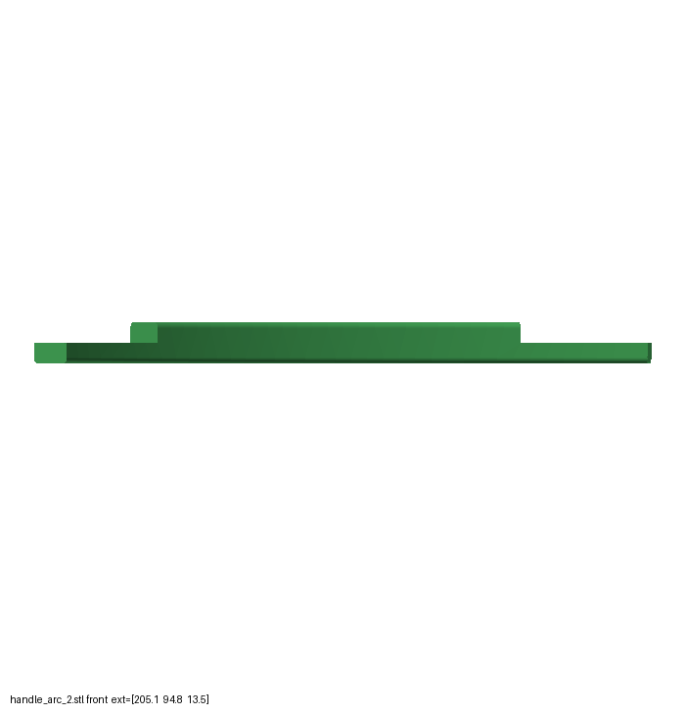
docs/images/stl/handle_arc_2_front.png
