TheRageKage12/drunk-lantern-power-battery/docs/images/stl/handle_arc_2_iso.png

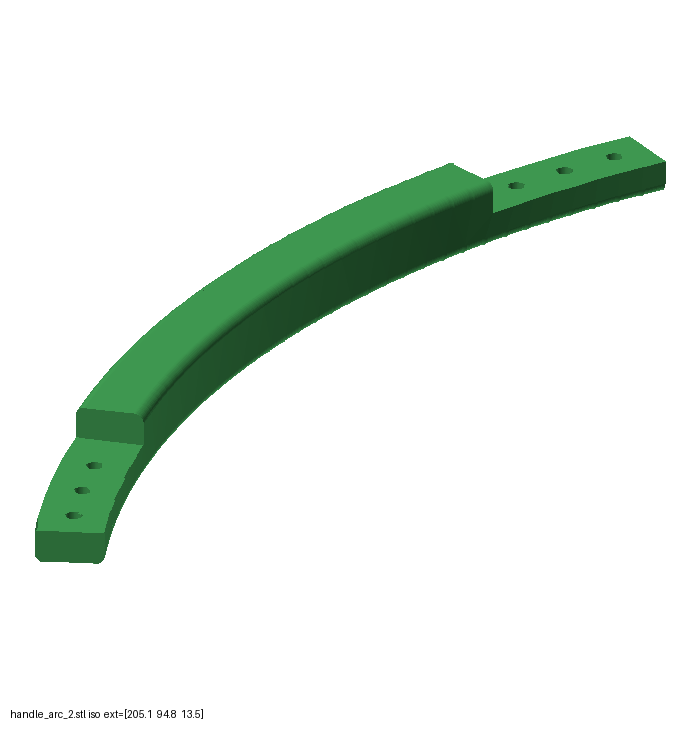
docs/images/stl/handle_arc_2_iso.png
