TheRageKage12/drunk-lantern-power-battery/docs/images/stl/handle_end_left_top.png

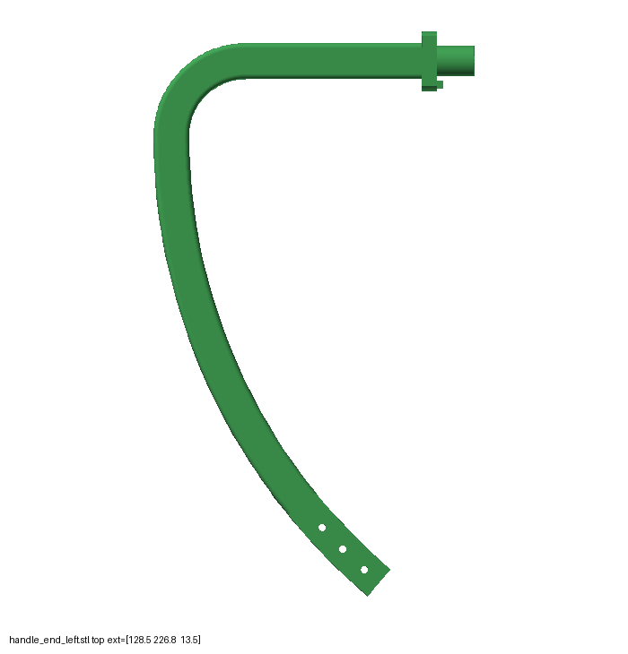
docs/images/stl/handle_end_left_top.png
