TheRageKage12/drunk-lantern-power-battery/docs/images/stl/handle_end_right_iso.png

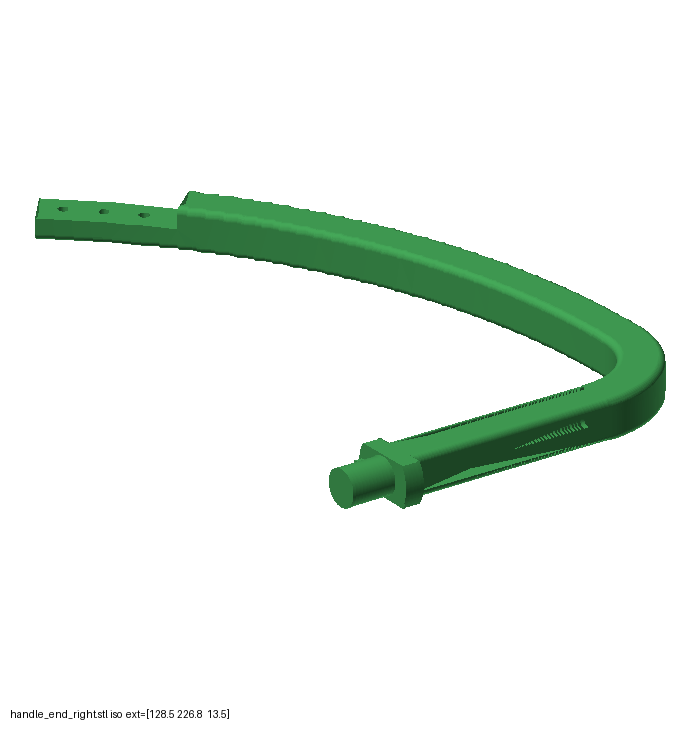
docs/images/stl/handle_end_right_iso.png
