TheRageKage12/drunk-lantern-power-battery/docs/images/stl/handle_pivot_left_iso.png

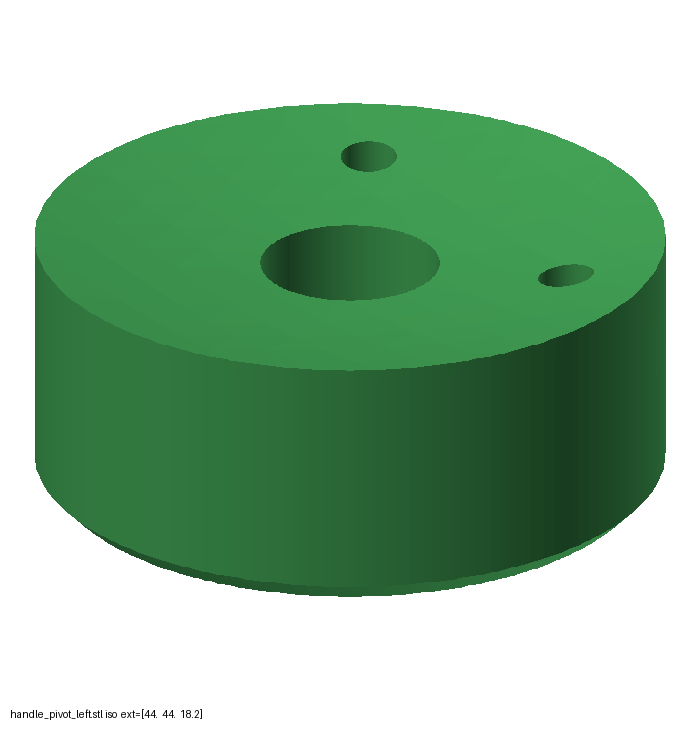
docs/images/stl/handle_pivot_left_iso.png
