TheRageKage12/drunk-lantern-power-battery/docs/images/stl/key_cap_front.png

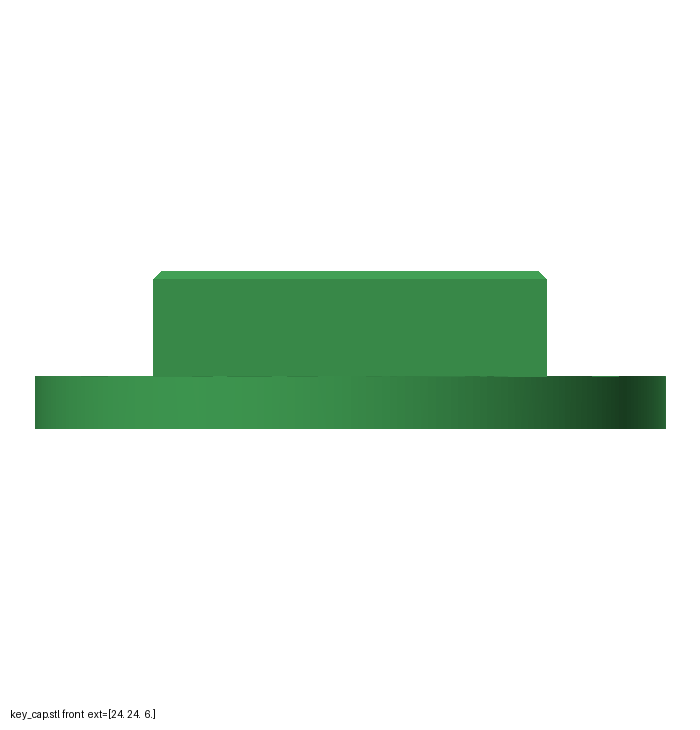
docs/images/stl/key_cap_front.png
