TheRageKage12/drunk-lantern-power-battery/docs/images/stl/key_cap_iso.png

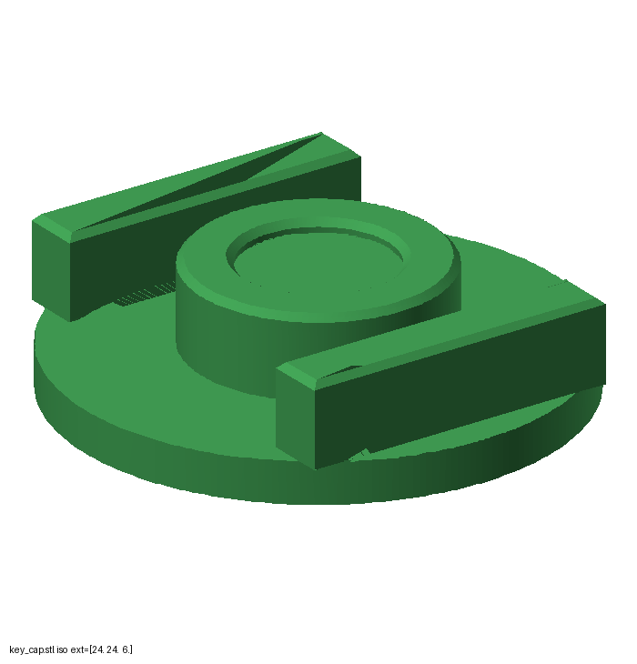
docs/images/stl/key_cap_iso.png
