TheRageKage12/drunk-lantern-power-battery/docs/images/stl/key_cap_top.png

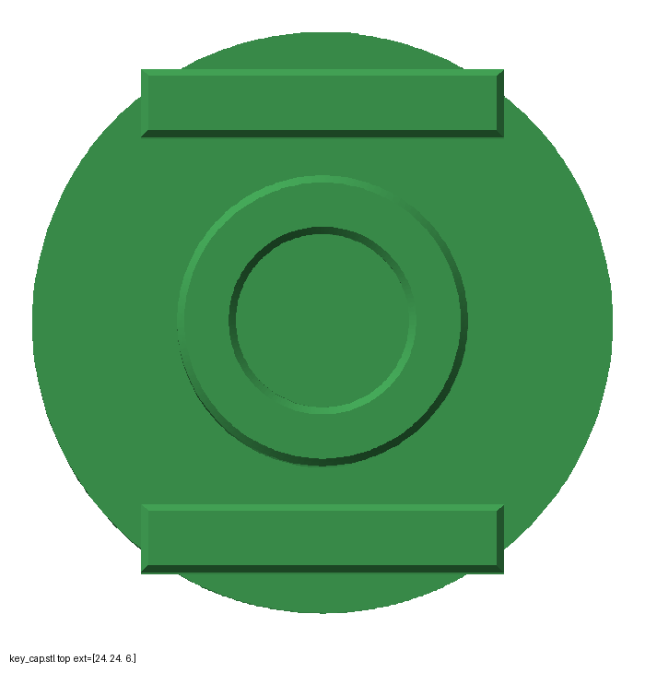
docs/images/stl/key_cap_top.png
