TheRageKage12/drunk-lantern-power-battery/docs/images/stl/key_ring_front.png

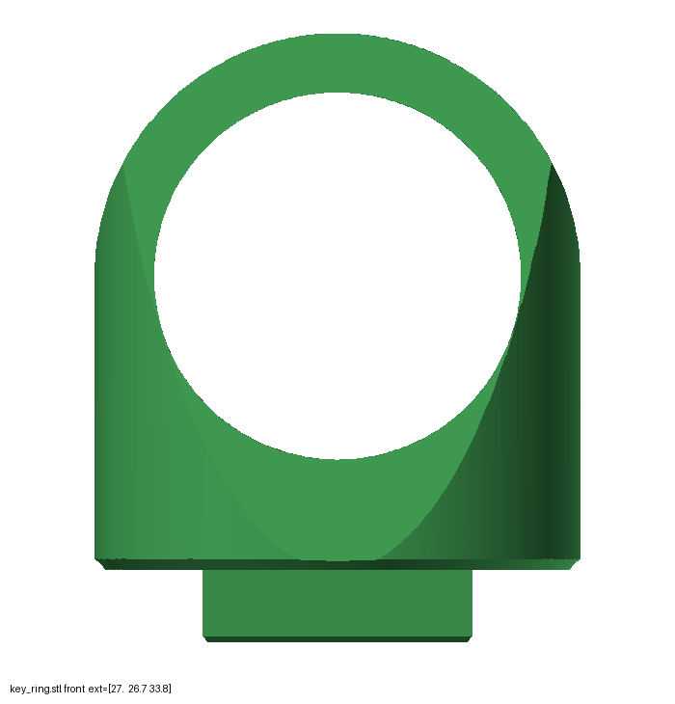
docs/images/stl/key_ring_front.png
