TheRageKage12/drunk-lantern-power-battery/docs/images/stl/key_ring_iso.png

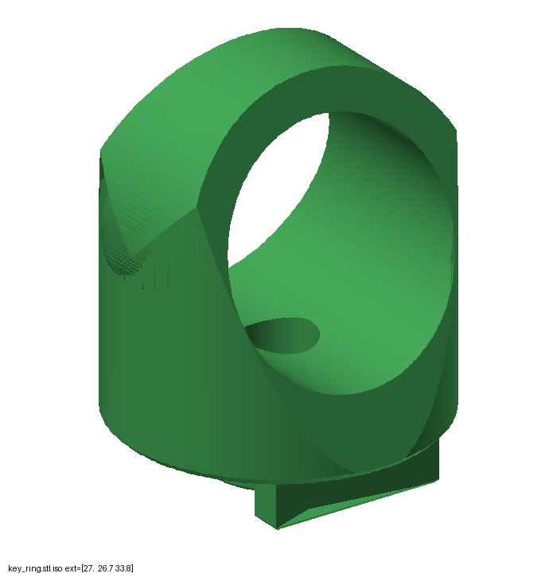
docs/images/stl/key_ring_iso.png
