TheRageKage12/drunk-lantern-power-battery/docs/images/stl/led_panel_top.png

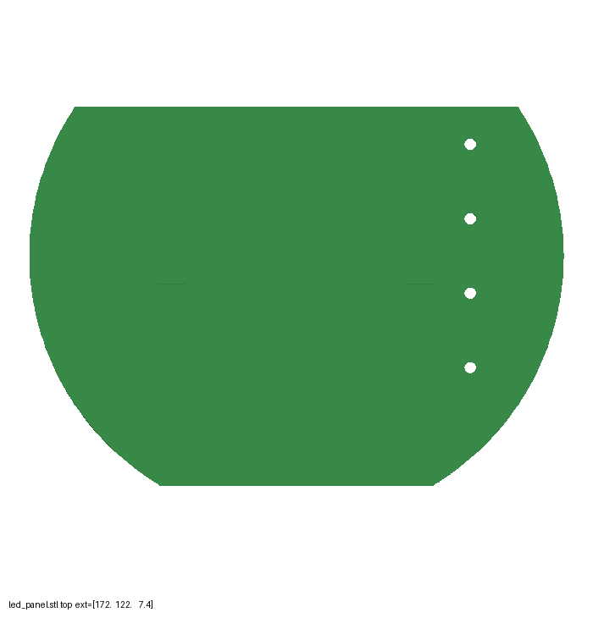
docs/images/stl/led_panel_top.png
