TheRageKage12/drunk-lantern-power-battery/docs/images/stl/lock_wall_iso.png

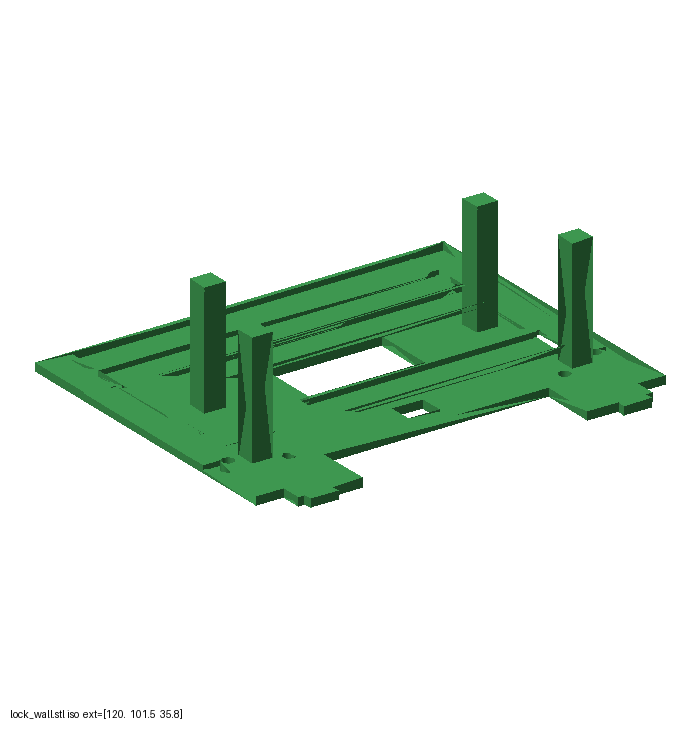
docs/images/stl/lock_wall_iso.png
