TheRageKage12/drunk-lantern-power-battery/docs/images/stl/lock_wall_top.png

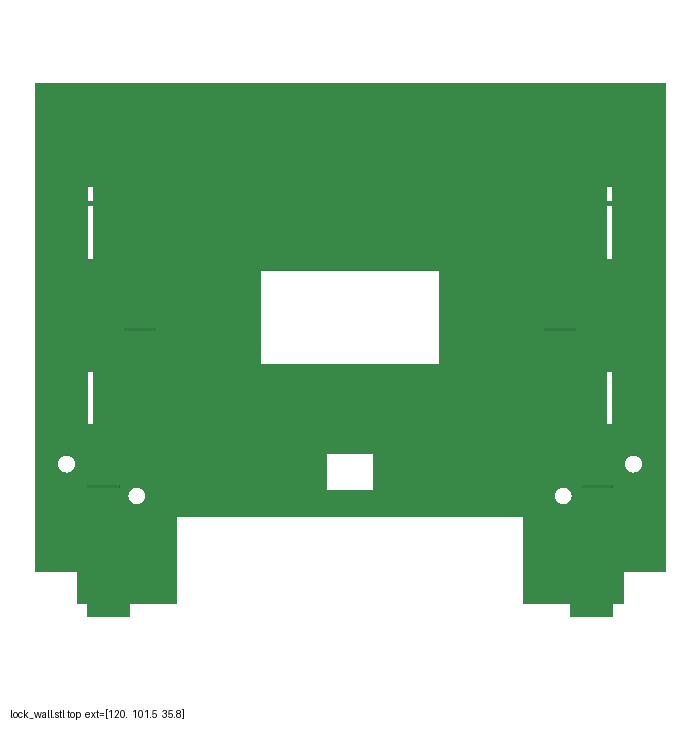
docs/images/stl/lock_wall_top.png
