TheRageKage12/drunk-lantern-power-battery/docs/images/stl/plunger_front.png

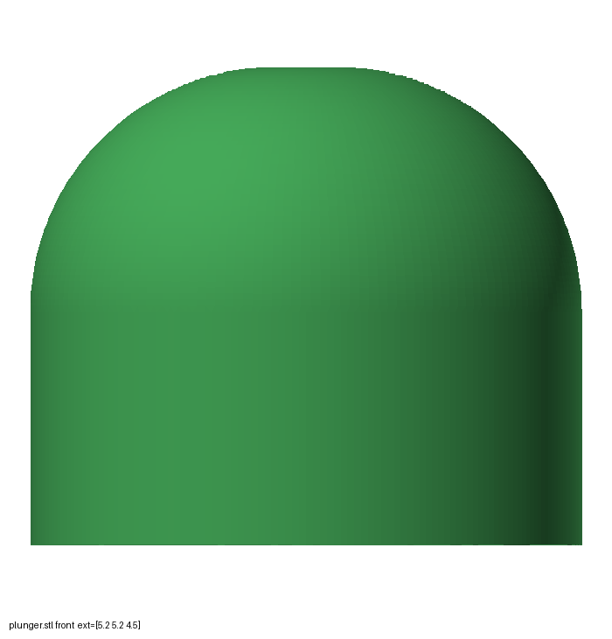
docs/images/stl/plunger_front.png
