TheRageKage12/drunk-lantern-power-battery/docs/images/stl/plunger_iso.png

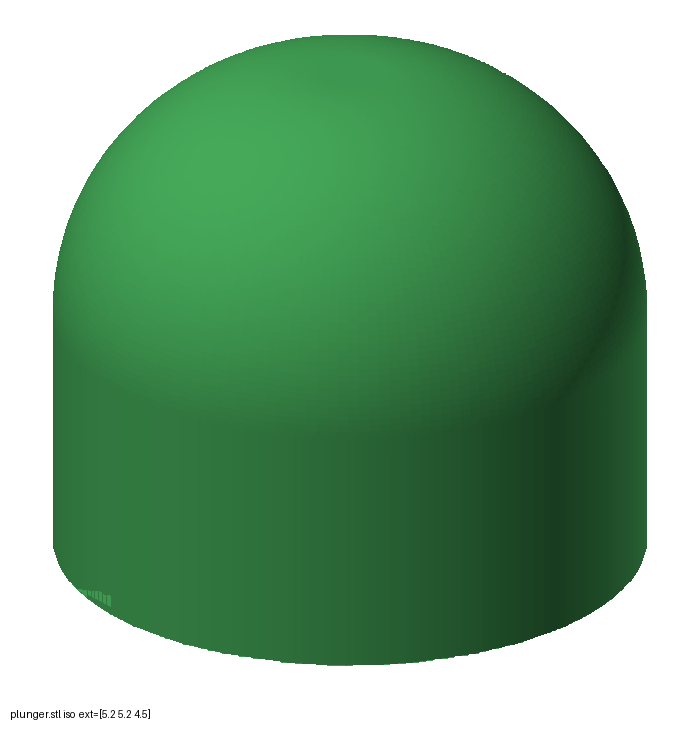
docs/images/stl/plunger_iso.png
