TheRageKage12/drunk-lantern-power-battery/docs/images/stl/plunger_top.png

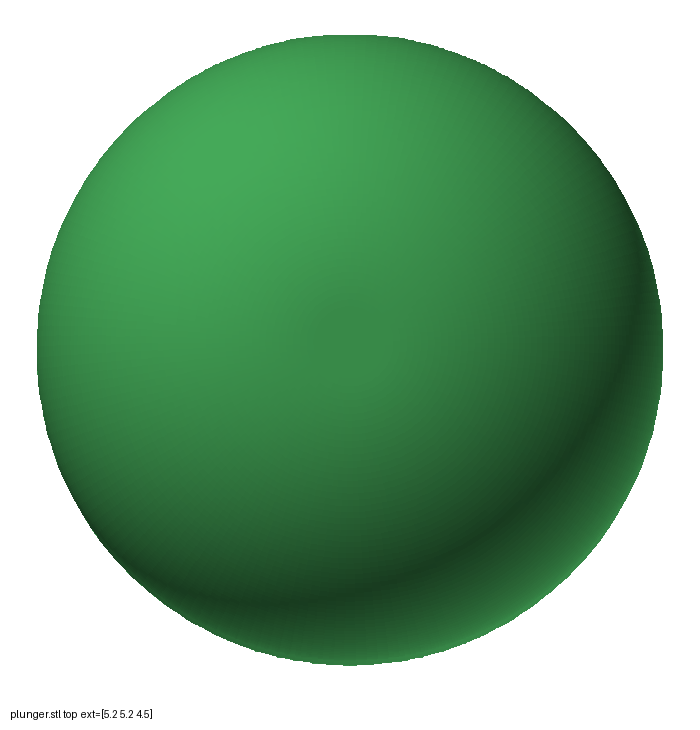
docs/images/stl/plunger_top.png
