TheRageKage12/drunk-lantern-power-battery/docs/images/stl/ring_sizer_iso.png

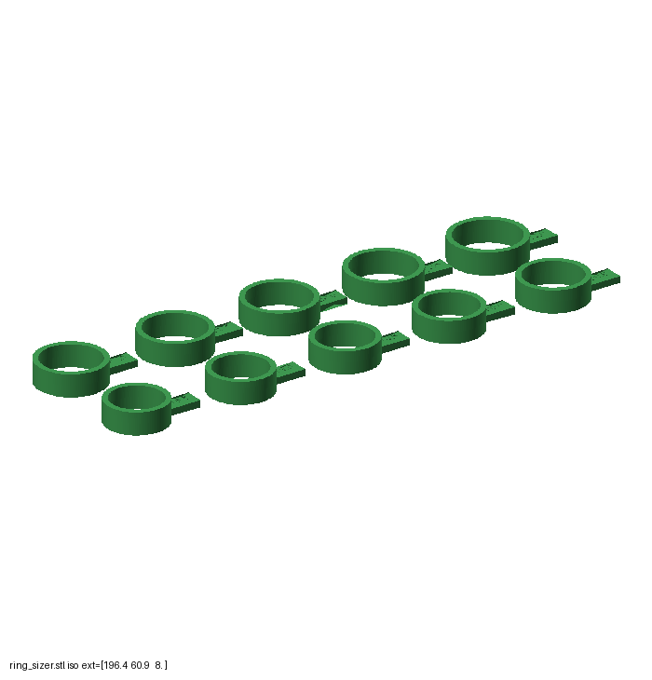
docs/images/stl/ring_sizer_iso.png
