TheRageKage12/drunk-lantern-power-battery/docs/images/stl/rotor_iso.png

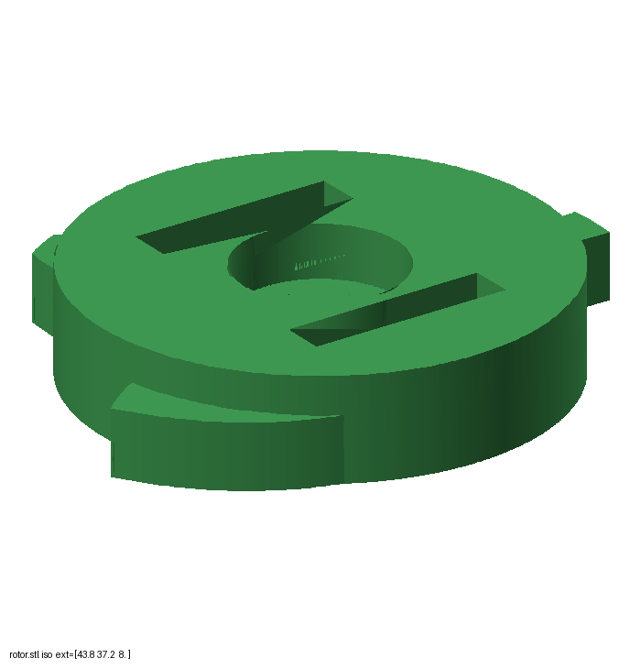
docs/images/stl/rotor_iso.png
