TheRageKage12/drunk-lantern-power-battery/docs/images/stl/rotor_top.png

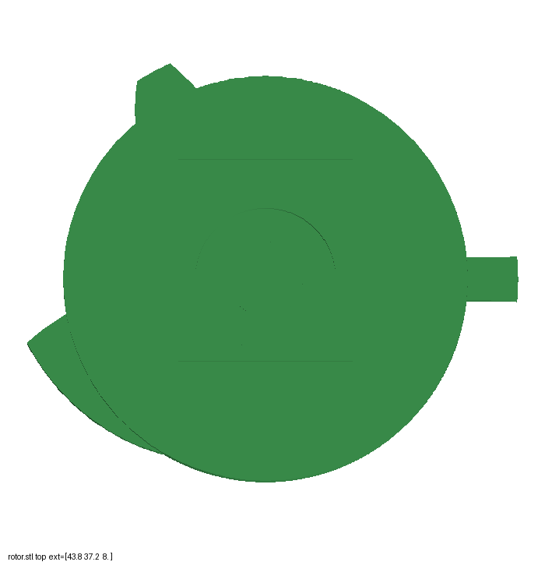
docs/images/stl/rotor_top.png
