TheRageKage12/drunk-lantern-power-battery/docs/images/stl/screw_cap_top.png

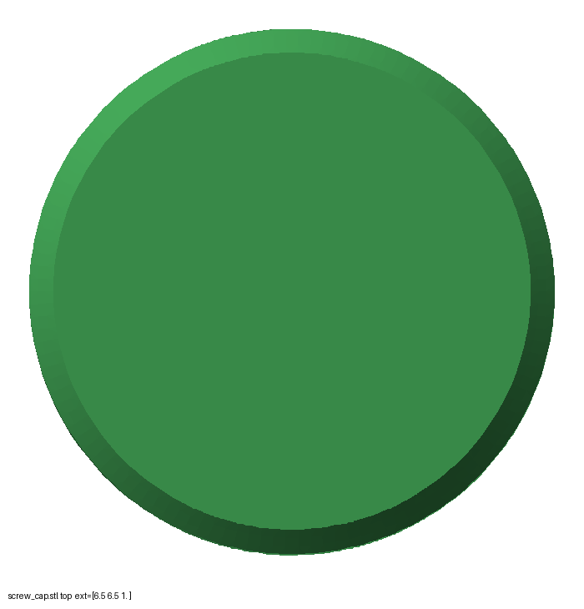
docs/images/stl/screw_cap_top.png
