TheRageKage12/drunk-lantern-power-battery/docs/images/stl/socket_base_iso.png

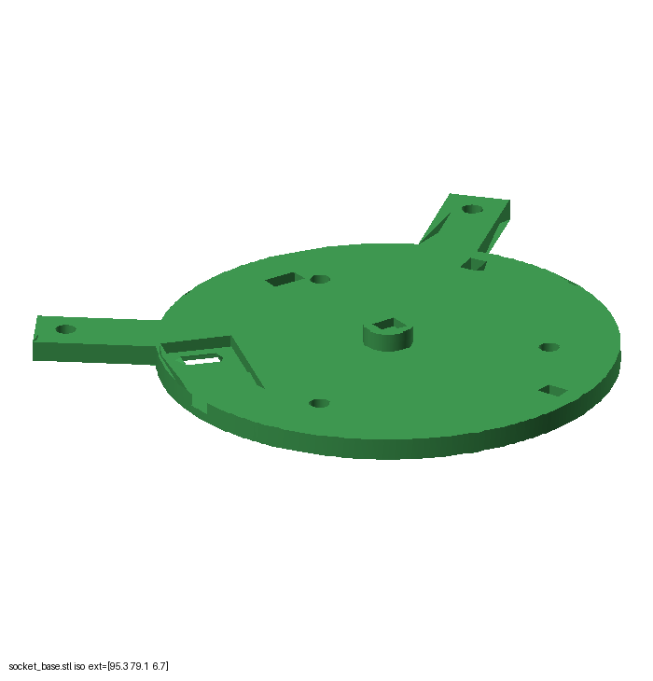
docs/images/stl/socket_base_iso.png
