TheRageKage12/drunk-lantern-power-battery/docs/images/stl/socket_base_top.png

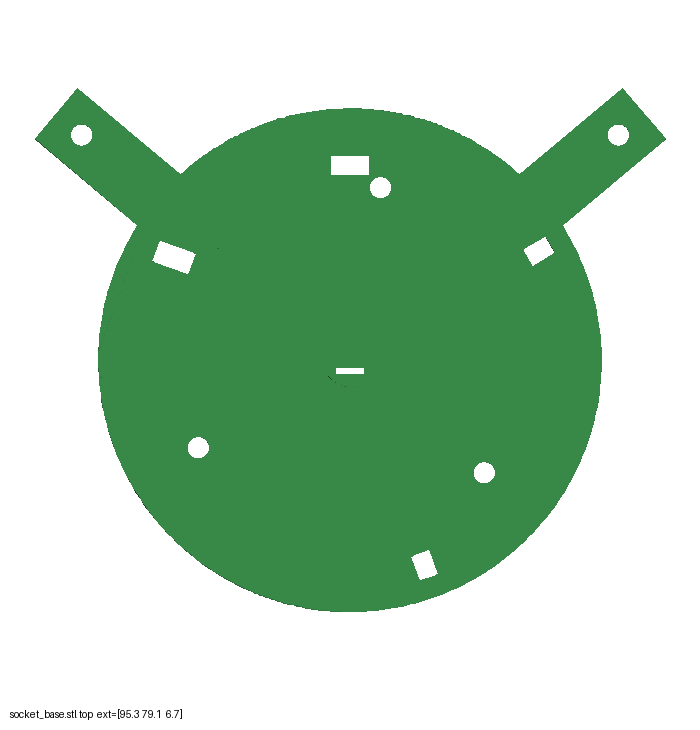
docs/images/stl/socket_base_top.png
