TheRageKage12/drunk-lantern-power-battery/docs/images/stl/socket_housing_iso.png

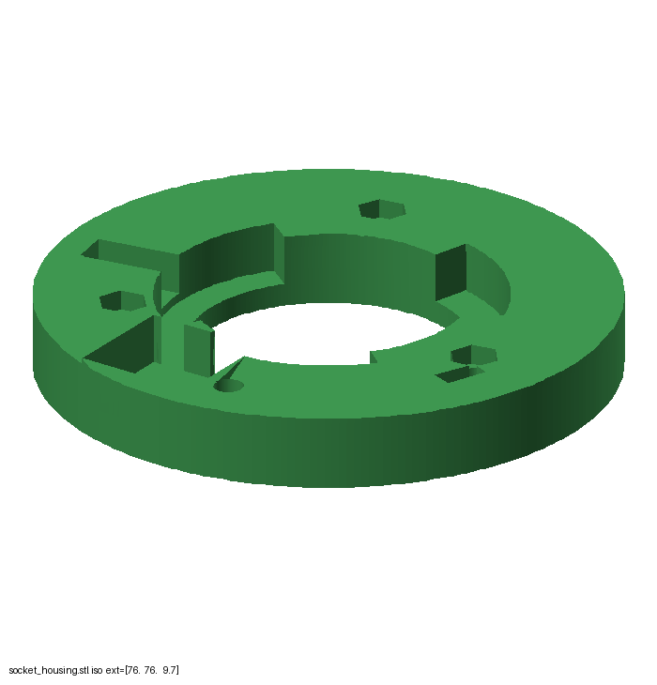
docs/images/stl/socket_housing_iso.png
