TheRageKage12/drunk-lantern-power-battery/docs/images/stl/sphere_front_front.png

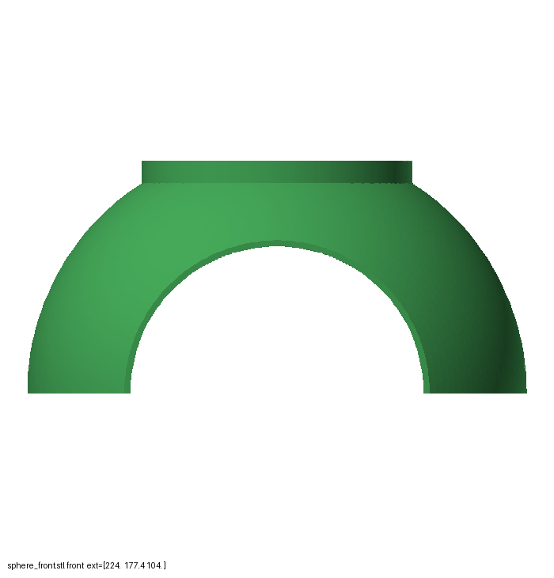
docs/images/stl/sphere_front_front.png
