TheRageKage12/drunk-lantern-power-battery/docs/images/stl/sphere_front_top.png

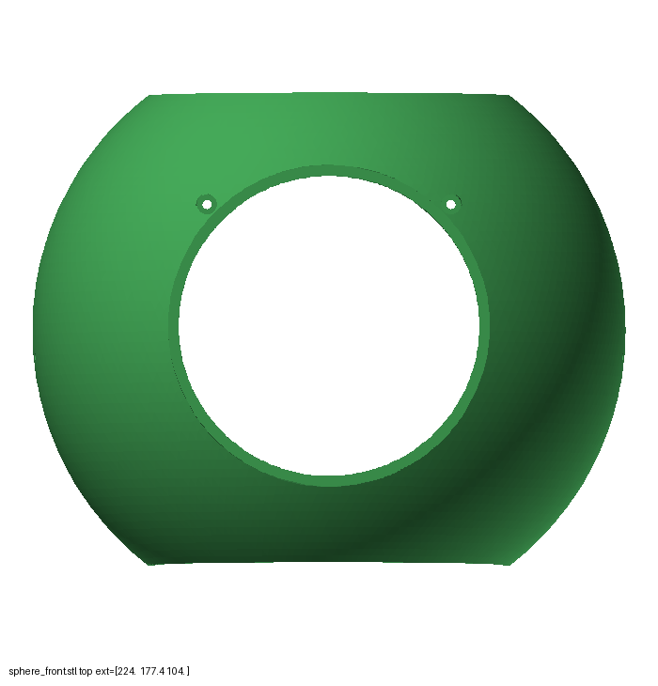
docs/images/stl/sphere_front_top.png
