TheRageKage12/drunk-lantern-power-battery/docs/images/stl/switch_bracket_iso.png

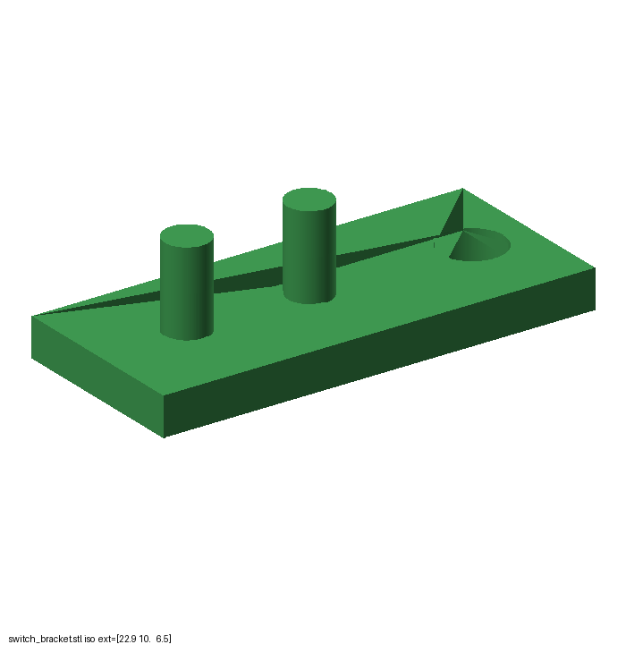
docs/images/stl/switch_bracket_iso.png
