TheRageKage12/drunk-lantern-power-battery/docs/images/stl/top_cap_front.png

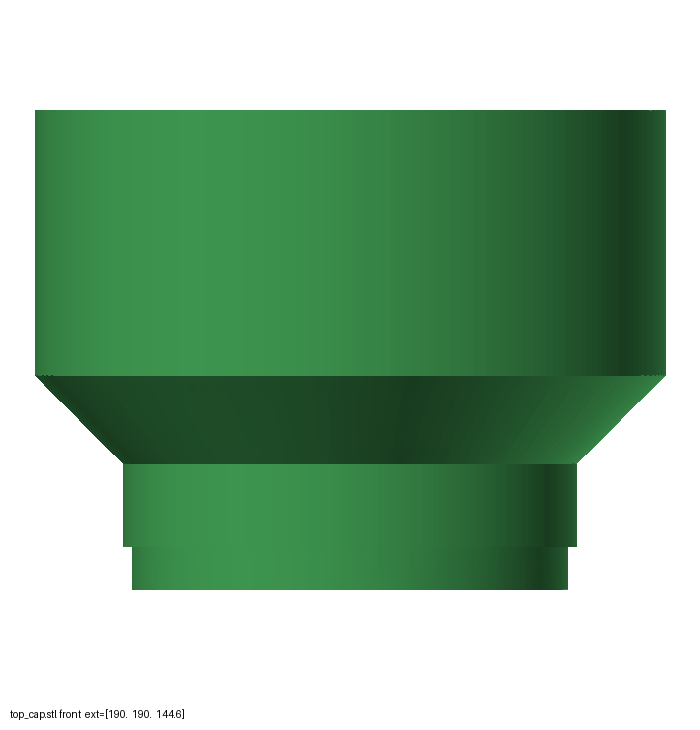
docs/images/stl/top_cap_front.png
