TheRageKage12/drunk-lantern-power-battery/docs/images/stl/wall_extension_iso.png

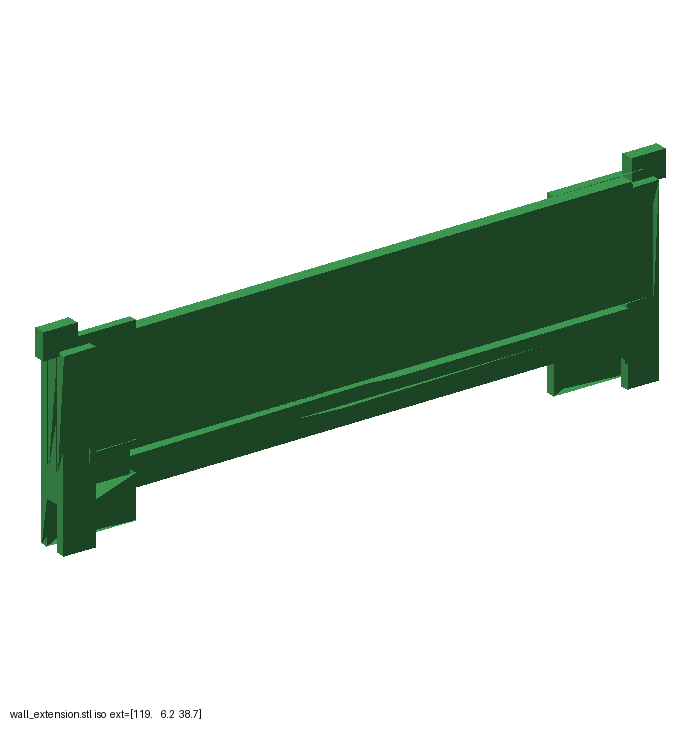
docs/images/stl/wall_extension_iso.png
