TheRageKage12/drunk-lantern-power-battery/docs/research/seattle-sourcing.md

> **Historical.** Written early in the design (revisions 2-5). It still describes NeoPixel and DRV5032 parts from Adafruit, heat-set inserts, the door and tray, Loctite, a 180 mm base. The current design is in `docs/BUILD_GUIDE.md`, `cad/params.py` and `cad/DESIGN_CONTRACT.md`; the decisions are summarised in `docs/review/CONTEXT.md`.

# Seattle-area sourcing for small-quantity parts

Researched 2026-10-11; independently fact-checked 2026-10-11 (see Fact-check notes at the end). Every address/hour/price below comes from a page that was fetched (named in the Source column) unless marked **estimate** or **unconfirmed**. Big-box product pages (Home Depot, Lowe's, Ace online) blocked fetching (HTTP 403), so those stock claims are labeled accordingly.

## Decisions / recommendations

- **Electronics: go to Vetco Electronics, Bellevue.** It is the only confirmed-open walk-in component store in the metro. Confirmed in stock online (same inventory as the store): 1/4 W resistors, heat shrink, JST PH/SM/RCY pre-wired pairs ($2-3), 2.0 mm KHS/JST housings + crimp pins, perfboard ($3.49+), inline 3AG/5x20 fuse holders ($2.39-2.99), 5x20 mm fuses (5-pk $6.50), A3144EUA Hall sensor ($1.99), 74AHCT125 level shifter ($2.95), microswitches ($1.59 no-lever to $7.95 Honeywell lever; the two lever types in the Products table are $2.74-2.99), mini/sub-mini toggle switches ($1.99-4.99), 1 m WS2812 strip ($19.95). **Not stocked: Seeed XIAO (order from Amazon/Adafruit), neodymium disc magnets, heat-set inserts.**
- **Supertronix/Alphatronics (Tukwila), Radar Inc (Bothell): do not plan on them.** supertronix.com is a parked GoDaddy for-sale page; alphatronicsusa.com does not resolve; no post-2016 evidence either exists. Treat as closed.
- **Hardwick's (U-District) is gone.** Seattle store closed September 2020; the company is in Post Falls, Idaho, and its own site says the Post Falls brick-and-mortar store is "Opening 2027" (online only today).
- **Metric M3 fasteners in small counts: Tacoma Screw (Ballard or Georgetown branch, weekday-only hours, Ballard also Sat 9-1) is the best bet** for exact-spec M3 socket-head screws, nuts, washers by the piece or small bag. Backup: Stoneway Hardware Ballard ("fasteners by the piece or by the box"), McLendon (Renton / White Center), any Seattle Ace (Magnolia, Maple Leaf, Junction confirmed via Checkbook; Tweedy & Popp (unverified)). Vetco also sells M3 brass standoffs/screws individually ($0.25-0.99).
- **Heat-set inserts: no Seattle retail source found** (Vetco search returns none; hardware stores do not carry them - estimate). Buy online (Amazon pack, see Products).
- **Springs: Vetco sells Hillman compression springs individually ($1.29 ea, confirmed).** Ace/McLendon/Stoneway have Hillman/Century Spring drawers (standard for these chains, but not fetch-confirmed). No Seattle "spring shop" for one-off hobby springs was confirmed; McMaster-Carr online is the exact-spec fallback.
- **Magnets: K&J Magnetics online (D41 = 1/4 x 1/16 in, $0.28 ea; D42 = 1/4 x 1/8 in, $0.41 ea) or the Amazon SMARTAKE 6x2 mm 45-pack already on the shortlist.** Vetco has no neodymium discs. Home Depot/Lowe's Master Magnetics blister packs exist chain-wide (unconfirmed here, estimate).
- **Food-grade tubing / bottles: Micro Homebrew (Kenmore) is the only homebrew shop confirmed open.** Sound Homebrew Supply (Georgetown) - its domain now redirects to an unrelated hydraulics business; treat as closed until phoned. Mountain Homebrew (Kirkland) - its domain is now a generic blog; unconfirmed. Micro Homebrew's site does not list tubing sizes; call 425-892-8425 before driving. For the pump head itself use the correct 1/8 in ID x 1/4 in OD platinum silicone from Amazon; homebrew shops typically stock 3/16 in and 1/4 in ID silicone/vinyl by the foot (estimate).
- **Shot glasses / small squeeze bottles: Bargreen Ellingson Seattle showroom (SoDo, site says it serves "home kitchens and commercial kitchen professionals", Mon-Fri 10-3 only)**, Uwajimaya (daily 8-9), Container Store Bellevue, Daiso Westwood Village (West Seattle; address/hours unverified).
- **Big prints that exceed a 220 x 220 bed: KCLS Bellevue Library Makerspace is free** (no library card needed) with Prusa Core One (250 x 220 x 270 mm), MK4, MK3S and PETG on hand, 2 h/week reservation. Seattle Makers (Interbay) has Prusa MK4s/MK3S+ (members $75/mo plus paid machine time and a certification class, or $20 guest pass with a member). Online: JLC3DP (PLA "from $1.00", 72 h build) / PCBWay (PETG, instant quote) / Craftcloud (no minimum). Metrix Create:Space closed 2018 (per article headline/URL; page fetch blocked); SoDo MakerSpace domain is dead; SPL public 3D printing: not checked (unverified).

## Facts and numbers

| Store / item | Address | Phone | Hours | Buy here | Source |
|---|---|---|---|---|---|
| Vetco Electronics | 12718 Northup Way, STE 100, Bellevue, WA 98005 | 425-641-7275 | Mon-Fri 9am-6pm, Sat 10am-3:30pm (site also warns hours may differ; a search snippet showed 8-5:30 - call) | resistors, caps, wire, heat shrink, JST, perfboard, fuse holders/fuses, switches, Hall sensor, 74AHCT125, WS2812 strips, M3 standoffs, Hillman springs | [vetco.net](https://vetco.net), [JST search](https://vetco.net/search?q=jst), [fuse holder search](https://vetco.net/search?q=fuse+holder), [micro switch search](https://vetco.net/search?q=micro+switch), [74AHCT125](https://vetco.net/search?q=74AHCT125), [hall effect](https://vetco.net/search?q=hall+effect), [neopixel](https://vetco.net/search?q=neopixel), [perfboard](https://vetco.net/search?q=perfboard), [m3](https://vetco.net/search?q=m3), [spring](https://vetco.net/search?q=spring) |
| Vetco - NOT stocked | - | - | - | XIAO (0 results), neodymium magnets (only a "5lb Rare Earth Magnet" $9.95, no discs), heat-set inserts (0) | [xiao](https://vetco.net/search?q=xiao), [neodymium](https://vetco.net/search?q=neodymium), [heat set insert](https://vetco.net/search?q=heat+set+insert) |
| Hardwick's (CLOSED in Seattle) | was 4214 Roosevelt Way NE; now 3820 E Mullan Ave, Post Falls, ID 83854 | - | Seattle store last day Sept 19, 2020; site footer: "Brick & Mortar Store Opening 2027" | nothing locally | [KIRO 7, 2020-09-19](https://www.kiro7.com/news/local/beloved-family-owned-hardware-store-closing-its-doors-after-almost-90-years-business/Z25CQVX5QNGP3DAENQOPSUTRDY), [hardwickandsons.com FAQ](https://hardwickandsons.com/pages/faqs) |
| Supertronix (Tukwila) | - | - | domain parked / for sale | do not rely on | [supertronix.com](https://www.supertronix.com/) (307 to GoDaddy for-sale page) |
| Tacoma Screw - Ballard | 3930 Leary Way N.W., Seattle 98107 | (206) 632-7565 | Mon-Fri 7-5, Sat 9-1 | M3 screws/nuts/washers by the piece; springs (ask at counter - online search shows none) | [tacomascrew.com/LocationFinder](https://www.tacomascrew.com/LocationFinder) |
| Tacoma Screw - Georgetown | 1121 S. Bailey Street, Seattle 98108 | (206) 767-3750 | Mon-Fri 7-5 | same | same |
| Tacoma Screw - Kirkland | 11200 120th Avenue N.E., Kirkland 98033 | (425) 822-2585 | Mon-Fri 7-5 | same (near Vetco) | same |
| Tacoma Screw - Kent | 22123 84th Avenue S., Kent 98032 | (253) 395-9770 | Mon-Fri 7-5 | same | same |
| Stoneway Hardware Ballard (independent; site links to Do it Best, no Ace affiliation shown) | 4910 15th Ave NW, Seattle 98107 | (206) 724-0571 | Mon-Fri 8-7, Sat 9-6, Sun 10-6 | "fasteners by the piece or by the box"; springs/magnets likely (estimate) | [stonewayhardware.com](https://www.stonewayhardware.com/) |
| Magnolia Ace Hardware | 2420 32nd Ave W, Seattle 98199 | 206-282-1916 | Mon-Sat 9-6, Sun 10-5 (unverified: from an earlier search snippet; acehardware.com returns 403 and Checkbook lists no hours - call) | Hillman metric drawers, spring drawers, Master Magnetics (estimate) | [checkbook.org](https://checkbook.org/wa/seattle/hardware-stores/magnolia-ace-hardware/504z7), [acehardware.com #05279](https://acehardware.com/store-details/05279) |
| Maple Leaf Ace Hardware | 9000 Roosevelt Way NE, Seattle 98115 | 206-522-3324 | not confirmed (call) | same; Checkbook top-rated, reviews through Sep 2026 | [checkbook.org](https://checkbook.org/wa/seattle/hardware-stores/maple-leaf-ace-hardware/4qfn3) |
| Junction Ace Hardware (ex-Junction True Value), West Seattle | 4747 44th Ave SW, Seattle 98116 | 206-932-0450 | not confirmed (call) | same; reviews through Aug 2026 | [checkbook.org](https://checkbook.org/wa/seattle/hardware-stores/junction-true-value-hardware/pp552) |
| Tweedy & Popp Ace - UW (unverified) | 4731 University Way NE, Seattle 98105 (unverified) | - | Mon-Fri 9:15-7, Sat 9:15-6, Sun 10-5 (unverified: search snippet only; acehardware.com returns 403) | same | [acehardware.com #17725](https://acehardware.com/store-details/17725) |
| McLendon Hardware - Renton | 440 Rainier Ave. S, Renton 98057 | (425) 235-3555 | Mon-Fri 7-8, Sat 8-8, Sun 9-7 | big fastener wall incl. metric, springs, magnets, tubing, adhesives | [mclendons.com/locations](https://www.mclendons.com/locations) |
| McLendon Hardware - White Center | 10210 16th Ave. SW, Seattle 98146 | (206) 762-4090 | Mon-Sat 8-8, Sun 9-7 | same | same |
| Hillman M3-0.50 x 10 mm pan head, pack of 4 | retail chains | - | $1.49 at Tractor Supply (item 3286045) (unverified: search snippet only; page returned HTTP 503 on two fetch attempts) - shows the Hillman small-pack SKU family big-box stores carry | M3 screws | [tractorsupply.com](https://www.tractorsupply.com/tsc/product/hillman-metric-pan-head-phillips-machine-screw-m3-05-x-10mm-3286045) (search snippet; Home Depot/Lowe's pages returned 403) |
| K&J Magnetics D41 | online | - | 1/4 x 1/16 in (6.35 x 1.59 mm), N42, $0.28 ea (1-49), pull 1.19 lb | ring-key magnet, same footprint as 6x2 mm pocket | [kjmagnetics D41](https://www.kjmagnetics.com/proddetail.asp?prod=D41) |
| K&J Magnetics D42 | online | - | 1/4 x 1/8 in (6.35 x 3.17 mm), N42, $0.41 ea, pull 2.3 lb | stronger hatch latches | [kjmagnetics D42](https://www.kjmagnetics.com/proddetail.asp?prod=D42) |
| Micro Homebrew (Kenmore) | 17511 68th Ave NE, Kenmore 98028 | 425.892.8425 | Mon 10-6, Tue closed, Wed-Fri 10-6, Sat 10-5, Sun 10-4 | silicone/vinyl tubing by the foot, small bottles, sanitizer (tubing not listed on site - call) | [microhomebrew.com](https://www.microhomebrew.com/) |
| Sound Homebrew Supply (Georgetown) - UNCONFIRMED, likely closed | was 6505 5th Pl S, Seattle | - | soundhomebrew.com now 301-redirects to an unrelated auto/hydraulics site; newest reference is May 2023 | - | [soundhomebrew.com](https://www.soundhomebrew.com/), [Queen Anne News 2023](https://queenannenews.com/news/2023/may/11/explore-seattle-georgetown/) |
| Mountain Homebrew (Kirkland) - UNCONFIRMED | D&B lists 8530 122nd Ave NE Ste 2B, Kirkland 98033 (unverified; D&B page returned 403 on re-check) | (425) 803-3996 (unverified) | mountainhomebrew.com is now a generic beer blog with no store info | - | [mountainhomebrew.com](https://mountainhomebrew.com/), [D&B listing](https://www.dandb.com/businessdirectory/mountainhomebrewwinesupplyinc-kirkland-wa-2203.html) |
| Bargreen Ellingson Seattle showroom | 3627 1st Ave S, Seattle 98134 | 206.682.1472 | Mon-Fri 10am-3pm showroom (official page says it serves "both home kitchens and commercial kitchen professionals"; an older SeattleMet listing says 8-6 / Sat 9-1) | shot glasses, squeeze bottles, bar tools | [bargreen.com/locations/seattle](https://www.bargreen.com/locations/seattle) |
| Uwajimaya Seattle | 600 5th Ave S, Seattle 98104 | (206) 624-6248 | daily 8am-9pm | small glass/plastic bottles, sake cups usable as shot glasses | [uwajimaya.com/visit/seattle](https://www.uwajimaya.com/visit/seattle/) |
| Daiso Westwood Village (West Seattle) (unverified) | 2600 SW Barton St, Suite E-8, Seattle 98126 (unverified: West Seattle Blog June 2024 story via search snippet; direct fetch 403 twice; daisous.com locator pages 404/0 rows) | - | 9-9 Mon-Sat, 10-8 Sun (unverified snippet, undated) | small bottles, trays, silicone bits | [westseattleblog.com](https://westseattleblog.com/2024/06/video-daiso-opens-at-westwood-village) |
| Container Store Bellevue | Lincoln Square North, 1st floor, The Bellevue Collection (street address 700 Bellevue Way NE Ste 120 is unverified - search snippet only; containerstore.com redirected) | 425-453-7120 | Mon-Sat 10-8, Sun 11-7 | travel bottles, small jars | [bellevuecollection.com](https://bellevuecollection.com/tenant/the-container-store/) |
| KCLS Bellevue Library Makerspace | 1111 110th Avenue NE, Bellevue 98004 | (425) 450-1765 | library Mon/Thu/Fri 10-6, Tue/Wed 11-8, Sat/Sun 11-6; makerspace only during posted program/reservation hours | free 3D printing; Prusa Core One, MK4, i3 MK3S (0.4 mm); PLA and PETG provided; 2 h/week reservation, 24 h notice, print must finish in window | [kcls.org/bellevuemakerspace](https://kcls.org/bellevuemakerspace/), [kcls.org/locations/bellevue](https://kcls.org/locations/bellevue/) |
| Prusa Core One build volume | - | - | 250 x 220 x 270 mm (the cited page now describes the CORE One+ / Gen 2; the original Core One spec is the same figure but was not re-fetched) | fits a 180 mm sphere half | [prusa3d.com](https://www.prusa3d.com/product/prusa-core-one/) |
| Seattle Makers (Interbay) | 3012 16th Ave W, Seattle 98119 | (206) 659-1726 (site, text or call); wiki lists (833) 262-5348 | Mon, Wed-Fri 2-10pm; Tue closed; Sat-Sun 10-8 (site); wiki (Apr 2025) says Mon/Thu/Fri 2-8, closed Tue-Wed | Prusa MK4 x2 ("Jinja", "Admiral") + MK3S+ ("Goddard") + one more printer of unstated model ("Franklin"); Tinkerer $75/mo includes 3D printing but self-service needs a certification class and machine time is paid in-store (rate not published; failed prints billed only for run time); Guest Pass $20/day, member-accompanied | [seattlemakers.org](https://seattlemakers.org/), [memberships](https://seattlemakers.org/memberships), [wiki About](https://github.com/seattlemakers/docs/wiki/About-And-Contact), [wiki 3D Printing Use](https://github.com/seattlemakers/docs/wiki/3D-Printing-Use) |
| Metrix Create:Space | Capitol Hill | - | closed to public Aug 2018 (unverified detail: article page returned 403; date/closure taken from the headline and URL) | - | [capitolhillseattle.com 2018](https://capitolhillseattle.com/2018/08/tech-junkies-and-robot-tinkerers-lose-capitol-hill-haven-as-metrix-createspace-closes-doors) (via search snippet) |
| SoDo MakerSpace | - | - | sodomakerspace.org does not resolve; no 2025-26 mentions | - | fetch of [sodomakerspace.org](https://sodomakerspace.org/) failed (ENOTFOUND) |
| JLC3DP | online | - | PLA "From $1.00", min part 30 x 30 x 10 mm, build time from 72 h | FDM/resin outsourcing | [jlc3dp.com PLA](https://jlc3dp.com/help/article/PLA-Plastic) |
| PCBWay 3D printing | online | - | FDM PETG, PLA (two variants each), nylon, ABS, TPU, PC, ASA; instant online quote; "$25 min order" is unverified (search snippet; not on the fetched page) | PETG parts | [pcbway.com](https://www.pcbway.com/rapid-prototyping/3d-printing/) |
| Craftcloud | online | - | "no minimum order", compares partner quotes, ships 24-48 h | price shopping | [craftcloud3d.com](https://craftcloud3d.com/) |
| Adafruit DRV5032 Hall breakout #6051 ("ScoutMakes DRV5032 Digital Magnetic Hall Effect Sensor") | online | - | $4.95, 1.65-5.5 V supply | 3.3 V-friendly Hall (recommended over A3144) | [adafruit.com/product/6051](https://www.adafruit.com/product/6051) |

## Products to buy

| Item | Exact product | Price | Link | Why |
|---|---|---|---|---|
| Resistors, caps, hookup wire, heat shrink | Vetco in-store (1/4 W resistor and Heat Shrink collections) | pennies each | [vetco.net](https://vetco.net) | buy 5, not 500 |
| JST connectors | Vetco "JST PH 2 Pin Connector M/F Pair, Pre-wired 6 in" VUPN924; 3-pin VUPN8345 | $2.89 / $2.99 | [vetco JST](https://vetco.net/search?q=jst) | pump, Hall, switch leads |
| Fuse + holder | Vetco "5x20MM Fuse Holder Line Mount 16AWG" VUPN643 + 1 A or 4 A slow-blow 5x20 5-pk | $2.99 + $6.50-7.50 | [vetco fuse](https://vetco.net/search?q=fuse+holder) | 12 V pump rail fuse |
| Master power switch | Vetco "SPST Miniature Toggle Switch w/Wire Leads, On-Off 6A" 30-10005 or "Thin Rocker Switch 6A" VUPN1102 | $4.95 / $2.99 | [vetco switches](https://vetco.net/search?q=micro+switch) | panel switch |
| Lever microswitch (backup for D2F-L) | Vetco "10.1A Mini Microswitch" VUPN506 or "1A Microswitch with Lever" TEA-A-7038 | $2.74 / $2.99 | same | if the Amazon 4-pack is late |
| Level shifter | Vetco "Quad Level-Shifter 74AHCT125 (3V to 5V)" VUPN524 | $2.95 | [vetco 74AHCT125](https://vetco.net/search?q=74AHCT125) | single piece instead of 10-pk |
| Hall sensor | Adafruit DRV5032 #6051 (preferred) / Vetco A3144EUA VUPN6596 (local same-day) | $4.95 / $1.99 | [adafruit 6051](https://www.adafruit.com/product/6051), [vetco hall](https://vetco.net/search?q=hall+effect) | DRV5032 is 3.3 V native |
| NeoPixel strip (local) | Vetco "Mini Addressable RGB LED Strip, 5V, 1M (WS2812)" VUPN2314 | $19.95 | [vetco neopixel](https://vetco.net/search?q=neopixel) | glow strip behind the diffuser |
| Perfboard | Vetco "Phenolic Protoboard 1.97 x 2.76 in" VUPN2924 | $3.49 | [vetco perfboard](https://vetco.net/search?q=perfboard) | electronics tray |
| M3 screws/nuts/washers | Tacoma Screw Ballard counter (by the piece); Hillman M3 small packs at Ace/McLendon/Home Depot (Hillman M3-0.50 x 10 mm 4-pk $1.49 at Tractor Supply - unverified, page 503) | ~$0.10-0.40 ea (estimate) | [Tacoma Screw locations](https://www.tacomascrew.com/LocationFinder), [Hillman M3 example](https://www.tractorsupply.com/tsc/product/hillman-metric-pan-head-phillips-machine-screw-m3-05-x-10mm-3286045) | socket module, tray, hatch |
| M3 heat-set inserts | Amazon assortment (no local source) | ~$8-12 per 50-100 pc (estimate) | [Amazon search: m3 heat set inserts](https://www.amazon.com/s?k=m3+heat+set+inserts) | 4x for socket module; online only |
| Compression spring (rotor return) | Vetco "Hillman Compression Spring #45" VUPN2111 (dimensions not listed; bring calipers) or Ace/McLendon Hillman/Century Spring drawer | $1.29 | [vetco spring](https://vetco.net/search?q=spring) | sold singly; exact spec via McMaster if needed |
| Spring assortment (online) | Amazon compression/torsion spring kit | ~$10-15 (estimate) | [Amazon search: compression spring assortment kit](https://www.amazon.com/s?k=compression+spring+assortment+kit) | try several rates |
| Magnets 6x2 mm | SMARTAKE 45-pc 6x2 mm (shortlist, B0CBRVF4PN) or K&J D41 (1/4 x 1/16 in) | Amazon price not shown on the fetched listing (title confirms 45 pcs, 6x2 mm); K&J $0.28 ea | [amazon B0CBRVF4PN](https://www.amazon.com/dp/B0CBRVF4PN), [K&J D41](https://www.kjmagnetics.com/proddetail.asp?prod=D41) | ring key + latches |
| Stronger latch magnets | K&J D42 (1/4 x 1/8 in, 2.3 lb pull) | $0.41 ea | [K&J D42](https://www.kjmagnetics.com/proddetail.asp?prod=D42) | rear hatch |
| Pump-head tubing | 1/8 in ID x 1/4 in OD platinum silicone (Amazon) | ~$8-12 / 3-10 ft (estimate) | [Amazon search](https://www.amazon.com/s?k=1%2F8+ID+1%2F4+OD+silicone+tubing+food+grade) | correct wall for KPHM200; homebrew shops rarely stock 1/8 ID |
| Inlet/outlet tubing, bottle | Micro Homebrew, Kenmore (silicone/vinyl by the foot, small bottles - call first) | ~$1-2 /ft (estimate) | [microhomebrew.com](https://www.microhomebrew.com/) | food-grade, same day |
| Shot glass, squeeze bottle | Bargreen Ellingson Seattle showroom (Mon-Fri 10-3) | $1-3 ea (estimate) | [bargreen.com/locations/seattle](https://www.bargreen.com/locations/seattle) | commercial 1.5 oz glass, 8 oz squeeze bottle |
| Small bottles (alt) | Uwajimaya / Daiso Westwood Village / Container Store Bellevue | $1-5 (estimate) | see Facts table | reservoir candidates |
| Big-part printing | KCLS Bellevue Makerspace (free, PETG on hand, Core One 250 x 220 x 270) | $0 | [kcls.org/bellevuemakerspace](https://kcls.org/bellevuemakerspace/) | if 180 mm halves do not fit; 2 h/week limit means split long prints |
| Big-part printing (paid) | Seattle Makers Guest Pass + machine time, or JLC3DP/PCBWay/Craftcloud upload | $20 pass + paid machine time; online roughly $15-40 per 180 mm PETG half (estimate) | links in Facts table | overflow |

## Big-box notes (Home Depot / Lowe's) - pages could not be fetched (403); treat as estimates

- PETG adhesive: Loctite Plastics Bonding System (primer + CA) or Gorilla Super Glue Gel; both are standard shelf items. Better: Amazon for a 3D-print-specific CA such as Starbond/Insta-Cure; **estimate**.
- Aluminum foil tape (Nashua 322 / 3M 425 style): standard HVAC aisle, 2 in x 10 yd; fine locally.
- Silicone tubing: big-box "food-grade" 1/4 in OD is usually clear PVC/vinyl (Everbilt), not silicone, and 1/8 in ID x 1/4 in OD is not a stocked size - **buy online**. Vinyl 3/16 in ID is OK for inlet/outlet outside the pump head.
- Hook-and-loop straps (Velcro One-Wrap), cable ties, M3 Hillman drawer packs, Master Magnetics neodymium discs: all standard big-box items; local is fine.
- Panel toggle/rocker switches: big-box automotive aisle has 12 V rockers; Vetco selection is better and cheaper.
- Better online only: heat-set inserts, XIAO RP2040, DRV5032 breakout, 1/8 x 1/4 silicone, exact-spec springs (McMaster), D2F-L microswitches.

## Open questions / risks

- Vetco hours conflict between the fetched homepage (Mon-Fri 9-6) and a search snippet (8-5:30); the site itself says hours may differ - call 425-641-7275.
- Sound Homebrew Supply and Mountain Homebrew: both domains no longer serve store pages; neither confirmed open. If Kenmore is too far, phone before assuming either exists.
- Micro Homebrew does not list tubing or bottle inventory online; sizes stocked are an estimate.
- Tacoma Screw's web catalog returned no results for "M3" or "compression spring"; branch counters carry far more than the site - call the Ballard branch (206) 632-7565.
- Ace store hours (Magnolia, Maple Leaf, Junction) and Home Depot/Lowe's stock could not be fetched (403); Magnolia/Maple Leaf/Junction addresses/phones are confirmed via Checkbook, hours are not. Tweedy & Popp (UW) is entirely unverified.
- Daiso: the official locator returned zero rows / 404; the Westwood Village address is from a June 2024 news story (search snippet only, page 403). Unverified.
- KCLS 2 h/week reservation and "print must finish in window" likely rules out a single 8-10 h sphere half unless printed during a longer drop-in program; check the Bellevue calendar.
- No Seattle retail source for heat-set inserts was found; order online early.
- Hardwick's: company says a Post Falls brick-and-mortar store opens 2027; it is online-only today and irrelevant for same-day pickup.
- Web search budget was exhausted during this task; Lowe's/Home Depot/Ace product-level confirmation and a spring-specialty shop search were not completed.

## Fact-check notes (2026-10-11, independent re-verification)

Every cited page was re-fetched. Confirmed as written: Vetco address/phone/hours and all Vetco SKUs/prices (JST pairs $2.89-3.25, 2.0 mm KHS housings $1.99/$2.25, VUPN643 $2.99, 5x20 fuse 5-pk $6.50 fast / $7.50 slow-blow, A3144EUA $1.99, 74AHCT125 $2.95, VUPN2314 $19.95, VUPN2924 $3.49, M3 brass standoffs $0.49-0.99, Hillman spring #45 $1.29; 0 results for XIAO; no neodymium discs; no heat-set inserts); Hardwick's (KIRO 7 dated Sept 19, 2020, "last day on Saturday"; FAQ address 3820 E Mullan Ave, Post Falls; footer "Brick & Mortar Store Opening 2027"); supertronix.com 307 to GoDaddy for-sale; alphatronicsusa.com ENOTFOUND; all four Tacoma Screw branches; Stoneway Ballard; both McLendon stores; Checkbook address/phone for Magnolia, Maple Leaf (reviews through Sep 26, 2026) and Junction Ace (through Aug 1, 2026); K&J D41/D42; Micro Homebrew; soundhomebrew.com 301 to theapexautoworks.com and the May 2023 Queen Anne News address; mountainhomebrew.com is a generic blog; Bargreen address/phone/hours; Uwajimaya; Container Store Bellevue (mall listing); KCLS Bellevue Makerspace (free, no card, Core One/MK4/MK3S, PLA+PETG, 2 h/week, 24 h notice, print must finish); Seattle Makers address/hours/$75 Tinkerer/$20 guest pass; sodomakerspace.org ENOTFOUND; JLC3DP; Craftcloud "no minimum order"; PCBWay FDM PETG/PLA + instant quote; Adafruit #6051 $4.95, 1.65-5.5 V; Amazon B0CBRVF4PN title (45 pcs, 6x2 mm).

Corrected:
- Seattle Makers phone: the site lists (206) 659-1726; (833) 262-5348 is only on the GitHub wiki. Printers: wiki names two MK4s, one MK3S+ and a fourth printer of unstated model. "Per-minute machine time" was not on the page; machine time is paid in-store, rate not published, and self-service 3D printing needs a certification class.
- Vetco microswitch range: the $1.59 item is a no-lever switch; lever types are $2.99-7.95 (plus $17.95 heavy-duty roller types). Mini toggle $1.99-4.99 confirmed.
- Stoneway: "not Ace" was an inference; the site simply shows no Ace affiliation and links to Do it Best.
- Bargreen: "open to the public" softened to the site's own wording ("serving both home kitchens and commercial kitchen professionals").
- Prusa page cited now describes the CORE One+ (Gen 2); the 250 x 220 x 270 mm figure is from that page.
- Hardwick's closure wording: article says "last day on Saturday" and is dated Saturday Sept 19, 2020 (consistent).

Marked unverified (could not be fetched; web-search budget was exhausted before these could be re-searched): Magnolia Ace hours; Tweedy & Popp Ace (address and hours); Daiso Westwood Village (address, hours; blog 403, locator 404); Container Store street address 700 Bellevue Way NE Ste 120; Tractor Supply Hillman M3 4-pk $1.49 (HTTP 503); PCBWay $25 minimum; Metrix closure detail (article 403; headline/URL only); SPL public 3D printing status; Mountain Homebrew D&B address/phone (403); Vetco "8-5:30" search-snippet hours. The "no Seattle retail source for heat-set inserts" conclusion rests only on the Vetco search and was not extended to other stores.
