TheRageKage12/drunk-lantern-power-battery/docs/images/original-parts-sheet-1.png

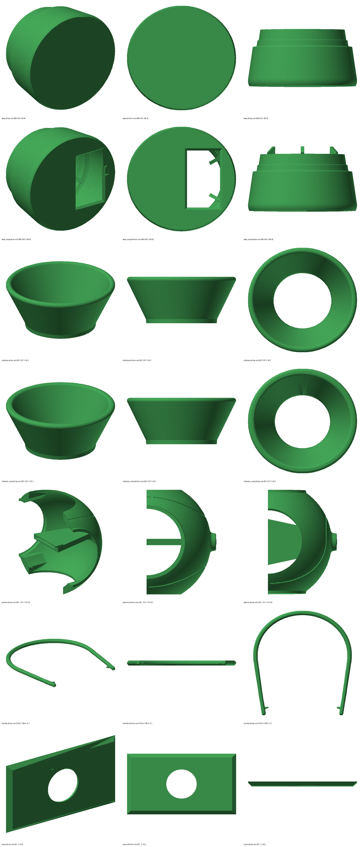
docs/images/original-parts-sheet-1.png
