TheRageKage12/drunk-lantern-power-battery/cad/output/assembly.step

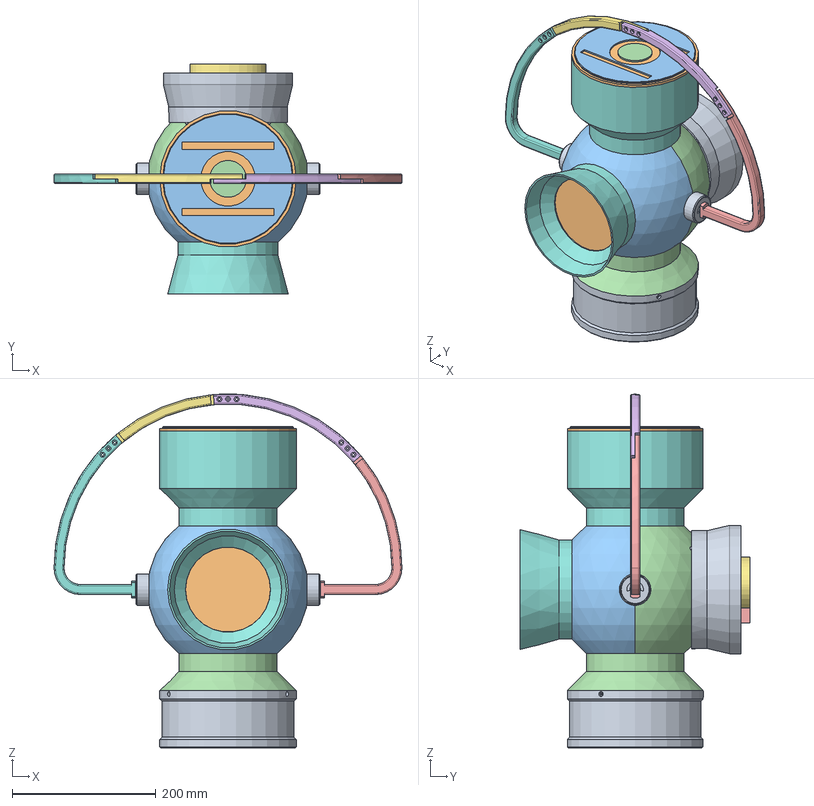
[picture p84: CAD file, 2026-10-24]
cad/output/assembly.step
484.0 x 320.4 x 492.2 mm
base
base_tray
screw_cap
bag_cover
pump_envelope
bag_envelope
lug_sweep_envelope
bell_front
bell_rear
diffuser
curtain_clamp
front_led_envelope
rear_led_envelope
curtain_envelope
perfboard_envelope
board_components_envelope
board_wiring_envelope
board_cable_exit_envelope
powerbank_envelope
battery_connector_envelope
buck_envelope
buck_wires_envelope
inline_connectors_envelope
power_switch_envelope
charge_socket_envelope
pump_diode_envelope
pump_plug_envelope
hall_capacitor_envelope
foot
handle_end_right
handle_arc_1
handle_arc_2
handle_end_left
handle_pivot_right
handle_pivot_left
socket_housing
rotor
socket_base
switch_envelope
switch_bracket
plunger
key_cap
key_ring
sphere_front
sphere_rear
bay_floor
guide_boss
glass_well
lock_wall
nozzle_guide
led_panel
panel_led_envelope
glass_envelope
glass_path_envelope
fist_envelope
hand_path_envelope
top_cap
cap_floor
halo_ring
emblem_lid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
