TheRageKage12/drunk-lantern-power-battery/cad/output/battery_connector_envelope.step

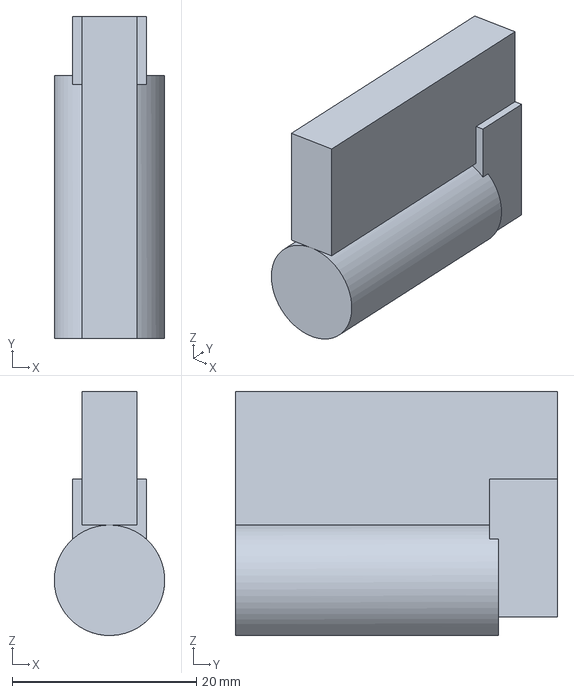
[picture p85: CAD file, 2026-10-24]
cad/output/battery_connector_envelope.step
12.0 x 35.0 x 26.5 mm
