TheRageKage12/drunk-lantern-power-battery/original-model/cover_lock_2.stl

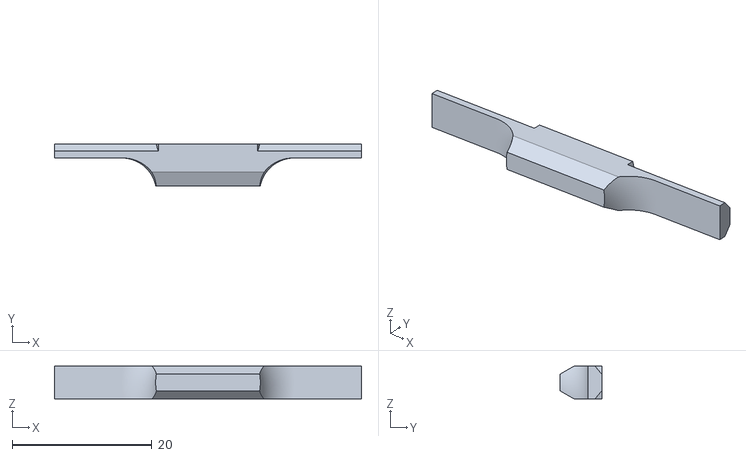
[picture p86: CAD file, 2026-10-11]
original-model/cover_lock_2.stl
44.0 x 6.00 x 4.70
