TheRageKage12/drunk-lantern-power-battery/cad/output/base_tray.step

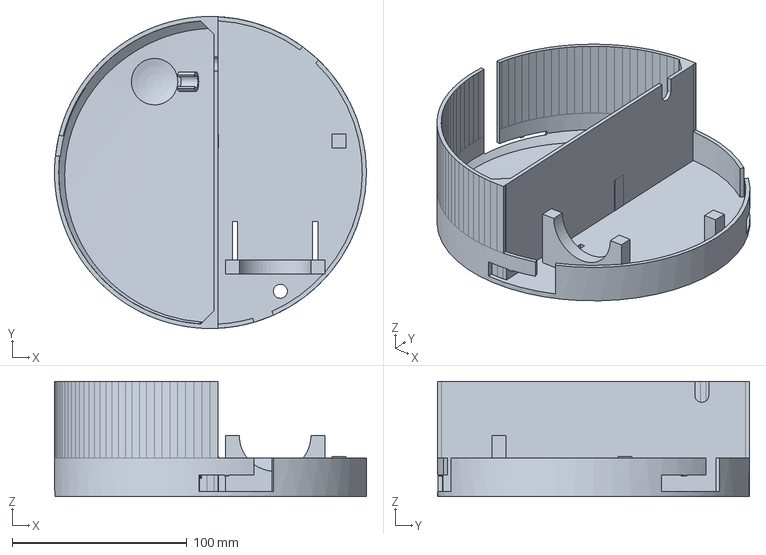
[picture p87: CAD file, 2026-10-24]
cad/output/base_tray.step
178.6 x 178.6 x 66.0 mm
