TheRageKage12/drunk-lantern-power-battery/original-model/green_diffusor.stl

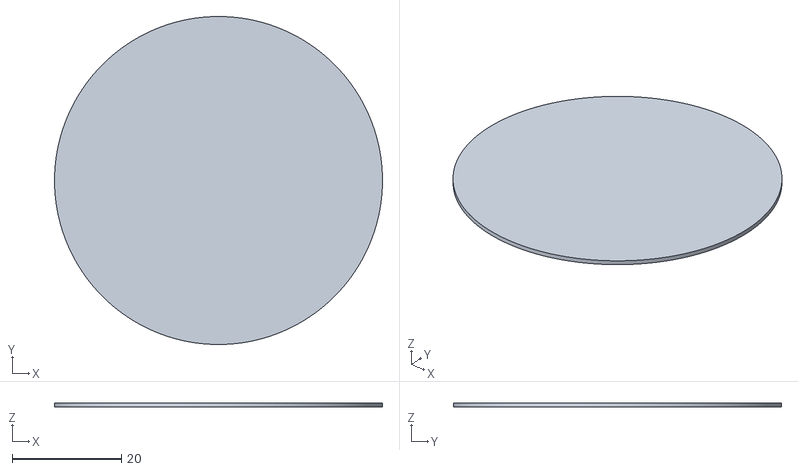
[picture p88: CAD file, 2026-10-11]
original-model/green_diffusor.stl
60.0 x 60.0 x 0.8
