TheRageKage12/drunk-lantern-power-battery/cad/output/board_wiring_envelope.step

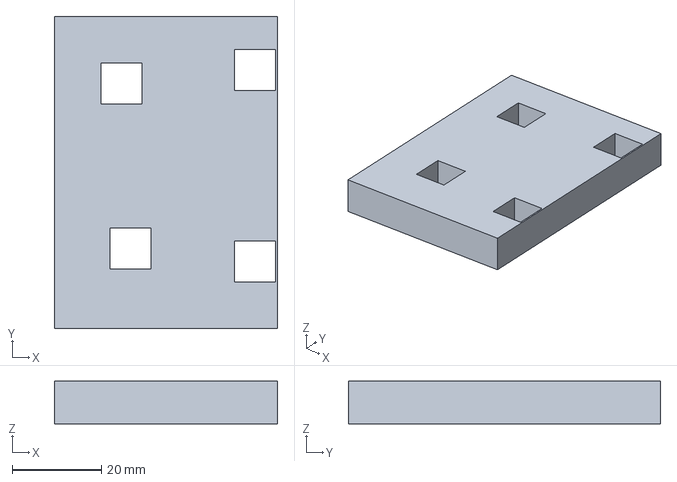
[picture p89: CAD file, 2026-10-24]
cad/output/board_wiring_envelope.step
50.0 x 70.0 x 9.60 mm
