TheRageKage12/drunk-lantern-power-battery/original-model/cover_lock_1.stl

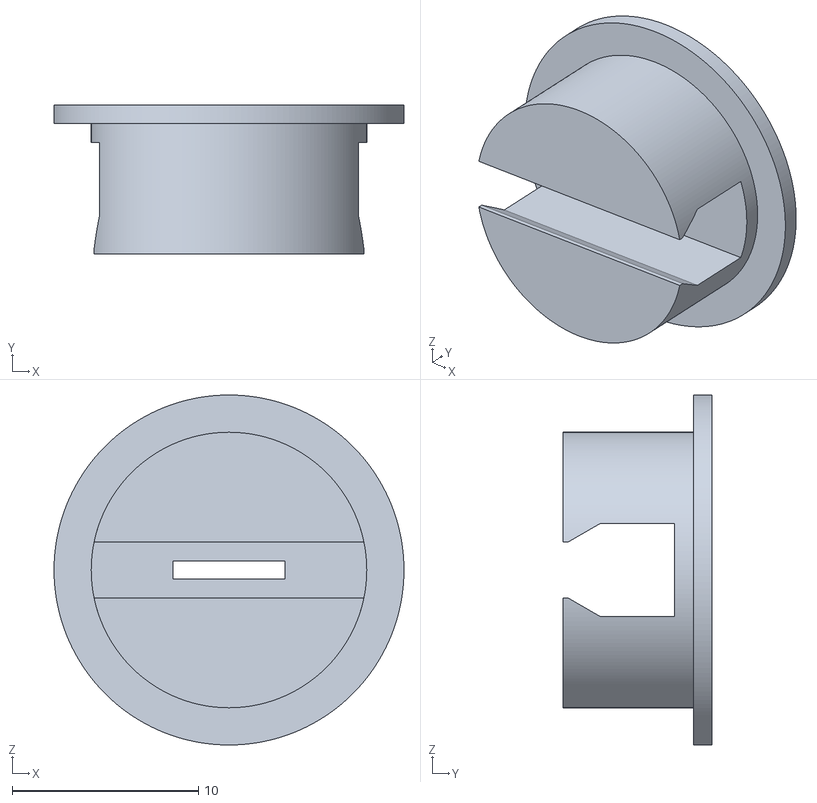
[picture p90: CAD file, 2026-10-11]
original-model/cover_lock_1.stl
18.8 x 8.00 x 18.8
