TheRageKage12/drunk-lantern-power-battery/cad/output/handle_arc_1.step

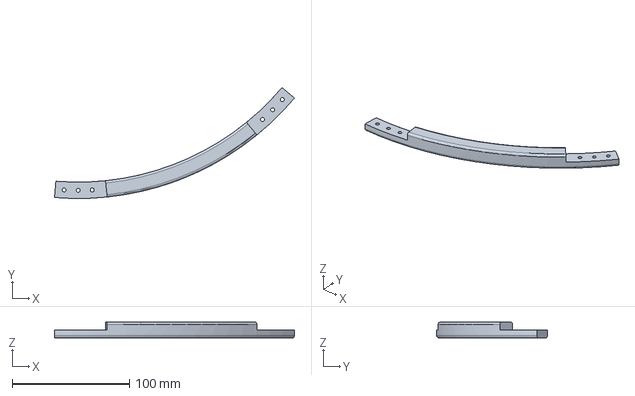
[picture p91: CAD file, 2026-10-24]
cad/output/handle_arc_1.step
205.1 x 94.8 x 13.5 mm
