TheRageKage12/drunk-lantern-power-battery/original-model/base_snap.stl

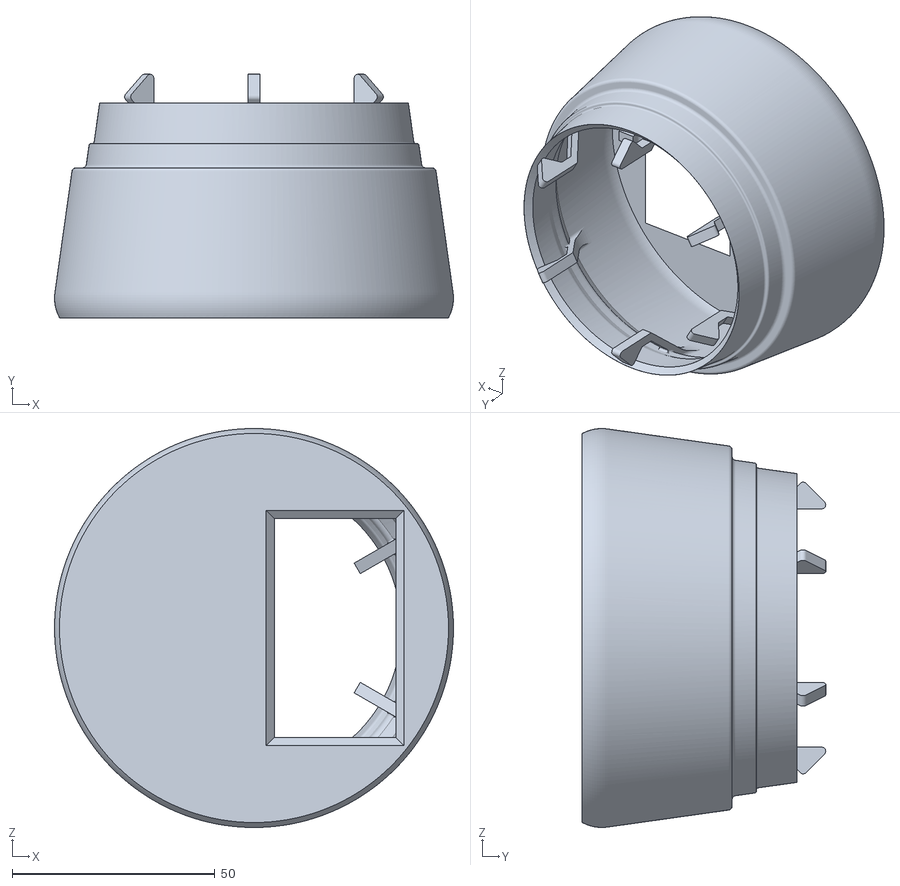
[picture p92: CAD file, 2026-10-11]
original-model/base_snap.stl
98.4 x 60.1 x 98.4
