TheRageKage12/drunk-lantern-power-battery/original-model/reflector_reed.stl

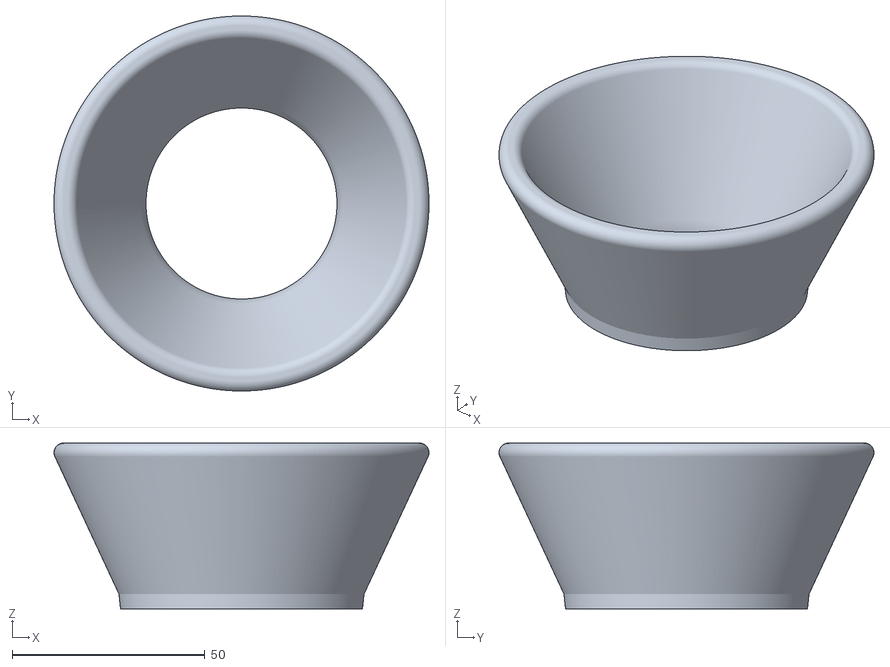
[picture p93: CAD file, 2026-10-11]
original-model/reflector_reed.stl
97.2 x 97.1 x 43.0
