TheRageKage12/drunk-lantern-power-battery/cad/output/glass_well.step

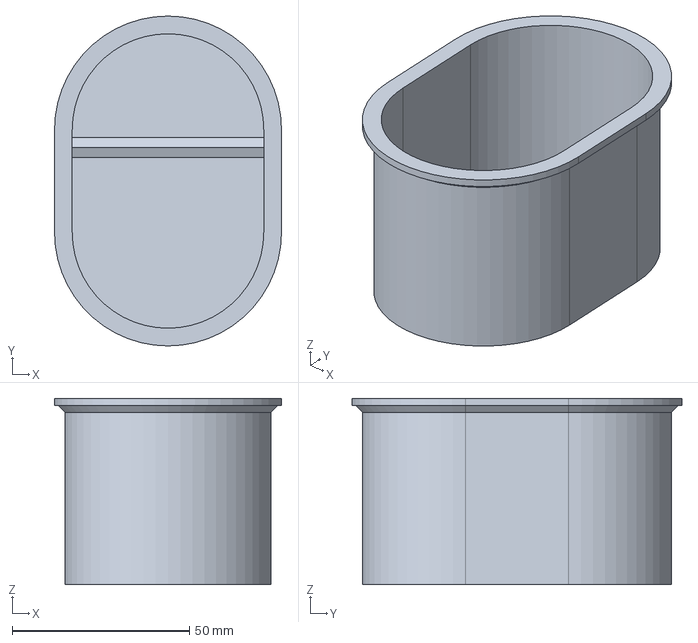
[picture p94: CAD file, 2026-10-24]
cad/output/glass_well.step
64.0 x 93.0 x 52.5 mm
