TheRageKage12/drunk-lantern-power-battery/cad/output/sphere_front.step

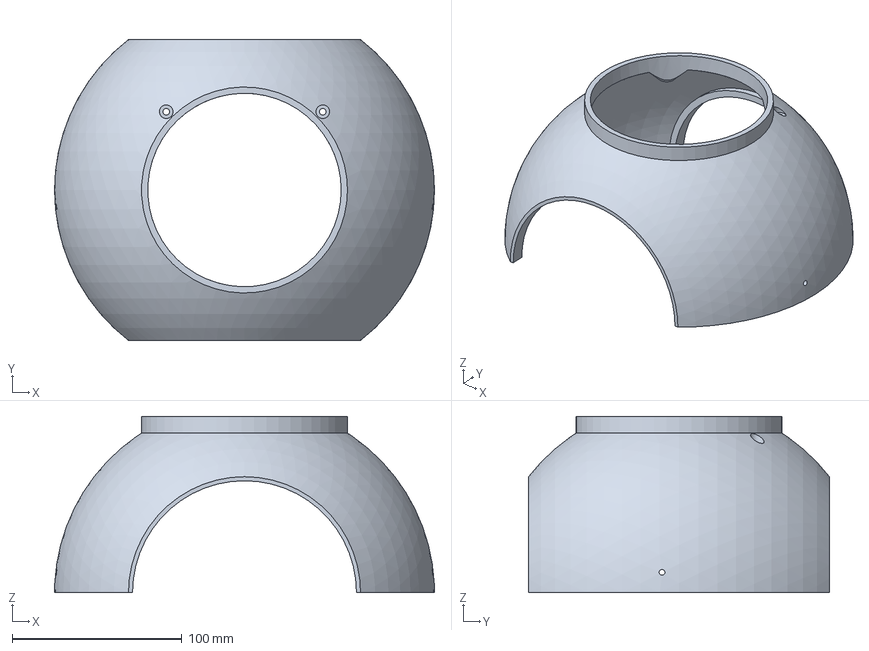
[picture p96: CAD file, 2026-10-24]
cad/output/sphere_front.step
224.0 x 177.4 x 104.0 mm
