TheRageKage12/drunk-lantern-power-battery/original-model/base.stl

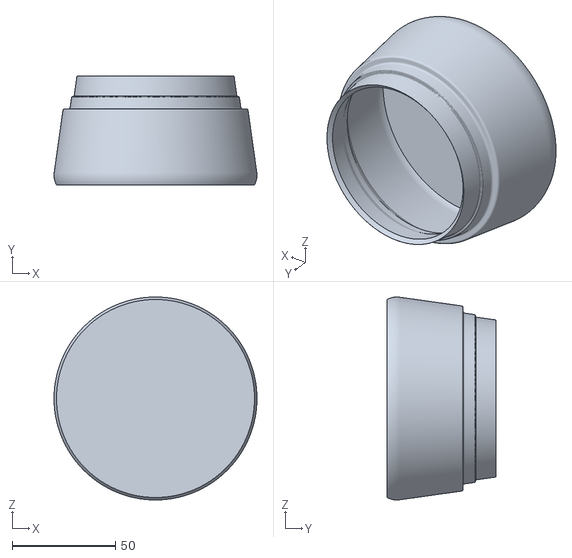
[picture p97: CAD file, 2026-10-11]
original-model/base.stl
98.4 x 53.0 x 98.4
