TheRageKage12/drunk-lantern-power-battery/cad/output/front_led_envelope.step

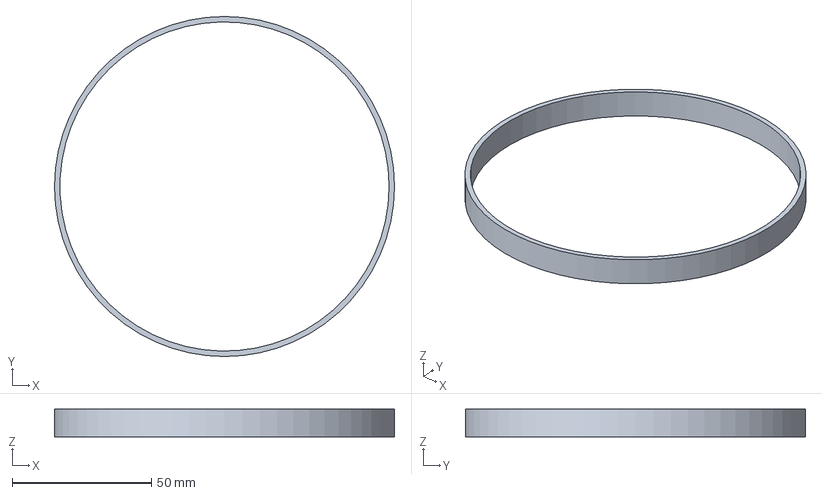
[picture p98: CAD file, 2026-10-24]
cad/output/front_led_envelope.step
121.9 x 121.9 x 9.90 mm
