TheRageKage12/drunk-lantern-power-battery/original-model/handle.stl

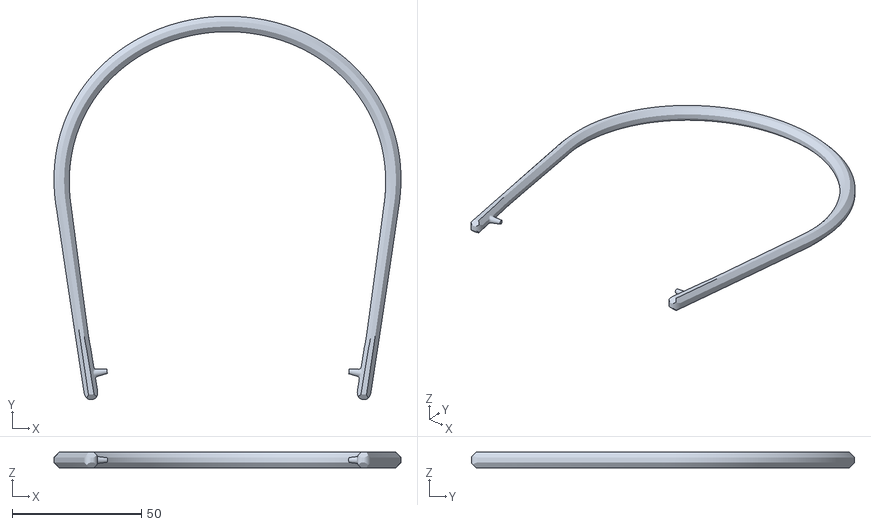
[picture p99: CAD file, 2026-10-11]
original-model/handle.stl
134.2 x 148.4 x 6.01
