TheRageKage12/drunk-lantern-power-battery/cad/output/power_switch_envelope.step

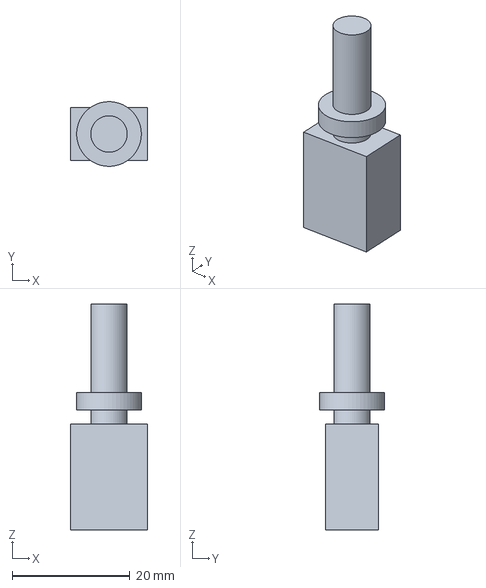
[picture p100: CAD file, 2026-10-24]
cad/output/power_switch_envelope.step
13.0 x 11.0 x 38.4 mm
