TheRageKage12/drunk-lantern-power-battery/original-model/connection.stl

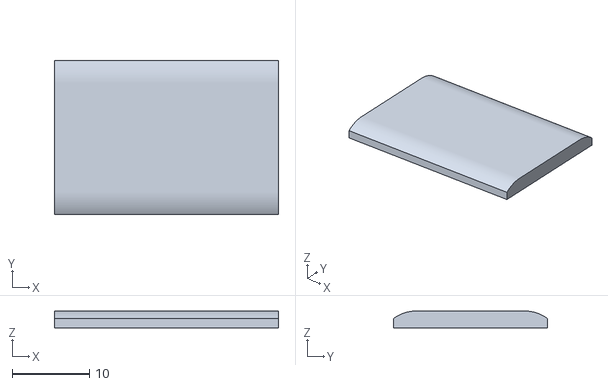
[picture p101: CAD file, 2026-10-11]
original-model/connection.stl
29.0 x 20.0 x 2.20
