TheRageKage12/drunk-lantern-power-battery/cad/output/handle_pivot_right.step

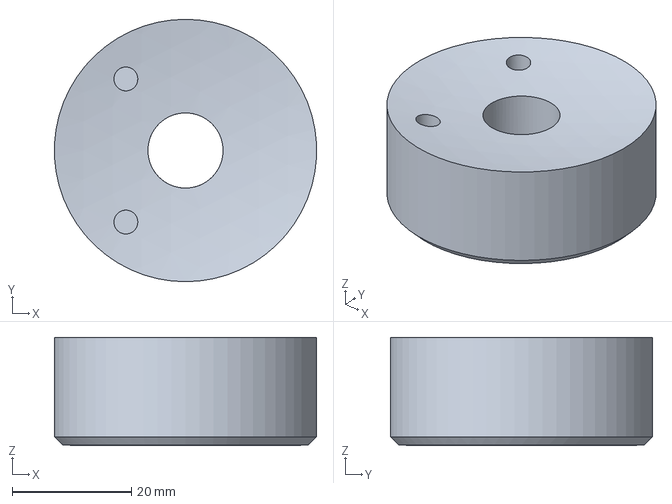
[picture p102: CAD file, 2026-10-24]
cad/output/handle_pivot_right.step
43.9 x 44.0 x 18.2 mm
