TheRageKage12/drunk-lantern-power-battery/original-model/fingerring_20mm.stl

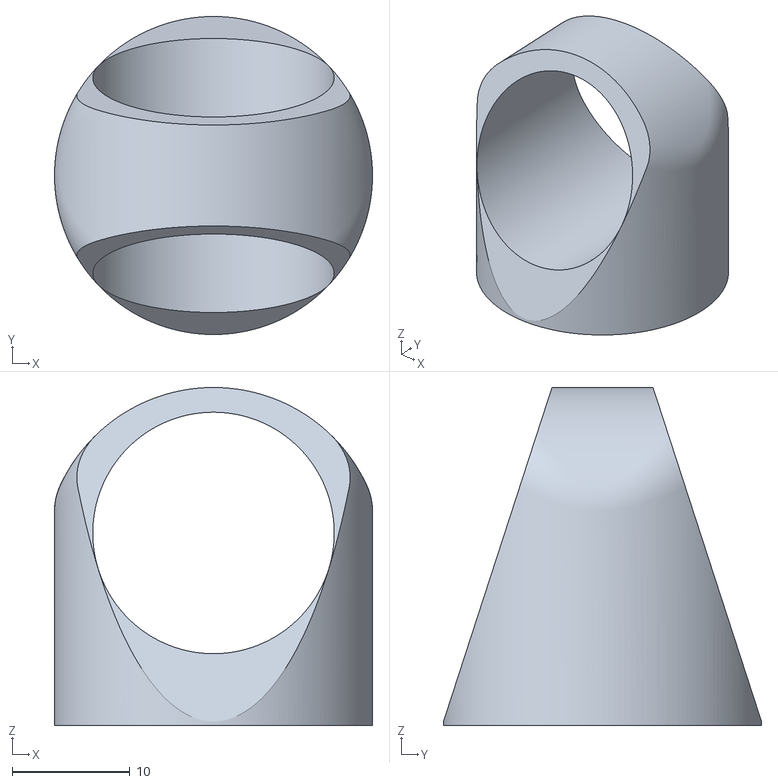
[picture p103: CAD file, 2026-10-11]
original-model/fingerring_20mm.stl
27.0 x 27.0 x 28.7
