TheRageKage12/drunk-lantern-power-battery/original-model/cover.stl

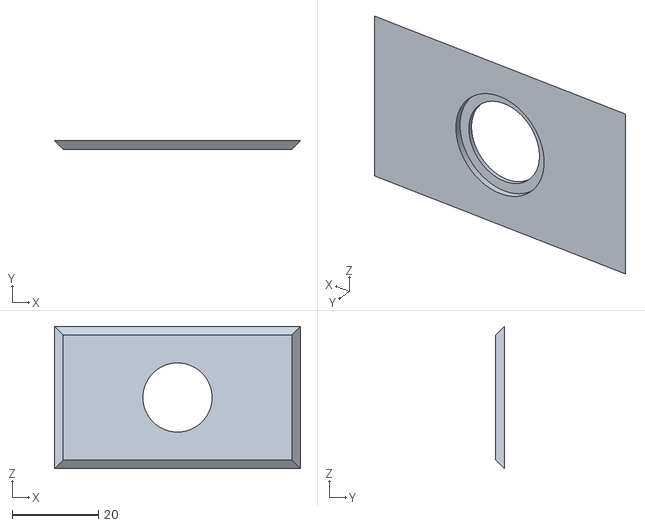
[picture p104: CAD file, 2026-10-11]
original-model/cover.stl
57.0 x 2.00 x 33.0
