TheRageKage12/drunk-lantern-power-battery/cad/output/pump_plug_envelope.step

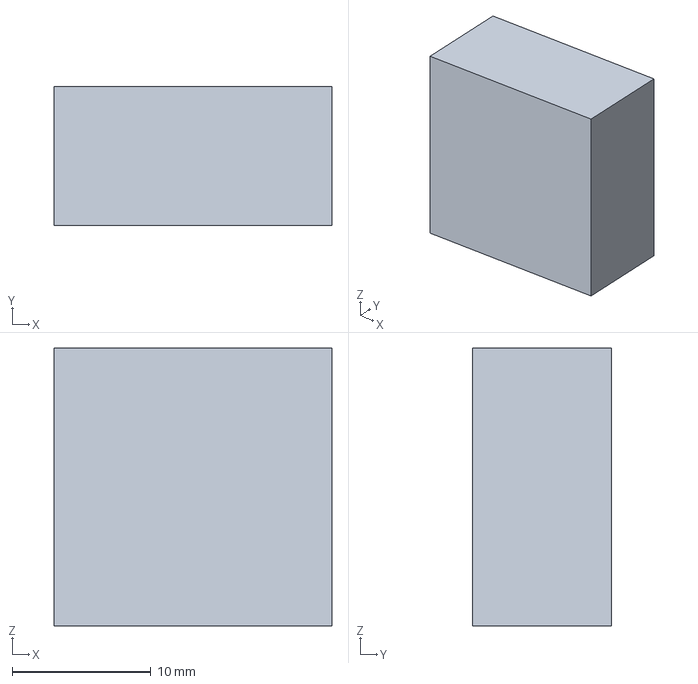
[picture p105: CAD file, 2026-10-24]
cad/output/pump_plug_envelope.step
20.0 x 10.0 x 20.0 mm
