TheRageKage12/drunk-lantern-power-battery/original-model/fingerring_15mm.stl

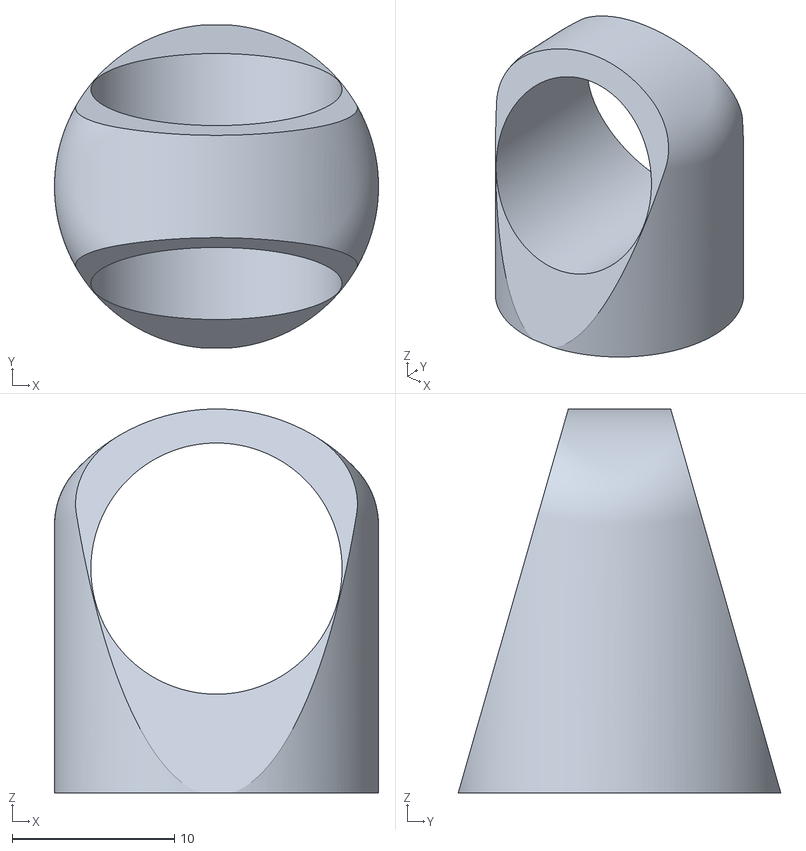
[picture p106: CAD file, 2026-10-11]
original-model/fingerring_15mm.stl
20.0 x 19.9 x 23.7
