TheRageKage12/drunk-lantern-power-battery/cad/output/board_cable_exit_envelope.step

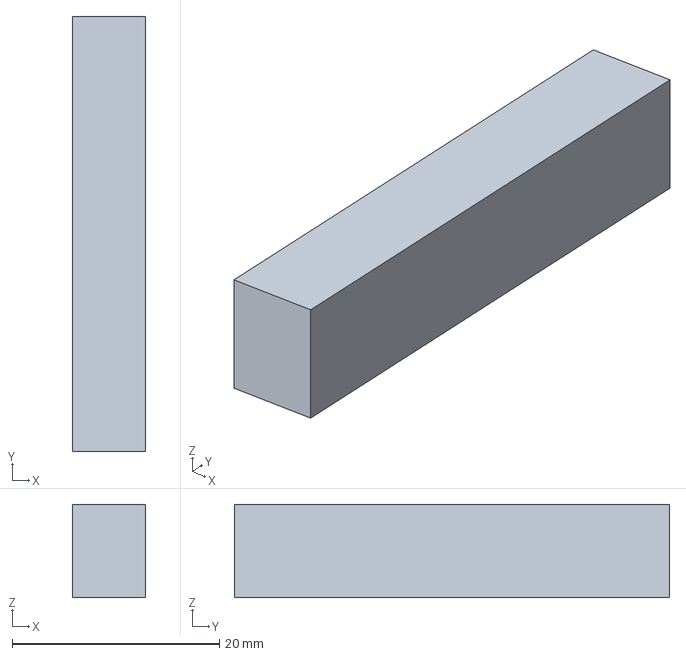
[picture p107: CAD file, 2026-10-24]
cad/output/board_cable_exit_envelope.step
7.00 x 42.0 x 9.00 mm
