TheRageKage12/drunk-lantern-power-battery/original-model/sphere.stl

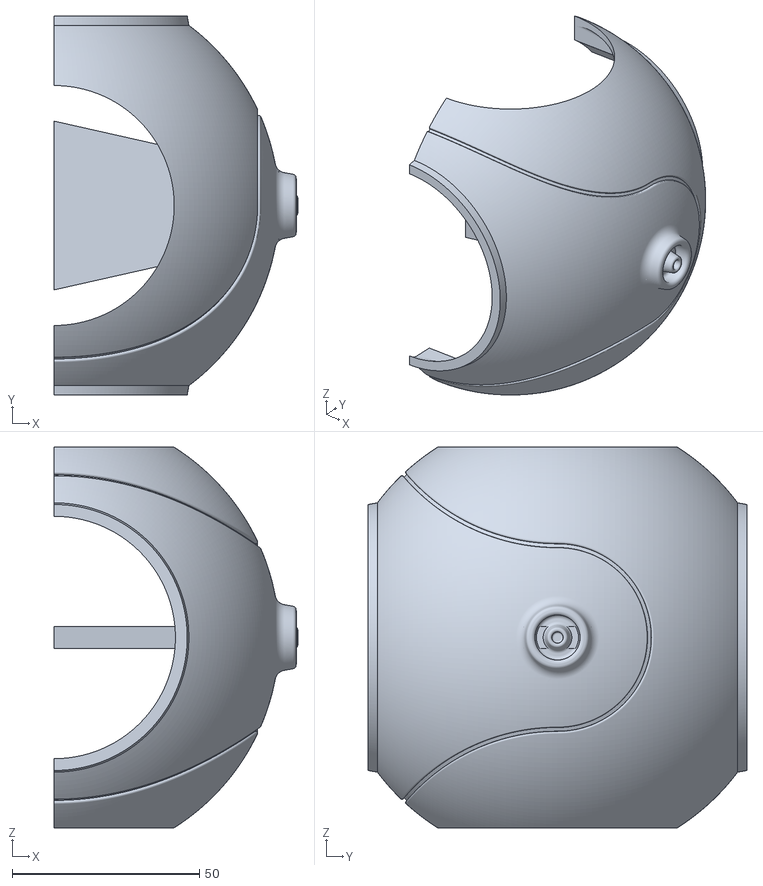
[picture p108: CAD file, 2026-10-11]
original-model/sphere.stl
65.0 x 101.1 x 101.5
