TheRageKage12/drunk-lantern-power-battery/cad/output/bag_cover.step

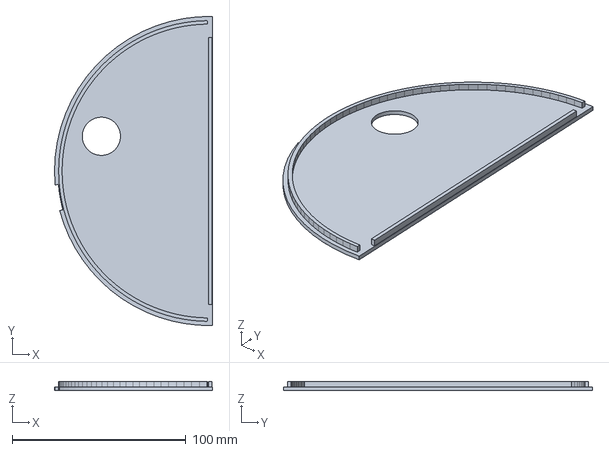
[picture p109: CAD file, 2026-10-24]
cad/output/bag_cover.step
91.0 x 178.0 x 5.00 mm
