TheRageKage12/drunk-lantern-power-battery/original-model/connection_2.stl

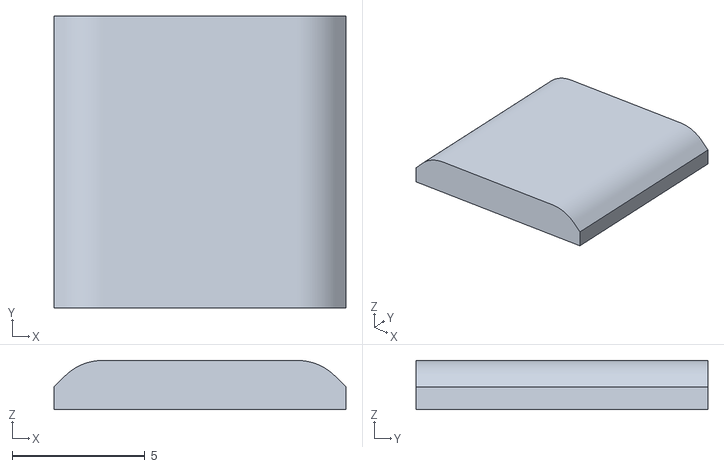
[picture p110: CAD file, 2026-10-11]
original-model/connection_2.stl
11.0 x 11.0 x 1.85
