TheRageKage12/drunk-lantern-power-battery/cad/output/emblem_centre.step

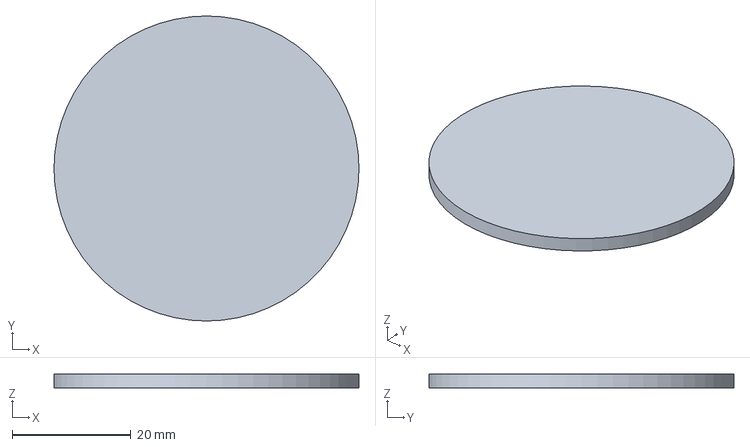
[picture p111: CAD file, 2026-10-24]
cad/output/emblem_centre.step
51.4 x 51.4 x 2.40 mm
