TheRageKage12/drunk-lantern-power-battery/cad/output/buck_wires_envelope.step

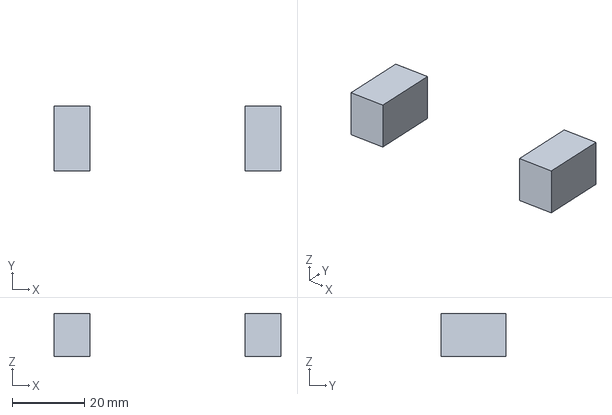
[picture p112: CAD file, 2026-10-24]
cad/output/buck_wires_envelope.step
63.0 x 18.0 x 12.0 mm
