TheRageKage12/drunk-lantern-power-battery/cad/output/socket_housing.step

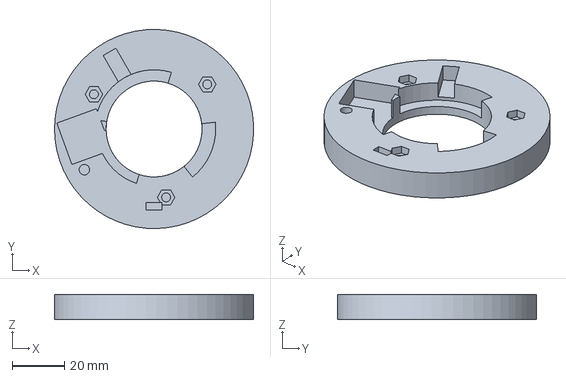
[picture p113: CAD file, 2026-10-24]
cad/output/socket_housing.step
75.9 x 76.0 x 9.70 mm
