TheRageKage12/drunk-lantern-power-battery/cad/output/nozzle_guide.step

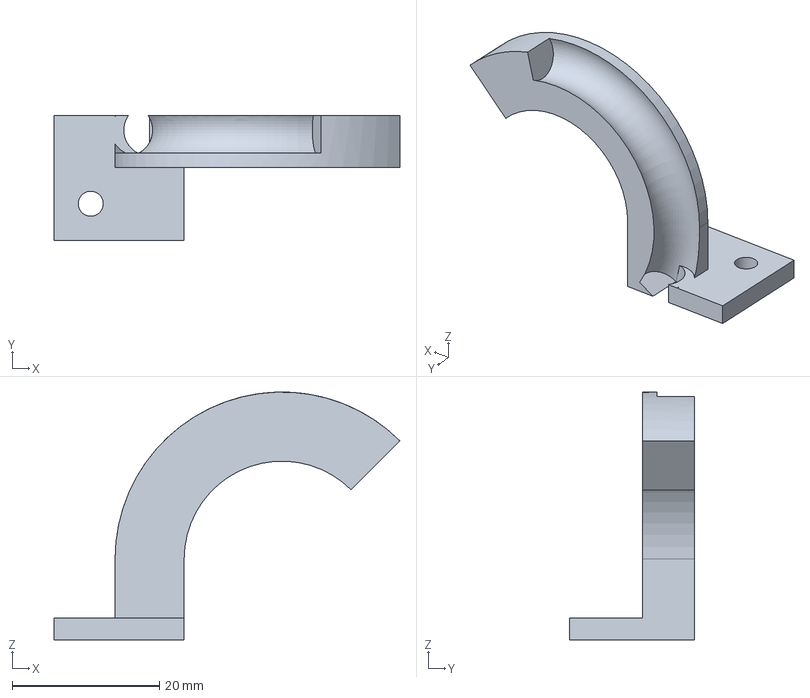
[picture p114: CAD file, 2026-10-24]
cad/output/nozzle_guide.step
47.1 x 17.0 x 33.7 mm
