TheRageKage12/drunk-lantern-power-battery/cad/output/perfboard_envelope.step

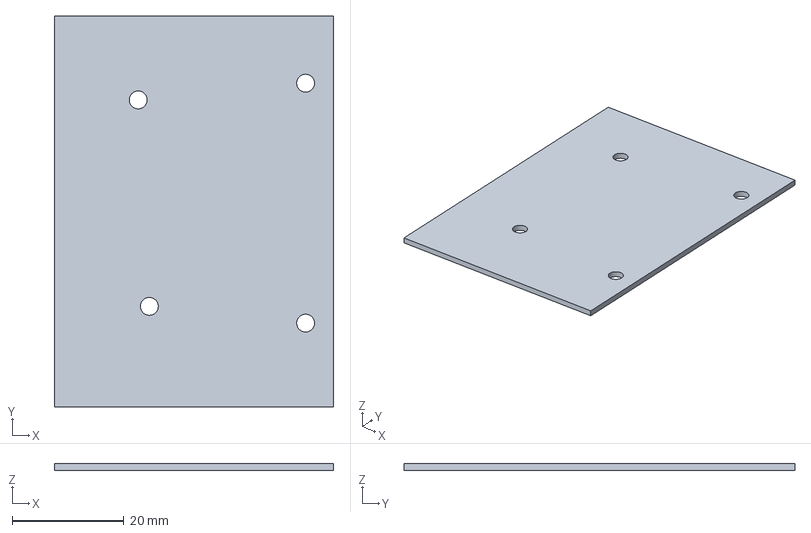
[picture p115: CAD file, 2026-10-24]
cad/output/perfboard_envelope.step
50.0 x 70.0 x 1.20 mm
