TheRageKage12/drunk-lantern-power-battery/cad/output/key_cap.step

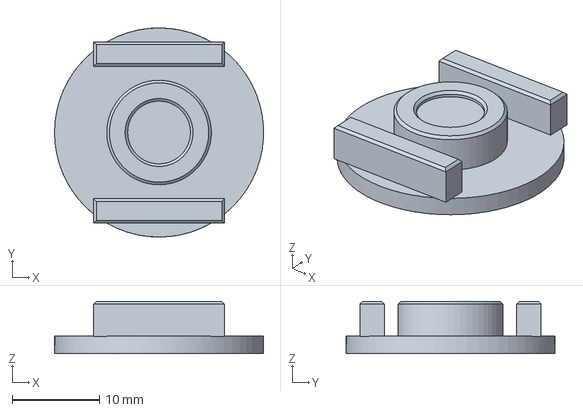
[picture p116: CAD file, 2026-10-24]
cad/output/key_cap.step
24.0 x 24.0 x 6.00 mm
