TheRageKage12/drunk-lantern-power-battery/cad/output/glass_envelope.step

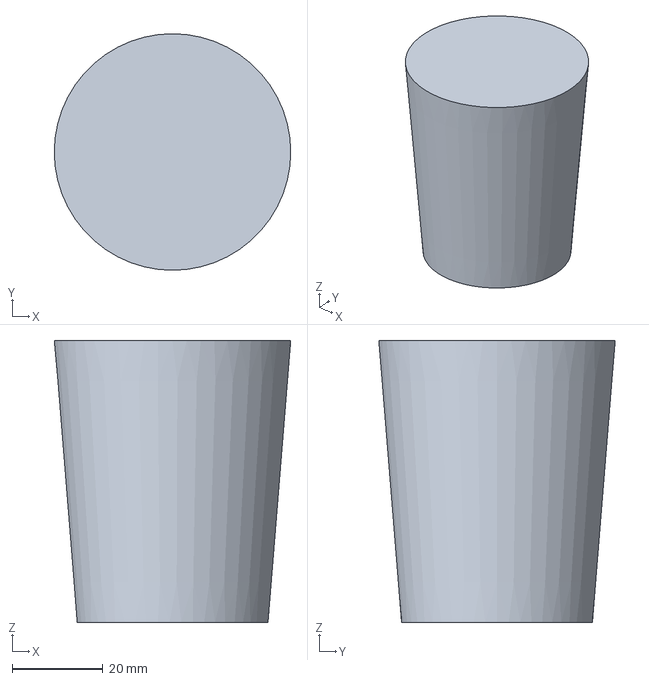
[picture p117: CAD file, 2026-10-24]
cad/output/glass_envelope.step
52.0 x 52.0 x 62.0 mm
