TheRageKage12/drunk-lantern-power-battery/cad/output/rear_led_envelope.step

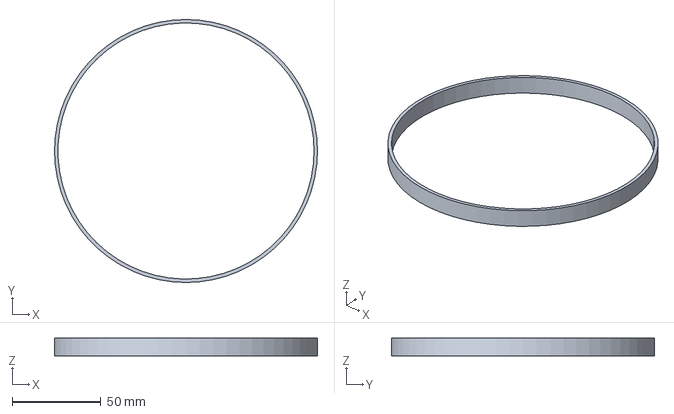
[picture p118: CAD file, 2026-10-24]
cad/output/rear_led_envelope.step
147.9 x 147.9 x 9.90 mm
