TheRageKage12/drunk-lantern-power-battery/cad/output/lug_sweep_envelope.step

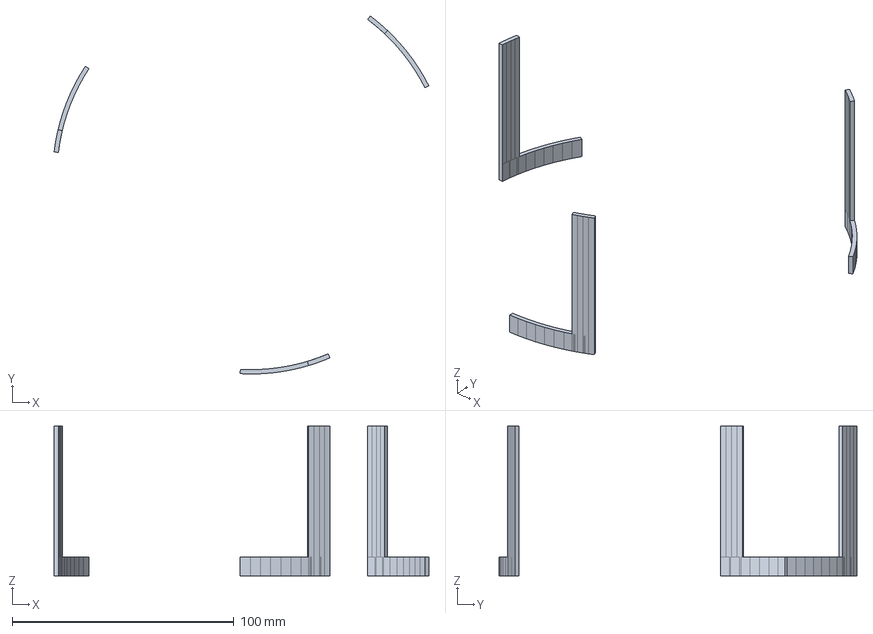
[picture p119: CAD file, 2026-10-24]
cad/output/lug_sweep_envelope.step
169.0 x 161.4 x 67.5 mm
