TheRageKage12/drunk-lantern-power-battery/cad/output/board_components_envelope.step

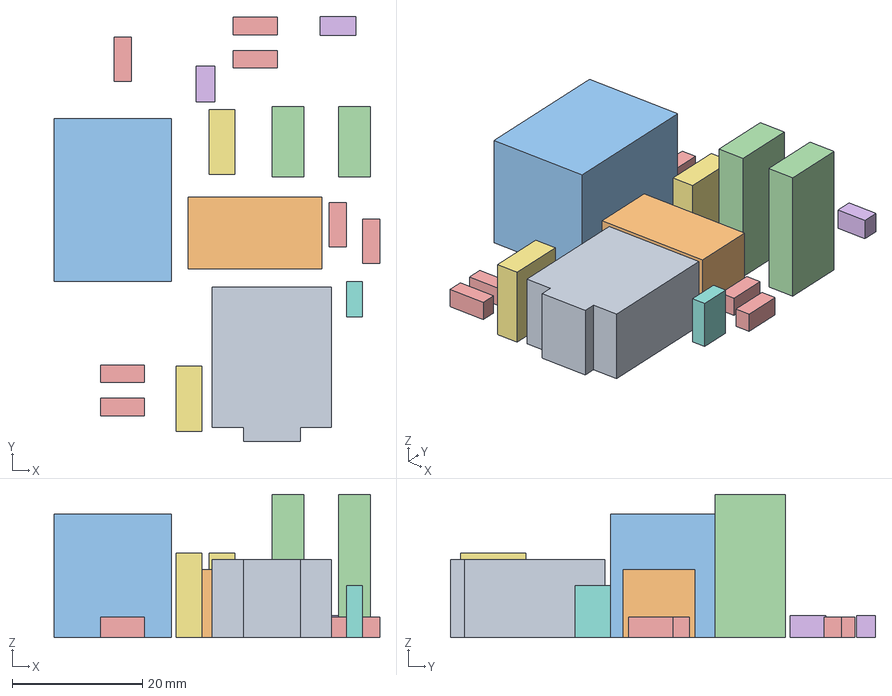
[picture p120: CAD file, 2026-10-24]
cad/output/board_components_envelope.step
49.9 x 65.2 x 22.0 mm
