TheRageKage12/drunk-lantern-power-battery/cad/output/wall_extension.step

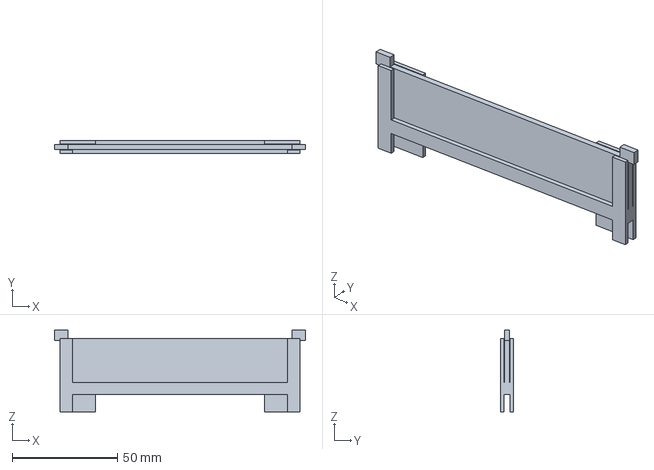
[picture p121: CAD file, 2026-10-24]
cad/output/wall_extension.step
119.0 x 6.20 x 38.7 mm
