TheRageKage12/drunk-lantern-power-battery/cad/output/base.step

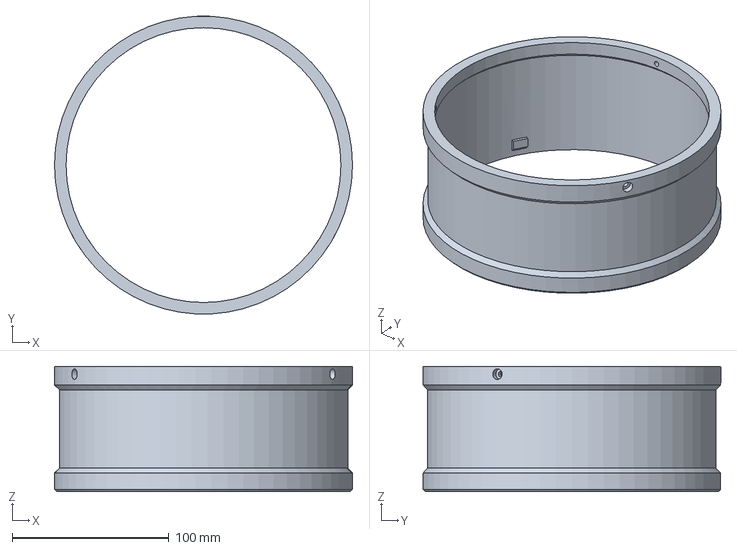
[picture p122: CAD file, 2026-10-24]
cad/output/base.step
190.0 x 189.9 x 80.0 mm
