TheRageKage12/drunk-lantern-power-battery/cad/output/hand_path_envelope.step

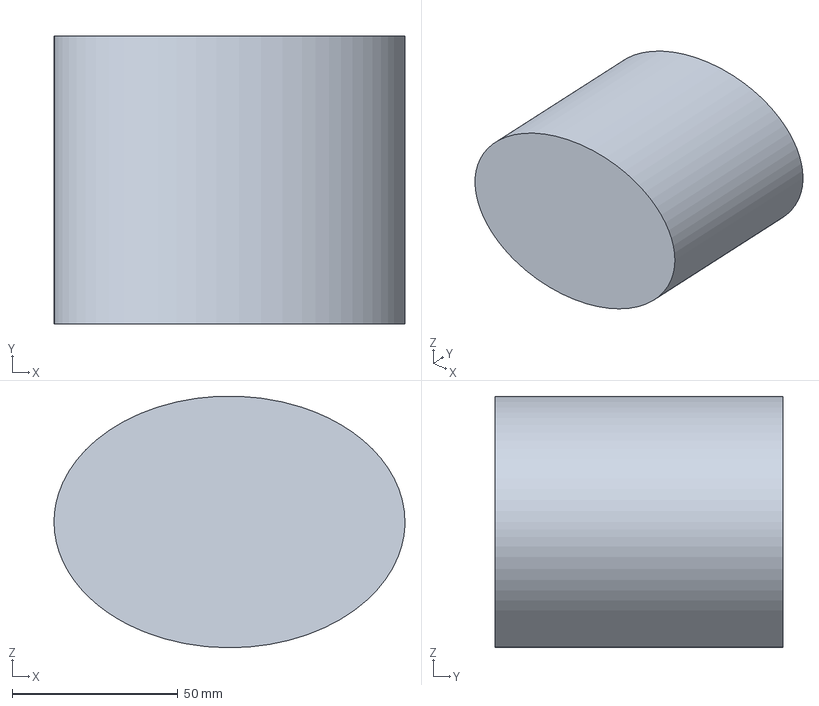
[picture p123: CAD file, 2026-10-24]
cad/output/hand_path_envelope.step
106.0 x 87.0 x 75.9 mm
