TheRageKage12/drunk-lantern-power-battery/cad/output/halo_ring.step

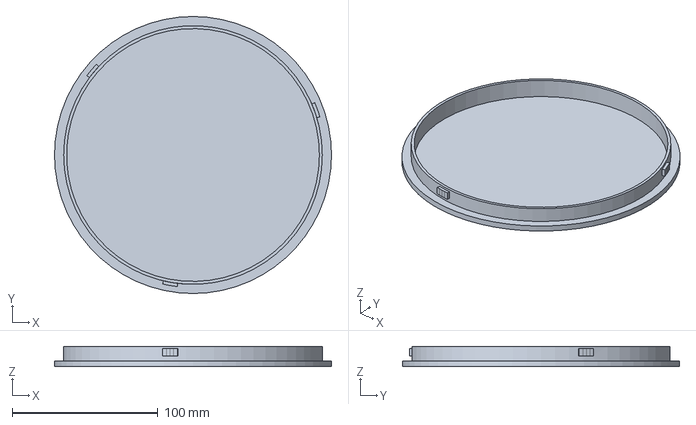
[picture p124: CAD file, 2026-10-24]
cad/output/halo_ring.step
190.0 x 190.0 x 14.0 mm
