TheRageKage12/drunk-lantern-power-battery/cad/output/buck_envelope.step

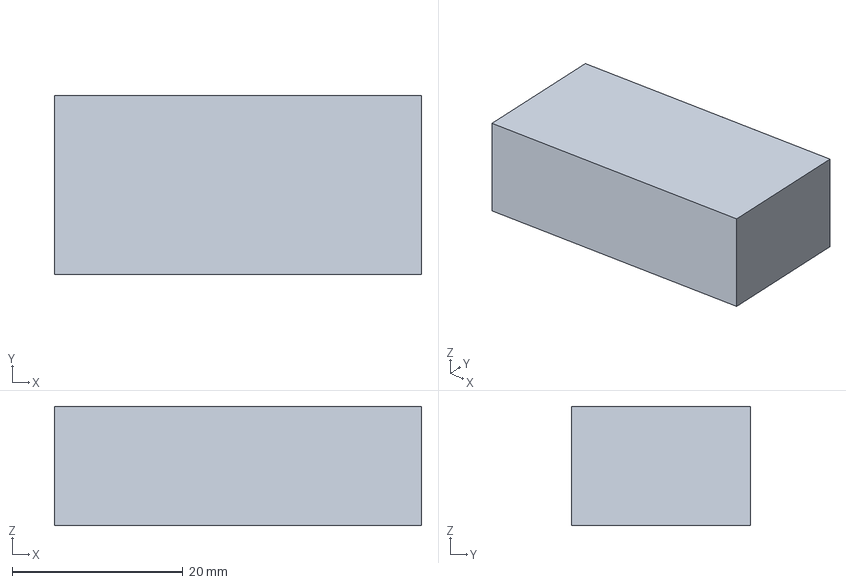
[picture p125: CAD file, 2026-10-24]
cad/output/buck_envelope.step
43.0 x 21.0 x 14.0 mm
