TheRageKage12/drunk-lantern-power-battery/cad/output/inline_connectors_envelope.step

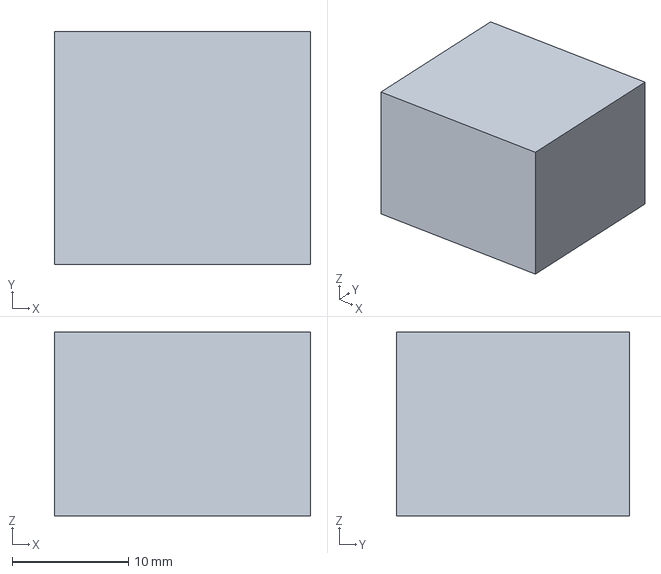
[picture p126: CAD file, 2026-10-24]
cad/output/inline_connectors_envelope.step
22.0 x 20.0 x 15.8 mm
