TheRageKage12/drunk-lantern-power-battery/cad/output/thumb_test.stl

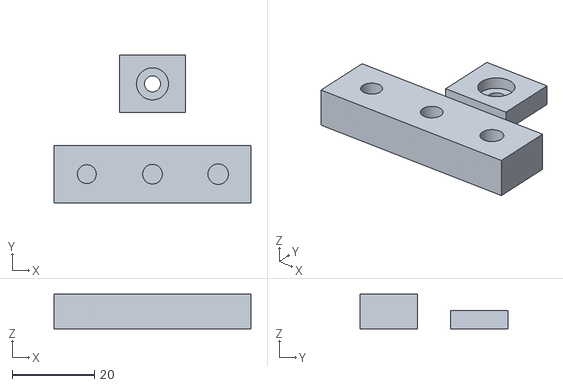
[picture p127: CAD file, 2026-10-24]
cad/output/thumb_test.stl
48.0 x 36.0 x 8.50
