TheRageKage12/drunk-lantern-power-battery/cad/output/bag_envelope.step

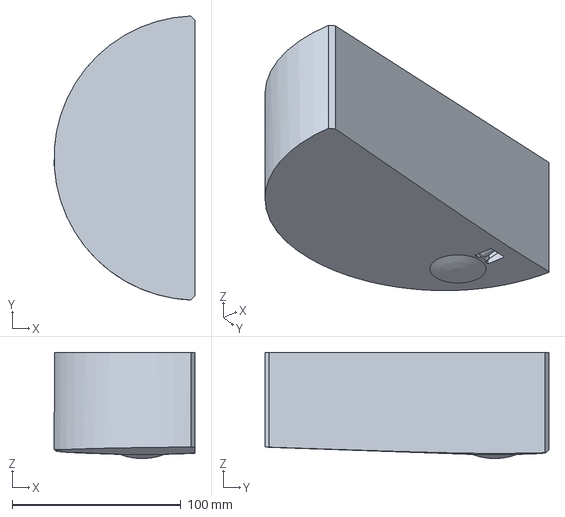
[picture p128: CAD file, 2026-10-24]
cad/output/bag_envelope.step
83.4 x 168.5 x 63.0 mm
