TheRageKage12/drunk-lantern-power-battery/cad/output/diffuser.step

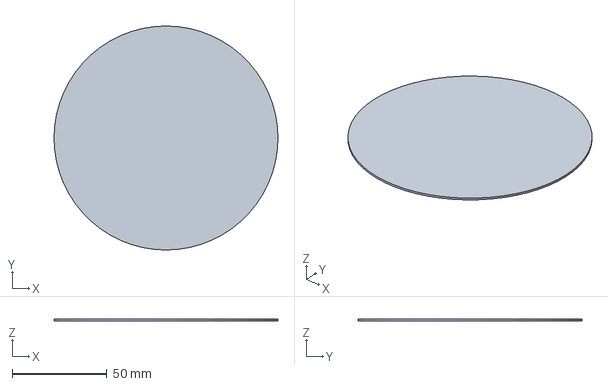
[picture p129: CAD file, 2026-10-24]
cad/output/diffuser.step
118.0 x 118.0 x 1.00 mm
