TheRageKage12/drunk-lantern-power-battery/cad/output/powerbank_envelope.step

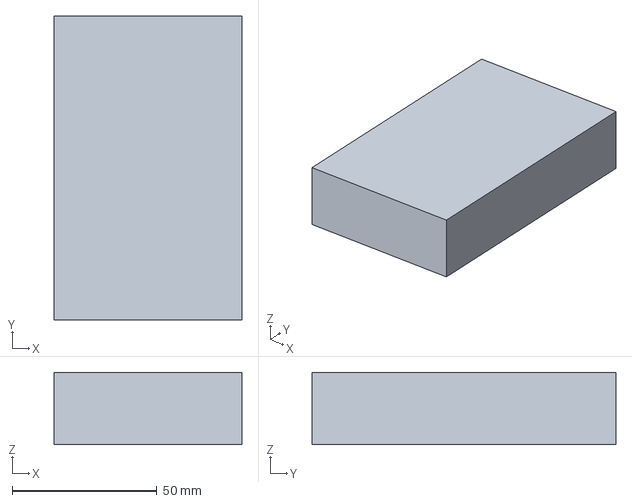
[picture p130: CAD file, 2026-10-24]
cad/output/powerbank_envelope.step
65.0 x 105.0 x 25.0 mm
