TheRageKage12/drunk-lantern-power-battery/cad/output/curtain_stencil.stl

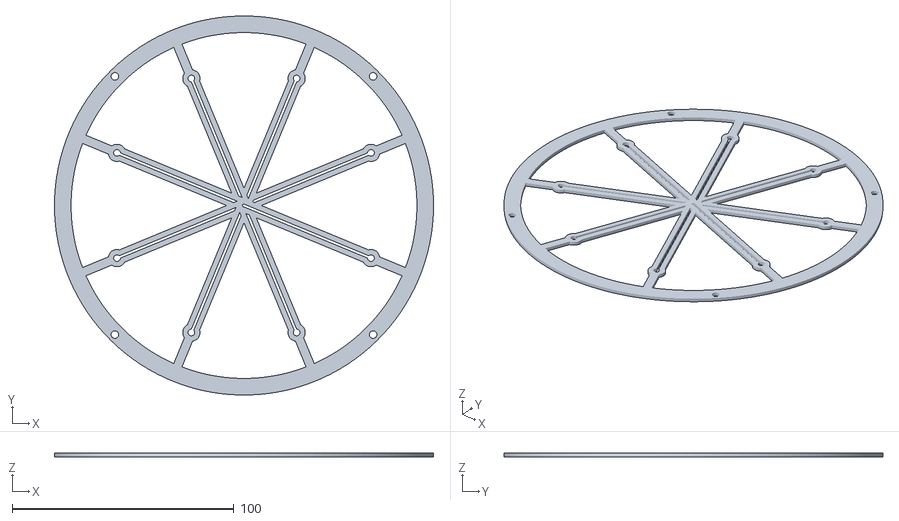
[picture p131: CAD file, 2026-10-24]
cad/output/curtain_stencil.stl
171.0 x 170.9 x 1.60
