TheRageKage12/drunk-lantern-power-battery/cad/output/handle_end_right.step

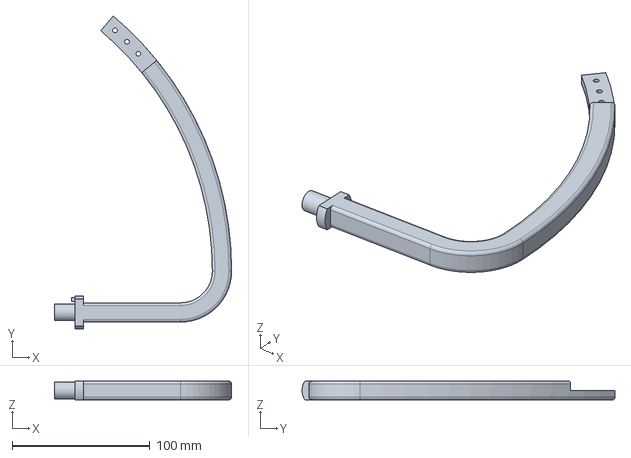
[picture p132: CAD file, 2026-10-24]
cad/output/handle_end_right.step
128.5 x 226.8 x 13.5 mm
