TheRageKage12/drunk-lantern-power-battery/cad/output/switch_bracket.step

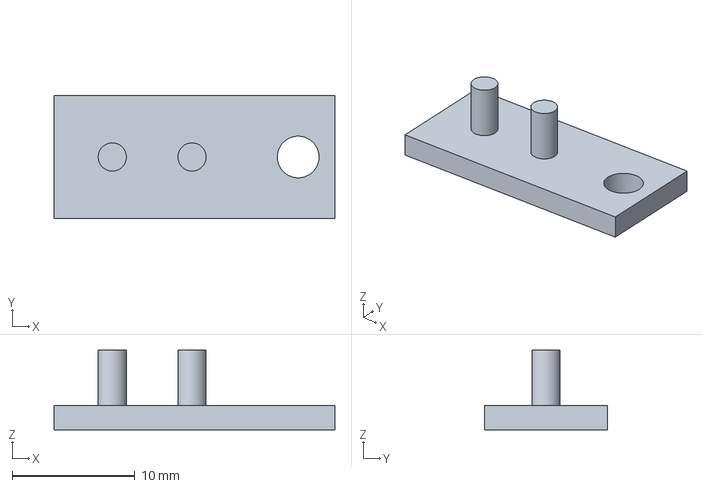
[picture p133: CAD file, 2026-10-24]
cad/output/switch_bracket.step
22.9 x 10.0 x 6.50 mm
