TheRageKage12/drunk-lantern-power-battery/cad/output/glass_path_envelope.step

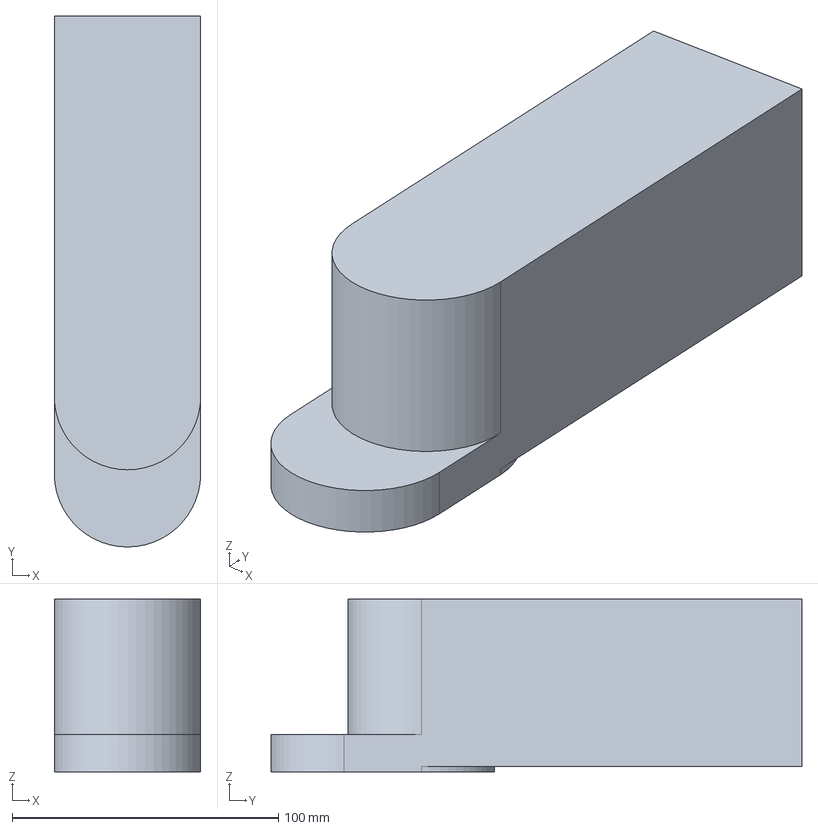
[picture p134: CAD file, 2026-10-24]
cad/output/glass_path_envelope.step
55.0 x 199.5 x 65.0 mm
