TheRageKage12/drunk-lantern-power-battery/cad/output/charge_socket_envelope.step

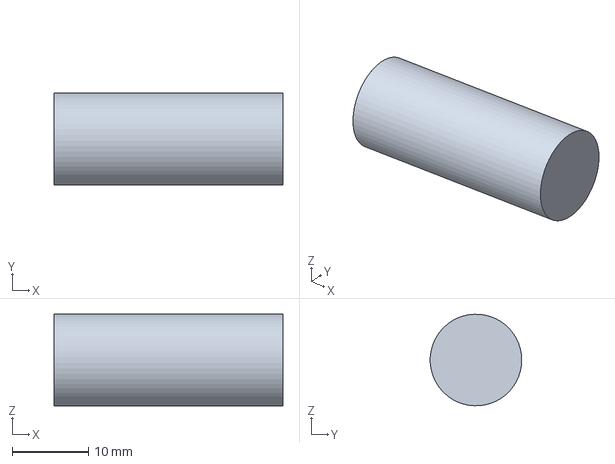
[picture p135: CAD file, 2026-10-24]
cad/output/charge_socket_envelope.step
30.0 x 12.0 x 12.0 mm
