TheRageKage12/drunk-lantern-power-battery/cad/output/socket_base.step

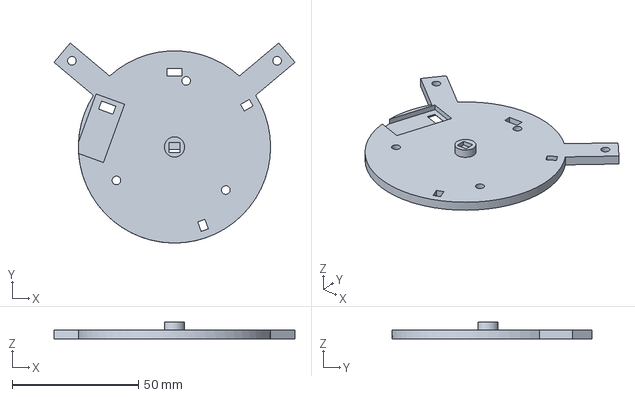
[picture p136: CAD file, 2026-10-24]
cad/output/socket_base.step
95.3 x 79.1 x 6.70 mm
