TheRageKage12/drunk-lantern-power-battery/cad/output/led_panel.step

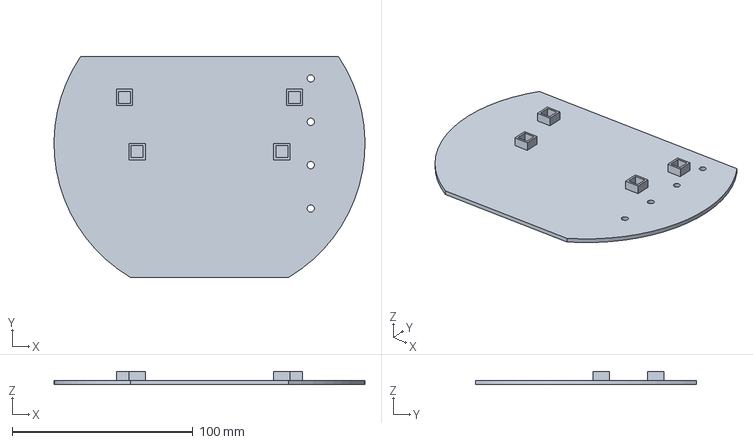
[picture p137: CAD file, 2026-10-24]
cad/output/led_panel.step
172.0 x 122.0 x 7.40 mm
