TheRageKage12/drunk-lantern-power-battery/cad/output/switch_envelope.step

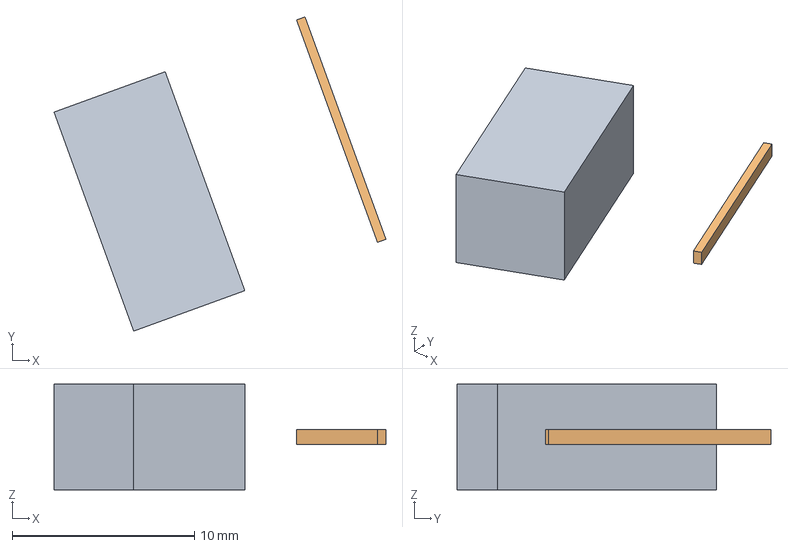
[picture p138: CAD file, 2026-10-24]
cad/output/switch_envelope.step
18.2 x 17.3 x 5.80 mm
