TheRageKage12/drunk-lantern-power-battery/cad/output/cap_led_envelope.step

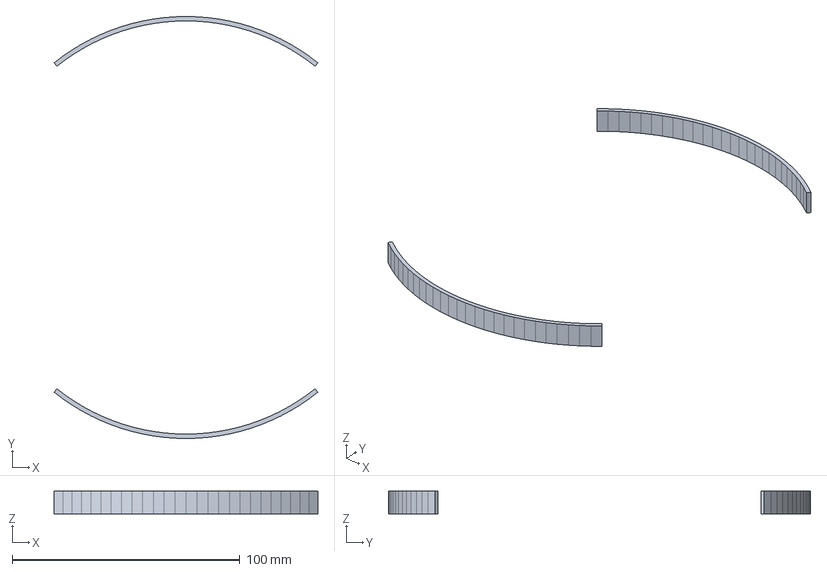
[picture p139: CAD file, 2026-10-24]
cad/output/cap_led_envelope.step
115.7 x 185.1 x 10.0 mm
