TheRageKage12/drunk-lantern-power-battery/cad/output/key_ring.step

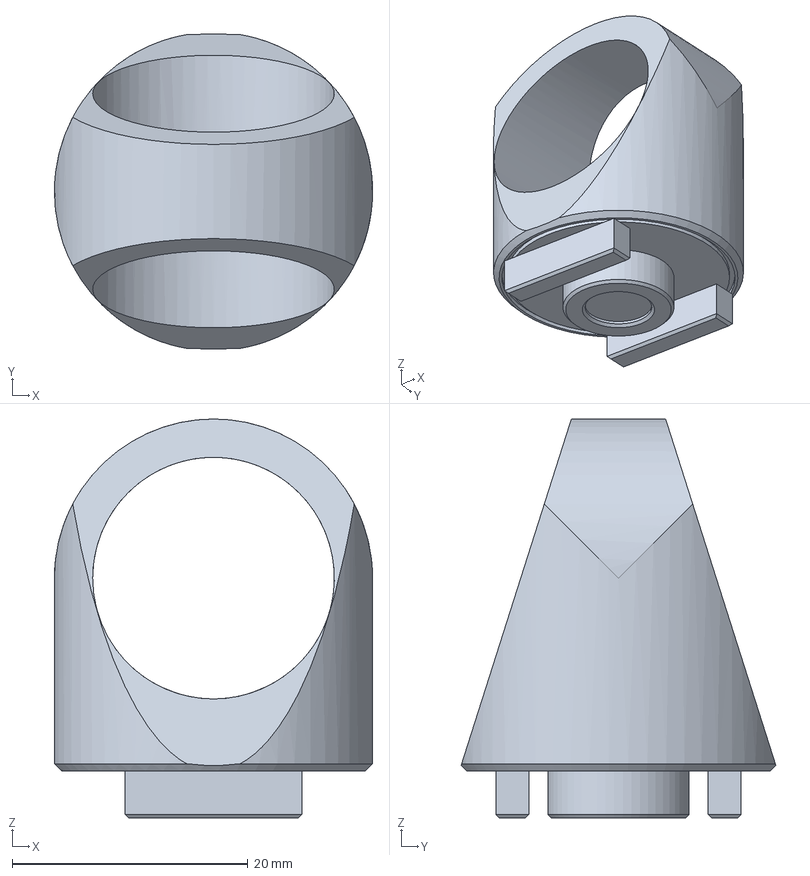
[picture p140: CAD file, 2026-10-24]
cad/output/key_ring.step
27.0 x 26.7 x 33.9 mm
