TheRageKage12/drunk-lantern-power-battery/cad/output/emblem_lid.step

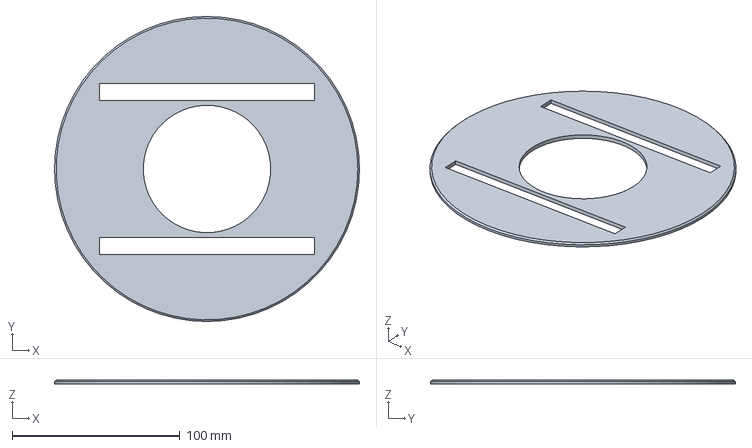
[picture p141: CAD file, 2026-10-24]
cad/output/emblem_lid.step
182.0 x 182.0 x 2.40 mm
