TheRageKage12/drunk-lantern-power-battery/cad/output/bay_floor.step

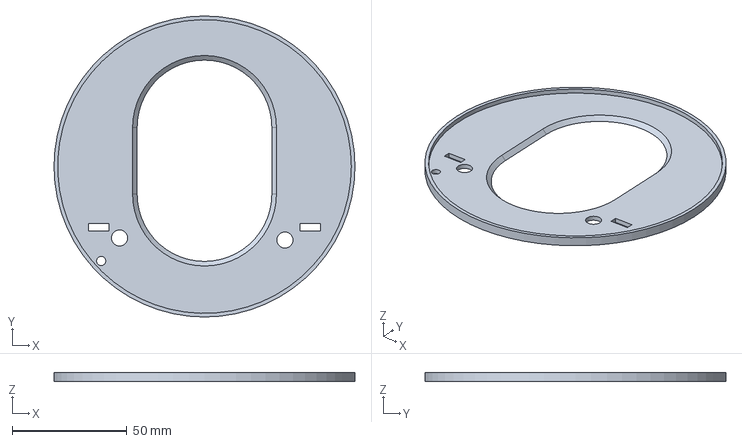
[picture p142: CAD file, 2026-10-24]
cad/output/bay_floor.step
131.0 x 131.0 x 4.00 mm
