TheRageKage12/drunk-lantern-power-battery/cad/output/curtain_clamp.step

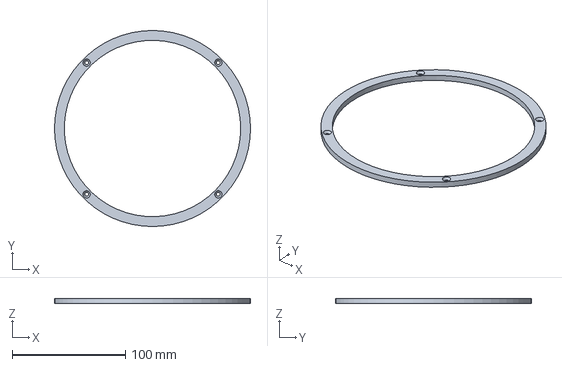
[picture p143: CAD file, 2026-10-24]
cad/output/curtain_clamp.step
173.4 x 173.4 x 4.50 mm
