TheRageKage12/drunk-lantern-power-battery/cad/output/panel_led_envelope.step

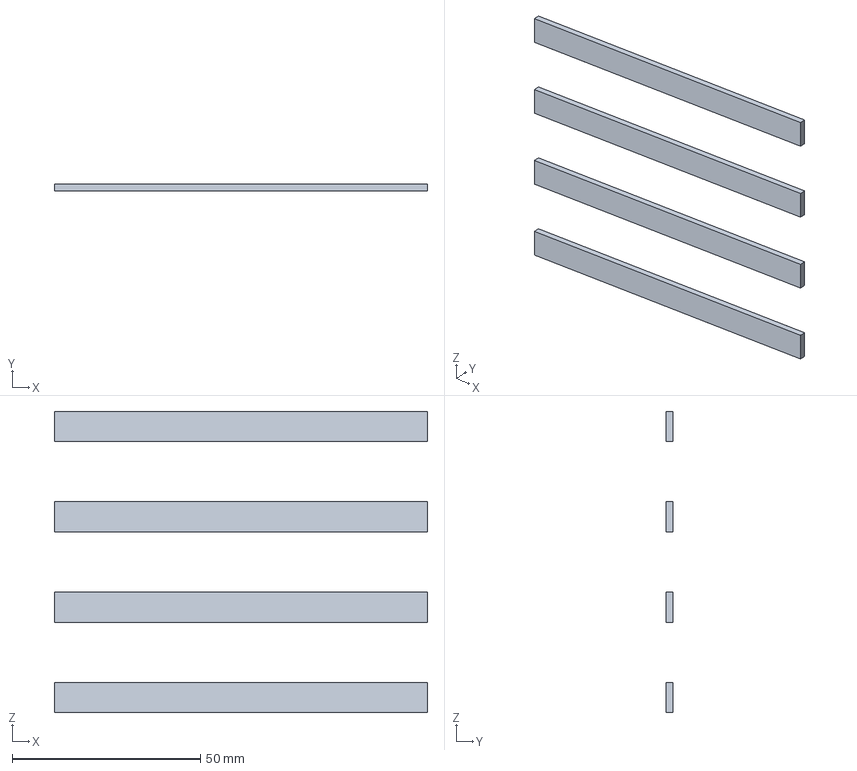
[picture p144: CAD file, 2026-10-24]
cad/output/panel_led_envelope.step
99.0 x 1.95 x 80.0 mm
