TheRageKage12/drunk-lantern-power-battery/cad/output/lock_wall.step

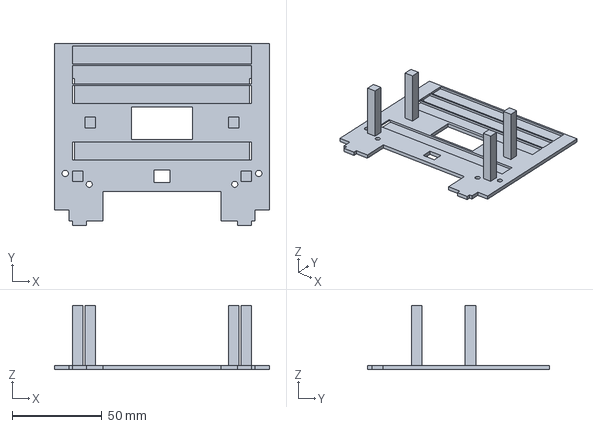
[picture p145: CAD file, 2026-10-24]
cad/output/lock_wall.step
120.0 x 101.5 x 35.8 mm
