TheRageKage12/drunk-lantern-power-battery/cad/output/cap_floor.step

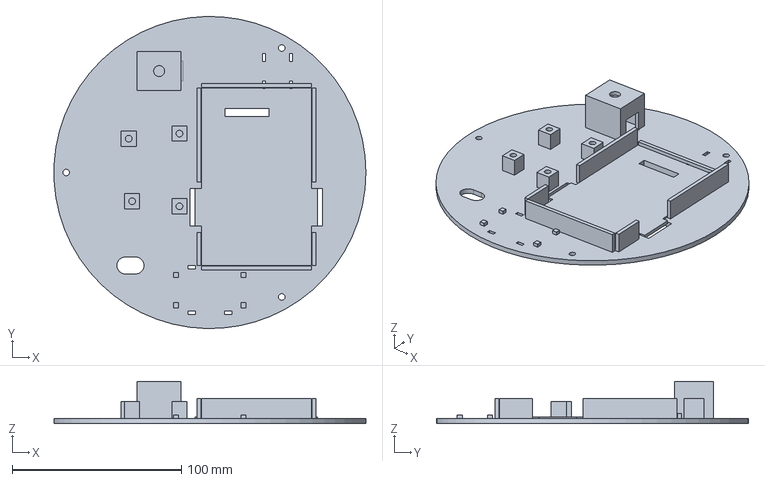
[picture p146: CAD file, 2026-10-24]
cad/output/cap_floor.step
184.5 x 184.5 x 25.0 mm
