TheRageKage12/drunk-lantern-power-battery/cad/output/guide_boss.step

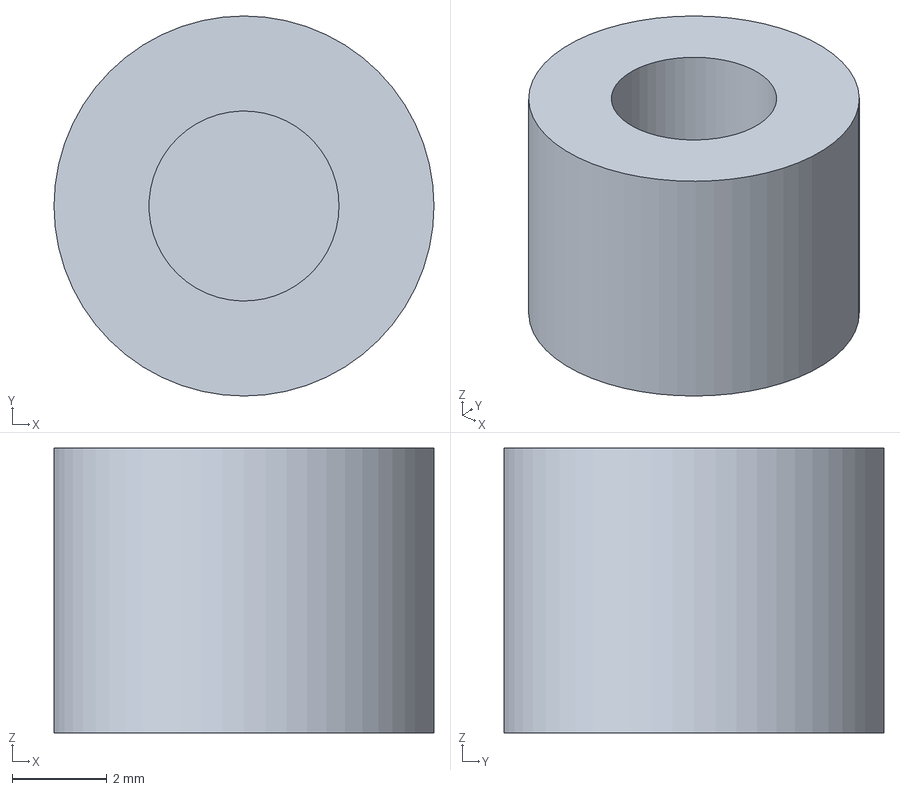
[picture p147: CAD file, 2026-10-24]
cad/output/guide_boss.step
8.00 x 8.00 x 6.00 mm
