TheRageKage12/drunk-lantern-power-battery/cad/output/fist_envelope.step

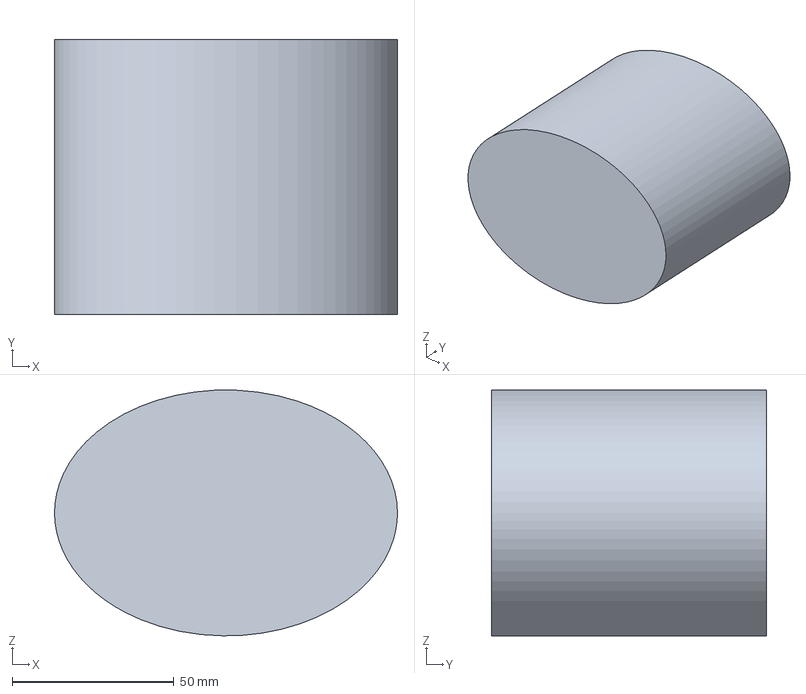
[picture p148: CAD file, 2026-10-24]
cad/output/fist_envelope.step
106.0 x 85.0 x 75.9 mm
