TheRageKage12/drunk-lantern-power-battery/cad/output/rotor.step

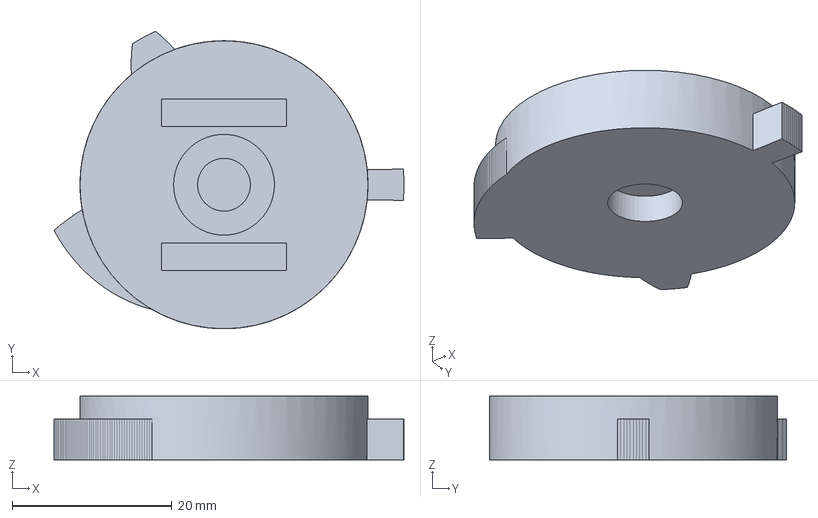
[picture p149: CAD file, 2026-10-24]
cad/output/rotor.step
43.8 x 37.2 x 8.00 mm
