TheRageKage12/drunk-lantern-power-battery/cad/output/curtain_envelope.step

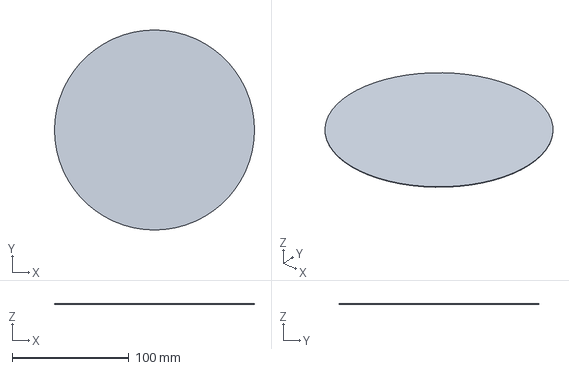
[picture p150: CAD file, 2026-10-24]
cad/output/curtain_envelope.step
171.0 x 171.0 x 0.45 mm
