TheRageKage12/drunk-lantern-power-battery/cad/output/pump_diode_envelope.step

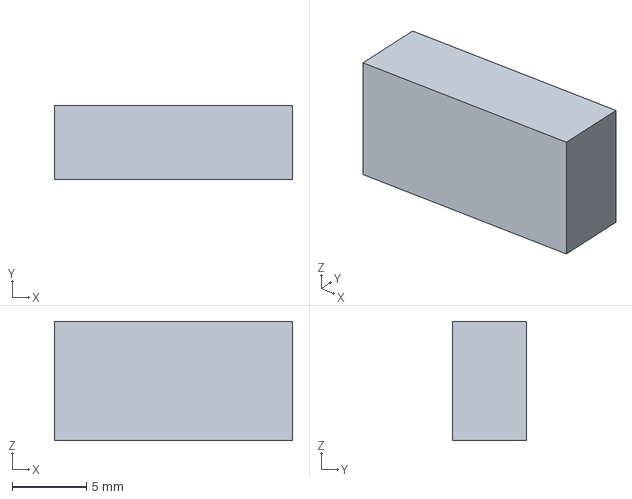
[picture p151: CAD file, 2026-10-24]
cad/output/pump_diode_envelope.step
16.0 x 5.00 x 8.00 mm
