TheRageKage12/drunk-lantern-power-battery/cad/output/hall_capacitor_envelope.step

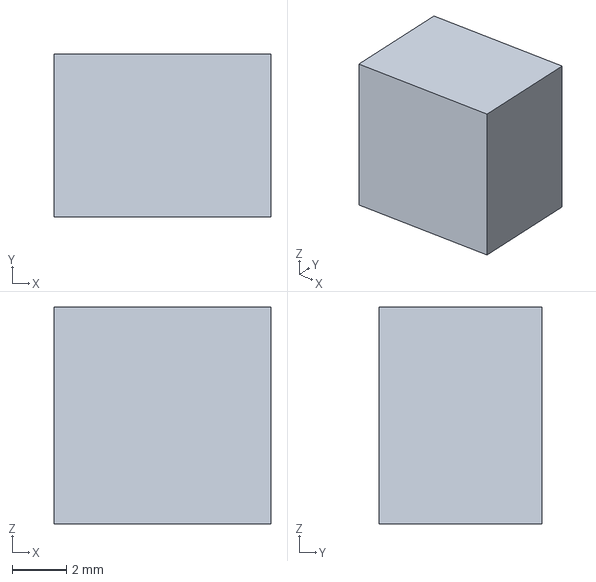
[picture p152: CAD file, 2026-10-24]
cad/output/hall_capacitor_envelope.step
8.00 x 6.00 x 8.00 mm
