TheRageKage12/drunk-lantern-power-battery/cad/output/emblem_jig.stl

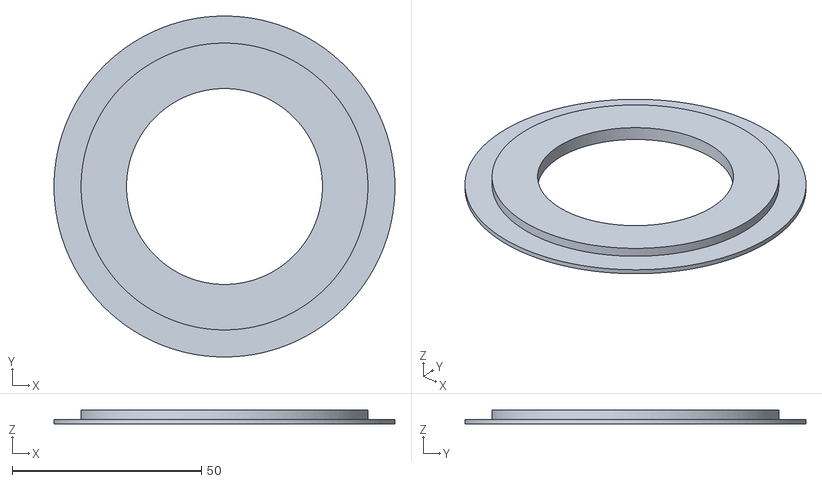
[picture p153: CAD file, 2026-10-24]
cad/output/emblem_jig.stl
90.0 x 90.0 x 3.60
