TheRageKage12/drunk-lantern-power-battery/cad/output/plunger.step

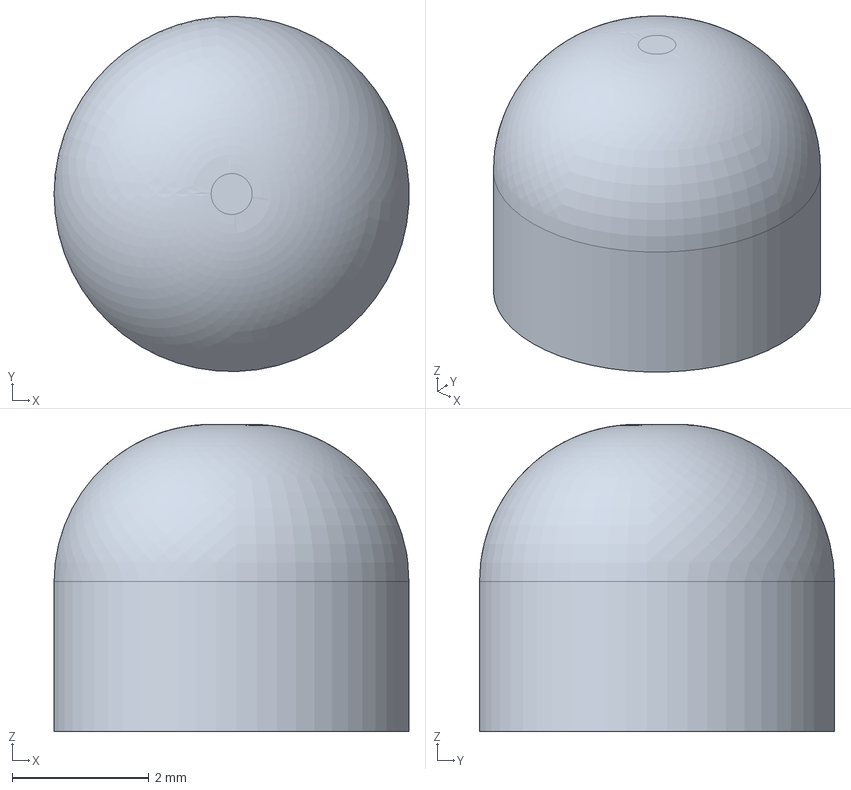
[picture p154: CAD file, 2026-10-24]
cad/output/plunger.step
5.20 x 5.20 x 4.50 mm
