TheRageKage12/drunk-lantern-power-battery/cad/output/bell_front.step

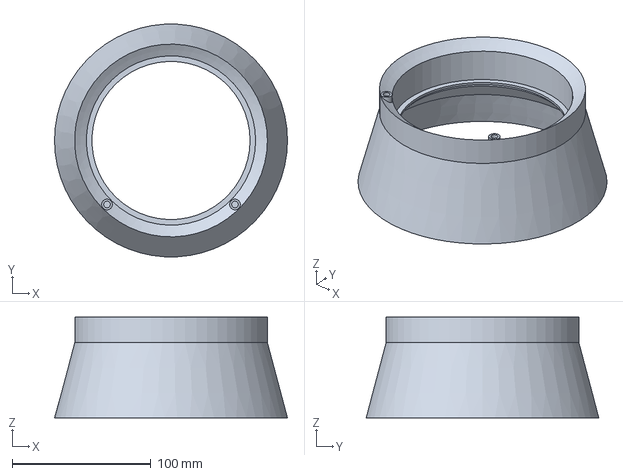
[picture p155: CAD file, 2026-10-24]
cad/output/bell_front.step
168.0 x 167.8 x 72.6 mm
