TheRageKage12/drunk-lantern-power-battery/cad/output/pump_envelope.step

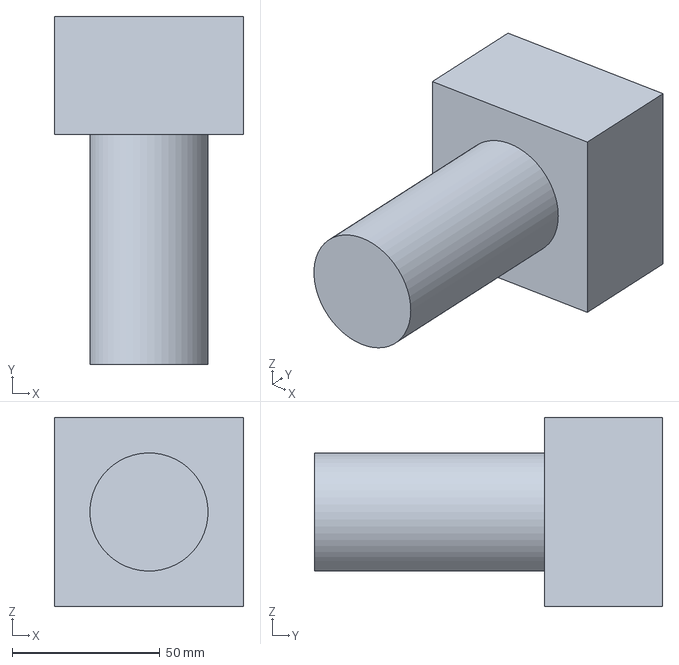
[picture p156: CAD file, 2026-10-24]
cad/output/pump_envelope.step
64.0 x 118.0 x 64.0 mm
