TheRageKage12/drunk-lantern-power-battery/cad/output/top_cap.step

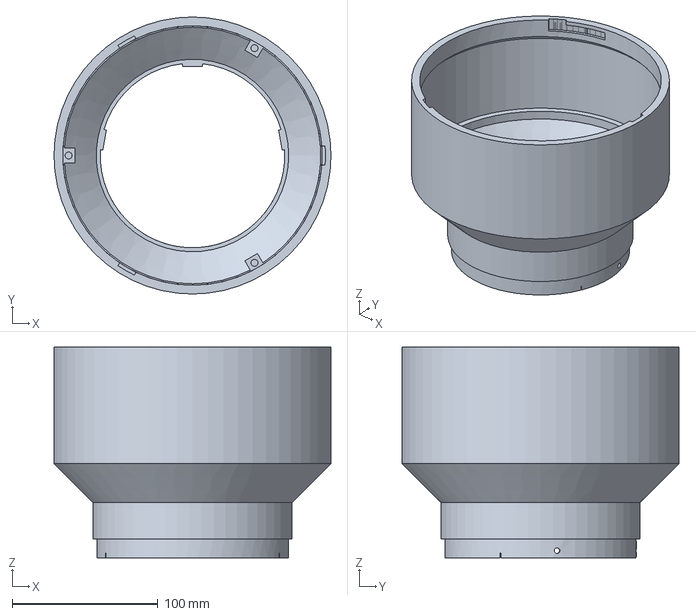
[picture p157: CAD file, 2026-10-24]
cad/output/top_cap.step
190.0 x 190.0 x 144.6 mm
