TheRageKage12/drunk-lantern-power-battery/cad/output/foot.step

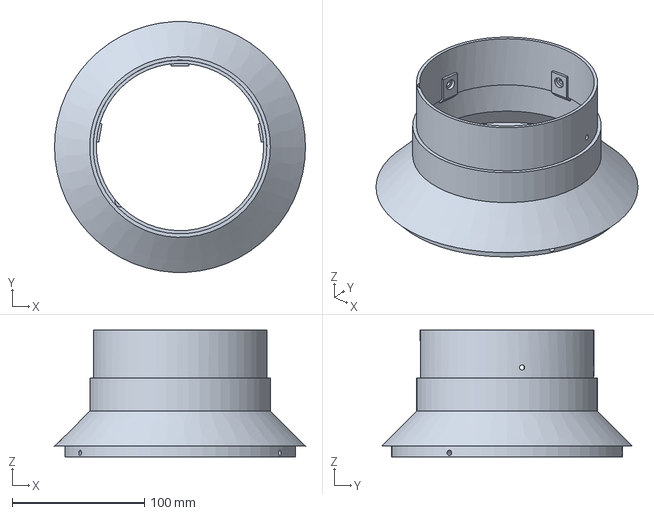
[picture p158: CAD file, 2026-10-24]
cad/output/foot.step
190.0 x 189.7 x 95.8 mm
