TheRageKage12/drunk-lantern-power-battery/cad/output/bell_rear.step

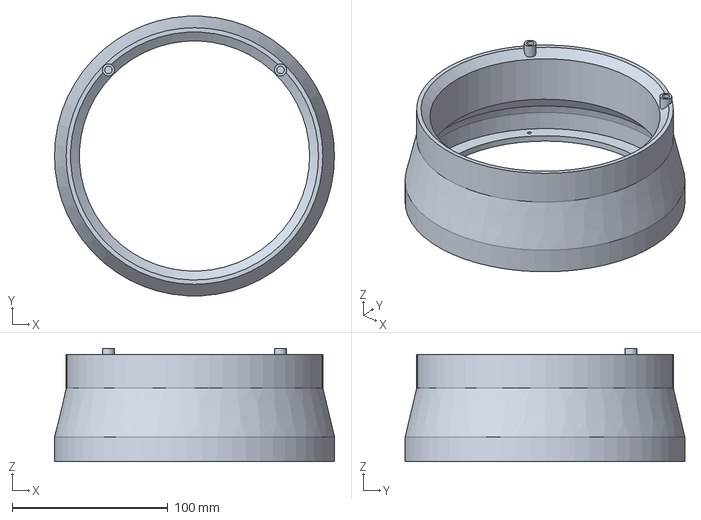
[picture p159: CAD file, 2026-10-24]
cad/output/bell_rear.step
180.0 x 179.7 x 72.8 mm
