TheRageKage12/drunk-lantern-power-battery/cad/output/sphere_rear.step

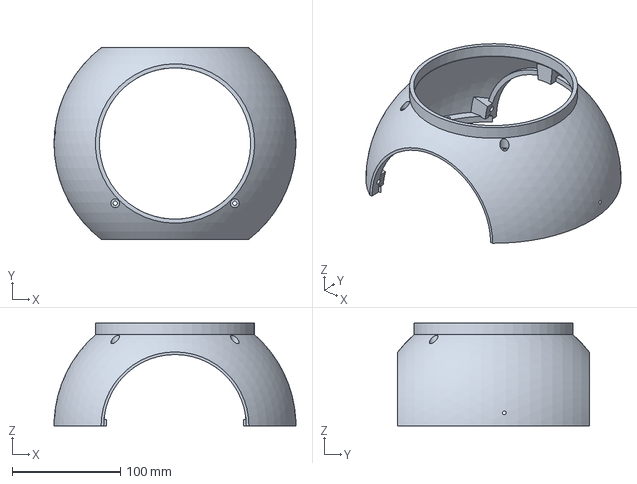
[picture p160: CAD file, 2026-10-24]
cad/output/sphere_rear.step
224.0 x 177.4 x 95.0 mm
