TheRageKage12/drunk-lantern-power-battery/cad/output/ring_sizer.stl

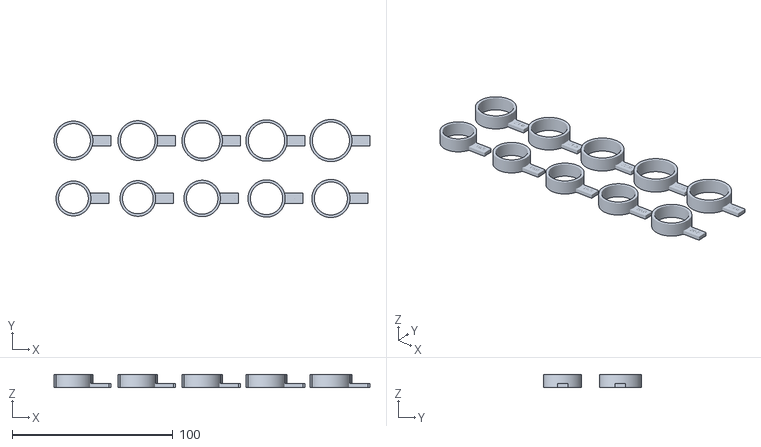
[picture p161: CAD file, 2026-10-19]
cad/output/ring_sizer.stl
196.4 x 60.9 x 8.00
