TheRageKage12/drunk-lantern-power-battery/(list of files, cad)

Other CAD files:
cad/output/handle_arc_2.step
cad/output/handle_pivot_left.step
cad/output/handle_end_left.step
cad/output/assembly.stl
cad/output/bag_cover.stl
cad/output/bag_envelope.stl
cad/output/base.stl
cad/output/base_tray.stl
cad/output/battery_connector_envelope.stl
cad/output/bay_floor.stl
cad/output/bell_front.stl
cad/output/bell_rear.stl
cad/output/board_cable_exit_envelope.stl
cad/output/board_components_envelope.stl
cad/output/board_wiring_envelope.stl
cad/output/buck_envelope.stl
cad/output/buck_wires_envelope.stl
cad/output/cap_floor.stl
cad/output/cap_led_envelope.stl
cad/output/charge_socket_envelope.stl
cad/output/curtain_clamp.stl
cad/output/curtain_envelope.stl
cad/output/diffuser.stl
cad/output/emblem_centre.stl
cad/output/emblem_lid.stl
cad/output/fist_envelope.stl
cad/output/foot.stl
cad/output/front_led_envelope.stl
cad/output/glass_envelope.stl
cad/output/glass_path_envelope.stl
cad/output/glass_well.stl
cad/output/guide_boss.stl
cad/output/hall_capacitor_envelope.stl
cad/output/halo_ring.stl
cad/output/hand_path_envelope.stl
cad/output/handle_arc_1.stl
cad/output/handle_arc_2.stl
cad/output/handle_end_left.stl
cad/output/handle_end_right.stl
cad/output/handle_pivot_left.stl
cad/output/handle_pivot_right.stl
cad/output/inline_connectors_envelope.stl
cad/output/key_cap.stl
cad/output/key_ring.stl
cad/output/led_panel.stl
cad/output/lock_wall.stl
cad/output/lug_sweep_envelope.stl
cad/output/nozzle_guide.stl
cad/output/panel_led_envelope.stl
cad/output/perfboard_envelope.stl
cad/output/plunger.stl
cad/output/power_switch_envelope.stl
cad/output/powerbank_envelope.stl
cad/output/pump_diode_envelope.stl
cad/output/pump_envelope.stl
cad/output/pump_plug_envelope.stl
cad/output/rear_led_envelope.stl
cad/output/rotor.stl
cad/output/screw_cap.step
cad/output/screw_cap.stl
cad/output/socket_base.stl
cad/output/socket_housing.stl
cad/output/sphere_front.stl
cad/output/sphere_rear.stl
cad/output/switch_bracket.stl
cad/output/switch_envelope.stl
cad/output/top_cap.stl
cad/output/wall_extension.stl
