TheRageKage12/drunk-lantern-power-battery/docs/review/protoboard/assembly-template.html

Drunk Lantern / Workbench

# Assemble the prototype board

Follow the numbered steps in order.

22 AWG · six colours · Existing M3 mounting · Build details

Before starting: disconnect battery and USB. Check part sizes and the M3 dry-fit. Hold the board by its edges.

← Previous Next step → Jump to a step

View

Part close-up − Fit +

Drawing: Component side = insert wire · Solder side = join ends

Click a solder point to identify it.

### Where the free end goes later

Identify this part

Leg-bending drawing and soldering access

The download is a full-size drawing of the part and its metal legs, from three angles. Print at 100% and use it to check the bends before cutting.

Download full-size bending drawing

Finished connection · side sketch, not to scale.

Print full-size wire shape

### Check before continuing

Drawing controls: select a probe pair to highlight its board holes.

Meter / probe locations | Expected result

If a result does not match, stop. Check the probe locations and contact, then repair the connection with all power disconnected. Repeat the test before continuing.

How to find a hole on the board

H04 means column H, row 4. Letters run across the drawing; numbers run down it. These are this guide’s labels, not necessarily markings on your board. On the component side, A01 is the upper-left grid hole. Flip left-to-right to solder: A01 moves to the upper right, but its name stays the same. Match the mounting holes to the drawing and keep row 01 at the top.

Wire soldering technique

Strip just enough to reach the joint shown on the back. Gently twist the strands and insert them without pre-tinning; keep the insulation against the front face. Solder the wire to the copper ring around its entry hole. Bend the bare end against the destination pin and trim it just beyond the pin. Reheat the pin’s existing solder to attach the wire. Keep stray strands away from neighbouring joints.

Later enclosure wiring · fixed cut list

Separate pieces for connecting the board to the rest of the lantern. Cut each listed colour; do not add these lengths to the board leads above. Retain connector pigtails and trim the new wire to meet them.

Piece | Colours | Cut each | Connects to

Routing, service slack and cut-length calculations

Wire colours

Cut list · all board wires and outgoing cables

Cut wires as you reach their step. Fit the indicated pairs together; trim excess after fitting.

Download cut list (CSV) Print current step

Wire | Connection | Colour | Starting cut | Centre height | Bend drawing

· Board documentation · Commissioning procedure
