TheRageKage12/drunk-lantern-power-battery/docs/review/protoboard/board-assembly.pdf

## COMPONENT SIDE · USB right

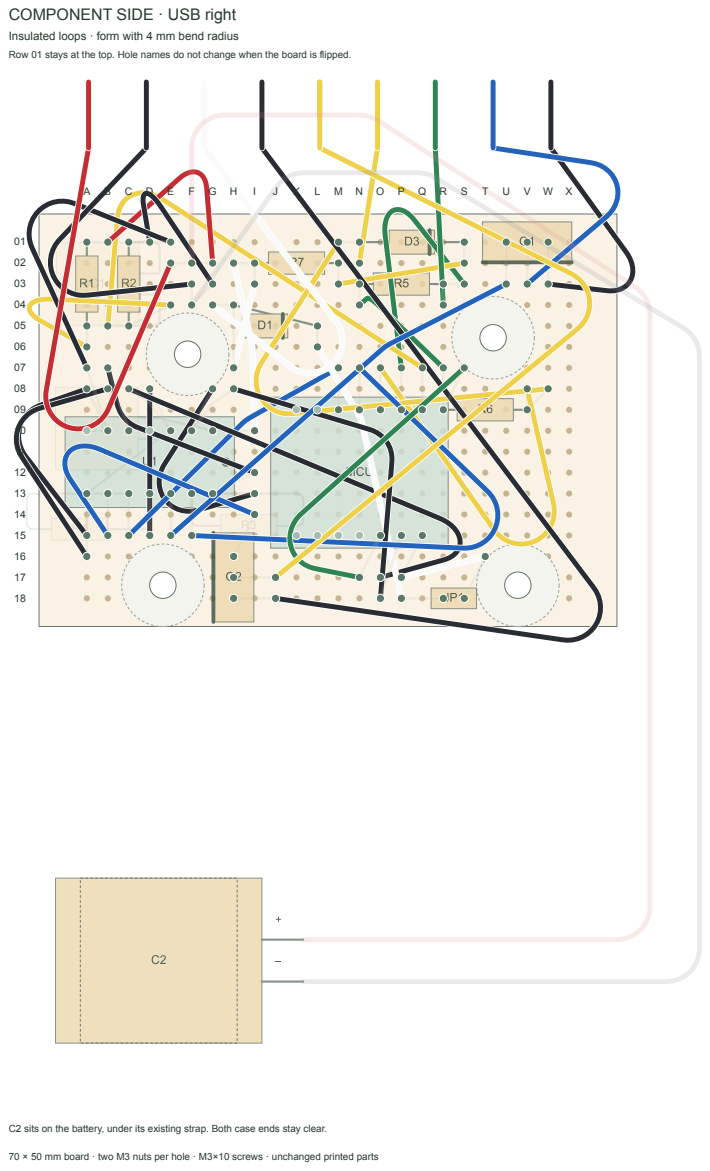
[picture p175: page 1]

Insulated loops · form with 4 mm bend radius
Row 01 stays at the top. Hole names do not change when the board is flipped.

C2 sits on the battery, under its existing strap. Both case ends stay clear.

70 × 50 mm board · two M3 nuts per hole · M3×10 screws · unchanged printed parts

## SOLDER SIDE · mirrored

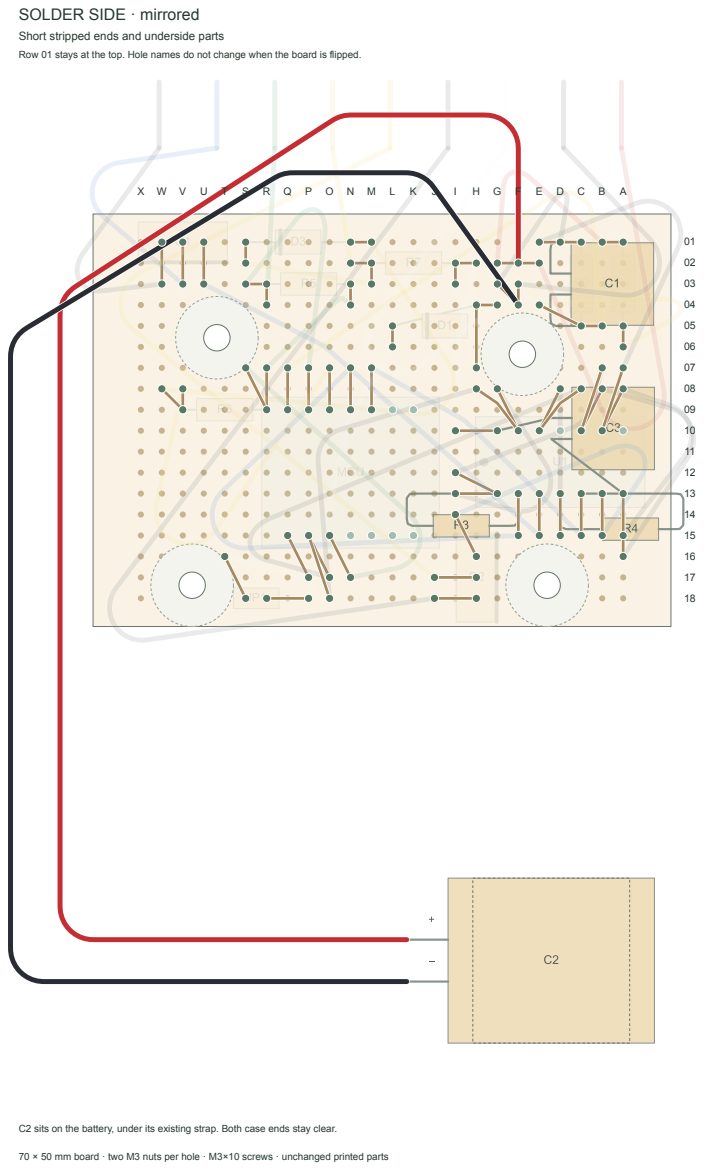
[picture p176: page 2]
UVWX; QRST; MNOP; IJKL; EFGH; ABCD

Short stripped ends and underside parts
Row 01 stays at the top. Hole names do not change when the board is flipped.

C2 sits on the battery, under its existing strap. Both case ends stay clear.

70 × 50 mm board · two M3 nuts per hole · M3×10 screws · unchanged printed parts

## WIRE CUTS AND SOLDER POINTS

W01 · white · P17 → Q15 → T16 → S18 · start 45 mm W04 · black · A08 → B10 → A15 → A13 · start 74 mm W07 · black · I13 → G13 → G08 → F10 · start 74 mm W15 · green · P07 → P09 → S03 → R03 · start 78 mm W25 · yellow · M03 → M02 → S02 → S01 · start 67 mm W16 · yellow · O07 → O09 → V08 → V09 · start 100 mm W22 · white · H07 → H04 → I03 → I02 · start 43 mm H03 · black · W03 → W01 · start 170 mm
H08 · yellow · N02 → M02 · start 220 mm
W05 · black · A16 → A13 → B08 → C10 · start 99 mm W10 · black · D08 → E10 → D15 → D13 · start 68 mm H09 · green · R04 → R03 · start 230 mm
W23 · white · H02 → I02 → I10 → G10 · start 62 mm H05 · blue · V03 → V01 · start 400 mm
W13 · yellow · Q07 → Q09 → B05 → C05 · start 104 mm W24 · red · B01 → A01 → G02 → F02 · start 70 mm W19 · blue · M07 → M09 → C15 → C13 · start 92 mm W12 · green · N04 → N03 → R07 → R09 · start 74 mm W14 · yellow · E04 → C05 → A06 → A05 · start 74 mm W06 · black · B07 → C10 → I12 → G13 · start 96 mm W09 · black · O17 → P15 → C08 → E10 · start 116 mm W26 · white · L06 → L05 → P18 → R18 · start 83 mm W21 · blue · B15 → B13 → I14 → H16 · start 104 mm W02 · black · G03 → F04 → D01 → C01 · start 86 mm W03 · black · E01 → C01 → A07 → B10 · start 102 mm W17 · yellow · W08 → V09 → M01 → N01 · start 115 mm H02 · black · F03 → F04 · start 190 mm
W08 · black · H08 → F10 → O18 → P15 · start 113 mm H04 · black · J18 → H18 · start 260 mm
H07 · white · G04 → H04 · start 190 mm

Trim after forming. Outgoing-wire slack stays beside the cap opening, never on the board.

## WIRE CUTS AND SOLDER POINTS

H01 · red · E02 → F02 · start 250 mm
W18 · blue · N07 → N09 → F15 → F13 · start 133 mm W11 · green · N17 → O15 → S07 → R09 · start 119 mm W20 · blue · E15 → E13 → U03 → U01 · start 133 mm H06 · yellow · J17 → H17 · start 440 mm
C2_1 · red · F02 → C2.1 · start 235 mm
C2_2 · black · F04 → C2.2 · start 240 mm

Trim after forming. Outgoing-wire slack stays beside the cap opening, never on the board.
