TheRageKage12/drunk-lantern-power-battery/docs/images/cad-assembly-top.png

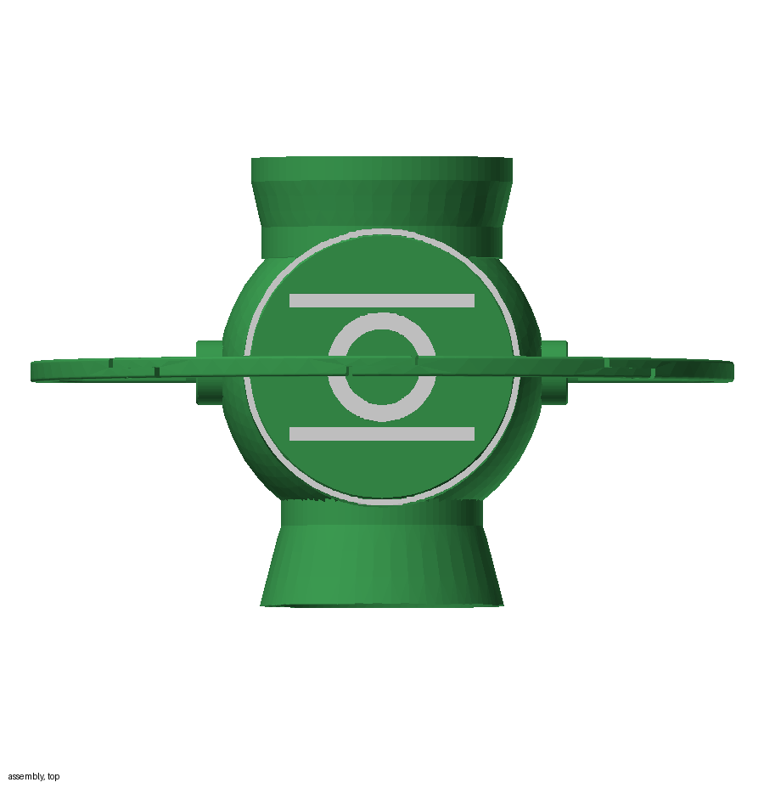
docs/images/cad-assembly-top.png
