TheRageKage12/drunk-lantern-power-battery/docs/images/stl/guide_boss_iso.png

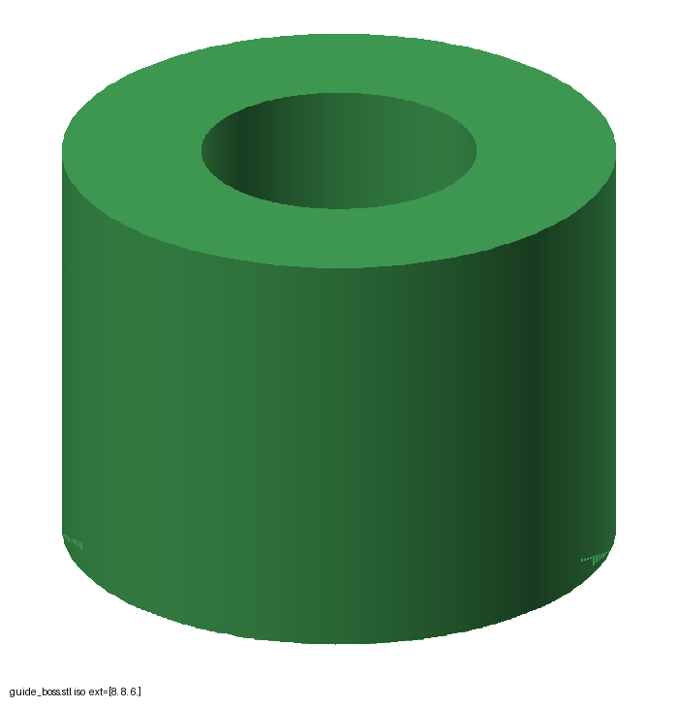
docs/images/stl/guide_boss_iso.png
