TheRageKage12/drunk-lantern-power-battery/docs/images/stl/guide_boss_top.png

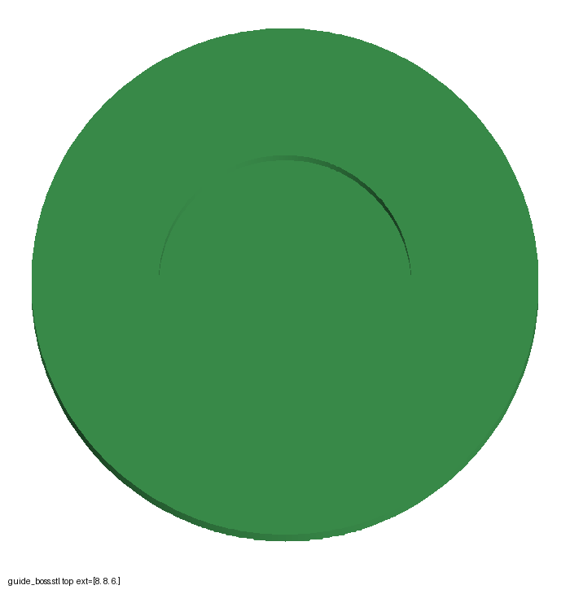
docs/images/stl/guide_boss_top.png
