TheRageKage12/drunk-lantern-power-battery/docs/images/stl/nozzle_guide_iso.png

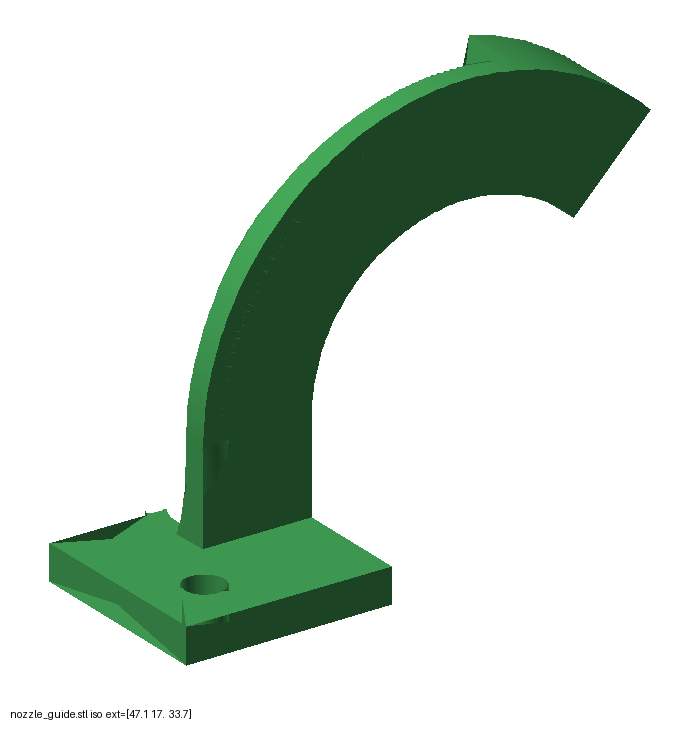
docs/images/stl/nozzle_guide_iso.png
