TheRageKage12/drunk-lantern-power-battery/docs/images/stl/nozzle_guide_top.png

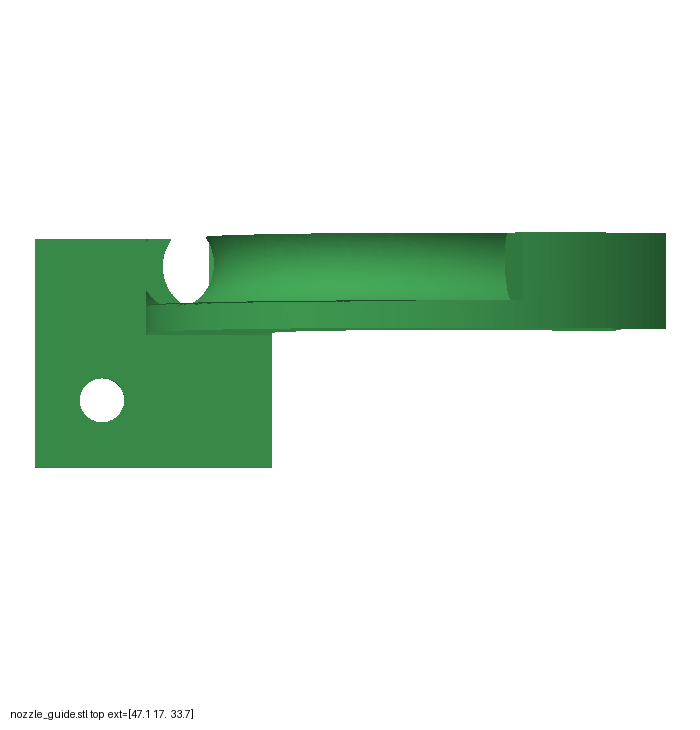
docs/images/stl/nozzle_guide_top.png
