TheRageKage12/drunk-lantern-power-battery/docs/images/stl/thumb_test_iso.png

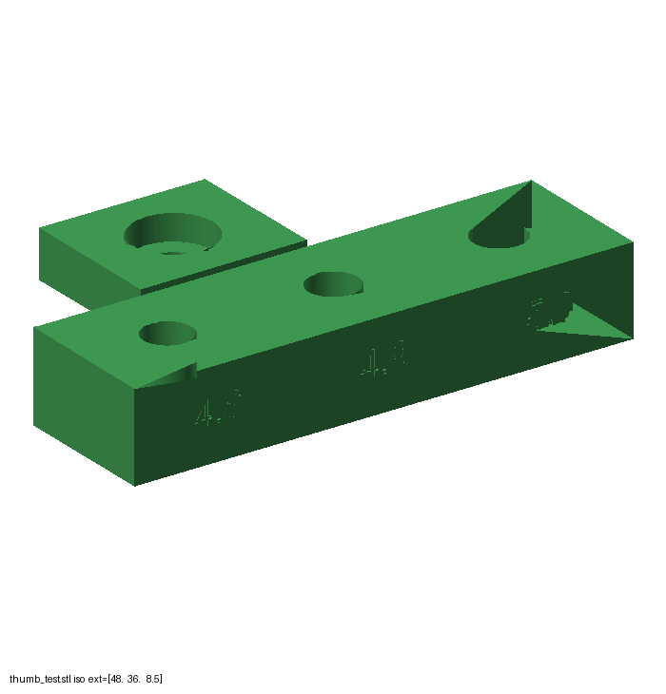
docs/images/stl/thumb_test_iso.png
