TheRageKage12/drunk-lantern-power-battery/(commit log)

2026-10-11 Initial scaffold: original Hedo3D model, ChatGPT transcript, brief, CAD contract/params/harness, firmware draft
    Claude-Session: https://claude.ai/code/session_01RA7Cpt4fWuKXDa6DwBe3et
    [base.stl, base_snap.stl, connection.stl, connection_2.stl, cover.stl, cover_lock_1.stl, cover_lock_2.stl, fingerring_15mm.stl]
2026-10-11 Research checkpoint: power system notes (work in progress)
    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
2026-10-11 Params: researched pump/bottle/glass/power-bank dimensions; contract revision 2
    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
    [dish_lower.step, dish_lower.stl, dish_upper.step, dish_upper.stl]
2026-10-11 Firmware: fix 4 interlock bugs found by the host-side simulation harness (15/15 scenarios pass)
    - cal bench command was stopped by the no-ring interlock in the same pass
    - hard run-time cap could be reset by a second pumpStart()
    - switch stuck pressed after boot poured on ring insertion
    - FLASH->POURING used a stale debounced Hall reading
    - HALL_PIN uses INPUT_PULLUP (DRV5032 primary, A3144 alternative via divider)
    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
2026-10-11 CAD checkpoint: base module in progress (agent output)
    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
    [base.step, base.stl, base_door.step, base_door.stl, bottle_envelope.step, bottle_envelope.stl, powerbank_envelope.step, powerbank_envelope.stl]
2026-10-11 Diagrams: wiring, fluid path, state machine, interaction timeline, socket mechanism (SVG + generators)
    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
    [base.step, base.stl, base_deck.step, base_deck.stl, base_door.step, base_door.stl, bottle_envelope.step, bottle_envelope.stl]
2026-10-11 Research: seven fact-checked topic notes (pump, power, lighting, electronics, mechanical, Seattle sourcing, design critique)
    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
2026-10-11 Design revision 3: squat jar reservoir, wide hinged hatch + glass tray, 76 mm socket housing, PD 12 V + buck power
    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
2026-10-11 Firmware rev 3: PRIME button, 60 ms pour abort, pour brightness cap, idle pilot glow (16/16 scenarios pass)
    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
2026-10-11 Wiring diagram: final power architecture (PD 12 V + buck), AHCT125 pump trigger, PRIME button; generators run from the repo
    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
2026-10-12 CAD checkpoint: agent work in progress
    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
    [assembly.step, assembly.stl, base.step, base.stl, base_deck.step, base_deck.stl, base_door.step, base_door.stl]
2026-10-12 CAD: base deck re-laid out for the squat jar (rev 3), envelope/check tolerances; checks pass for base, dishes, handle
    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
    [assembly.step, assembly.stl, base.step, base.stl, base_deck.step, base_deck.stl, base_door.step, bottle_envelope.step]
2026-10-12 CAD: multi-part view renderer (iso/front/rear/top, cutaway, exploded, parts sheet)
    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
2026-10-12 CAD renders: cutaway camera fix
    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
2026-10-12 Build guide: first full draft (BOM, stores, electronics, firmware, socket, fluid, sphere, assembly, calibration, tests, cleaning, troubleshooting)
    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
2026-10-12 CAD: socket module rev 4 (flat rotor, radial spring plunger on a ramp, captured-nut base plate) + mechanism sweep test
    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
    [base.step, base_deck.step, base_door.step, bottle_envelope.step, dish_lower.step, dish_upper.step, halo.step, halo.stl]
2026-10-12 CAD complete: sphere module, full assembly with 0 check problems, renders; guide print table and socket procedure; cad README; socket diagram updated for the plunger design
    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
    [assembly.step, assembly.stl, base.step, base_deck.step, base_door.step, bay_floor.step, bay_floor.stl, bottle_envelope.step]
2026-10-12 Firmware: single PWM green strip with a steady brightness ramp, pump speed setting, idle floor; harness updated (17/17 pass)
    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
2026-10-12 CAD: tapped M3 holes instead of heat-set inserts, no socket LED ring/halo, no door switch hole; renders refreshed
    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
    [assembly.step, assembly.stl, base.step, base.stl, base_deck.step, base_deck.stl, base_door.step, base_door.stl]
2026-10-12 Diagrams: new wiring for the budget circuit (PD 12 V, LM2596, AHCT125 + 2 MOSFETs, plain LED strip); state, timeline, fluid and socket diagrams updated
    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
2026-10-12 Build guide rewritten for the ~$140 budget build; Hall pocket fits the DRV5032; READMEs and contract updated
    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
    [assembly.step, assembly.stl, base.step, base_deck.step, base_door.step, bay_floor.step, bottle_envelope.step, diffuser.step]
2026-10-12 Firmware: hold-to-pour; light climbs 15% -> 90% during the pour, swells to full on release then goes dark; early release stops the pour with a small swell; 10-bit PWM; harness rewritten (17/17 pass)
    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
2026-10-12 Hold-to-pour: state and timeline diagrams, build guide (interaction, firmware notes, calibration by speed, tests, performance), README
    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
2026-10-12 CAD: punch-in layout - socket inside the sphere facing the open rear hand port, glass in a well below the fist, quarter-bend nozzle guide, top cap closes the upper dish; fist/forearm clearance envelo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
    [assembly.step, assembly.stl, base.step, base_deck.step, base_door.step, bay_floor.step, bay_floor.stl, bottle_envelope.step]
2026-10-12 CAD: glass slides out - sloped slot well (pour at the front under the nozzle, pull back 24 mm, then lift clear of the tip and the socket); glass-path clearance envelope; wider hand port (120 mm) and 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
    [assembly.step, assembly.stl, base.step, base_deck.step, base_door.step, bay_floor.step, bay_floor.stl, bottle_envelope.step]
2026-10-12 CAD: detent ridge instead of a useless 3 deg slope; LED carrier posts point at the diffuser and the carrier sits at its slots (8 rows, 99 mm tall); sphere halves placed without the print-bed shift; f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
    [assembly.step, assembly.stl, base.step, base_deck.step, base_door.step, bay_floor.step, bay_floor.stl, bottle_envelope.step]
2026-10-12 Checks fail on part overlaps above 0.1 cm3 (1 cm3 hid real clashes); fluid-path diagram is now a true section cut from the CAD
    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
    [assembly.step, base.step, base_deck.step, base_door.step, bay_floor.step, bottle_envelope.step, diffuser.step, dish_lower.step]
2026-10-12 CAD rev 8: lock wall layout - socket on a wall just inside the hand port, glass pushed back under the lock to a stop with its back third behind the wall, nozzle hidden behind the wall, LED rows/colum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
    [assembly.step, assembly.stl, base.step, base_deck.step, base_door.step, bay_floor.step, bay_floor.stl, bottle_envelope.step]
2026-10-12 Diagrams for the lock wall layout: fluid path section (wall, LEDs, curtain, hidden nozzle), the lock mounted on the wall, wiring label, timeline
    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
2026-10-12 Guide, READMEs and design contract for the lock wall layout: strip curtain, frosted top, glass pushed in under the lock, left-hand key cap, revised screw counts and print list
    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
2026-10-12 Lock twists counterclockwise (LOCK_TWIST = 'ccw'): the whole lock is mirrored left-right on output with conjugated placements; ears and lock wall unchanged; guide, contract and lock diagram updated
    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
    [assembly.step, assembly.stl, base.step, base_deck.step, base_door.step, bay_floor.step, bottle_envelope.step, curtain_clamp.step]
2026-10-12 Base cartridge (rev 9): the base drum stays with the lantern and opens at the bottom; tray + deck + bank + jar + pump + electronics slide up into it, held by 3 hidden thumbscrews from underneath (pri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
    [assembly.step, assembly.stl, base.step, base.stl, base_deck.step, base_deck.stl, base_door.step, base_door.stl]
2026-10-13 Power: VEGER 5000mAh bank (77 x 35 x 25, USB-C plug with 12 V PD) + AITRIP PDC004 fixed-12V trigger board instead of the Adafruit PD cable; smaller bank pocket with side rails, central strap and room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
    [assembly.step, assembly.stl, base.step, base_deck.step, base_deck.stl, base_tray.step, base_tray.stl, bay_floor.step]
2026-10-13 Power: KBT 12 V Li-ion pack with charge jack, power switch and battery sense
    - Base cartridge: pocket for the 70 x 55 x 20 mm KBT pack (deck drops 4.7 mm);
    port panel on the tray with holes for a panel-mount DC5521 charge jack and a
    mini toggle switch; matching notch in the drum's bottom band, open at the
    bottom so the drum still lifts off. Trigger board and its envelope removed.
    - Firmware: battery voltage on D0 (100 k / 22 k divider), pump and LED duty
    scaled by 12 / Vbat so pours stay the same size as the pack drains,
    low-battery double blink on insertion below 10.5 V, `vcal` calibration
    (settings GL03). Three new simulated scenarios (20/20 pass).
    - Wiring diagram, build guide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
    [assembly.step, assembly.stl, base.step, base.stl, base_deck.step, base_deck.stl, base_tray.step, base_tray.stl]
2026-10-13 Fluid diagram labels for the battery pack; fix step order in guide section 7
    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
    [gen_fluid.py]
2026-10-13 Nozzle points 45 deg down into the glass; one-way vent valve in the jar lid
    A level tube end threw the stream ~19 mm sideways at the default pump speed,
    onto the rim of a 1.5 oz glass (and past it at 100 %). nozzle_guide now bends
    the tube 135 deg (R 18, rise 11): the tip sits 6.7 mm above the rim, pointing
    down, and the stream lands ~19 mm from the glass centre at any speed. Fit
    checks 0 problems; guide clears the lowest back LED row by 1.3 mm.
    The jar's open vent hole becomes an aquarium check valve (air in, nothing
    out), so a tipped jar can't leak onto the cartridge.
    Claude-Session: https://claude.ai/code/session_01RA7Cpt4fWuKXDa6D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
    [assembly.step, assembly.stl, base.step, base_deck.step, base_tray.step, bay_floor.step, bay_floor.stl, bottle_envelope.step]
2026-10-13 Add a PNG copy of the wiring diagram
    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
2026-10-13 Guide: note the buck-boost upgrade for steady LED brightness
    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
2026-10-13 Firmware: update a stale power-bank comment
    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
2026-10-13 Guide: thread the cables through the bay floor before fitting the plugs; nozzle tube laid into the open channel
    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
2026-10-13 Guide: test the glass in glass_well before the big prints
    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
2026-10-13 Guide: clean with short cal runs that fit the shot glass; check the battery on the day
    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
2026-10-13 Shopping list: links for every item; switch hole 6.5 mm to fit a 1/4" toggle bushing
    Vetco and Tacoma Screw product links checked against their sites. The panel
    hole for the power switch was 6.2 mm, too small for the 1/4" (6.35 mm)
    bushing of Vetco's mini toggle; it is now 6.5 mm (fits 1/4" and M6).
    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
    [assembly.step, assembly.stl, base.step, base_deck.step, base_tray.step, base_tray.stl, bay_floor.step, bottle_envelope.step]
2026-10-13 Shopping list without Adafruit: A3144 from Vetco; fix the A3144 instructions
    The old note said to stack two magnets, but the key cap pocket only holds one,
    and pointed to wiring steps that did not exist. Added the A3144 wiring (5 V,
    diode to D1), the one-pole check and where it sits, and a bench check.
    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
2026-10-13 Hall sensor: A3144 on a post inside the rotor, ~3 mm from the magnet
    Through the rotor floor the A3144 was ~5.5 mm from the magnet (~30 mT, below
    its 35 mT worst-case operate point). The rotor now has a blind hole from below
    (1 mm skin under the magnet) and socket_base a post with the sensor pocket on
    its tip, clear of the rotor even when a punch takes up the 1.2 mm axial play:
    ~3 mm, ~90 mT. socket_base now prints bottom down. HALL_SENSOR = 'DRV5032'
    restores the old board pocket. Wiring diagram, lock diagram, guide, shopping
    list and firmware comments updated; lock test checks the pushed-in rotor.
    Claude-Session: https://claude.ai/co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
    [assembly.step, assembly.stl, base.step, base_deck.step, base_tray.step, bay_floor.step, bottle_envelope.step, curtain_clamp.step]
2026-10-13 2400 mAh battery (deck raised), green COB LED strip, shopping list with specific links
    - Battery: KBT 12 V 2400 mAh, 70 x 55 x 40 mm (bare leads). The deck rises
    18 mm (DECK_GAP 4 -> 2, the deck holds the pack down). Fit checks pass;
    closest gaps are radial to the lower dish: pump envelope 1.0 mm (an
    estimate: measure the pump before printing base/dish_lower), jar envelope
    0.5 mm (real jar <= 73 mm with lid: ~2 mm).
    - LED strip: 8 mm green COB, cut every 25 mm, 7 pieces (~0.6 A estimated).
    - Plugs: two 4-pin JST-SM pairs; spring from an assortment kit.
    - Shopping list: every item links to a specific listing, with Prime delivery
    dates read on 2026-10-13; jar and shot glass still to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
    [assembly.step, assembly.stl, base.step, base_deck.step, base_deck.stl, base_tray.step, base_tray.stl, bay_floor.step]
2026-10-13 Widen the base and lower dish to 190 mm; buy the jar and shot glass locally
    D_MAX 180 -> 190 for the base bands and the lower dish mouth, so the raised jar
    and pump clear the lower dish by 5-6 mm (were 0.5 and 1 mm). The upper dish
    keeps a 180 mm mouth (UPPER_DISH_MOUTH_D) so the handle legs still clear its
    rim and sphere_rear stays on the Ender 3 bed. Fit checks: 0 problems.
    Part list ~850 g; two green spools. No Amazon search links left in the guide.
    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
    [assembly.step, assembly.stl, base.step, base.stl, base_deck.step, base_deck.stl, base_tray.step, base_tray.stl]
2026-10-13 Shopping list: use the super glue you already have
    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
2026-10-13 Shopping list: plugs from Vetco (2 pairs instead of 20), pen spring first, single check valve locally
    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
2026-10-13 Spring from Ace Hardware's Hillman drawer
    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
2026-10-13 Printable shopping list (PDF)
    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
2026-10-13 Build guide and READMEs: bring up to date
    - Guide: 20 test scenarios, 19 cm base, lock wall position wording, PNG
    diagrams, prices read from listings (magnets, XIAO, MOSFETs, small parts),
    Amazon items in 2.1 and local items in 2.2, Seattle stores for the spring,
    curtain sheet and check valve, ~$190 total, calibration with the shot glass
    only, charge at half, COB strip in the rationale.
    - README: 190 mm base, ~$190, link to the shopping list and PDF.
    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
2026-10-13 Add review handoff: decision context and session prompt
    docs/review/CONTEXT.md condenses the design sessions: Kevin's preferences, the
    show spec, every current decision with its reason and rejected alternatives,
    accepted risks, known loose ends and tooling notes. docs/review/REVIEW_PROMPT.md
    is a phased, priority-ordered prompt for a full review session, with usage-limit
    setup steps.
    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
2026-10-13 Add design conversation transcript for the review
    Text of the design sessions (76 owner messages, 243 reply blocks, 4 compaction
    summaries), without tool calls, tool output or system messages. CONTEXT.md
    remains the source for current decisions; this is for checking why.
    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
2026-10-13 Review phase 1: consistency fixes and four CAD defects
    Docs: one total everywhere ($186, with what it includes), the 2.5 mm drill
    bit and Loctite leftovers, the nut count, research notes labelled historical,
    vcal/save and cal wording matched to the firmware, the plug pin order written
    into the firmware header and the wiring diagram, vcal added to the state
    diagram, cam start angle 30 deg as in the CAD, filament grams rescaled to a
    realistic density, the vent valve given its own lid hole, nozzle guide print
    notes, and stale comments in params.py and dishes.py.
    CAD (DESIGN_CONTRACT rev 9g): the sphere halves had no dish-joint screw
    holes (the cutters started at r 92 and missed the collar at r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
    [assembly.step, assembly.stl, base.step, base_deck.step, base_tray.step, bay_floor.step, bottle_envelope.step, curtain_clamp.step]
2026-10-13 Review phase 2: revalidated the risky numbers
    Hall field over the full axial play (2.1x worst-case margin), nozzle trajectory
    at every speed (inside the rim with 4 mm to spare), pour compensation (constant
    8.4 V to the motor over the pack's range), power budget, MOSFET and gate-drive
    margins, buck input range, off-state drain, battery-sense impedance, and a
    clearance table from the assembled CAD. One new finding: the lock's return
    ramp (slope 0.26) is self-locking against dry PETG friction, so the guide now
    says to grease the ramp, plunger and bore, with a troubleshooting row; the CAD
    is unchanged and the question is logged for Kevin.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
2026-10-13 Review phase 3 (part 1): party failure modes in the guide
    Troubleshooting rows for a pump that won't stop, a ring that won't seat
    because the rotor did not return, plugs left unconnected after a refill, and
    a dark lantern; an "on the day" sequence (charge, fill, prime, one test pour)
    in the performing section; kinked service loop added to the no-flow row.
    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
2026-10-13 Review phase 3: buildability
    CAD (DESIGN_CONTRACT rev 9g, second batch): the rear sphere half exported as
    three bodies because its joining flange never fused with the shell; the ring
    now sits inside the rear half, flush with the split, and checks.py fails any
    printed part that is not one solid. The lock wall gets a window where the
    base plate's wire notch lands (the switch wires were pinched against solid
    wall). The drum's bottom band gets the same 45 deg cone as the top band (a
    square ledge 103 mm up when printed top band down); the rotor prints bottom
    down; the nozzle guide's open side is a usable slit; sensor post walls, tray
    finger wells and one LED row cleaned up.
    Guide: the first-time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
    [assembly.step, assembly.stl, base.step, base.stl, base_deck.step, base_tray.step, base_tray.stl, bay_floor.step]
2026-10-13 Review phase 4: simplification and cost proposals
    No pure wins found: a 3 ft tube is shorter than one run with its service
    loop and has a weaker food-contact claim; smaller check-valve packs cost the
    same. Nine proposals logged for Kevin (dropping the gate driver, a panel USB
    port, glued handle laps, one store fewer, and what not to cut), none applied.
    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
2026-10-13 Review phase 5: polish
    Historical banners on every research note, the low-battery blink on the
    state diagram, the fluid-path diagram regenerated from the current CAD, the
    README and cad/README updated, CONTEXT's loose ends marked as fixed.
    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
    [gen_state.py]
2026-10-13 Record Kevin's answers to the two review questions
    Keep the DRV5032 fallback text, marked not recommended in the guide; accept
    the lock's spring return as it is (greased, hand-returned). Both noted in
    CONTEXT.md and PROGRESS.md.
    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
2026-10-14 Shopping list as an editable spreadsheet
    docs/SHOPPING_LIST.xlsx (Excel or Google Sheets import): one row per item
    with store, qty, link, unit price and a line-total formula, a Bought? Yes/No
    dropdown that greys the row out, and totals by store, still-to-buy and
    spent-so-far that recalculate. A second tab has the store addresses and
    hours. Generated by docs/make_shopping_xlsx.py; linked from the list and
    the README.
    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
    [SHOPPING_LIST.xlsx]
2026-10-14 Move the shopping list to the shared Google Sheet
    The list is now maintained in a Google Sheet shared with the collaborators,
    so the markdown, PDF and .xlsx copies and their generator scripts are
    removed to keep them from drifting. README, the build guide (section 2),
    CONTEXT.md and the review prompt link the sheet instead.
    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
    [SHOPPING_LIST.xlsx]
2026-10-14 README: show the printed parts; per-part renders in docs/images/stl
    render_stl.py now skips the assembly and the *_envelope check volumes by
    default (--all keeps them) and writes a parts-iso.png contact sheet. The 25
    printed parts are rendered from three angles into docs/images/stl/, and the
    README shows the contact sheet. Both READMEs point the command there.
    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
2026-10-14 Session handoff: CLAUDE.md, CONTEXT change log, refreshed transcript
    CLAUDE.md at the repo root makes every Claude Code session on this repo read
    docs/review/CONTEXT.md first and follow the team's working rules, including
    keeping CONTEXT.md current in any PR that changes a decision. CONTEXT.md now
    names the team and the renamed repo and has a dated change log covering the
    review, the two answered questions, the move to the Google Sheet, the part
    renders and the paint-versus-filament decision. transcript.md now runs to
    2026-10-14.
    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
2026-10-14 Hide the power port: switch under the cartridge floor, jack on the deck
    Nothing shows on the shell any more (DESIGN_CONTRACT rev 9h). The drum's
    bottom-band notch and the tray's port panel are gone. The power switch sits
    in a 26 x 23 x 20 mm pocket standing on the tray floor, open at the bottom,
    bushing and lever pointing down: tip the lantern to flip it. The charge jack
    goes through the deck at its +Y edge, socket up, reached with the lantern
    lifted off; the deck's +Y wire slot is now an open notch for the pack and
    switch leads. Probed in the assembly: cavity, hole, switch body, jack body,
    plug room and the boss sweep all clear; the band is solid where the notch
    was. The lantern stands on b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
    [assembly.step, assembly.stl, base.step, base.stl, base_deck.step, base_deck.stl, base_tray.step, base_tray.stl]
2026-10-14 Refresh the handoff: change log and transcript to the hidden-port work
    CONTEXT.md change log adds the two decisions since the last refresh: keep two
    green spools, and use blocks rather than printed feet when the lantern
    stands beside the cartridge. transcript.md now covers the hidden power port,
    the filament and blocks questions.
    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
2026-10-14 Draft circuit corrections and post-acceptance shopping changes
    Document the TalentCell supply, dedicated gate driver, sensor interfaces and USB service isolation. Regenerate the circuit diagram; defer CAD and live spreadsheet edits.
    Assisted-by: Codex
    [gen_wiring.py, green_lantern.ino]
2026-10-14 Restore a single connected circuit diagram
    Draw power, sensor and driver/load connections explicitly, distinguish crossings, and retain the reviewed electrical design.
    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
2026-10-14 Clarify circuit changes and simplify PR shopping notes
    Summarize the complete electronics revision, explain each circuit change and its purpose, and keep spreadsheet notes brief.
    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
2026-10-14 Explain circuit rationale and remove PR description clutter
    Distinguish wiring corrections from new bypass capacitors, clarify gate and switch changes, and state that spreadsheet edits include current prices and totals.
    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
2026-10-14 Tabulate circuit changes and select remaining purchase listings
    Remove the dense schematic footer and specify Amazon offers for the TC4427CPA driver and 1 uF X7R capacitor, including observed prices and delivery dates.
    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
2026-10-14 Use earlier and cheaper single-channel gate drivers
    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
2026-10-14 Explain the practical reasons for circuit changes
    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
2026-10-14 Clarify optional driver upgrade and sensor explanation
    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
2026-10-14 Remove unjustified gate-driver replacement from circuit revision
    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
    [gen_wiring.py, green_lantern.ino]
2026-10-14 Add complete prototype-board assembly drawings and viewer
2026-10-14 Trim circuit PR to maintained build and assembly deliverables
2026-10-14 Fit the revised battery and electronics in the cartridge
    [assembly.step, assembly.stl, base_deck.step, base_deck.stl, base_tray.step, base_tray.stl, battery_connector_envelope.step, battery_connector_envelope.stl]
2026-10-14 Correct populated board spacing and reserve realistic rear wiring room
    [assembly.step, assembly.stl, base_deck.step, base_deck.stl, board_cable_exit_envelope.step, board_cable_exit_envelope.stl, board_components_envelope.step, board_components_envelope.stl]
2026-10-14 Size all threaded receivers for brass heat-set inserts
    [assembly.step, assembly.stl, base_deck.step, base_deck.stl, base_tray.step, base_tray.stl, bay_floor.step, bay_floor.stl]
2026-10-14 Record the insert mounting decision and assembly requirements
2026-10-14 Include assembly and service videos in the CAD review
2026-10-14 Show pump-to-nozzle tubing in the assembly video
2026-10-14 Make pump tubing installation explicit in Step 17
2026-10-15 Review Duncan's circuit and CAD revisions; refresh the guide, Sheet notes and handoff
    Re-ran every check on the merged electrical revision and CAD fit (build 0 problems,
    socket/electronics/insert tests, firmware 20/20, compile) and verified the new parts
    against their sources: the TalentCell manual (single input/output port, switch on to
    charge, 0.5 A charger), Omron's D2F datasheet (1 mA minimum load for the D2F-01) and
    the ruthex insert data (4.0 mm hole). Nothing in the circuit or CAD needed a change.
    Fixed: dish_lower.stl re-exported (the committed file had one coarse facet 0.7 mm inside
    the outer cone; source unchanged), with the assembly and the renders containing it; the
    guide's boar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
    [assembly.step, assembly.stl, dish_lower.step, dish_lower.stl]
2026-10-17 Add a 3D assembly viewer generated from the CAD
    docs/assembly-viewer/index.html shows every part in its built position, each in its own
    colour, with a 14-step assembly walkthrough that follows the build guide and an adjustable
    exploded view. Bought parts appear as their CAD size allowances. The page is one
    self-contained file (meshes inlined), so it opens through a static-file proxy from GitHub
    or from a downloaded copy. cad/export_viewer.py regenerates it from the CAD; colours,
    explode offsets and step text live in viewer.template.html. Linked from the README and
    the build guide; CLAUDE.md lists it with the other regenerated outputs.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
2026-10-19 Add a printed Lantern ring with the lock key and a hidden magnet
    key_ring is the ring and the lock's key in one print: the keyed 24 mm disc and tab, 3.5 mm
    deep so it reaches the rotor pocket floor while the 27 mm head rests on the rotor face; the
    Green Lantern emblem cut into its face; and a magnet pocket opened from inside the band that
    stops 0.6 mm short of the face, so the magnet never shows. Gluing the plain key cap onto
    Hedo3D's ring would have hidden its emblem and left the cap 0.5 mm off the pocket floor.
    The finger hole is RING_ID (20.5 mm); the ring is worn on the left middle finger. Magnet to
    sensor is 3.6 mm nominal, ~55 mT at the worst rotor position against a 35 mT maximum ope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
    [assembly.step, assembly.stl, key_ring.step, key_ring.stl]
2026-10-19 Make the ring's raised emblem the lock key; drop the tab
    The ring's Green Lantern emblem now stands 4 mm proud (circle and bars; the centre disc
    0.6 mm lower, as on the real emblem) and is the key: the rotor pocket is the emblem's
    negative, so the bars turn the rotor (about 1.5 degrees of play; it fits either way up).
    No tab, so nothing sticks out of the ring. The magnet stays hidden behind the centre
    disc, 3.7 mm from the sensor (~53 mT worst case against 35 mT). key_cap, the fallback for
    a bought ring, carries the same emblem key. The rotor must be printed from this version.
    Build 0 problems; socket, insert and electronics tests pass; ring vs rotor 0 mm3 seated,
    interference when turned 3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
    [assembly.step, assembly.stl, key_cap.step, key_cap.stl, key_ring.step, key_ring.stl, rotor.step, rotor.stl]
2026-10-19 Add a printable ring sizer for choosing RING_ID
    cad/ring_sizer.py writes output/ring_sizer.stl: ten test bands, 18.5 to 23.0 mm inside in
    0.5 mm steps, each with its size engraved on a tab (one print, ~12 g, no supports). The
    guide's print-first list now starts the ring with it: RING_ID = the band that slides over
    the knuckle + 0.5 mm, because key_ring's band is much wider along the finger.
    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
    [ring_sizer.stl]
2026-10-19 Print the ring's emblem with a white outline
    Kevin chose a white outline: key_ring prints emblem down, and its first
    0.6 mm (EM_STEP) are only the faces of the circle and bars, so a filament
    change before layer 4 gives white faces and a green centre over the magnet,
    with no geometry change. Guide section 3 has the slicer steps and a test,
    section 6 and the 3D viewer mention it, and render_ring_colour.py draws
    docs/images/ring-white-outline.png.
    Step 2 of the assembly video still showed the old tabbed key cap; that
    slide now shows key_ring with the outline and the new magnet step, with
    the same timing and chapters.
    Claude-Session: http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
2026-10-19 Use the Vetco 321B charge jack: 11.3 mm deck hole
    Vetco is out of the 2112 (8 mm hole), and the CD021 Kevin found is an
    inline jack with no thread or nut, so it can't sit in the deck. The 321B
    is the same DC5521 female panel jack, in stock at $2.99, but it takes a
    7/16" (11.1 mm) hole and is 12.4 mm wide. PORT_JACK_D is now 11.3 mm and
    the jack envelope is 13 x 13 mm below the deck with a 17 mm nut allowance
    above. The deck stays solid round the hole; build.py reports 0 problems.
    Guide (parts table, cartridge step), design contract, cad/README, CONTEXT
    and the 3D viewer step updated; base_deck previews and the viewer
    regenerated.
    Clau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
    [assembly.step, assembly.stl, base_deck.step, base_deck.stl, charge_jack_envelope.step, charge_jack_envelope.stl]
2026-10-20 Skip the charge jack for now: charge at the battery's own port
    Vetco's shelf had no 2.1 mm panel jack, and the 2.5 mm one won't take
    the charger's 2.1 mm plug. The TalentCell's single DC5521 port is both
    input and output, so to charge you unplug the battery lead at the pack
    and plug the charger in, pack switch ON. The port and switch sit at the
    pack's -Y end, reachable with the lantern lifted off (only the drum is in
    the way).
    The CAD is unchanged: the deck keeps its 11.3 mm hole and the jack
    envelope, so a jack can go back in later. The guide (wiring, cartridge
    step, charging, checklist, parts table, total) and the 3D viewer step are
    updated; the board docs drop J1 (layout labels, notes, s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
    [generate.py, layout.py]
2026-10-21 Charge from underneath: splitter socket in a floor slot, battery LEDs down
    Kevin's rules: nothing on the sides of the lantern, everything from the
    bottom, the charge socket horizontal, prop the lantern up a little to
    charge. The supplied splitter is 1 female to 2 male, all ends joined, so
    its female end is a ready-made charge socket that charges the pack while
    it powers the lantern; no jack and no plug swapping.
    - The pack lies LED face down over a 30 x 6 mm floor slot (its five
    fuel-gauge dots, 12.7 mm in from the end, Kevin's measurement).
    - The splitter's female end lies in a floor cradle along the
    display-side rim, tied through two slot pairs; the charger plug slides
    in horizontal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
    [assembly.step, assembly.stl, base_tray.step, base_tray.stl, battery_connector_envelope.step, battery_connector_envelope.stl, charge_socket_envelope.step, charge_socket_envelope.stl]
2026-10-21 Drop the exposed charge slot; keep the battery LED slot, add a seat drawing
    Kevin didn't like the underside charge slot. The battery still lies LED
    face down over the 30 x 6 mm floor slot, but the charge slot, the socket
    cradle and the right-angle plug are gone: the splitter's straight male
    plug stays in the battery, one male lead is cut for the board, and the
    female end is the charge socket, tucked inside beside the battery's end.
    Charge with the lantern lifted off; nothing needs unplugging.
    docs/images/battery-seat.png (from docs/images/src/gen_battery_seat.py,
    numbers from params.py) dimensions the battery seat and the LED slot,
    on the tray and on the battery in hand, so Kevin can check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
    [assembly.step, assembly.stl, base_tray.step, base_tray.stl, battery_connector_envelope.step, battery_connector_envelope.stl, charge_socket_envelope.step, charge_socket_envelope.stl]
2026-10-21 LED slot to Kevin's numbers; battery 7 mm toward the hand opening
    Kevin checked the battery: the LED slot now runs 14 to 40 mm from the
    port-side edge and 12 to 17 mm in from the end (26 x 5 mm;
    PACK_LED_FROM_PORT / PACK_LED_FROM_END). With its cord folded in a
    U-turn the battery plug reaches 35 mm from the battery's end; centred,
    the drum wall is only 35.2 mm away at the port. At his request the
    battery moves 7 mm toward +Y (PACK_Y; its +Y end stop merges into the S1
    pocket), leaving ~6 mm. The plug envelope now models the U-turn.
    battery-seat drawing updated to match. build.py 0 problems; socket,
    electronics and insert tests pass.
    C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
    [assembly.step, assembly.stl, base_tray.step, base_tray.stl, battery_connector_envelope.step, battery_connector_envelope.stl, powerbank_envelope.step, powerbank_envelope.stl]
2026-10-21 Regenerate the overview renders; tidy two stale charging lines
    render_views.py output was last refreshed before the ring, lock and
    battery changes; the cartridge, cutaway, exploded, assembly and parts
    renders now match the current CAD (battery 7 mm toward the hand opening,
    LED slot). The guide's battery row and video note now say the charge
    socket is the splitter's female end inside the cartridge.
    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
2026-10-21 Repo audit: reformat the build guide, fix stale charge-jack text
    Build guide: contents list, bulleted viewer/video notes, shopping items
    renumbered with strap roll, jar and glass rows and a store-by-store
    total (~$206, matching the Sheet), print settings and test prints as
    tables/lists, section 4's invalid "2a" step renumbered, power modes as
    a table, section 9 step 1 split into labelled sub-steps, section 12
    reordered.
    Elsewhere: params/electronics comments, cad/README, DESIGN_CONTRACT
    (LED slot 26 x 5, bed size, no service door), wiring diagram (charge
    socket = splitter female end), protoboard sheet and viewer steps no
    longer describe a fitted jack. Cartridge and cutaway renders drop the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
    [gen_wiring.py, generate.py]
2026-10-22 Print the bay floor flat: its insert boss becomes a glued-on part
    bay_floor had the drip lip on one face and the nozzle guide's insert
    boss on the other, so it printed boss-up with the floor on supports.
    The boss is now guide_boss, super-glued under the floor (aligned with a
    4 mm drill bit) before the insert is set through both. bay_floor prints
    floor down, lip up, no supports. Placed geometry is identical, so the
    lower dish relief and nozzle height are unchanged.
    Guide, viewer, README count, renders and CONTEXT updated.
    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
    [assembly.step, assembly.stl, bay_floor.step, bay_floor.stl, guide_boss.step, guide_boss.stl]
2026-10-23 Battery strap recess 2 mm: the pack lies on a 1 mm bed
    Kevin measured the One-Wrap at ~1 mm but wanted margin. The tray floor
    is 2 mm, so the recess can't simply deepen; a 1 mm bed under the pack
    (bridged to the strap slots) keeps 1 mm of floor over a 2 mm recess.
    Deck height, lantern height and every other part are unchanged; the
    deck now clears the pack by 16 mm instead of 17.
    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
    [assembly.step, assembly.stl, base_tray.step, base_tray.stl, battery_connector_envelope.step, battery_connector_envelope.stl, powerbank_envelope.step]
2026-10-23 Pump measured: mark it so, head reserve 64 mm tall
    Kevin measured the Kamoer: head 2.5 x 2.5 in, motor can 40 mm x ~50 mm,
    114 mm overall. All fits the existing cradles; PUMP_H 63 -> 64 because
    the head is 0.5 mm taller than reserved (~6 mm still clear of the drum
    and lower dish). "Measure the pump" removed from the guide, CAD notes
    and viewer; the guide's pump step says to slide the motor into its
    cradle.
    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
    [assembly.step, assembly.stl, base_deck.step, base_deck.stl, pump_envelope.step, pump_envelope.stl]
2026-10-23 Taller drum (147 mm) for Kevin's 8 oz jar
    Kevin's 8 oz Ball jelly jar is 73 mm across and 100-105 mm tall, about
    twice the 4 oz jar's pours. The jar can't get wider beside the pump, so
    BASE_H 115 -> 147 and BOTTLE_H 76 -> 108. Only `base` changes shape;
    everything above moves up 32 mm (lantern ~50 cm). All checks pass.
    Guide: jar and shot-glass rows (Kevin has both), base size/weight,
    lantern height, lock cable ~45 cm, nozzle ~15 cm above the pump, tube
    ~95 cm, where to put the vent valve on the lid. CONTEXT, CAD notes,
    viewer and renders updated.
    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
    [assembly.step, assembly.stl, base.step, base.stl, bottle_envelope.step, bottle_envelope.stl]
2026-10-23 Jar vent: a cut-down Masontops silicone lid replaces the check valve
    Kevin has a Masontops fermentation kit. One Pickle Pipe lid, trimmed to
    the jar's flat-lid size and turned valve-down under the jar's band, lets
    air in and seals when tipped (his tip test passed); the tube goes
    through a punched hole. It still vents under the drink, so the jar can
    be filled full. Guide section 7 step 1 rewritten; BOM item 6, total
    (~$201), cleaning, troubleshooting and the store list updated; CONTEXT
    decision and change log. Docs only, no CAD change.
    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
2026-10-23 Rev C CAD: classic proportions (work in progress, docs to follow)
    Build the agreed proposal C in the real CAD, for review before the docs
    and the PR:
    - 224 mm sphere with the same 136.8 mm flats; round lens and hand
    openings; inner pads for the bells, inserts for the ring pivots, collar
    rings at both flats. Everything inside keeps its height relative to the
    sphere centre, so the printed lock, wall, bay floor, glass well, nozzle
    guide and guide boss carry over.
    - bells.py: front lens bell (LED collar band, lens ledge) and rear hand
    bell (LED rim band, curtain clamped at the mouth); full-round lens.
    - foot.py: spigot, 45 deg flare, 25 mm neck, riser that holds the bay
    floor 36 mm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
    [assembly.step, assembly.stl, bag_envelope.step, bag_envelope.stl, base.step, base.stl, base_deck.step, base_deck.stl]
2026-10-23 Rev C: 140 mm hand opening, lid pins and an emblem glue-up guide
    - Hand opening 130 -> 140 mm across, for a hand holding a glass. The rear
    bell's screws move out to r 73.5 (M3x14 now), its throat band and LED
    band grow to match.
    - Two 1.75 mm filament pins line the emblem lid up on the halo ring, one
    way round only.
    - emblem_jig.py: a small printed guide that centres the emblem's middle
    disc while its glue sets (a tool, not part of build.py).
    build.py: 0 problems; test_socket, test_inserts, test_electronics pass.
    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
    [assembly.step, assembly.stl, bag_envelope.step, base.step, base_tray.step, battery_connector_envelope.step, bay_floor.step, bell_front.step]
2026-10-23 Rev C: twist-on bells with a locking screw
    The bells no longer screw on from inside the sphere. A collar with 3 lugs
    stands out round each opening; the bell slides over it, turns 30 deg
    clockwise (seen from outside, like a jar lid) past a click bump, and one
    M3 from below through its throat into an insert in the collar locks it.
    The lens, LED strips and curtain can now be reached without splitting the
    sphere; the 6 bell screws and the pads inside the sphere are gone.
    test_inserts checks the lock inserts and screws and the bayonet: locked
    it clears the sphere and can't pull off, turned back it pulls straight
    off, turned the wrong way the lugs block it.
    build.py: 0 problems; test_socket, tes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
    [assembly.step, assembly.stl, bag_envelope.step, base.step, base_tray.step, battery_connector_envelope.step, bay_floor.step, bell_front.step]
2026-10-23 Rev C: thumbscrews for the parts that come apart
    Kevin's knurled thumbscrews (PC-case 6-32, he has 23) now hold whatever
    is taken apart now and then; everything else stays on M3:
    - Top cap and base to the sphere: 3 thumbscrews each, toward the back and
    sides, threading into pilot holes in the plugs. Flat seats and head
    wells in the sphere, with solid bosses behind them.
    - Bells: the bayonet is gone. Each bell slides over a plain collar and two
    thumbscrews from below hold it (10 thumbscrews in all).
    - thumb_test.py: a small coupon to pick the pilot size (2.8 designed in).
    - Tests: pilot holes, thumbscrew heads clear of every part, bells slide
    straight off with the screws out.
    build.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
    [assembly.step, assembly.stl, bag_envelope.step, base.step, base_tray.step, battery_connector_envelope.step, bay_floor.step, bell_front.step]
2026-10-23 Rev C handle: stronger joints and steel pin axles
    - The loop is now 4 pieces, split at 45, 90 and 135 deg instead of 30,
    70, 110 and 150, away from the corners where the load is highest.
    Each lap is 40 mm long with 3 M3 and is glued with epoxy; print the
    pieces at 100% infill.
    - The printed shafts are replaced by steel 1/4 x 2 in dowel pins glued
    into the spoke ends and turning in the pivots. A tab on each spoke's
    hub rides in an arc groove in the pivot's face and stops the loop just
    past level either way (the cross screw and shaft groove are gone).
    - checks.py swings the loop against everything, the pivots included,
    and checks that the tabs stop it past level.
    build.py: 0 pro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
    [assembly.step, assembly.stl, bag_envelope.step, base.step, base_tray.step, battery_connector_envelope.step, bay_floor.step, bell_front.step]
2026-10-23 Rev C handle: printed axles by default
    HANDLE_AXLE = 'printed' (new default): a 12 mm shaft printed on each
    spoke's end turns in the pivot, so there are no pins to buy. 'pin' keeps
    the steel 1/4 x 2 in dowel pin option (stronger; only the two end pieces
    and the pivots change). The hub and its stop tab grow (r 12, tab at
    r 9.5) so the stop groove clears the bigger bore.
    build.py: 0 problems (the handle still stops just past level both ways);
    test_socket, test_inserts, test_electronics pass.
    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
    [assembly.step, assembly.stl, bag_envelope.step, base.step, base_tray.step, battery_connector_envelope.step, bay_floor.step, bell_front.step]
2026-10-23 Rev C: fit the screws already bought
    - Handle laps use M3x8 with the heads sunk 2 mm (9 of them, with the 9
    nuts): the 14 nuts bought cover these plus the lock's 5, now that the
    rev-9 thumbscrew nuts are gone.
    - Pivot screws are M3x12 in deeper counterbores (was M3x20, not bought).
    - The curtain clamp uses 3 of the M3x8 countersunk screws.
    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
    [assembly.step, assembly.stl, bag_envelope.step, base.step, base_tray.step, battery_connector_envelope.step, bay_floor.step, bell_front.step]
2026-10-23 Rev C cartridge: bigger bag bay with a draining floor
    - Pump 7 mm to the right, its head held by the U-saddle and one motor
    strap (no room for a head strap); the splash wall moves right against
    it. The bay grows from about 0.62 to 0.70 L.
    - The bay's floor falls 2 deg toward a shallow well at the back end by
    the splash wall, where the bag's spout and the tube's tip sit, so the
    last of the drink runs to the tube; 45 deg fillets along the walls and
    in the bay's corners.
    - A notch in the splash wall's top for the tube to the pump's inlet.
    - The pump diode allowance is shortened to stay inside the drum.
    build.py: 0 problems; test_inserts and test_electronics pass.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
    [assembly.step, assembly.stl, bag_envelope.step, bag_envelope.stl, base.step, base_tray.step, base_tray.stl, battery_connector_envelope.step]
2026-10-23 Rev C cartridge: tube clip at the drain well
    A C-clip on the bay floor between the well and the splash wall: press the
    tube's end, still inside the bag, down into it through the bag film, so
    its notched tip lies in the well. Sized for the 6.4 mm tube plus two
    layers of pouch film; open on top, edges rounded so it can't cut the bag.
    The well moves to (-32, 52) so the tube comes in from the spout and pump
    side.
    build.py: 0 problems.
    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
    [assembly.step, assembly.stl, bag_envelope.step, bag_envelope.stl, base.step, base_tray.step, base_tray.stl, battery_connector_envelope.step]
2026-10-23 Rev C cartridge: tube tip on the well's bottom, and a bag cover
    - The tube clip tilts 15 deg toward the well, so the tube's notched tip
    rests on the well's bottom (over one layer of bag film) instead of
    6-9 mm above it.
    - bag_cover: a lid over the bag bay, resting on the splash wall and on
    the rim, which now rises round the bag bay to meet it. A lip under it
    keeps it in place, a notch lets the drum's lug pass, a finger hole lifts
    it. The 32 oz pouch, spout and cap stay under it; the tube leaves
    through the notch in the splash wall below the cover.
    - The bag envelope now sits under the cover (about 0.65 L).
    build.py: 0 problems; test_inserts and test_electronics pass.
    Co-Authore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
    [assembly.step, assembly.stl, bag_cover.step, bag_cover.stl, bag_envelope.step, bag_envelope.stl, base.step, base_tray.step]
2026-10-23 Rev C: every screw inside the lantern
    Thumbscrews for the bells, top cap and foot now turn from inside (heads in
    the openings and necks) and bite outward into blind pilots, with thicker
    bell throats and longer plug pads. Cap floor on 3 thumbscrews so the top
    cap comes off tool-free. Pivot M3s come from inside the sphere into inserts
    in the pivots; curtain clamp screws from inside the bell; drum screws under
    green caps.
    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
    [assembly.step, assembly.stl, bag_cover.step, bag_envelope.step, base.step, base.stl, base_tray.step, battery_connector_envelope.step]
2026-10-23 Rev C: thicker drum band and handle, green caps over every outside screw
    The drum's top band is 2 mm thicker inward over the foot's spigot, so 3.3 mm
    of plastic sits under each screw head (1.3 before). The handle section goes
    from 10 to 13.5 mm thick so each lap screw's head and nut sinks under a flush
    cap. One 6.5 mm cap part covers all 21.
    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
    [assembly.step, assembly.stl, bag_cover.step, bag_envelope.step, base.step, base.stl, base_tray.step, battery_connector_envelope.step]
2026-10-23 Rev C: bell thumbscrews parallel to the hand, 6-32 inserts for every thumbscrew
    Bell thumbscrews run along each bell's axis from inside the sphere, heads
    behind the opening's top edge (front ones behind the lock wall), into 6-32
    brass inserts in the throat; a sunk flat pocket and matching boss start each
    insert square. The top-cap, foot and cap-floor thumbscrews also thread into
    6-32 inserts, so nothing wears. The flat thumbscrews move 8 mm in for insert
    backing. Pivot screw heads sink under green caps (25 caps now). thumb_test.py
    is now an insert-hole coupon (4.6/4.8/5.0).
    Claude-Session: https://claude.ai/code/session_01RA7Cpt4fWuKXD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
    [assembly.step, assembly.stl, bag_cover.step, bag_envelope.step, base.step, base_tray.step, battery_connector_envelope.step, bay_floor.step]
2026-10-23 Rev C: white LED panel, full rear LED ring, one-piece hand-side cover
    A plain white panel on the lock wall's four posts hides the spout, glass and
    wall back from the front window; the 4 LED rows move onto its front, about
    5 cm behind the frosted lens. The rear bell's LED ring goes all the way round.
    The hand-side cover is one frosted disc with 8 cuts from the centre, clamped
    flat all round by a full ring (6 countersunk M3 x 8 from inside). Adds a 1:1
    cutting template (docs/images/curtain_template.pdf).
    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
    [assembly.step, assembly.stl, bag_cover.step, bag_envelope.step, base.step, base_tray.step, battery_connector_envelope.step, bay_floor.step]
2026-10-23 Add a printed cutting stencil for the hand-side cover
    cad/curtain_stencil.py: a 1.6 mm plate the size of the cover, with knife slots
    along the 8 cuts, holes at their ends and the 6 clamp-screw holes.
    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
2026-10-23 Add the curtain stencil STL to the outputs, like the other tool prints
    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
    [curtain_stencil.stl]
2026-10-23 Curtain stencil: open frame instead of a solid plate (~45 g -> ~14 g)
    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
    [curtain_stencil.stl]
2026-10-23 Rev C docs: CONTEXT, READMEs, design contract, renders, diagrams, cap LED space
    - CONTEXT.md: the rev C decisions with dates and reasons, obsolete rev 9 items
    replaced, open questions, change log entry.
    - README, cad/README, DESIGN_CONTRACT (revision C), board guide: rev C layout;
    the old base/dishes/handle notes marked superseded.
    - render_views.py: rev C views (cap floor, cartridge, exploded by direction),
    tool prints skipped; all renders and part previews regenerated.
    - fluid-path diagram redrawn for rev C; wiring/interaction text updated.
    - CAD: space for the ~25 cm emblem LED strip in the top cap; the curtain clamp
    ring uses 4 of the 8 flat-head screws (the lock uses the other 4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
    [assembly.step, assembly.stl, bag_cover.step, bag_envelope.step, base.step, base_tray.step, battery_connector_envelope.step, bay_floor.step]
2026-10-23 Rev C build guide; filament and brightness corrections; open purchases noted
    The build guide is rewritten for rev C: what you need, hardware counts, print
    table, inserts, electronics on the cap floor, assembly steps 0-16 with how to
    reach each thumbscrew, the hand-side cover, the drink bag, refilling and service.
    CONTEXT: filament is ~2.8 kg if solid (slice to check), the strip maximum
    defaults to 255, and 4 more JST SM pairs plus epoxy await approval.
    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
2026-10-23 Rev C viewer and videos final: emblem LED strips in the viewer; PROGRESS entry
    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
2026-10-23 Keep the one 2-pin plug: solder the cap floor and bell LED leads with slack
    Kevin chose not to buy 4 more JST SM pairs for now. The pump keeps its plug at
    the cartridge; the LED and pump leads at the cap floor and both bells' LED leads
    are soldered with slack. Guide, CONTEXT, PROGRESS, CAD notes, viewer and the
    step-by-step and service videos updated (the video now also shows the emblem
    LED strips at step 9).
    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
2026-10-24 Add docs/FUTURE.md: one list of future and improvement ideas
    Collects the build guide's upgrade table and the deferred ideas scattered through
    CONTEXT and PROGRESS, plus Kevin's new ones (tube coupling, removable fill bin,
    tighter bag seal). Records his decisions: the spout stays as is; refill in place
    (added to the guide). CLAUDE.md, README and CONTEXT point to the new file.
    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
2026-10-24 Rewrite the build guide as a design proposal with six build tracks
    docs/BUILD_GUIDE.md now reads as an engineering proposal: executive
    summary, requirements with their verification steps, system design, a
    delivery plan with a dependency map and blocking table, then one
    procedure per track (Shopping, Electrical, Software, Fluids, Printing,
    Build) with tests built in and "Blocked by" lines between tracks.
    Operation, service, troubleshooting and a risks table follow. Current
    state only: no names, dates or decision history. Build steps keep the
    viewer and video's 0-16 numbering.
    New content: a power and margin check (EL-1), incoming-part checks
    (SH-3) including how to qualify a pen spring for t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
2026-10-24 Point the guide and CLAUDE.md at the Sheet's 3D printing tab
    The shared Sheet now has a "3D printing" tab that tracks every printed
    part. The build guide's header and PR-5 point to it, CLAUDE.md says to
    keep it in step with the part list, and CONTEXT.md logs it.
    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
2026-10-26 Export printed parts as finer STLs so round parts print round
    The first printed bell_front showed flat vertical facets. build.py
    exported every STL at 0.15 rad angular tolerance, about 55 segments
    round a 150 mm bell (8.5 mm flats, visible in glossy PETG). Printed
    parts now export at 0.02 mm / 0.05 rad (about 250 segments on the
    bells); the *_envelope check volumes keep the coarse mesh. All STLs
    and the part previews are regenerated; STL total goes from ~17 MB to
    ~36 MB.
    The guide's print settings now cover the seam (align it on the hidden
    side; for the bells, underneath, opposite the two insert holes).
    CONTEXT.md logs both.
    Claude-Se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
    [bag_cover.stl, base.stl, base_tray.stl, bay_floor.stl, bell_front.stl, bell_rear.stl, cap_floor.stl, curtain_clamp.stl]
2026-10-26 Guide: sanding steps for faceted prints; old and new STLs fit together
    Parts printed from the old coarse STLs still fit new ones, so the team
    is deferring reprints to the end. PR-6 now explains how to sand the
    facets out instead, and PR-3 notes the old prints are compatible.
    CONTEXT.md logs the decision and the parts marked Reprint in the Sheet.
    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
2026-10-27 Add a step-by-step prototype-board soldering guide
2026-10-27 Simplify board wiring within the printed enclosure
2026-10-27 Allow real wire bends and hand assembly with removable board spacers
2026-10-27 Rearrange board for insulated stranded wiring and accessible solder joints
2026-10-27 Fit the insulated board using existing M3 hardware
2026-10-27 Group board assembly into complete component and wire steps
2026-10-27 Illustrate board components and make crowded hole labels readable
2026-10-27 Show expected resistor bands with both tolerance variants
    [assembly_guide.py, test_assembly.py]
2026-10-27 Clarify socket and jumper instructions in board guide
2026-10-27 Explain wire ends and paired solder joints in assembly guide
2026-10-27 Start wire instructions with cutting and stripping
2026-10-27 Explain rear component attachment to existing solder joints
2026-10-27 Clarify wire preparation and separate fitting from soldering
2026-10-28 Keep wire instructions visible and separate diagram controls
2026-10-28 Clarify wire holes versus pin joints and shorten wire steps
    [assembly_guide.py, test_assembly.py]
2026-10-28 Simplify wire steps to one diagram and instruction list
2026-10-28 Guide wire fitting and soldering with automatic board views
2026-10-28 Make every wire action a numbered step with linear navigation
2026-10-28 Restore complete wire steps with one view of both board sides
2026-10-28 Restore consistent board view controls on wire steps
2026-10-28 Restore the complete wire connection sketch and simplify guide visuals
2026-10-28 Give outgoing wires fixed enclosure cuts and destination maps
    [assembly_guide.py, generate.py, offboard.py, routing.py, test_assembly.py]
2026-10-28 Add explicit assembly checks with probe points and expected readings
